SK-MH/A320-PCBs/README.md

# A320-PCBs

> [!IMPORTANT]
> This repository is still in progress.

Please wait for the documentation.
It could be found later on here.
