SK-MH/A320-PCBs/1 - OVERHEAD/readme.MD

## The overhead is separated into the following boards

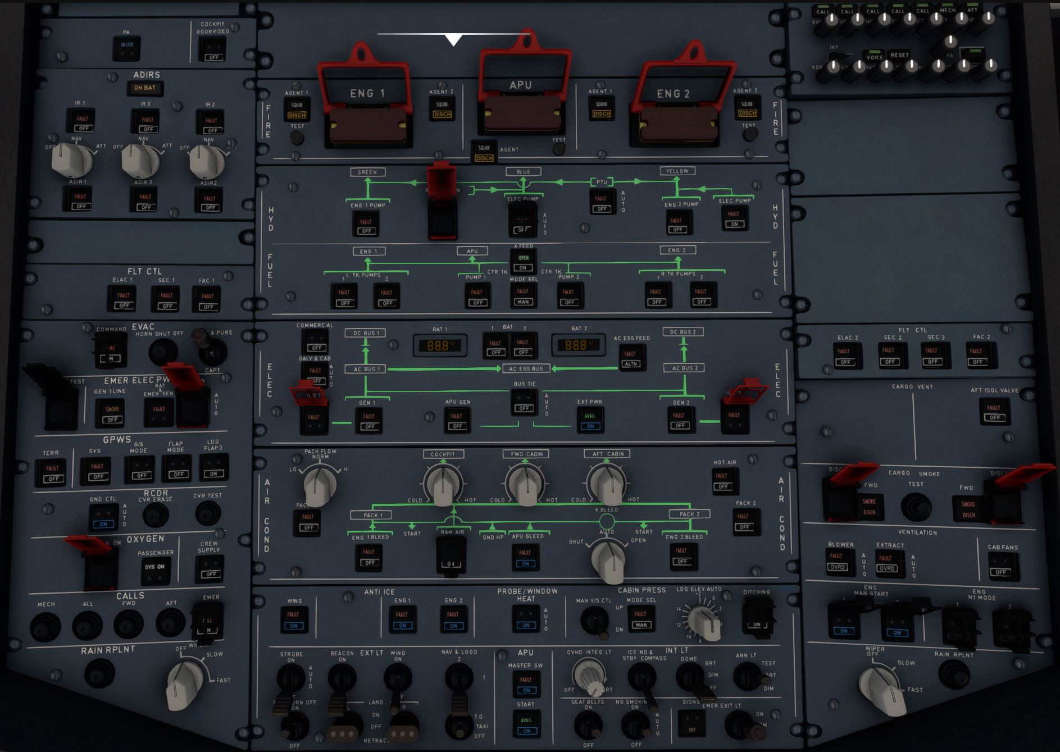
[picture p11: 1 - OVERHEAD/Lighting Overhead.JPG]
Overhead

- PA & COCKPIT DOOR VIDEO
- ADIRS
- FLTCTL Capt.
- EMER ELEC
    - EVAC
    - EMERGENCY ELECTRIC
    - VOICE RECORDER
    - CALLS
    - WIPER CAPT.
- FIRE
- HYD / FUEL
- ELEC
- AIR COND
- LIGHTS
    - ANTI ICE CNTRL
    - CABIN PRESSURE CTRL
    - EXTERNALL LIGHTS
    - APU
    - INTERNAL LIGHTING
    - SIGN
- (3rd AUDIO) optional
- FLTCTRL F.O.
- CARGO HEAT
    - CARGO VENTILATION
    - CARGO SMOKE
    - VENTILATION
    - ENGINE MANUAL START
    - WIPER F.O.
