SK-MH/A320-PCBs/9 - MISCELLANEOUS/Photos/readme.MD

> [!NOTE]
> The Overhead photo is not showing the actual boards.

On the upper left corner there will be the board for PA-CDV and not a TCAS.
On the right side, 3rd. from the top there will be a panel without holes.

On the Glareshield photo the FCU is missing
