SK-MH/A320-PCBs/1 - OVERHEAD/1.1 PACDV/MobiFlight/readme.MD

[!IMPORTANT]
This board is supported by the ADIRS board.
