SK-MH/A320-PCBs/1 - OVERHEAD/1.11 FLTCTL_FO/MobiFlight/readme.MD

[!NOTE]
This board is supported by the CARGO HEAT board.
