SK-MH/A320-PCBs/1 - OVERHEAD/1.3 FLTCTL/MobiFlight/readme.MD

[!NOTE]
This board is supported by the EMER ELEC board.
