SK-MH/A320-PCBs/0 - Prerequisites/Photos/Board and Panels.JPG

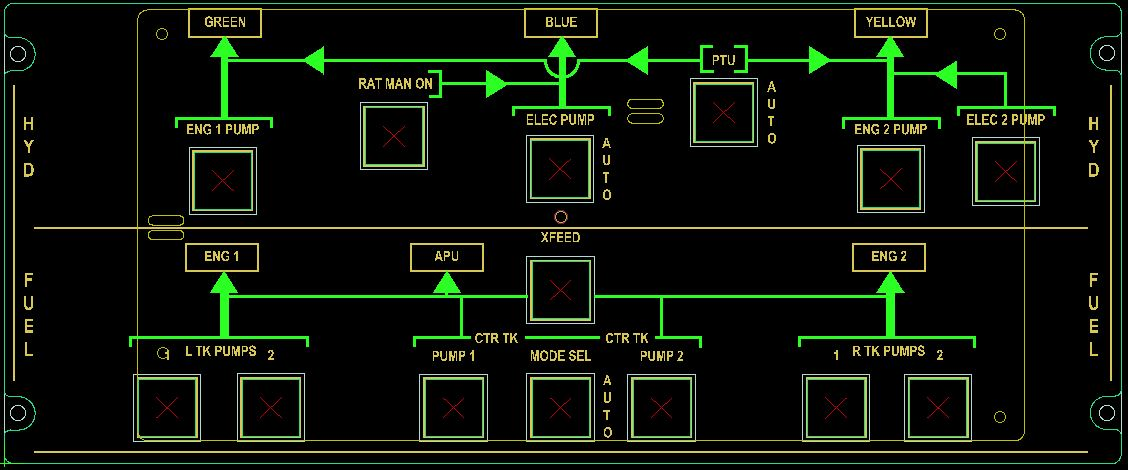
0 - Prerequisites/Photos/Board and Panels.JPG
