SK-MH/A320-PCBs/0 - Prerequisites/Photos/Engravement Green.JPG

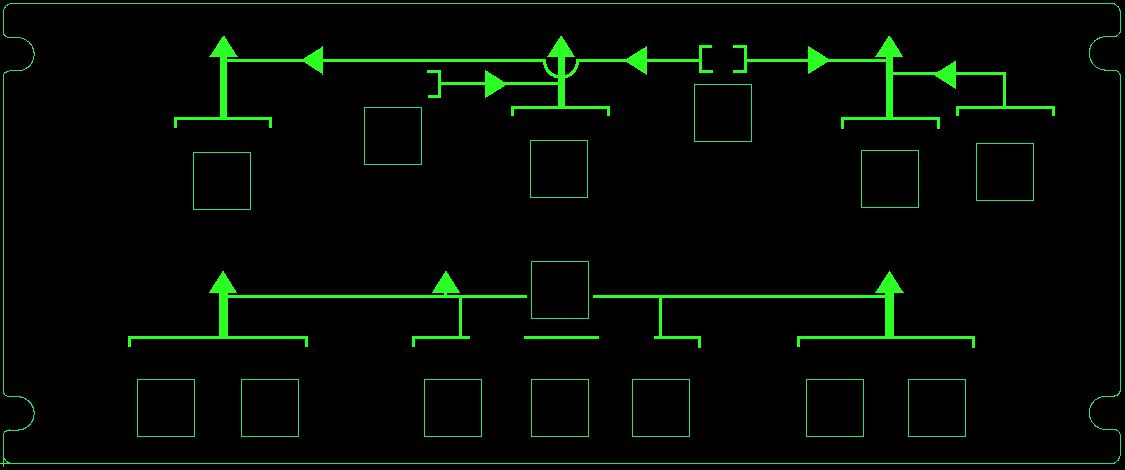
0 - Prerequisites/Photos/Engravement Green.JPG
