SK-MH/A320-PCBs/0 - Prerequisites/Photos/Engravement.JPG

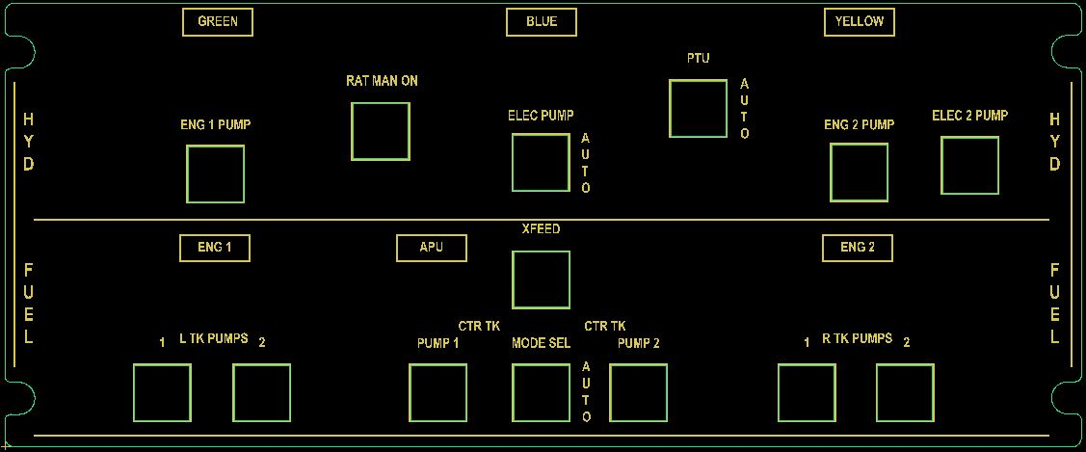
0 - Prerequisites/Photos/Engravement.JPG
