SK-MH/A320-PCBs/0 - Prerequisites/Photos/Front Marker.JPG

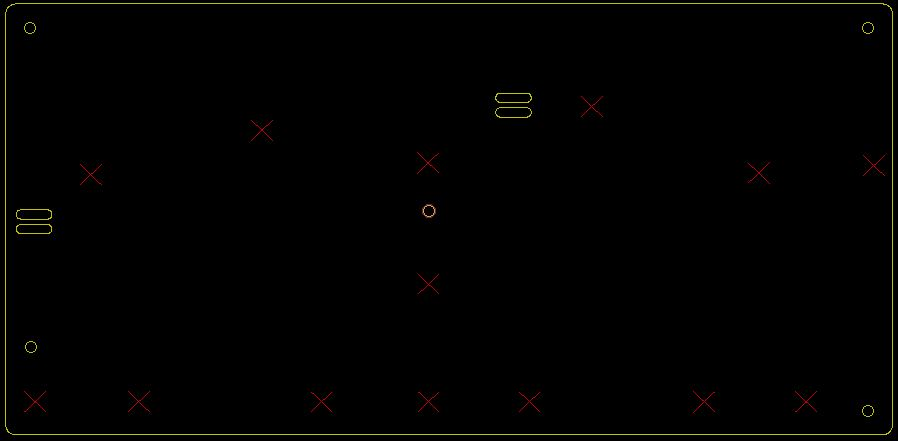
0 - Prerequisites/Photos/Front Marker.JPG
