SK-MH/A320-PCBs/0 - Prerequisites/Photos/Front Panel.JPG

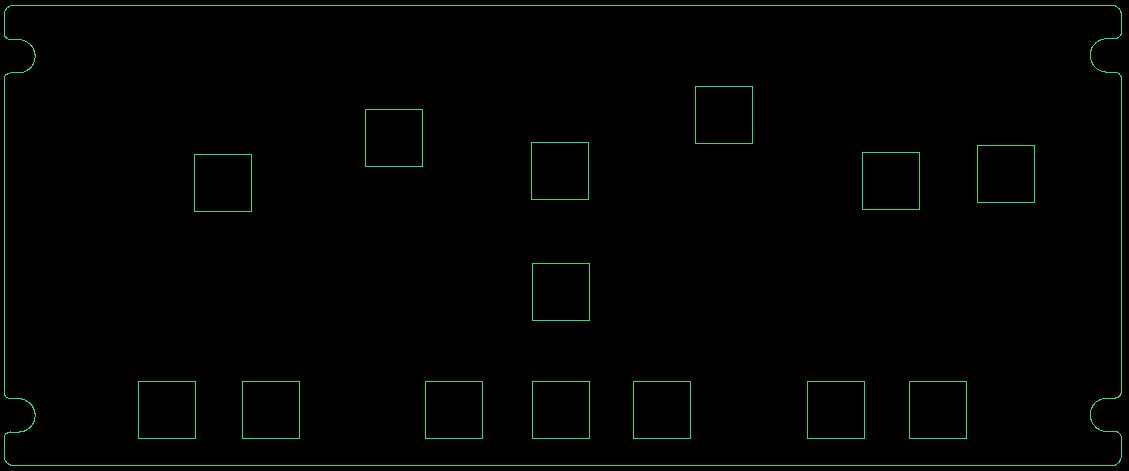
0 - Prerequisites/Photos/Front Panel.JPG
