SK-MH/A320-PCBs/0 - Prerequisites/Photos/Mid Panel.JPG

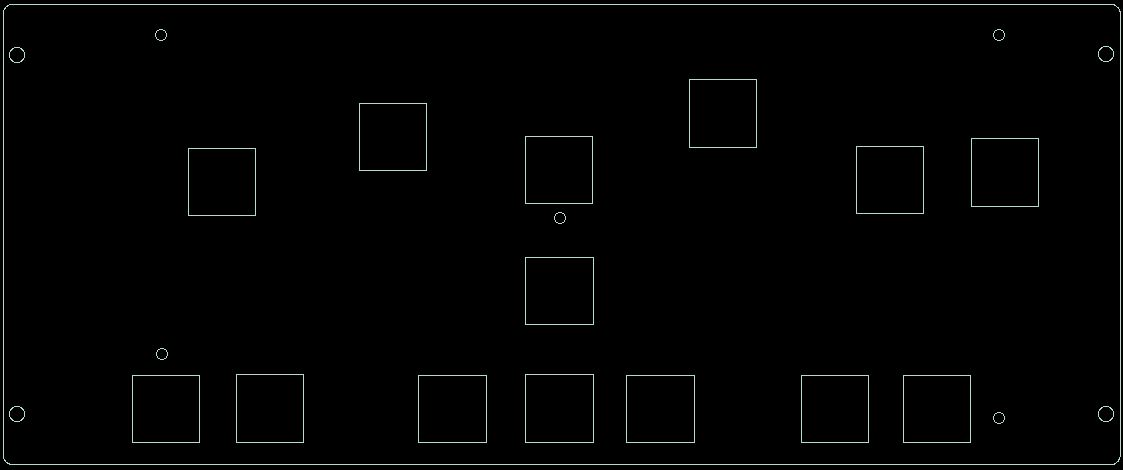
0 - Prerequisites/Photos/Mid Panel.JPG
