SK-MH/A320-PCBs/1 - OVERHEAD/1.2 ADIRS/Photos/Annunciator.JPG

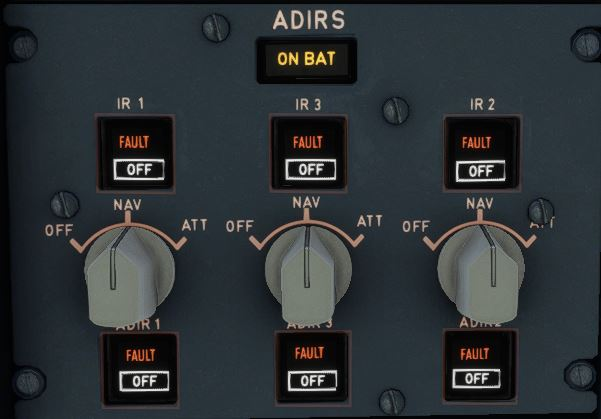
1 - OVERHEAD/1.2 ADIRS/Photos/Annunciator.JPG
