SK-MH/A320-PCBs/1 - OVERHEAD/1.3 FLTCTL/Photos/Annunciator.JPG

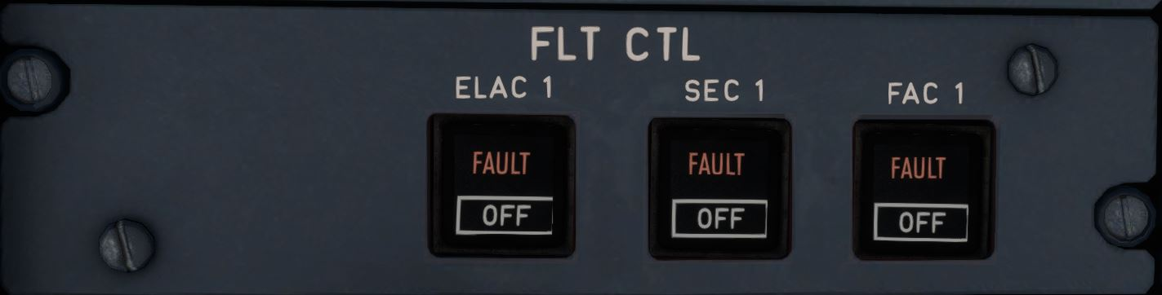
1 - OVERHEAD/1.3 FLTCTL/Photos/Annunciator.JPG
