SK-MH/A320-PCBs/1 - OVERHEAD/1.3 FLTCTL/Photos/Lighted Annunciator.jpg

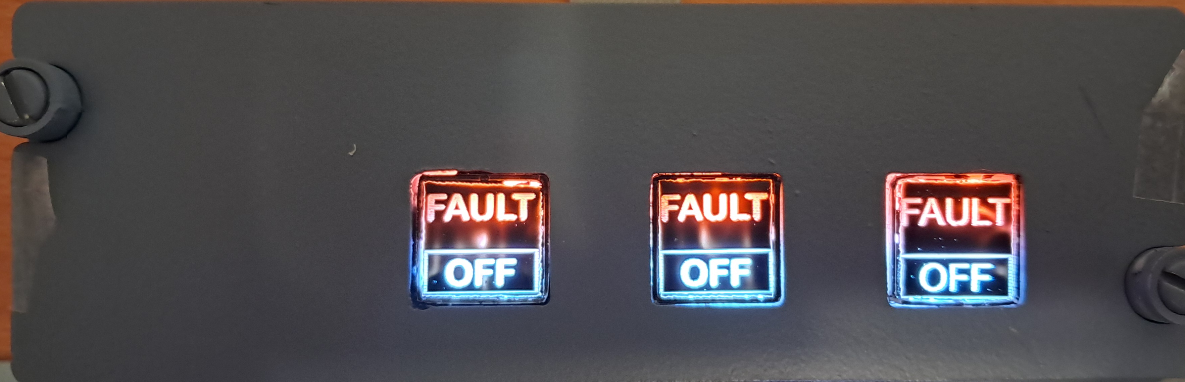
1 - OVERHEAD/1.3 FLTCTL/Photos/Lighted Annunciator.jpg
