SK-MH/A320-PCBs/1 - OVERHEAD/1.3 FLTCTL/Photos/Lights on.jpg

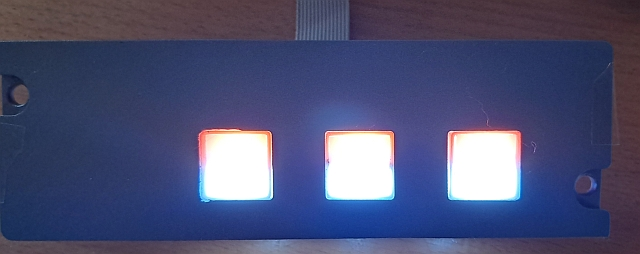
1 - OVERHEAD/1.3 FLTCTL/Photos/Lights on.jpg
