SK-MH/A320-PCBs/1 - OVERHEAD/1.4 EMER ELEC/Photos/Annunciator.JPG

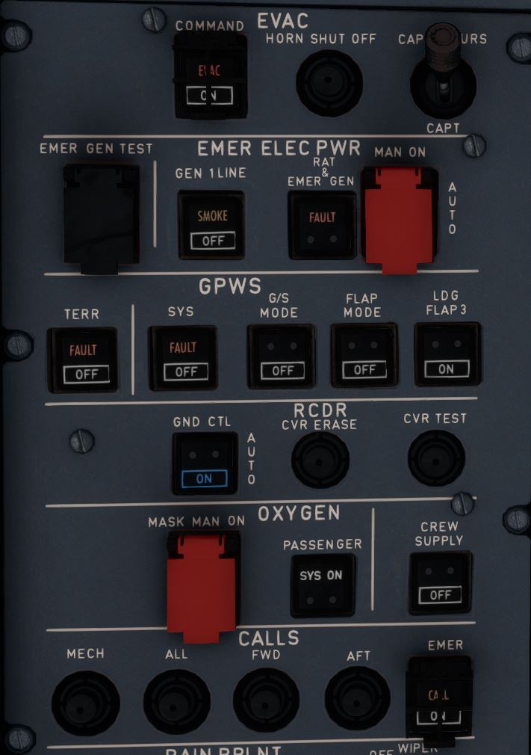
1 - OVERHEAD/1.4 EMER ELEC/Photos/Annunciator.JPG
