SK-MH/A320-PCBs/1 - OVERHEAD/1.5 FIRE/Photos/Annunciator.JPG

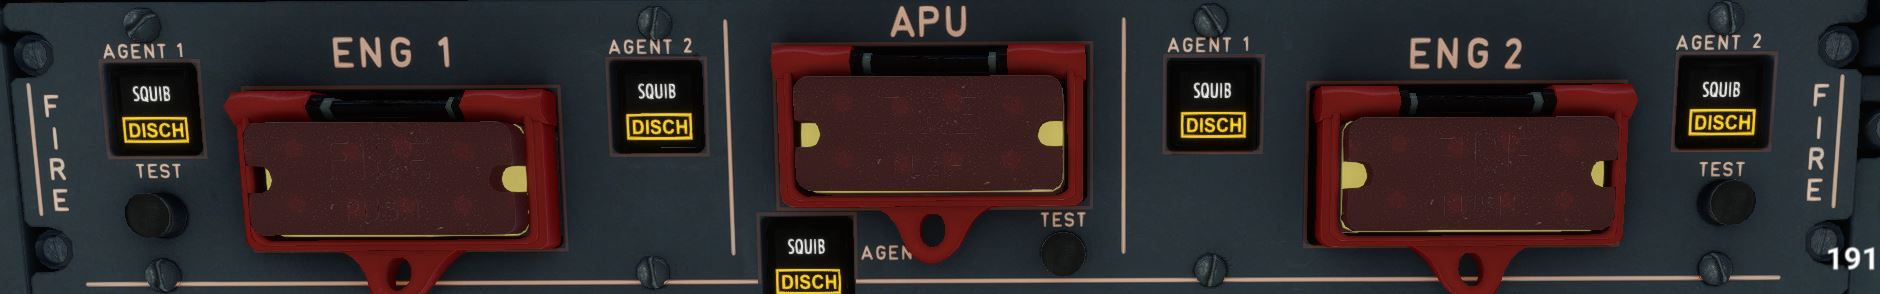
1 - OVERHEAD/1.5 FIRE/Photos/Annunciator.JPG
