SK-MH/A320-PCBs/1 - OVERHEAD/1.6 HYDFUEL/Photos/Annunciator.JPG

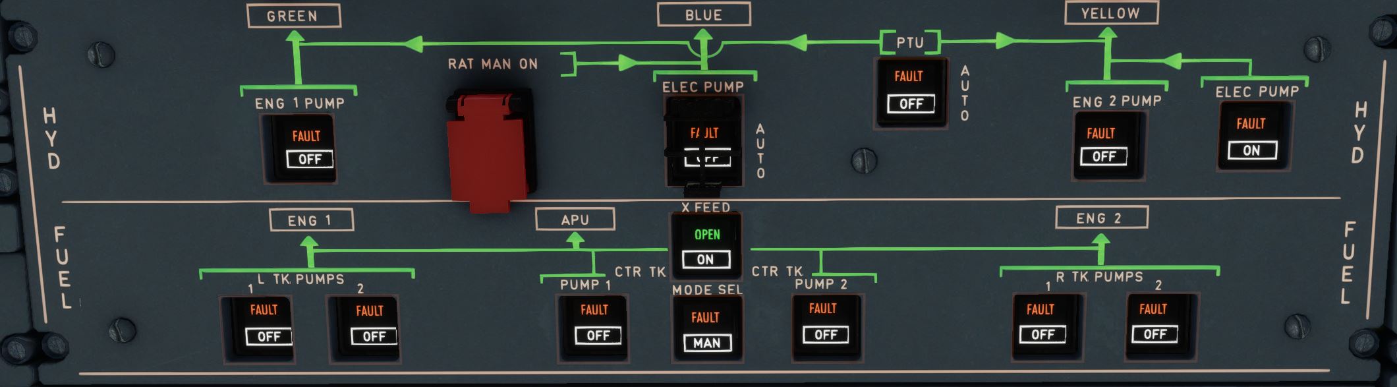
1 - OVERHEAD/1.6 HYDFUEL/Photos/Annunciator.JPG
