SK-MH/A320-PCBs/1 - OVERHEAD/1.7 ELEC/Photos/Annunciator.JPG

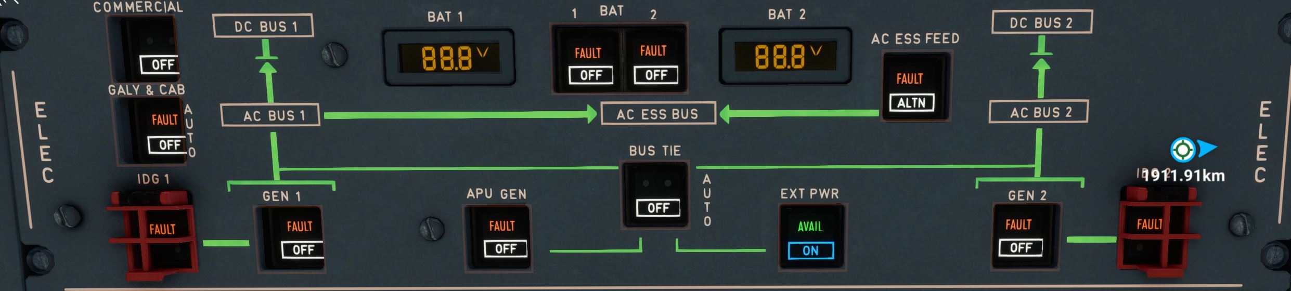
1 - OVERHEAD/1.7 ELEC/Photos/Annunciator.JPG
