SK-MH/A320-PCBs/1 - OVERHEAD/1.8 AIRCOND/Photos/Annunciator.JPG

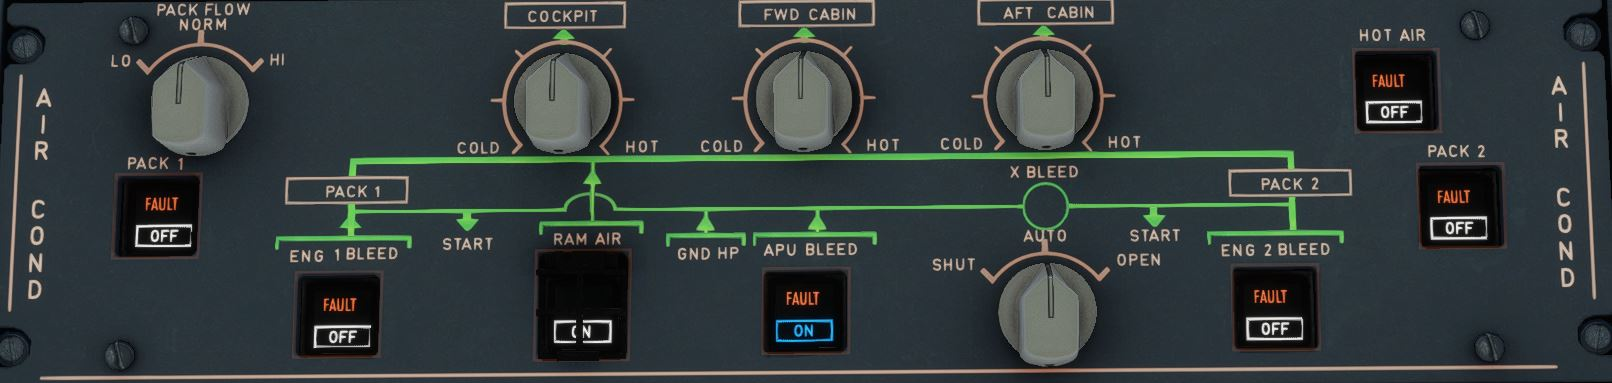
1 - OVERHEAD/1.8 AIRCOND/Photos/Annunciator.JPG
