SK-MH/A320-PCBs/1 - OVERHEAD/1.9 LIGHTS/Photos/Annunciator.JPG

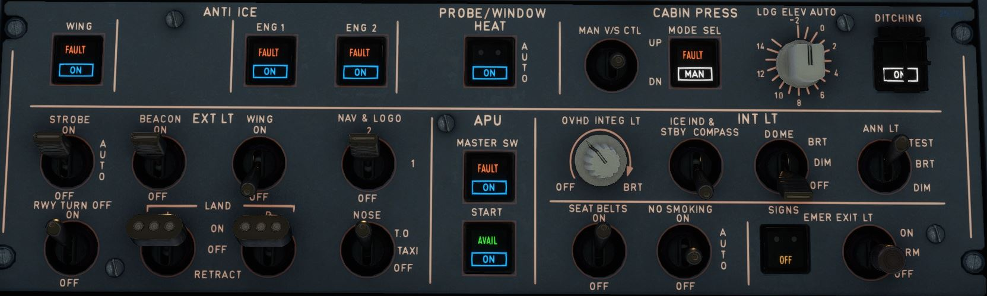
1 - OVERHEAD/1.9 LIGHTS/Photos/Annunciator.JPG
