SK-MH/A320-PCBs/1 - OVERHEAD/1.12 CARGO HEAT/Photos/Annunciator.JPG

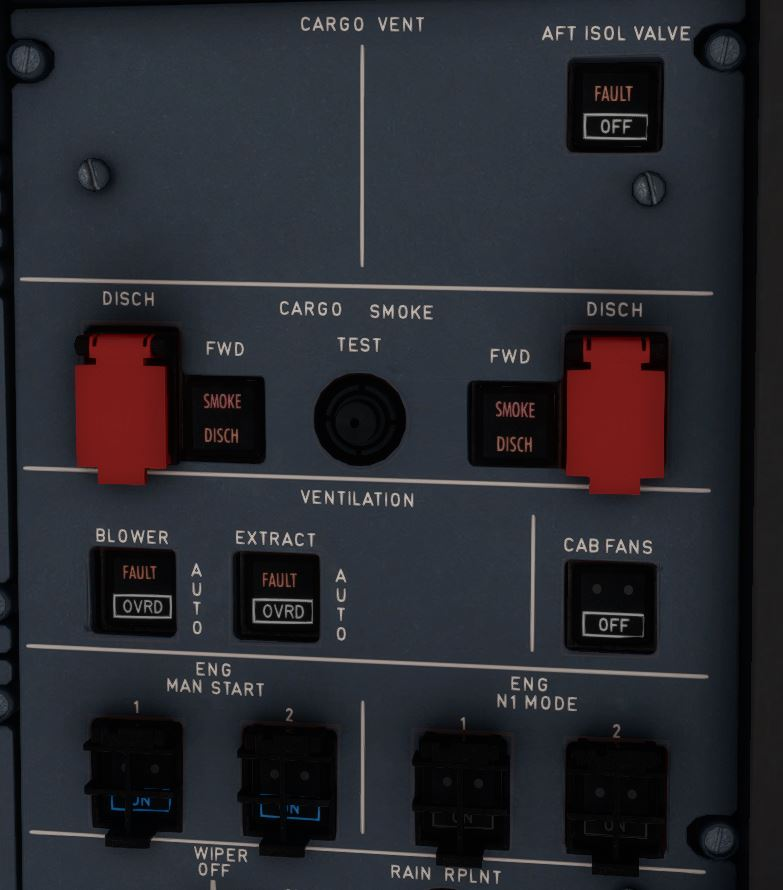
1 - OVERHEAD/1.12 CARGO HEAT/Photos/Annunciator.JPG
