SK-MH/A320-PCBs/2 - GLARE SHIELD/2.1 WARNING Left/Photos/Annunciator.JPG

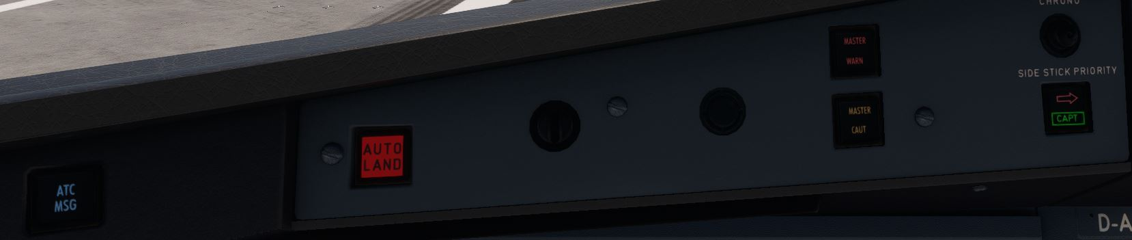
2 - GLARE SHIELD/2.1 WARNING Left/Photos/Annunciator.JPG
