SK-MH/A320-PCBs/3 - MAIN INSTRUMENTS/3.1 ILLU Left/Photos/Annunciators.JPG

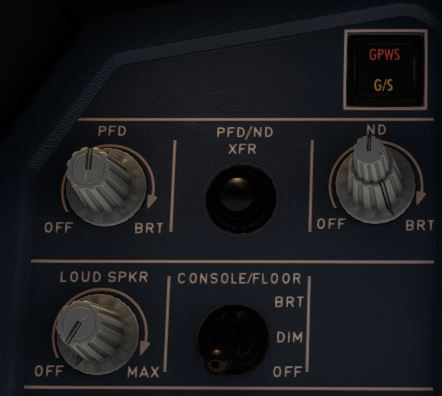
3 - MAIN INSTRUMENTS/3.1 ILLU Left/Photos/Annunciators.JPG
