SK-MH/A320-PCBs/3 - MAIN INSTRUMENTS/3.2 AUTOBRAKE & GEAR/Photos/Annunciators.JPG

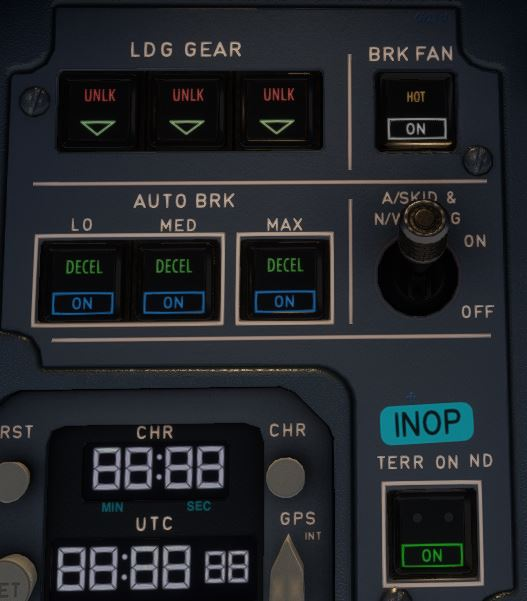
3 - MAIN INSTRUMENTS/3.2 AUTOBRAKE & GEAR/Photos/Annunciators.JPG
