SK-MH/A320-PCBs/3 - MAIN INSTRUMENTS/3.3 CHRONO/Photos/Chrono.jpg

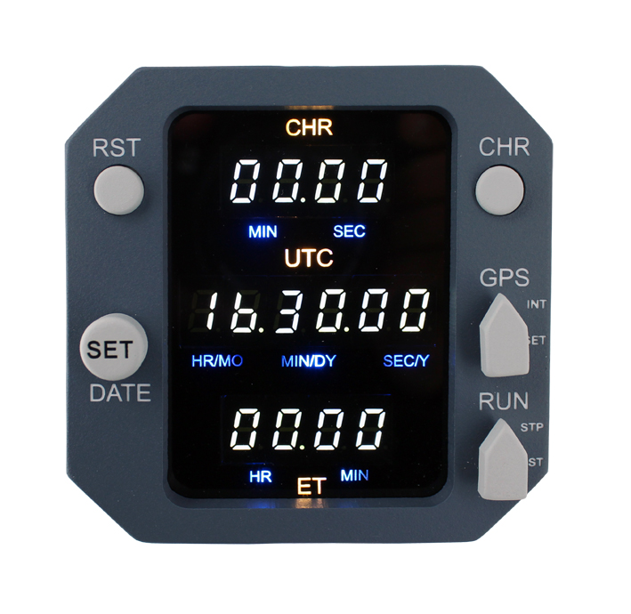
3 - MAIN INSTRUMENTS/3.3 CHRONO/Photos/Chrono.jpg
