SK-MH/A320-PCBs/4 - PEDESTAL/4.2 RMP Left (Capt.)/Photos/A320_radiopanel2.jpg

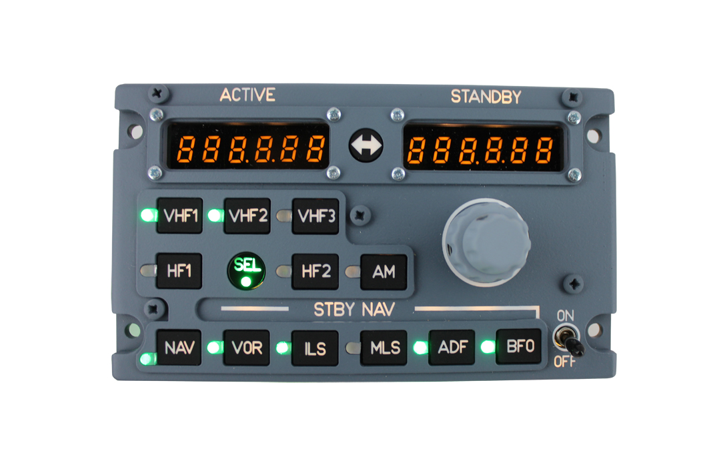
4 - PEDESTAL/4.2 RMP Left (Capt.)/Photos/A320_radiopanel2.jpg
