SK-MH/A320-PCBs/4 - PEDESTAL/4.2 RMP Left (Capt.)/Photos/Annunciator.JPG

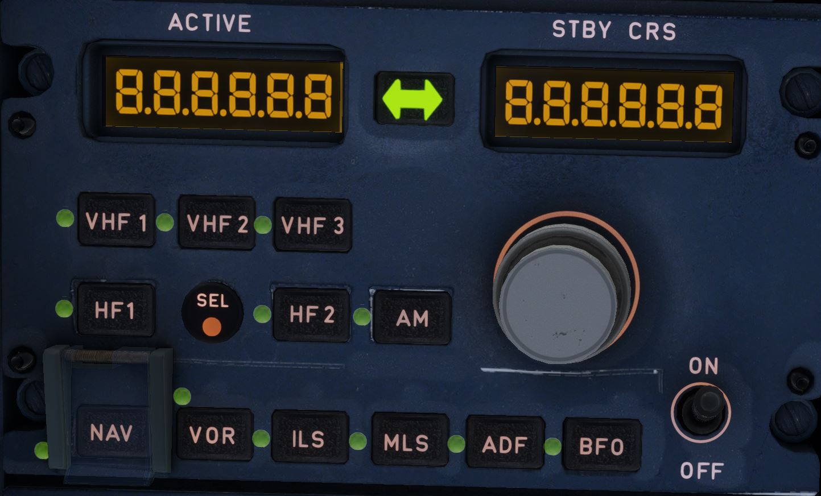
4 - PEDESTAL/4.2 RMP Left (Capt.)/Photos/Annunciator.JPG
