SK-MH/A320-PCBs/4 - PEDESTAL/4.2 RMP Left (Capt.)/Photos/FBW Radio Panel.JPG

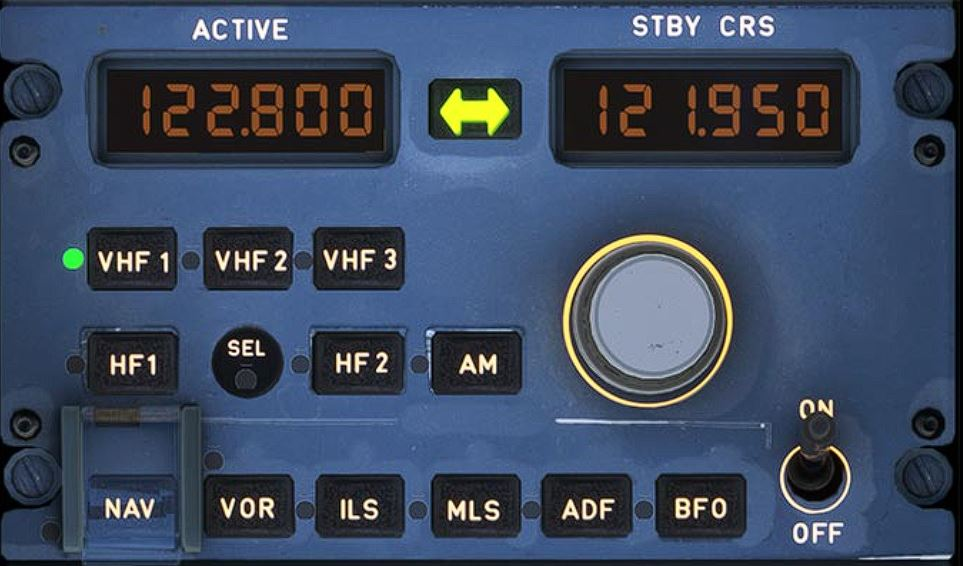
4 - PEDESTAL/4.2 RMP Left (Capt.)/Photos/FBW Radio Panel.JPG
