SK-MH/A320-PCBs/4 - PEDESTAL/4.5 RADAR/Photos/Radar.jpg

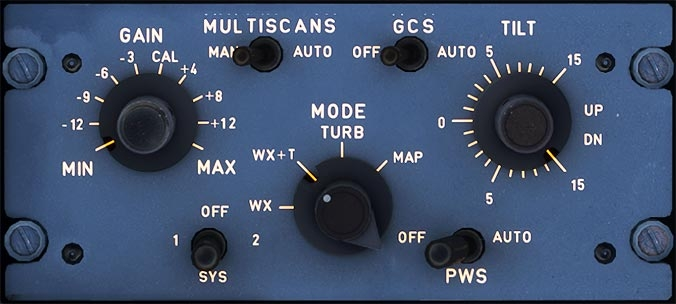
4 - PEDESTAL/4.5 RADAR/Photos/Radar.jpg
