SK-MH/A320-PCBs/9 - MISCELLANEOUS/Photos/Glare shield (without FCU).jpg

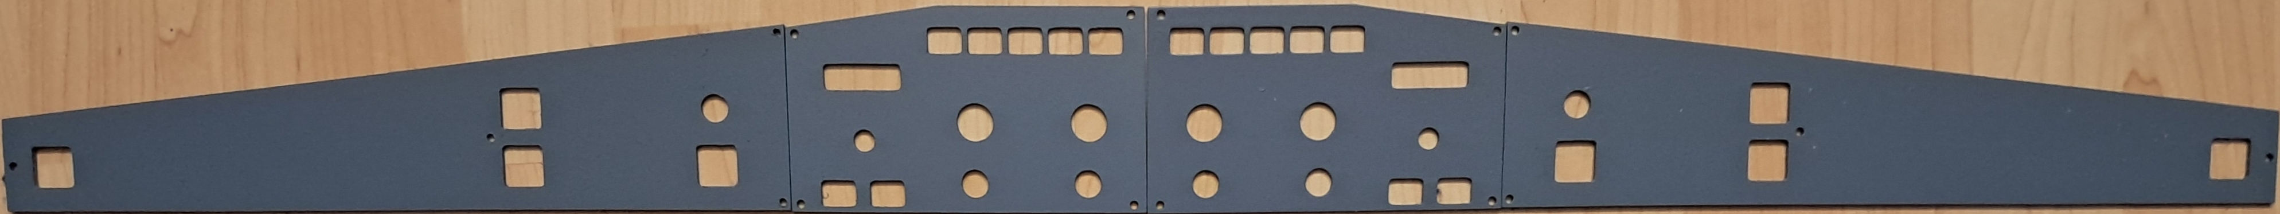
9 - MISCELLANEOUS/Photos/Glare shield (without FCU).jpg
