SK-MH/A320-PCBs/9 - MISCELLANEOUS/Photos/Overhead.jpg

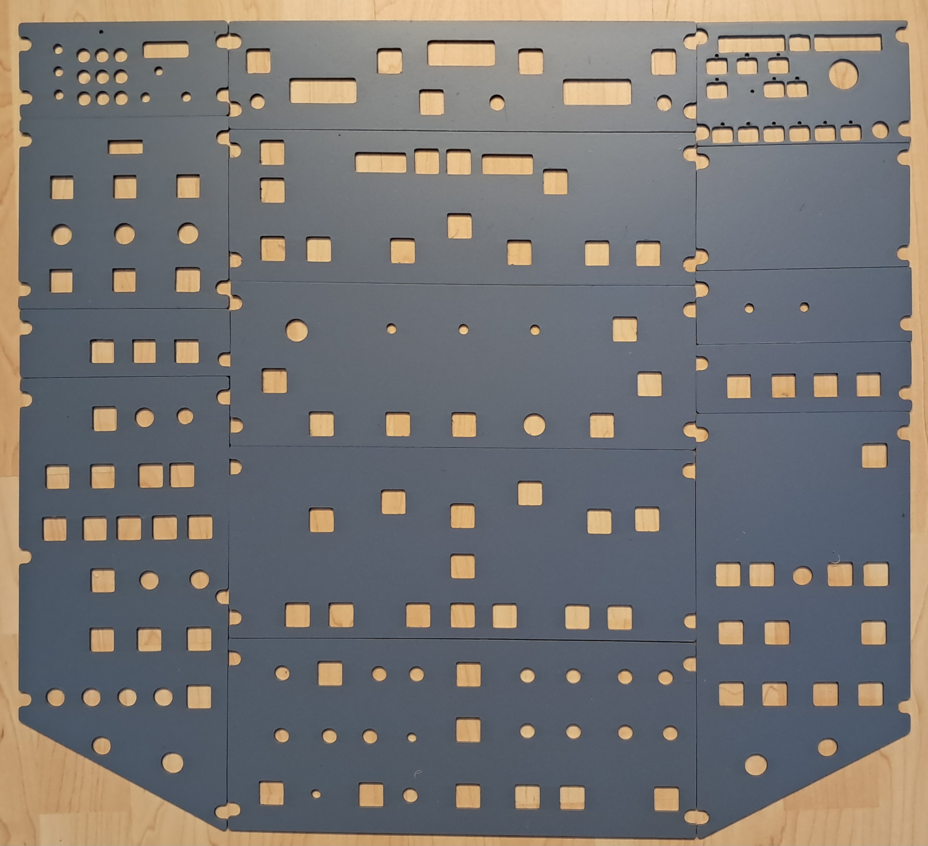
9 - MISCELLANEOUS/Photos/Overhead.jpg
