SK-MH/A320-PCBs/9 - MISCELLANEOUS/3D Print/TCAS Button Cap.stl

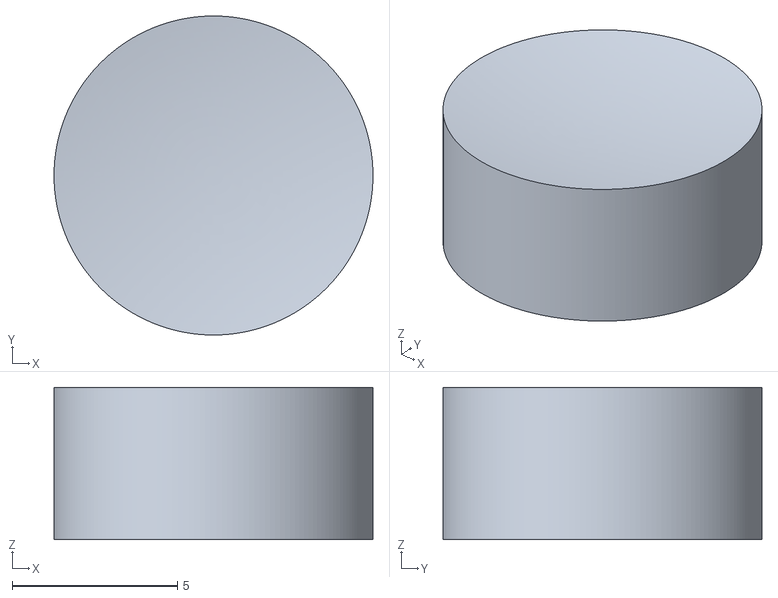
[picture p42: CAD file, 2025-01-06]
9 - MISCELLANEOUS/3D Print/TCAS Button Cap.stl
9.65 x 9.65 x 4.60
