SK-MH/A320-PCBs/9 - MISCELLANEOUS/3D Print/Korry groß.stl

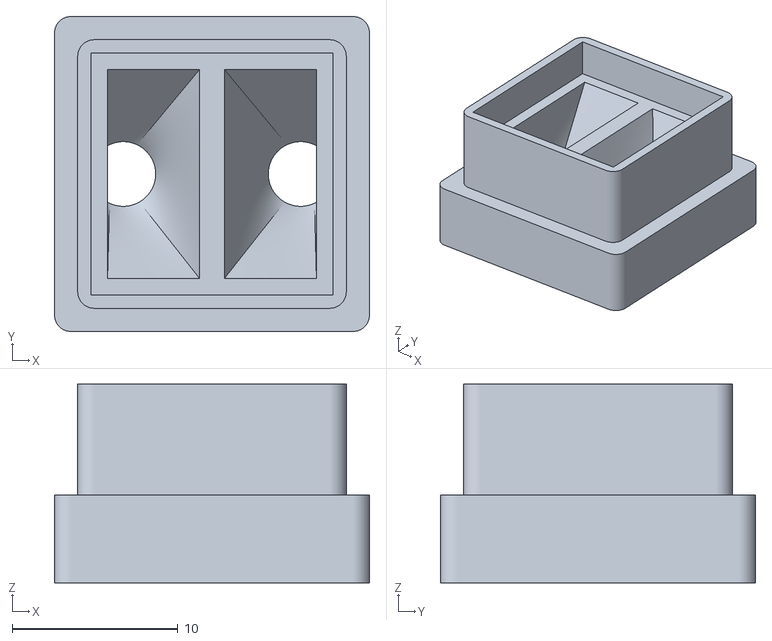
[picture p43: CAD file, 2025-01-06]
9 - MISCELLANEOUS/3D Print/Korry groß.stl
19.0 x 19.0 x 12.0
