SK-MH/A320-PCBs/3 - MAIN INSTRUMENTS/3.4 ILLU Right/KiCAD/ILLU FO.kicad_pcb

## KiCad design 3 - MAIN INSTRUMENTS/3.4 ILLU Right/KiCAD/ILLU FO.kicad_pcb (2025-01-06)

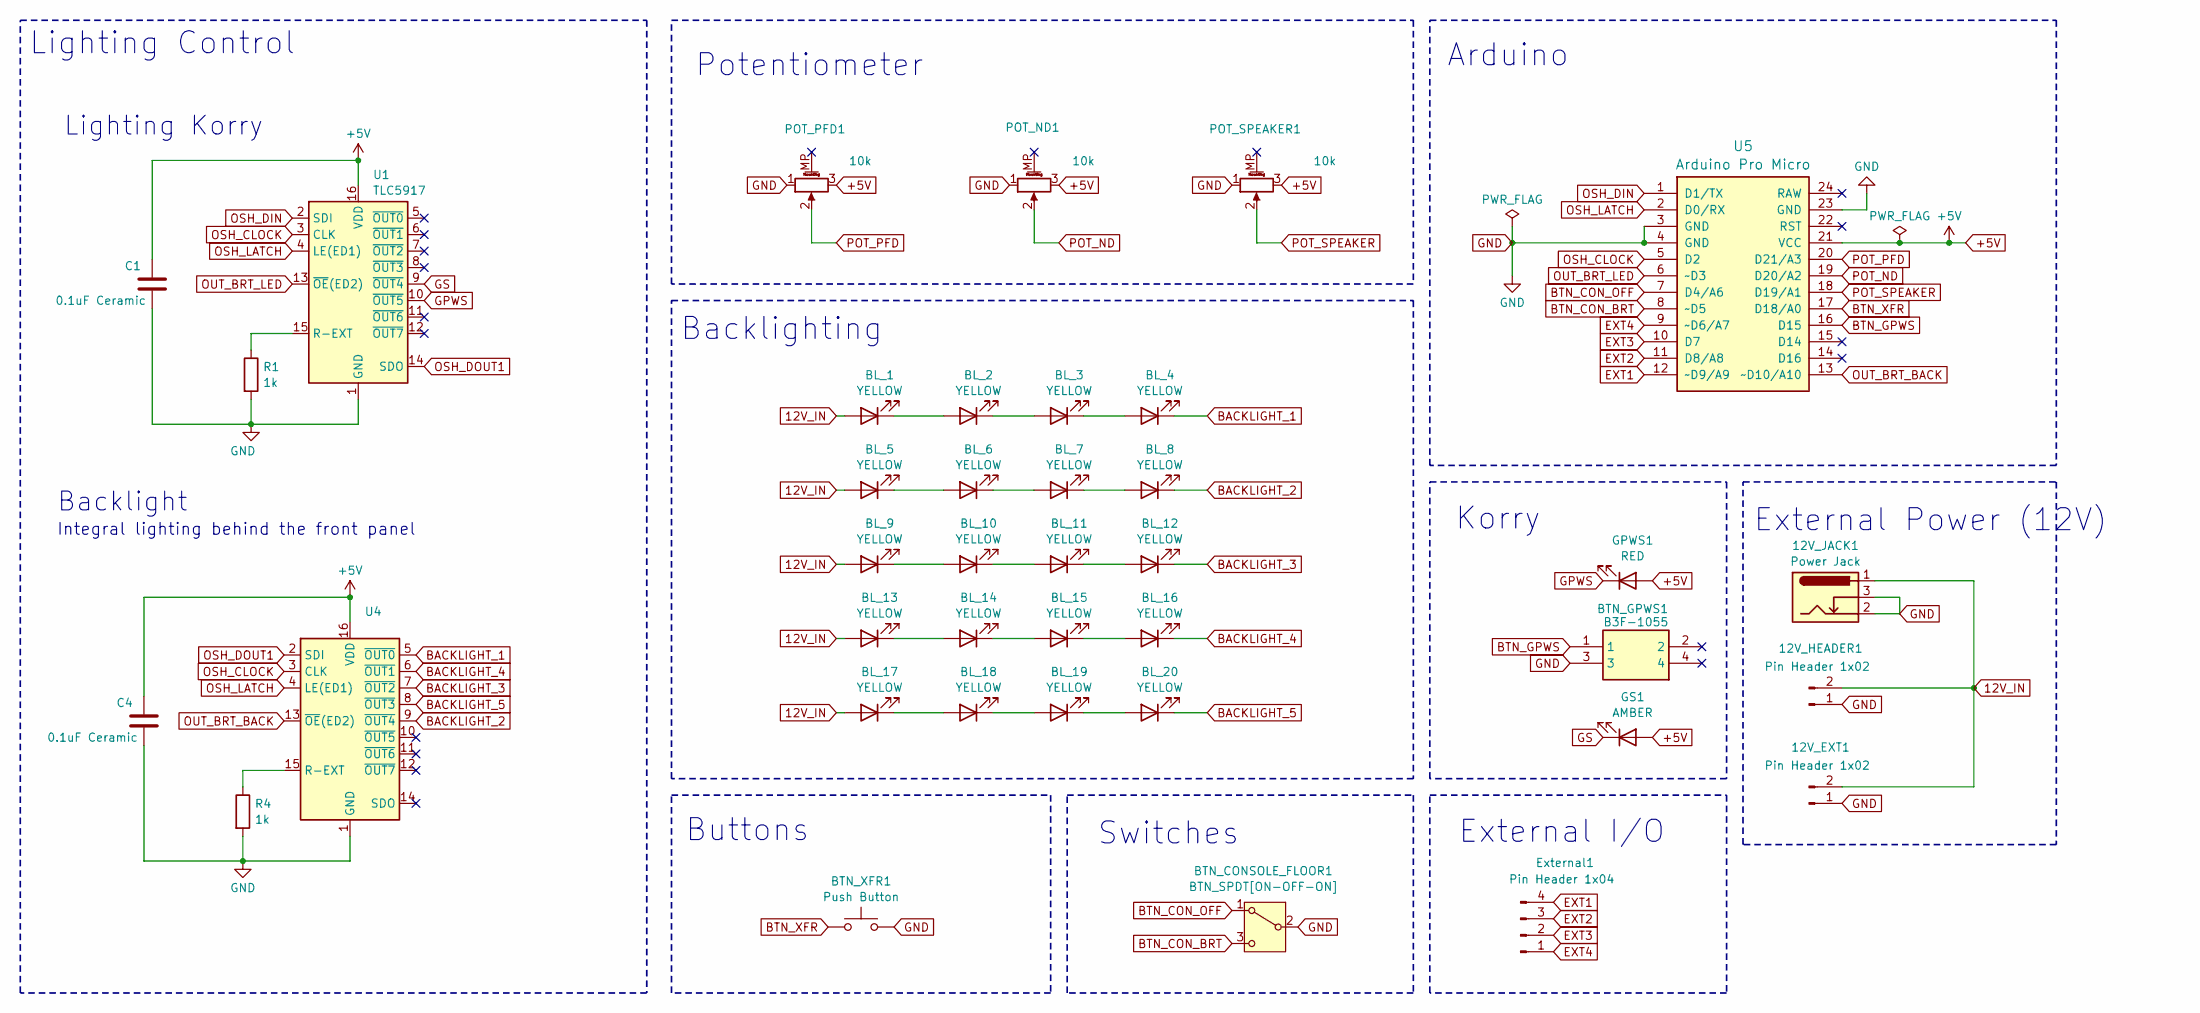
[picture p44: schematic ILLU FO.kicad_sch]

Parts:
12V_EXT1, 12V_HEADER1: Pin Header 1x02; JST_EH_B2B-EH-A_1x02_P2.50mm_Vertical
12V_JACK1: Power Jack; BarrelJack_Horizontal
BL_1, BL_2, BL_3, BL_4, BL_5, BL_6, BL_7, BL_8, BL_9, BL_10, BL_11, BL_12, BL_13, BL_14, BL_15, BL_16, BL_17, BL_18, BL_19, BL_20: YELLOW; LED_D3.0mm
BTN_CONSOLE_FLOOR1: BTN_SPDT[ON-OFF-ON]; T80-Z1
BTN_GPWS1: B3F-1055; B3F1000; Mouser Part Number 653-B3F-1055
BTN_XFR1: Push Button; SW-Push
C1, C4: 0.1uF Ceramic; C_Disc_D3.0mm_W1.6mm_P2.50mm
External1: Pin Header 1x04; JST_EH_B4B-EH-A_1x04_P2.50mm_Vertical
GPWS1: RED; LED_D3.0mm
GS1: AMBER; LED_D3.0mm
POT_ND1: 10k; Potentiometer_Alps_RK09K_Single_Vertical
POT_PFD1: 10k; Potentiometer_Alps_RK09K_Single_Vertical
POT_SPEAKER1: 10k; Potentiometer_Alps_RK09K_Single_Vertical
R1, R4: 1k; R_Axial_DIN0204_L3.6mm_D1.6mm_P7.62mm_Horizontal
U1, U4: TLC5917; DIP-16_W7.62mm
U5: Arduino Pro Micro; Sparkfun_Pro_Micro

Connections:
12V_IN: 12V_EXT1.2, 12V_HEADER1.2, 12V_JACK1.1, BL_1.2 (A), BL_5.2 (A), BL_9.2 (A), BL_13.2 (A), BL_17.2 (A)
+5V: C1.1, C4.1, GPWS1.2 (A), GS1.2 (A), POT_ND1.3, POT_PFD1.3, POT_SPEAKER1.3, U1.16 (VDD), U4.16 (VDD), U5.21 (VCC)
BACKLIGHT_1: BL_4.1 (K), U4.5 (~OUT0)
BACKLIGHT_2: BL_8.1 (K), U4.9 (~OUT4)
BACKLIGHT_3: BL_12.1 (K), U4.7 (~OUT2)
BACKLIGHT_4: BL_16.1 (K), U4.6 (~OUT1)
BACKLIGHT_5: BL_20.1 (K), U4.8 (~OUT3)
BTN_CON_BRT: BTN_CONSOLE_FLOOR1.3 (C), U5.8 (~D5)
BTN_CON_OFF: BTN_CONSOLE_FLOOR1.1 (A), U5.7 (D4/A6)
BTN_GPWS: BTN_GPWS1.1, U5.16 (D15)
BTN_XFR: BTN_XFR1.1, U5.17 (D18/A0)
EXT1: External1.4, U5.12 (~D9/A9)
EXT2: External1.3, U5.11 (D8/A8)
EXT3: External1.2, U5.10 (D7)
EXT4: External1.1, U5.9 (~D6/A7)
GND: 12V_EXT1.1, 12V_HEADER1.1, 12V_JACK1.2, 12V_JACK1.3, BTN_CONSOLE_FLOOR1.2 (B), BTN_GPWS1.3, BTN_XFR1.2, C1.2, C4.2, POT_ND1.1, POT_PFD1.1, POT_SPEAKER1.1, R1.2, R4.2, U1.1 (GND), U4.1 (GND), U5.3 (GND), U5.4 (GND), U5.23 (GND)
GPWS: GPWS1.1 (K), U1.10 (~OUT5)
GS: GS1.1 (K), U1.9 (~OUT4)
unnamed: BL_1.1 (K), BL_2.2 (A)
unnamed: BL_2.1 (K), BL_3.2 (A)
unnamed: BL_3.1 (K), BL_4.2 (A)
unnamed: BL_5.1 (K), BL_6.2 (A)
unnamed: BL_6.1 (K), BL_7.2 (A)
unnamed: BL_7.1 (K), BL_8.2 (A)
unnamed: BL_9.1 (K), BL_10.2 (A)
unnamed: BL_10.1 (K), BL_11.2 (A)
unnamed: BL_11.1 (K), BL_12.2 (A)
unnamed: BL_13.1 (K), BL_14.2 (A)
unnamed: BL_14.1 (K), BL_15.2 (A)
unnamed: BL_15.1 (K), BL_16.2 (A)
unnamed: BL_17.1 (K), BL_18.2 (A)
unnamed: BL_18.1 (K), BL_19.2 (A)
unnamed: BL_19.1 (K), BL_20.2 (A)
unnamed: R1.1, U1.15 (R-EXT)
unnamed: R4.1, U4.15 (R-EXT)
OSH_CLOCK: U1.3 (CLK), U4.3 (CLK), U5.5 (D2)
OSH_DIN: U1.2 (SDI), U5.1 (D1/TX)
OSH_DOUT1: U1.14 (SDO), U4.2 (SDI)
OSH_LATCH: U1.4 (LE(ED1)), U4.4 (LE(ED1)), U5.2 (D0/RX)
OUT_BRT_BACK: U4.13 (~OE(ED2)), U5.13 (~D10/A10)
OUT_BRT_LED: U1.13 (~OE(ED2)), U5.6 (~D3)
POT_ND: POT_ND1.2, U5.19 (D20/A2)
POT_PFD: POT_PFD1.2, U5.20 (D21/A3)
POT_SPEAKER: POT_SPEAKER1.2, U5.18 (D19/A1)

Notes on the sheet:
Backlighting
Arduino
Switches
External I/O
Korry
Buttons
External Power (12V)
Lighting Korry
Lighting Control
Integral lighting behind the front panel
Potentiometer
Backlight

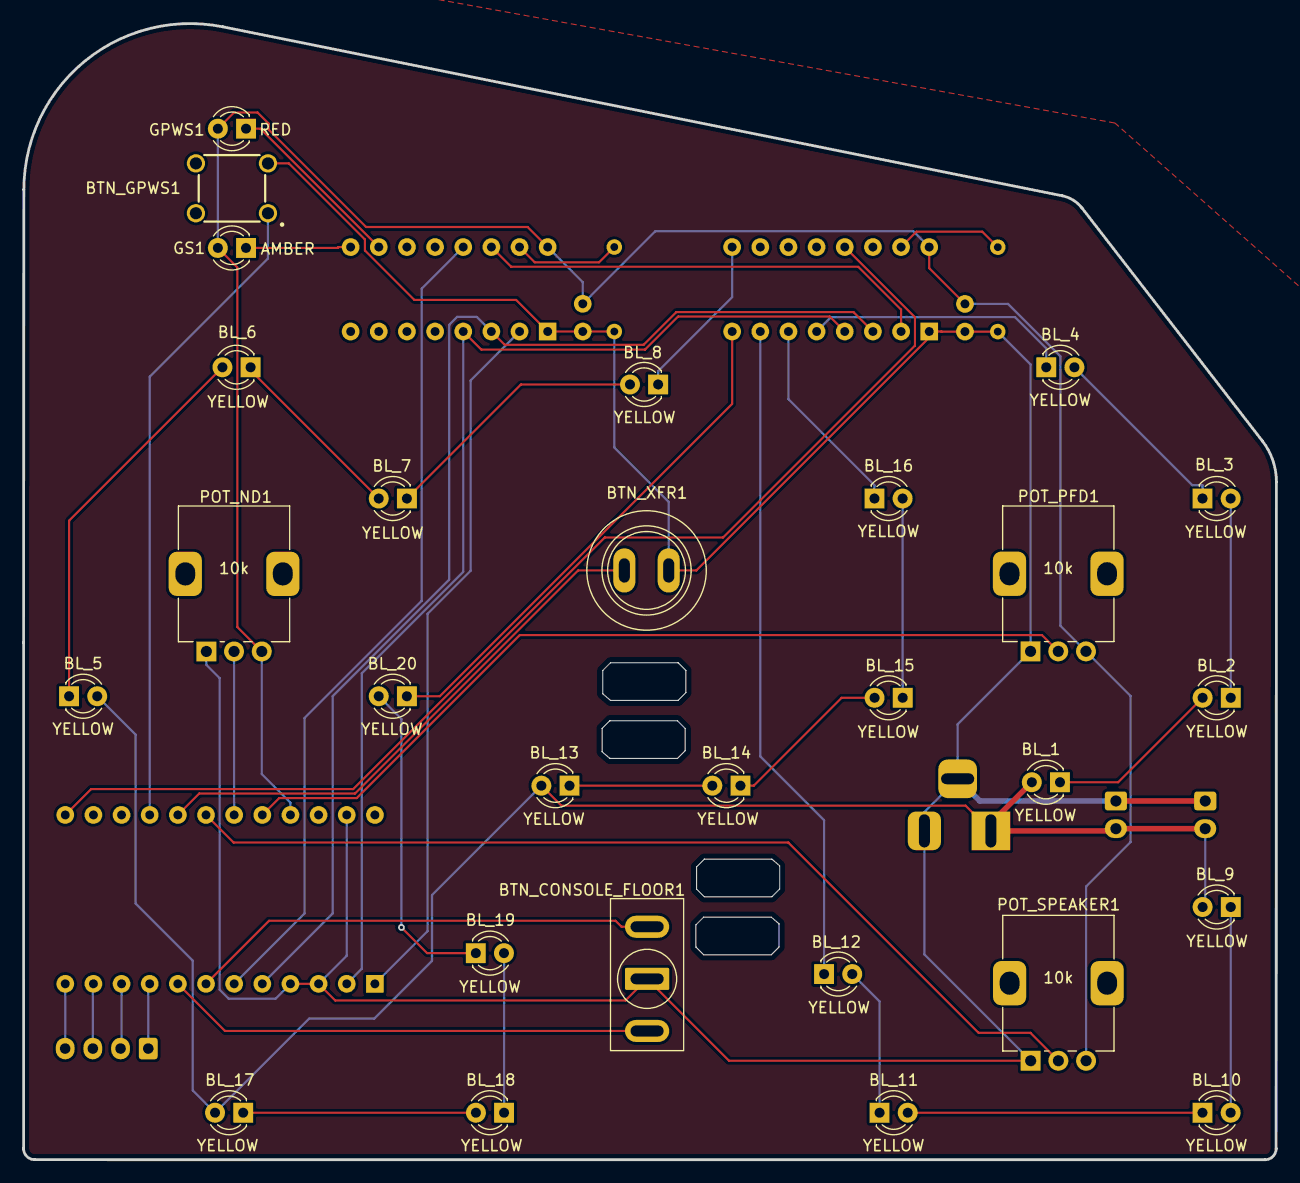
[picture p45: board ILLU FO.kicad_pcb from above]

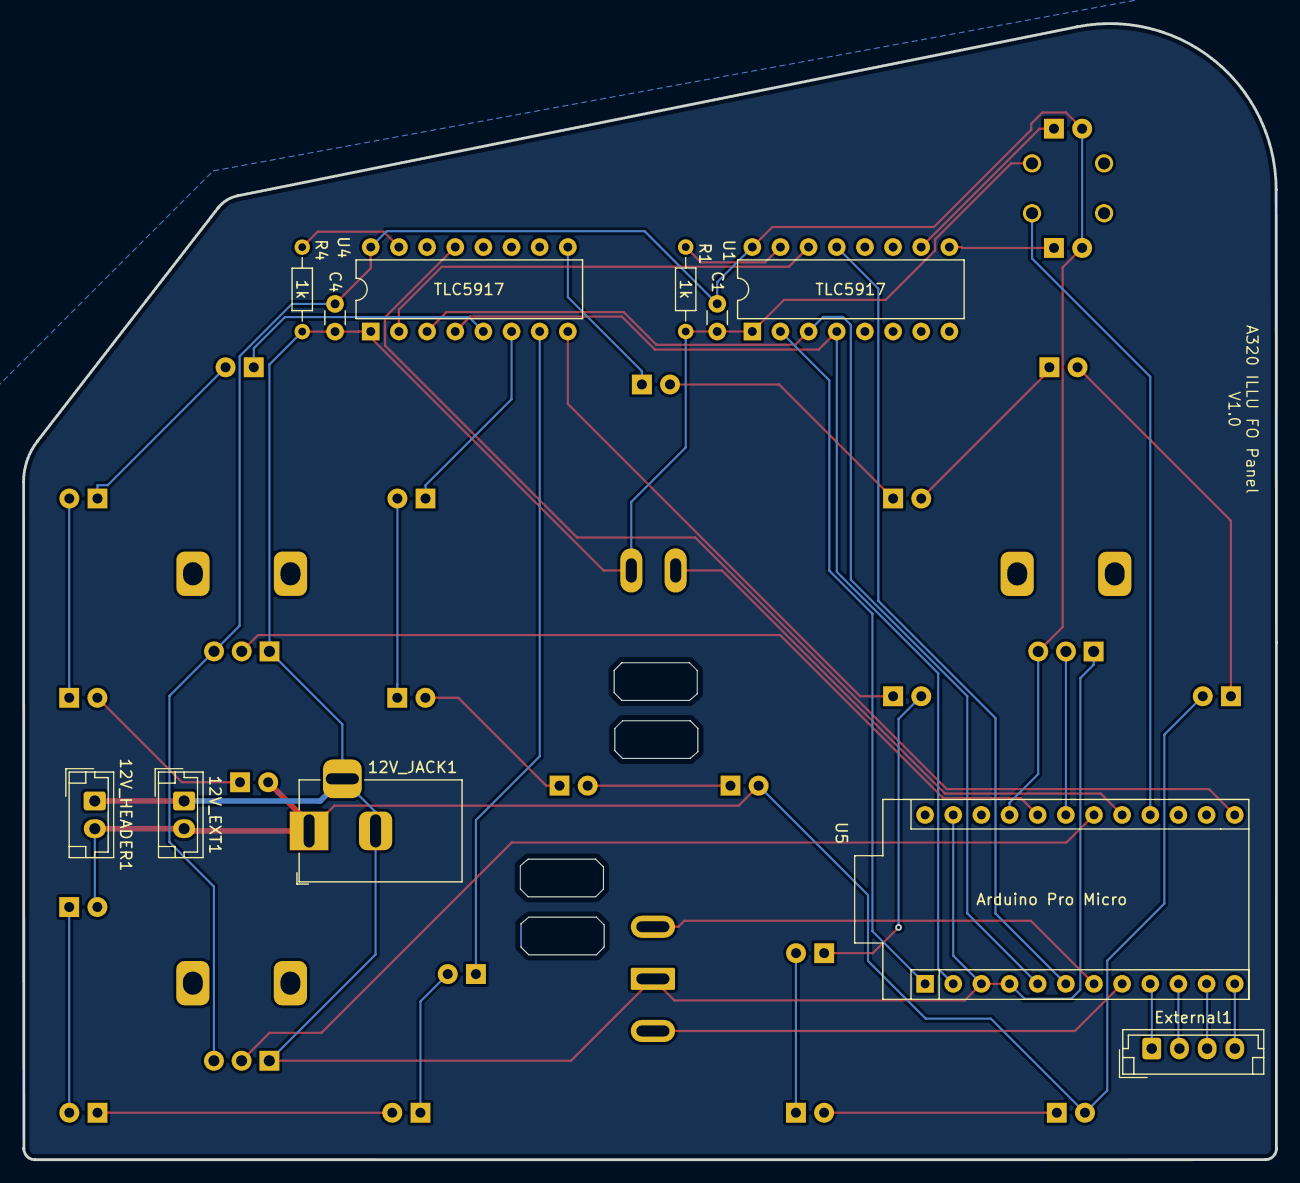
[picture p46: board ILLU FO.kicad_pcb from below]

Board: 2 copper layers, 113.0 x 102.5 mm, 39 parts (11 on the bottom side), 44 nets.
