SK-MH/A320-PCBs/3 - MAIN INSTRUMENTS/3.2 AUTOBRAKE & GEAR/KiCAD/AUTOBRAKE.kicad_pcb

## KiCad design 3 - MAIN INSTRUMENTS/3.2 AUTOBRAKE & GEAR/KiCAD/AUTOBRAKE.kicad_pcb (2025-01-06)

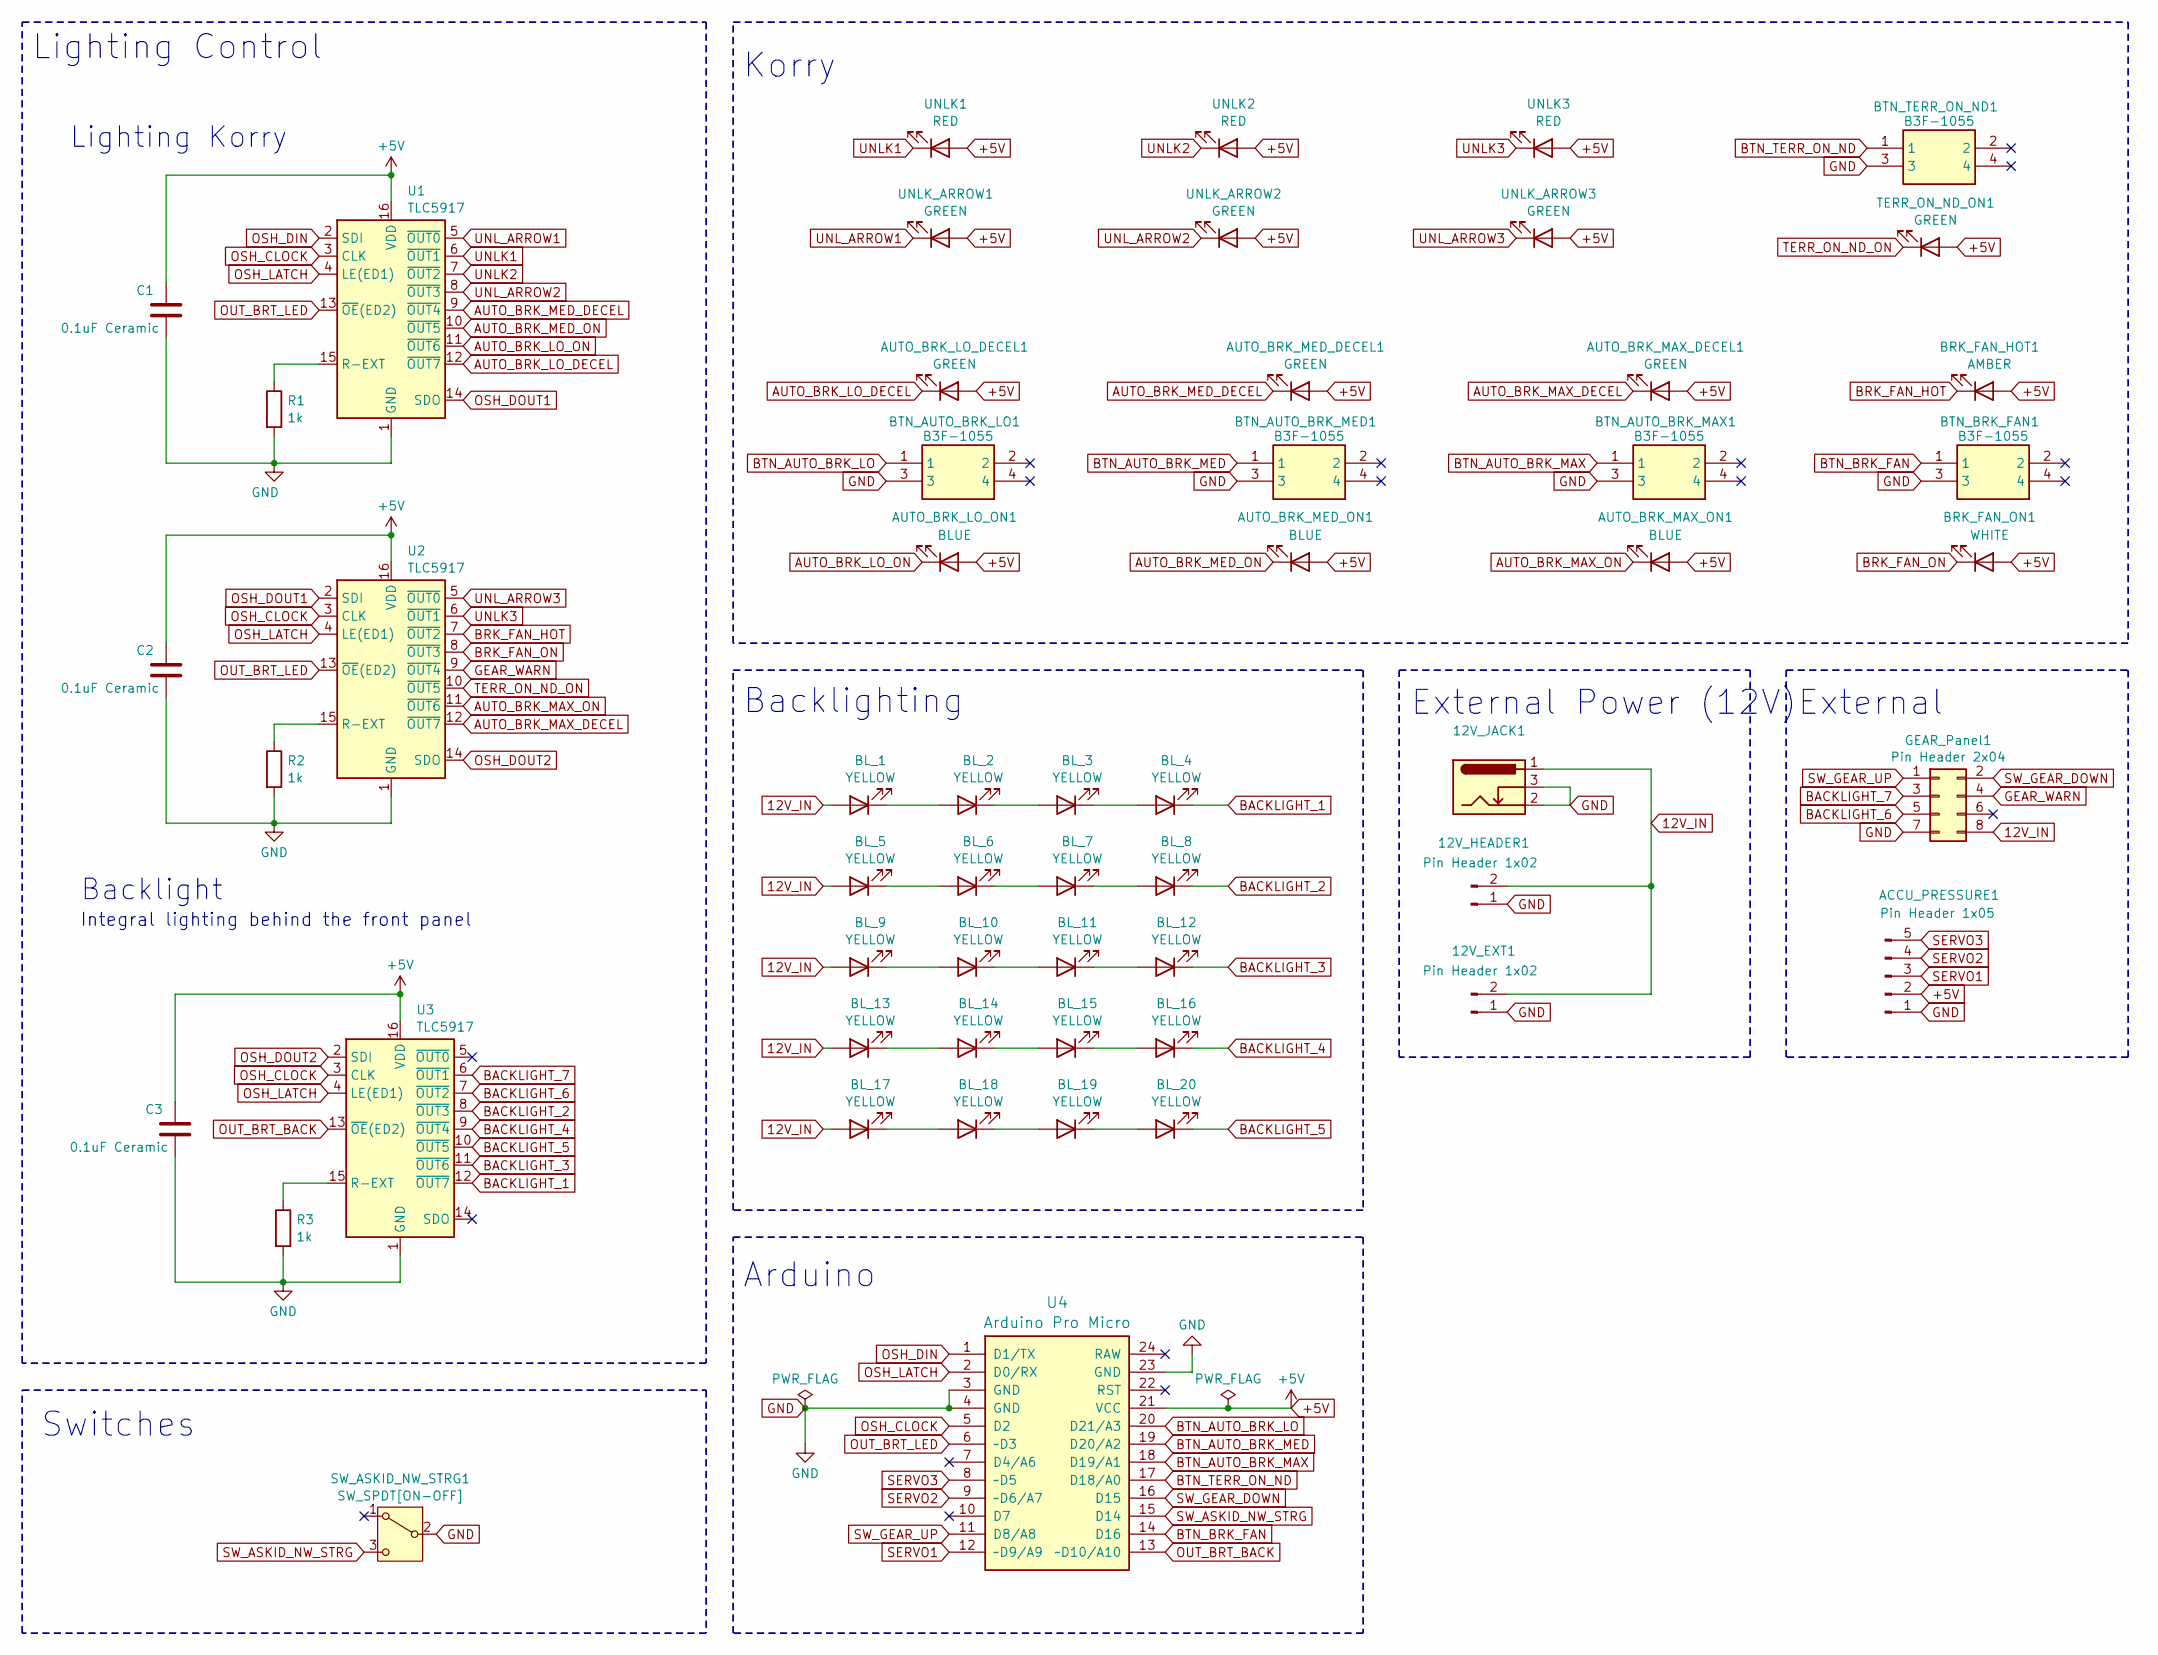
[picture p47: schematic AUTOBRAKE.kicad_sch, AUTOBRAKE Panel]

Parts:
12V_EXT1, 12V_HEADER1: Pin Header 1x02; JST_EH_B2B-EH-A_1x02_P2.50mm_Vertical
12V_JACK1: Power Jack; BarrelJack_Horizontal
ACCU_PRESSURE1: Pin Header 1x05; JST_EH_B5B-EH-A_1x05_P2.50mm_Vertical
AUTO_BRK_LO_DECEL1: GREEN; LED_D3.0mm
AUTO_BRK_LO_ON1: BLUE; LED_D3.0mm
AUTO_BRK_MAX_DECEL1: GREEN; LED_D3.0mm
AUTO_BRK_MAX_ON1: BLUE; LED_D3.0mm
AUTO_BRK_MED_DECEL1: GREEN; LED_D3.0mm
AUTO_BRK_MED_ON1: BLUE; LED_D3.0mm
BL_1, BL_2, BL_3, BL_4, BL_5, BL_6, BL_7, BL_8, BL_9, BL_10, BL_11, BL_12, BL_13, BL_14, BL_15, BL_16, BL_17, BL_18, BL_19, BL_20: YELLOW; LED_D3.0mm
BRK_FAN_HOT1: AMBER; LED_D3.0mm
BRK_FAN_ON1: WHITE; LED_D3.0mm
BTN_AUTO_BRK_LO1: B3F-1055; B3F1000; Mouser Part Number 653-B3F-1055
BTN_AUTO_BRK_MAX1: B3F-1055; B3F1000; Mouser Part Number 653-B3F-1055
BTN_AUTO_BRK_MED1: B3F-1055; B3F1000; Mouser Part Number 653-B3F-1055
BTN_BRK_FAN1: B3F-1055; B3F1000; Mouser Part Number 653-B3F-1055
BTN_TERR_ON_ND1: B3F-1055; B3F1000; Mouser Part Number 653-B3F-1055
C1, C2, C3: 0.1uF Ceramic; C_Disc_D3.0mm_W1.6mm_P2.50mm
GEAR_Panel1: Pin Header 2x04; IDC-Header_2x04_P2.54mm_Vertical
R1, R2, R3: 1k; R_Axial_DIN0204_L3.6mm_D1.6mm_P5.08mm_Horizontal
SW_ASKID_NW_STRG1: SW_SPDT[ON-OFF]; T80-Z1
TERR_ON_ND_ON1: GREEN; LED_D3.0mm
U1, U2, U3: TLC5917; DIP-16_W7.62mm
U4: Arduino Pro Micro; Sparkfun_Pro_Micro
UNLK1, UNLK2, UNLK3: RED; LED_D3.0mm
UNLK_ARROW1, UNLK_ARROW2, UNLK_ARROW3: GREEN; LED_D3.0mm

Connections:
12V_IN: 12V_EXT1.2, 12V_HEADER1.2, 12V_JACK1.1, BL_1.2 (A), BL_5.2 (A), BL_9.2 (A), BL_13.2 (A), BL_17.2 (A), GEAR_Panel1.8
+5V: ACCU_PRESSURE1.2, AUTO_BRK_LO_DECEL1.2 (A), AUTO_BRK_LO_ON1.2 (A), AUTO_BRK_MAX_DECEL1.2 (A), AUTO_BRK_MAX_ON1.2 (A), AUTO_BRK_MED_DECEL1.2 (A), AUTO_BRK_MED_ON1.2 (A), BRK_FAN_HOT1.2 (A), BRK_FAN_ON1.2 (A), C1.1, C2.1, C3.1, TERR_ON_ND_ON1.2 (A), U1.16 (VDD), U2.16 (VDD), U3.16 (VDD), U4.21 (VCC), UNLK1.2 (A), UNLK2.2 (A), UNLK3.2 (A), UNLK_ARROW1.2 (A), UNLK_ARROW2.2 (A), UNLK_ARROW3.2 (A)
AUTO_BRK_LO_DECEL: AUTO_BRK_LO_DECEL1.1 (K), U1.12 (~OUT7)
AUTO_BRK_LO_ON: AUTO_BRK_LO_ON1.1 (K), U1.11 (~OUT6)
AUTO_BRK_MAX_DECEL: AUTO_BRK_MAX_DECEL1.1 (K), U2.12 (~OUT7)
AUTO_BRK_MAX_ON: AUTO_BRK_MAX_ON1.1 (K), U2.11 (~OUT6)
AUTO_BRK_MED_DECEL: AUTO_BRK_MED_DECEL1.1 (K), U1.9 (~OUT4)
AUTO_BRK_MED_ON: AUTO_BRK_MED_ON1.1 (K), U1.10 (~OUT5)
BACKLIGHT_1: BL_4.1 (K), U3.12 (~OUT7)
BACKLIGHT_2: BL_8.1 (K), U3.8 (~OUT3)
BACKLIGHT_3: BL_12.1 (K), U3.11 (~OUT6)
BACKLIGHT_4: BL_16.1 (K), U3.9 (~OUT4)
BACKLIGHT_5: BL_20.1 (K), U3.10 (~OUT5)
BACKLIGHT_6: GEAR_Panel1.5, U3.7 (~OUT2)
BACKLIGHT_7: GEAR_Panel1.3, U3.6 (~OUT1)
BRK_FAN_HOT: BRK_FAN_HOT1.1 (K), U2.7 (~OUT2)
BRK_FAN_ON: BRK_FAN_ON1.1 (K), U2.8 (~OUT3)
BTN_AUTO_BRK_LO: BTN_AUTO_BRK_LO1.1, U4.20 (D21/A3)
BTN_AUTO_BRK_MAX: BTN_AUTO_BRK_MAX1.1, U4.18 (D19/A1)
BTN_AUTO_BRK_MED: BTN_AUTO_BRK_MED1.1, U4.19 (D20/A2)
BTN_BRK_FAN: BTN_BRK_FAN1.1, U4.14 (D16)
BTN_TERR_ON_ND: BTN_TERR_ON_ND1.1, U4.17 (D18/A0)
GEAR_WARN: GEAR_Panel1.4, U2.9 (~OUT4)
GND: 12V_EXT1.1, 12V_HEADER1.1, 12V_JACK1.2, 12V_JACK1.3, ACCU_PRESSURE1.1, BTN_AUTO_BRK_LO1.3, BTN_AUTO_BRK_MAX1.3, BTN_AUTO_BRK_MED1.3, BTN_BRK_FAN1.3, BTN_TERR_ON_ND1.3, C1.2, C2.2, C3.2, GEAR_Panel1.7, R1.2, R2.2, R3.2, SW_ASKID_NW_STRG1.2 (B), U1.1 (GND), U2.1 (GND), U3.1 (GND), U4.3 (GND), U4.4 (GND), U4.23 (GND)
unnamed: BL_1.1 (K), BL_2.2 (A)
unnamed: BL_2.1 (K), BL_3.2 (A)
unnamed: BL_3.1 (K), BL_4.2 (A)
unnamed: BL_5.1 (K), BL_6.2 (A)
unnamed: BL_6.1 (K), BL_7.2 (A)
unnamed: BL_7.1 (K), BL_8.2 (A)
unnamed: BL_9.1 (K), BL_10.2 (A)
unnamed: BL_10.1 (K), BL_11.2 (A)
unnamed: BL_11.1 (K), BL_12.2 (A)
unnamed: BL_13.1 (K), BL_14.2 (A)
unnamed: BL_14.1 (K), BL_15.2 (A)
unnamed: BL_15.1 (K), BL_16.2 (A)
unnamed: BL_17.1 (K), BL_18.2 (A)
unnamed: BL_18.1 (K), BL_19.2 (A)
unnamed: BL_19.1 (K), BL_20.2 (A)
unnamed: R1.1, U1.15 (R-EXT)
unnamed: R2.1, U2.15 (R-EXT)
unnamed: R3.1, U3.15 (R-EXT)
OSH_CLOCK: U1.3 (CLK), U2.3 (CLK), U3.3 (CLK), U4.5 (D2)
OSH_DIN: U1.2 (SDI), U4.1 (D1/TX)
OSH_DOUT1: U1.14 (SDO), U2.2 (SDI)
OSH_DOUT2: U2.14 (SDO), U3.2 (SDI)
OSH_LATCH: U1.4 (LE(ED1)), U2.4 (LE(ED1)), U3.4 (LE(ED1)), U4.2 (D0/RX)
OUT_BRT_BACK: U3.13 (~OE(ED2)), U4.13 (~D10/A10)
OUT_BRT_LED: U1.13 (~OE(ED2)), U2.13 (~OE(ED2)), U4.6 (~D3)
SERVO1: ACCU_PRESSURE1.3, U4.12 (~D9/A9)
SERVO2: ACCU_PRESSURE1.4, U4.9 (~D6/A7)
SERVO3: ACCU_PRESSURE1.5, U4.8 (~D5)
SW_ASKID_NW_STRG: SW_ASKID_NW_STRG1.3 (C), U4.15 (D14)
SW_GEAR_DOWN: GEAR_Panel1.2, U4.16 (D15)
SW_GEAR_UP: GEAR_Panel1.1, U4.11 (D8/A8)
TERR_ON_ND_ON: TERR_ON_ND_ON1.1 (K), U2.10 (~OUT5)
UNLK1: U1.6 (~OUT1), UNLK1.1 (K)
UNLK2: U1.7 (~OUT2), UNLK2.1 (K)
UNLK3: U2.6 (~OUT1), UNLK3.1 (K)
UNL_ARROW1: U1.5 (~OUT0), UNLK_ARROW1.1 (K)
UNL_ARROW2: U1.8 (~OUT3), UNLK_ARROW2.1 (K)
UNL_ARROW3: U2.5 (~OUT0), UNLK_ARROW3.1 (K)

Notes on the sheet:
Backlighting
Arduino
Switches
Korry
External Power (12V)
Lighting Korry
Lighting Control
Integral lighting behind the front panel
Backlight
External

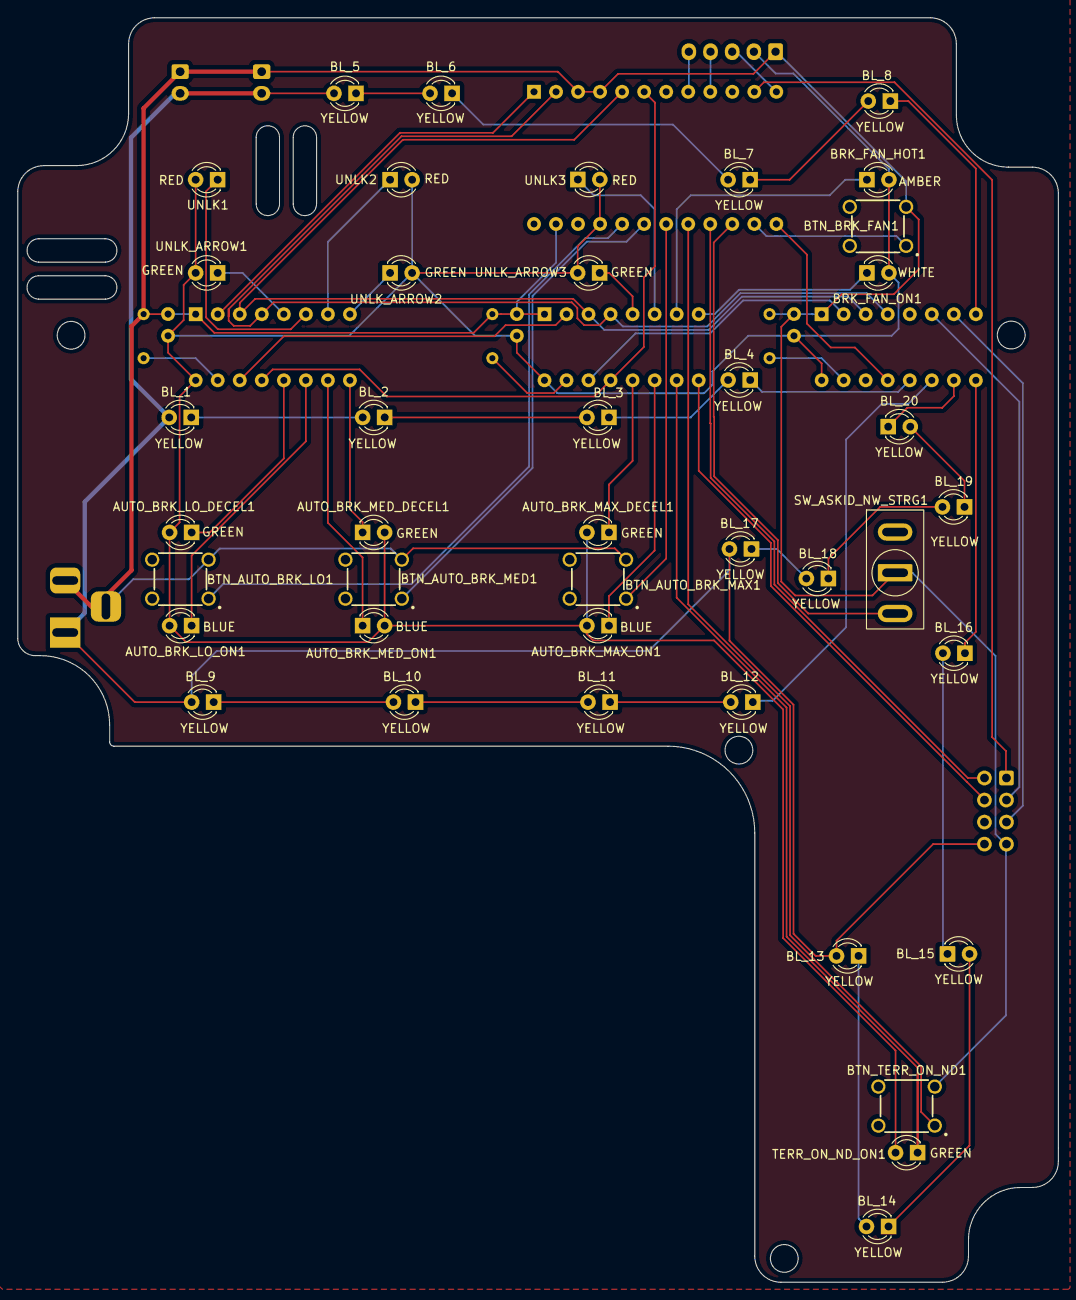
[picture p48: board AUTOBRAKE.kicad_pcb from above]

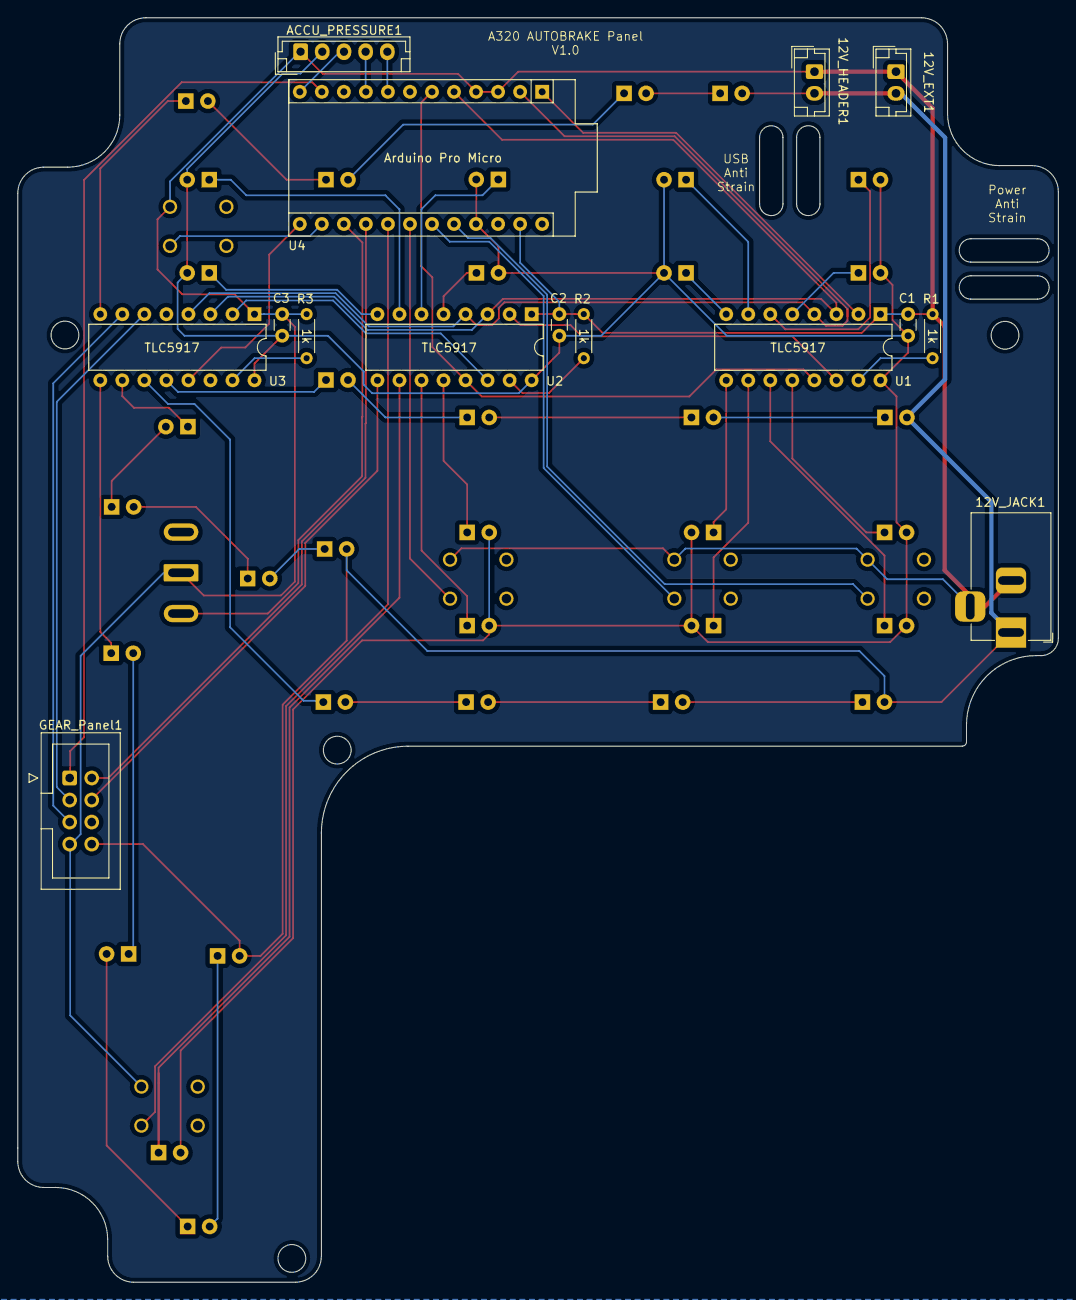
[picture p49: board AUTOBRAKE.kicad_pcb from below]

Board: 2 copper layers, 120.0 x 145.8 mm, 56 parts (15 on the bottom side), 62 nets.
