SK-MH/A320-PCBs/4 - PEDESTAL/4.2 RMP Left (Capt.)/KiCAD/A320 Radio Panel.kicad_pcb

## KiCad design 4 - PEDESTAL/4.2 RMP Left (Capt.)/KiCAD/A320 Radio Panel.kicad_pcb (2025-01-06)

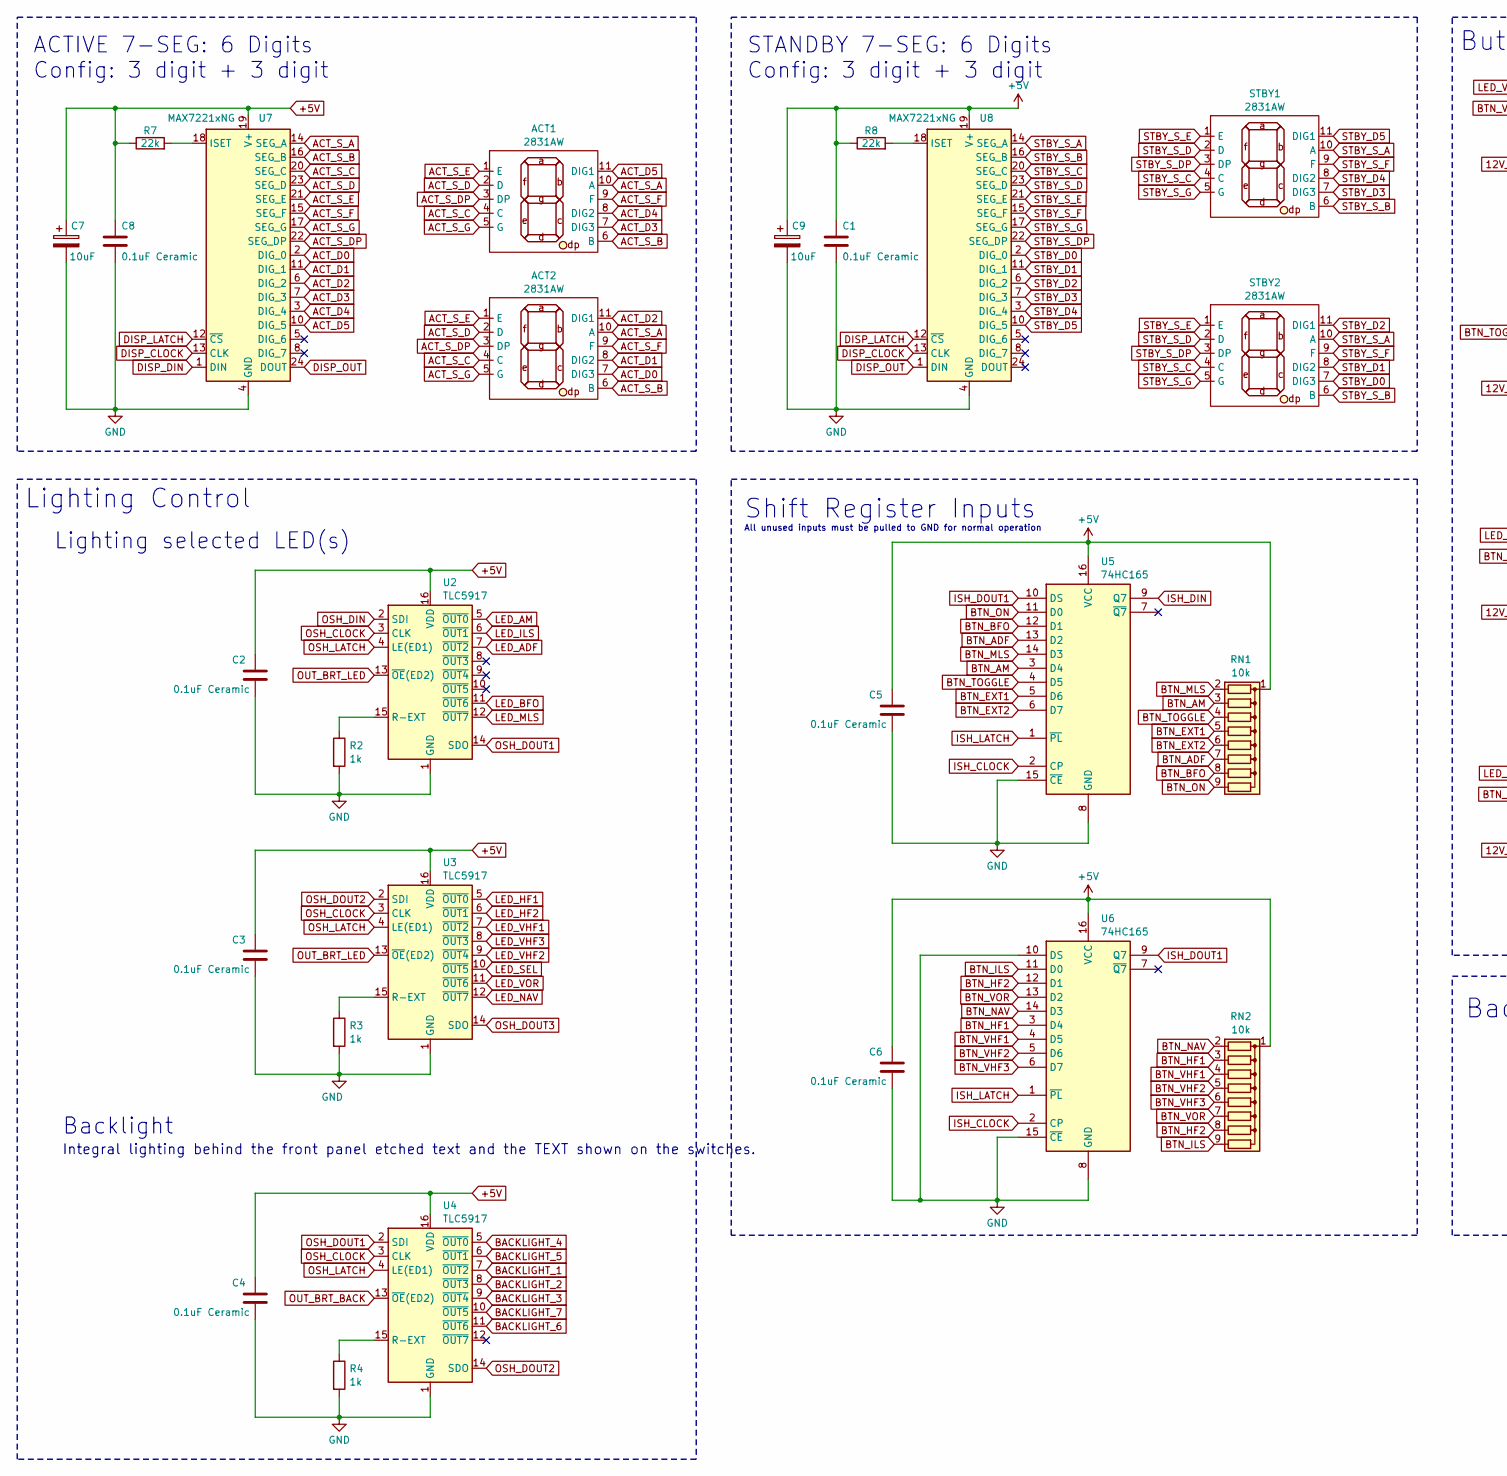
[picture p50: schematic A320 Radio Panel.kicad_sch, part in row 1, column 1]

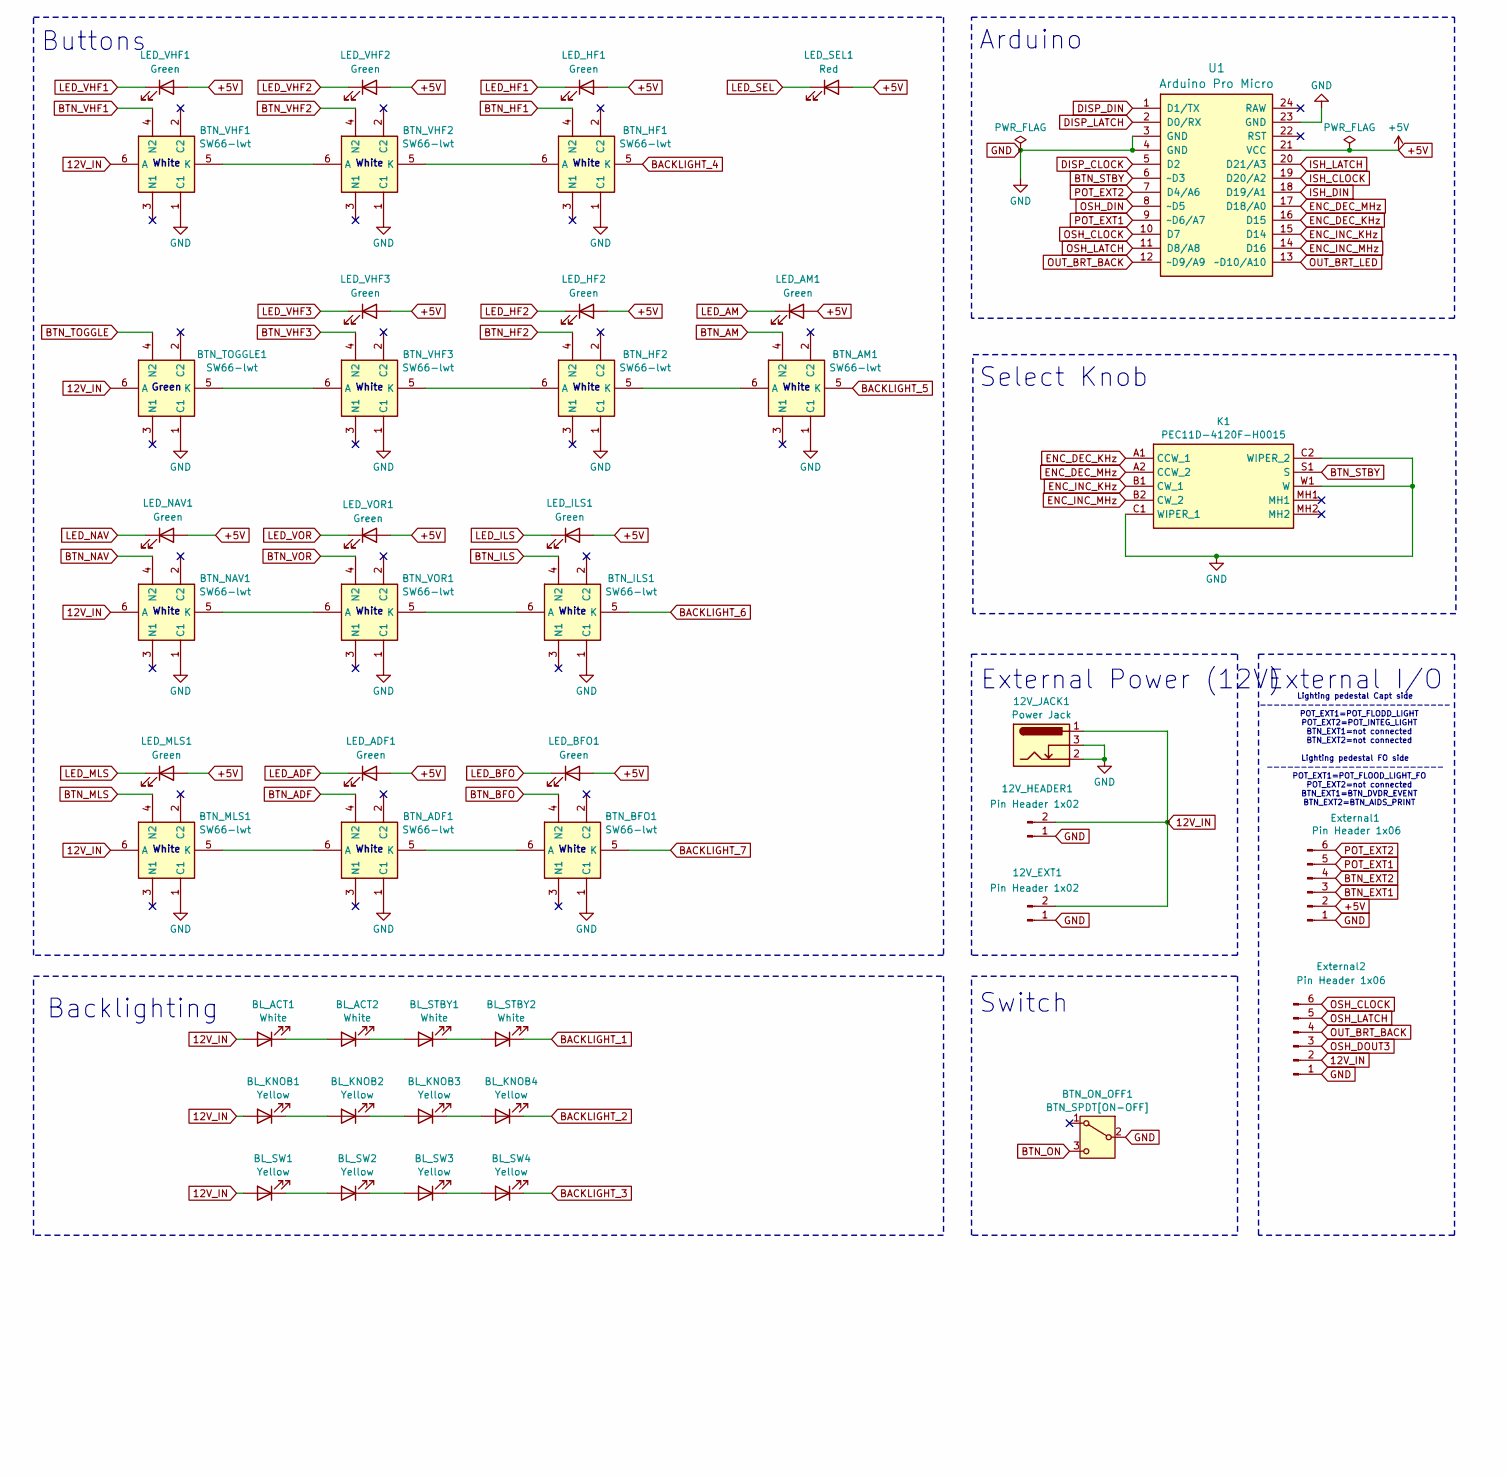
[picture p51: schematic A320 Radio Panel.kicad_sch, part in row 1, column 2]

Parts:
12V_EXT1, 12V_HEADER1: Pin Header 1x02; JST_EH_B2B-EH-A_1x02_P2.50mm_Vertical
12V_JACK1: Power Jack; BarrelJack_Horizontal
ACT1, ACT2: 2831AW
BL_ACT1, BL_ACT2: White; LED_D3.0mm
BL_KNOB1, BL_KNOB2, BL_KNOB3, BL_KNOB4: Yellow; LED_D3.0mm
BL_STBY1, BL_STBY2: White; LED_D3.0mm
BL_SW1, BL_SW2, BL_SW3, BL_SW4: Yellow; LED_D3.0mm
BTN_ADF1: SW66-lwt
BTN_AM1: SW66-lwt
BTN_BFO1: SW66-lwt
BTN_HF1, BTN_HF2: SW66-lwt
BTN_ILS1: SW66-lwt
BTN_MLS1: SW66-lwt
BTN_NAV1: SW66-lwt
BTN_ON_OFF1: BTN_SPDT[ON-OFF]; T80-Z1
BTN_TOGGLE1: SW66-lwt
BTN_VHF1, BTN_VHF2, BTN_VHF3: SW66-lwt
BTN_VOR1: SW66-lwt
C1, C2, C3, C4, C5, C6, C8: 0.1uF Ceramic; C_Disc_D3.0mm_W1.6mm_P2.50mm
C7, C9: 10uF; CP_Radial_D4.0mm_P1.50mm
External1, External2: Pin Header 1x06; JST_EH_B6B-EH-A_1x06_P2.50mm_Vertical
K1: PEC11D-4120F-H0015; PEC11D4120FH0015; Mouser Part Number 652-PEC11D4120FH0015
LED_ADF1: Green; LED_D3.0mm
LED_AM1: Green; LED_D3.0mm
LED_BFO1: Green; LED_D3.0mm
LED_HF1, LED_HF2: Green; LED_D3.0mm
LED_ILS1: Green; LED_D3.0mm
LED_MLS1: Green; LED_D3.0mm
LED_NAV1: Green; LED_D3.0mm
LED_SEL1: Red; LED_D3.0mm
LED_VHF1, LED_VHF2, LED_VHF3: Green; LED_D3.0mm
LED_VOR1: Green; LED_D3.0mm
R2, R3, R4: 1k; R_Axial_DIN0204_L3.6mm_D1.6mm_P7.62mm_Horizontal
R7, R8: 22k; R_Axial_DIN0204_L3.6mm_D1.6mm_P7.62mm_Horizontal
RN1, RN2: 10k; R_Array_SIP9
STBY1, STBY2: 2831AW
U1: Arduino Pro Micro; Sparkfun_Pro_Micro
U2, U3, U4: TLC5917; DIP-16_W7.62mm
U5, U6: 74HC165; DIP-16_W7.62mm
U7, U8: MAX7221xNG; DIP-24_W7.62mm

Connections:
12V_IN: 12V_EXT1.2, 12V_HEADER1.2, 12V_JACK1.1, BL_ACT1.2 (A), BL_KNOB1.2 (A), BL_SW1.2 (A), BTN_MLS1.6 (A), BTN_NAV1.6 (A), BTN_TOGGLE1.6 (A), BTN_VHF1.6 (A), External2.2
+5V: C1.1, C2.1, C3.1, C4.1, C5.1, C6.1, C7.1, C8.1, C9.1, External1.2, LED_ADF1.2 (A), LED_AM1.2 (A), LED_BFO1.2 (A), LED_HF1.2 (A), LED_HF2.2 (A), LED_ILS1.2 (A), LED_MLS1.2 (A), LED_NAV1.2 (A), LED_SEL1.2 (A), LED_VHF1.2 (A), LED_VHF2.2 (A), LED_VHF3.2 (A), LED_VOR1.2 (A), R7.1, R8.1, RN1.1 (common), RN2.1 (common), U1.21 (VCC), U2.16 (VDD), U3.16 (VDD), U4.16 (VDD), U5.16 (VCC), U6.16 (VCC), U7.19 (V+), U8.19 (V+)
ACT_D0: ACT2.7 (DIG3), U7.2 (DIG_0)
ACT_D1: ACT2.8 (DIG2), U7.11 (DIG_1)
ACT_D2: ACT2.11 (DIG1), U7.6 (DIG_2)
ACT_D3: ACT1.7 (DIG3), U7.7 (DIG_3)
ACT_D4: ACT1.8 (DIG2), U7.3 (DIG_4)
ACT_D5: ACT1.11 (DIG1), U7.10 (DIG_5)
ACT_S_A: ACT1.10 (A), ACT2.10 (A), U7.14 (SEG_A)
ACT_S_B: ACT1.6 (B), ACT2.6 (B), U7.16 (SEG_B)
ACT_S_C: ACT1.4 (C), ACT2.4 (C), U7.20 (SEG_C)
ACT_S_D: ACT1.2 (D), ACT2.2 (D), U7.23 (SEG_D)
ACT_S_DP: ACT1.3 (DP), ACT2.3 (DP), U7.22 (SEG_DP)
ACT_S_E: ACT1.1 (E), ACT2.1 (E), U7.21 (SEG_E)
ACT_S_F: ACT1.9 (F), ACT2.9 (F), U7.15 (SEG_F)
ACT_S_G: ACT1.5 (G), ACT2.5 (G), U7.17 (SEG_G)
BACKLIGHT_1: BL_STBY2.1 (K), U4.7 (~OUT2)
BACKLIGHT_2: BL_KNOB4.1 (K), U4.8 (~OUT3)
BACKLIGHT_3: BL_SW4.1 (K), U4.9 (~OUT4)
BACKLIGHT_4: BTN_HF1.5 (K), U4.5 (~OUT0)
BACKLIGHT_5: BTN_AM1.5 (K), U4.6 (~OUT1)
BACKLIGHT_6: BTN_ILS1.5 (K), U4.11 (~OUT6)
BACKLIGHT_7: BTN_BFO1.5 (K), U4.10 (~OUT5)
BTN_ADF: BTN_ADF1.4 (N2), RN1.7 (R6), U5.13 (D2)
BTN_AM: BTN_AM1.4 (N2), RN1.3 (R2), U5.3 (D4)
BTN_BFO: BTN_BFO1.4 (N2), RN1.8 (R7), U5.12 (D1)
BTN_EXT1: External1.3, RN1.5 (R4), U5.5 (D6)
BTN_EXT2: External1.4, RN1.6 (R5), U5.6 (D7)
BTN_HF1: BTN_HF1.4 (N2), RN2.3 (R2), U6.3 (D4)
BTN_HF2: BTN_HF2.4 (N2), RN2.8 (R7), U6.12 (D1)
BTN_ILS: BTN_ILS1.4 (N2), RN2.9 (R8), U6.11 (D0)
BTN_MLS: BTN_MLS1.4 (N2), RN1.2 (R1), U5.14 (D3)
BTN_NAV: BTN_NAV1.4 (N2), RN2.2 (R1), U6.14 (D3)
BTN_ON: BTN_ON_OFF1.3 (C), RN1.9 (R8), U5.11 (D0)
BTN_STBY: K1.S1 (S), U1.6 (~D3)
BTN_TOGGLE: BTN_TOGGLE1.4 (N2), RN1.4 (R3), U5.4 (D5)
BTN_VHF1: BTN_VHF1.4 (N2), RN2.4 (R3), U6.4 (D5)
BTN_VHF2: BTN_VHF2.4 (N2), RN2.5 (R4), U6.5 (D6)
BTN_VHF3: BTN_VHF3.4 (N2), RN2.6 (R5), U6.6 (D7)
BTN_VOR: BTN_VOR1.4 (N2), RN2.7 (R6), U6.13 (D2)
DISP_CLOCK: U1.5 (D2), U7.13 (CLK), U8.13 (CLK)
DISP_DIN: U1.1 (D1/TX), U7.1 (DIN)
DISP_LATCH: U1.2 (D0/RX), U7.12 (~CS), U8.12 (~CS)
DISP_OUT: U7.24 (DOUT), U8.1 (DIN)
ENC_DEC_KHz: K1.A1 (CCW_1), U1.16 (D15)
ENC_DEC_MHz: K1.A2 (CCW_2), U1.17 (D18/A0)
ENC_INC_KHz: K1.B1 (CW_1), U1.15 (D14)
ENC_INC_MHz: K1.B2 (CW_2), U1.14 (D16)
GND: 12V_EXT1.1, 12V_HEADER1.1, 12V_JACK1.2, 12V_JACK1.3, BTN_ADF1.1 (C1), BTN_AM1.1 (C1), BTN_BFO1.1 (C1), BTN_HF1.1 (C1), BTN_HF2.1 (C1), BTN_ILS1.1 (C1), BTN_MLS1.1 (C1), BTN_NAV1.1 (C1), BTN_ON_OFF1.2 (B), BTN_TOGGLE1.1 (C1), BTN_VHF1.1 (C1), BTN_VHF2.1 (C1), BTN_VHF3.1 (C1), BTN_VOR1.1 (C1), C1.2, C2.2, C3.2, C4.2, C5.2, C6.2, C7.2, C8.2, C9.2, External1.1, External2.1, K1.C1 (WIPER_1), K1.C2 (WIPER_2), K1.W1 (W), R2.2, R3.2, R4.2, U1.3 (GND), U1.4 (GND), U1.23 (GND), U2.1 (GND), U3.1 (GND), U4.1 (GND), U5.8 (GND), U5.15 (~CE), U6.8 (GND), U6.10 (DS), U6.15 (~CE), U7.4 (GND), U7.9 (GND), U8.4 (GND), U8.9 (GND)
ISH_CLOCK: U1.19 (D20/A2), U5.2 (CP), U6.2 (CP)
ISH_DIN: U1.18 (D19/A1), U5.9 (Q7)
ISH_DOUT1: U5.10 (DS), U6.9 (Q7)
ISH_LATCH: U1.20 (D21/A3), U5.1 (~PL), U6.1 (~PL)
LED_ADF: LED_ADF1.1 (K), U2.7 (~OUT2)
LED_AM: LED_AM1.1 (K), U2.5 (~OUT0)
LED_BFO: LED_BFO1.1 (K), U2.11 (~OUT6)
LED_HF1: LED_HF1.1 (K), U3.5 (~OUT0)
LED_HF2: LED_HF2.1 (K), U3.6 (~OUT1)
LED_ILS: LED_ILS1.1 (K), U2.6 (~OUT1)
LED_MLS: LED_MLS1.1 (K), U2.12 (~OUT7)
LED_NAV: LED_NAV1.1 (K), U3.12 (~OUT7)
LED_SEL: LED_SEL1.1 (K), U3.10 (~OUT5)
LED_VHF1: LED_VHF1.1 (K), U3.7 (~OUT2)
LED_VHF2: LED_VHF2.1 (K), U3.9 (~OUT4)
LED_VHF3: LED_VHF3.1 (K), U3.8 (~OUT3)
LED_VOR: LED_VOR1.1 (K), U3.11 (~OUT6)
unnamed: BL_ACT1.1 (K), BL_ACT2.2 (A)
unnamed: BL_ACT2.1 (K), BL_STBY1.2 (A)
unnamed: BL_KNOB1.1 (K), BL_KNOB2.2 (A)
unnamed: BL_KNOB2.1 (K), BL_KNOB3.2 (A)
unnamed: BL_KNOB3.1 (K), BL_KNOB4.2 (A)
unnamed: BL_STBY1.1 (K), BL_STBY2.2 (A)
unnamed: BL_SW1.1 (K), BL_SW2.2 (A)
unnamed: BL_SW2.1 (K), BL_SW3.2 (A)
unnamed: BL_SW3.1 (K), BL_SW4.2 (A)
unnamed: BTN_ADF1.6 (A), BTN_MLS1.5 (K)
unnamed: BTN_ADF1.5 (K), BTN_BFO1.6 (A)
unnamed: BTN_AM1.6 (A), BTN_HF2.5 (K)
unnamed: BTN_HF1.6 (A), BTN_VHF2.5 (K)
unnamed: BTN_HF2.6 (A), BTN_VHF3.5 (K)
unnamed: BTN_ILS1.6 (A), BTN_VOR1.5 (K)
unnamed: BTN_NAV1.5 (K), BTN_VOR1.6 (A)
unnamed: BTN_TOGGLE1.5 (K), BTN_VHF3.6 (A)
unnamed: BTN_VHF1.5 (K), BTN_VHF2.6 (A)
unnamed: R2.1, U2.15 (R-EXT)
unnamed: R3.1, U3.15 (R-EXT)
unnamed: R4.1, U4.15 (R-EXT)
unnamed: R7.2, U7.18 (ISET)
unnamed: R8.2, U8.18 (ISET)
OSH_CLOCK: External2.6, U1.10 (D7), U2.3 (CLK), U3.3 (CLK), U4.3 (CLK)
OSH_DIN: U1.8 (~D5), U2.2 (SDI)
OSH_DOUT1: U2.14 (SDO), U4.2 (SDI)
OSH_DOUT2: U3.2 (SDI), U4.14 (SDO)
OSH_DOUT3: External2.3, U3.14 (SDO)
OSH_LATCH: External2.5, U1.11 (D8/A8), U2.4 (LE(ED1)), U3.4 (LE(ED1)), U4.4 (LE(ED1))
OUT_BRT_BACK: External2.4, U1.12 (~D9/A9), U4.13 (~OE(ED2))
OUT_BRT_LED: U1.13 (~D10/A10), U2.13 (~OE(ED2)), U3.13 (~OE(ED2))
POT_EXT1: External1.5, U1.9 (~D6/A7)
POT_EXT2: External1.6, U1.7 (D4/A6)
STBY_D0: STBY2.7 (DIG3), U8.2 (DIG_0)
STBY_D1: STBY2.8 (DIG2), U8.11 (DIG_1)
STBY_D2: STBY2.11 (DIG1), U8.6 (DIG_2)
STBY_D3: STBY1.7 (DIG3), U8.7 (DIG_3)
STBY_D4: STBY1.8 (DIG2), U8.3 (DIG_4)
STBY_D5: STBY1.11 (DIG1), U8.10 (DIG_5)
STBY_S_A: STBY1.10 (A), STBY2.10 (A), U8.14 (SEG_A)
STBY_S_B: STBY1.6 (B), STBY2.6 (B), U8.16 (SEG_B)
STBY_S_C: STBY1.4 (C), STBY2.4 (C), U8.20 (SEG_C)
STBY_S_D: STBY1.2 (D), STBY2.2 (D), U8.23 (SEG_D)
STBY_S_DP: STBY1.3 (DP), STBY2.3 (DP), U8.22 (SEG_DP)
STBY_S_E: STBY1.1 (E), STBY2.1 (E), U8.21 (SEG_E)
STBY_S_F: STBY1.9 (F), STBY2.9 (F), U8.15 (SEG_F)
STBY_S_G: STBY1.5 (G), STBY2.5 (G), U8.17 (SEG_G)

Notes on the sheet:
White
STANDBY 7-SEG: 6 Digits Config: 3 digit + 3 digit
Lighting selected LED(s)
Backlight
Buttons
Shift Register Inputs
Lighting Control
External I/O
Green
Integral lighting behind the front panel etched text and the TEXT shown on the switches.
Lighting pedestal Capt side ---------------------------- POT_EXT1=POT_FLODD_LIGHT POT_EXT2=POT_INTEG_LIGHT BTN_EXT1=not connected BTN_EXT2=not connected Lighting pedestal FO side -------------------------- POT_EXT1=POT_FLOOD_LIGHT_FO POT_EXT2=not connected BTN_EXT1=BTN_DVDR_EVENT BTN_EXT2=BTN_AIDS_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
Arduino
All unused inputs must be pulled to GND for normal operation
Switch
Select Knob
ACTIVE 7-SEG: 6 Digits Config: 3 digit + 3 digit
External Power (12V)
Backlighting

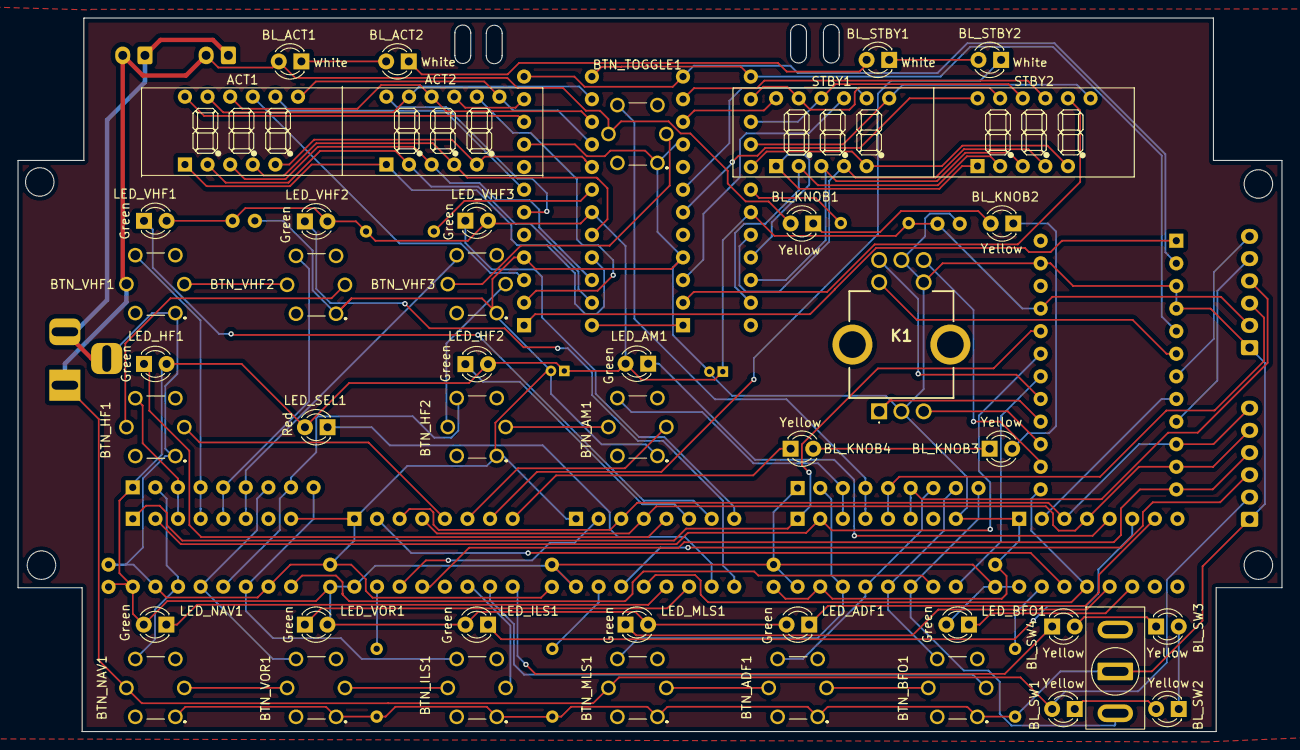
[picture p52: board A320 Radio Panel.kicad_pcb from above]

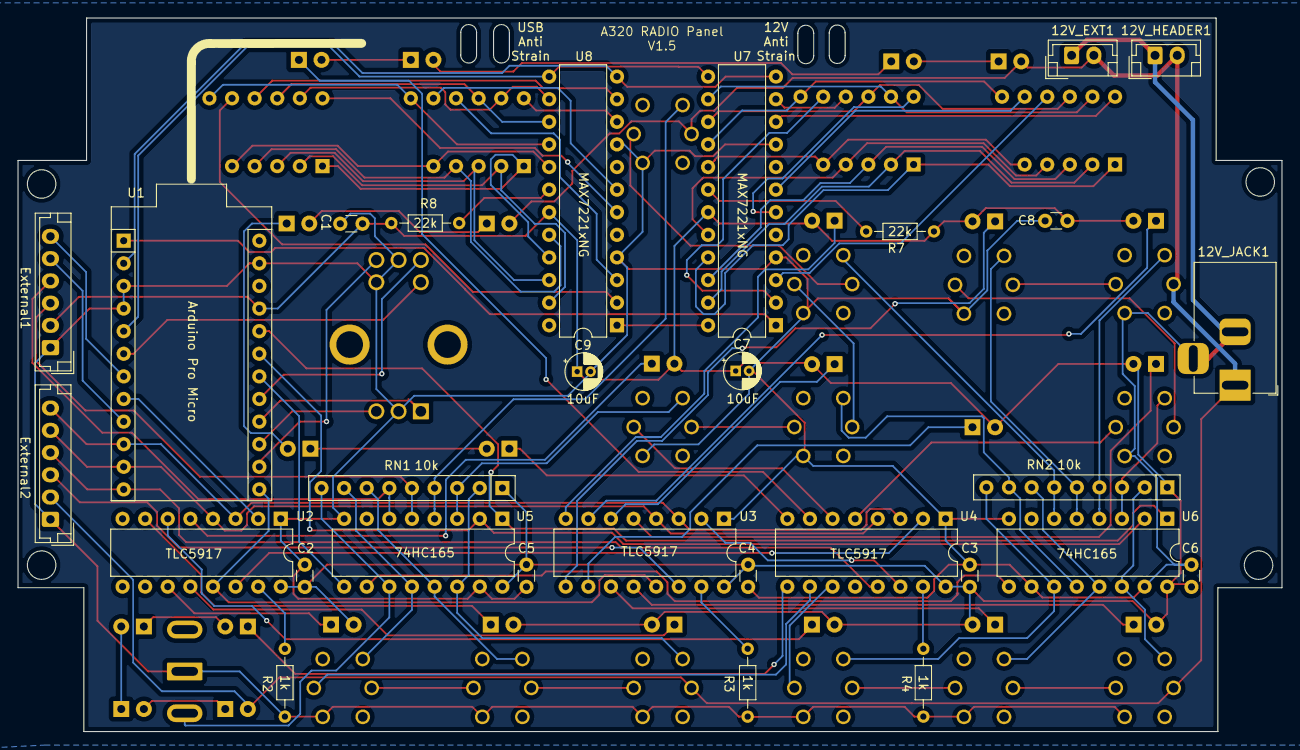
[picture p53: board A320 Radio Panel.kicad_pcb from below]

Board: 2 copper layers, 142.0 x 80.2 mm, 73 parts (29 on the bottom side), 113 nets.
