SK-MH/A320-PCBs/4 - PEDESTAL/4.5 RADAR/KiCAD/RADAR.kicad_pcb

## KiCad design 4 - PEDESTAL/4.5 RADAR/KiCAD/RADAR.kicad_pcb (2025-01-06)

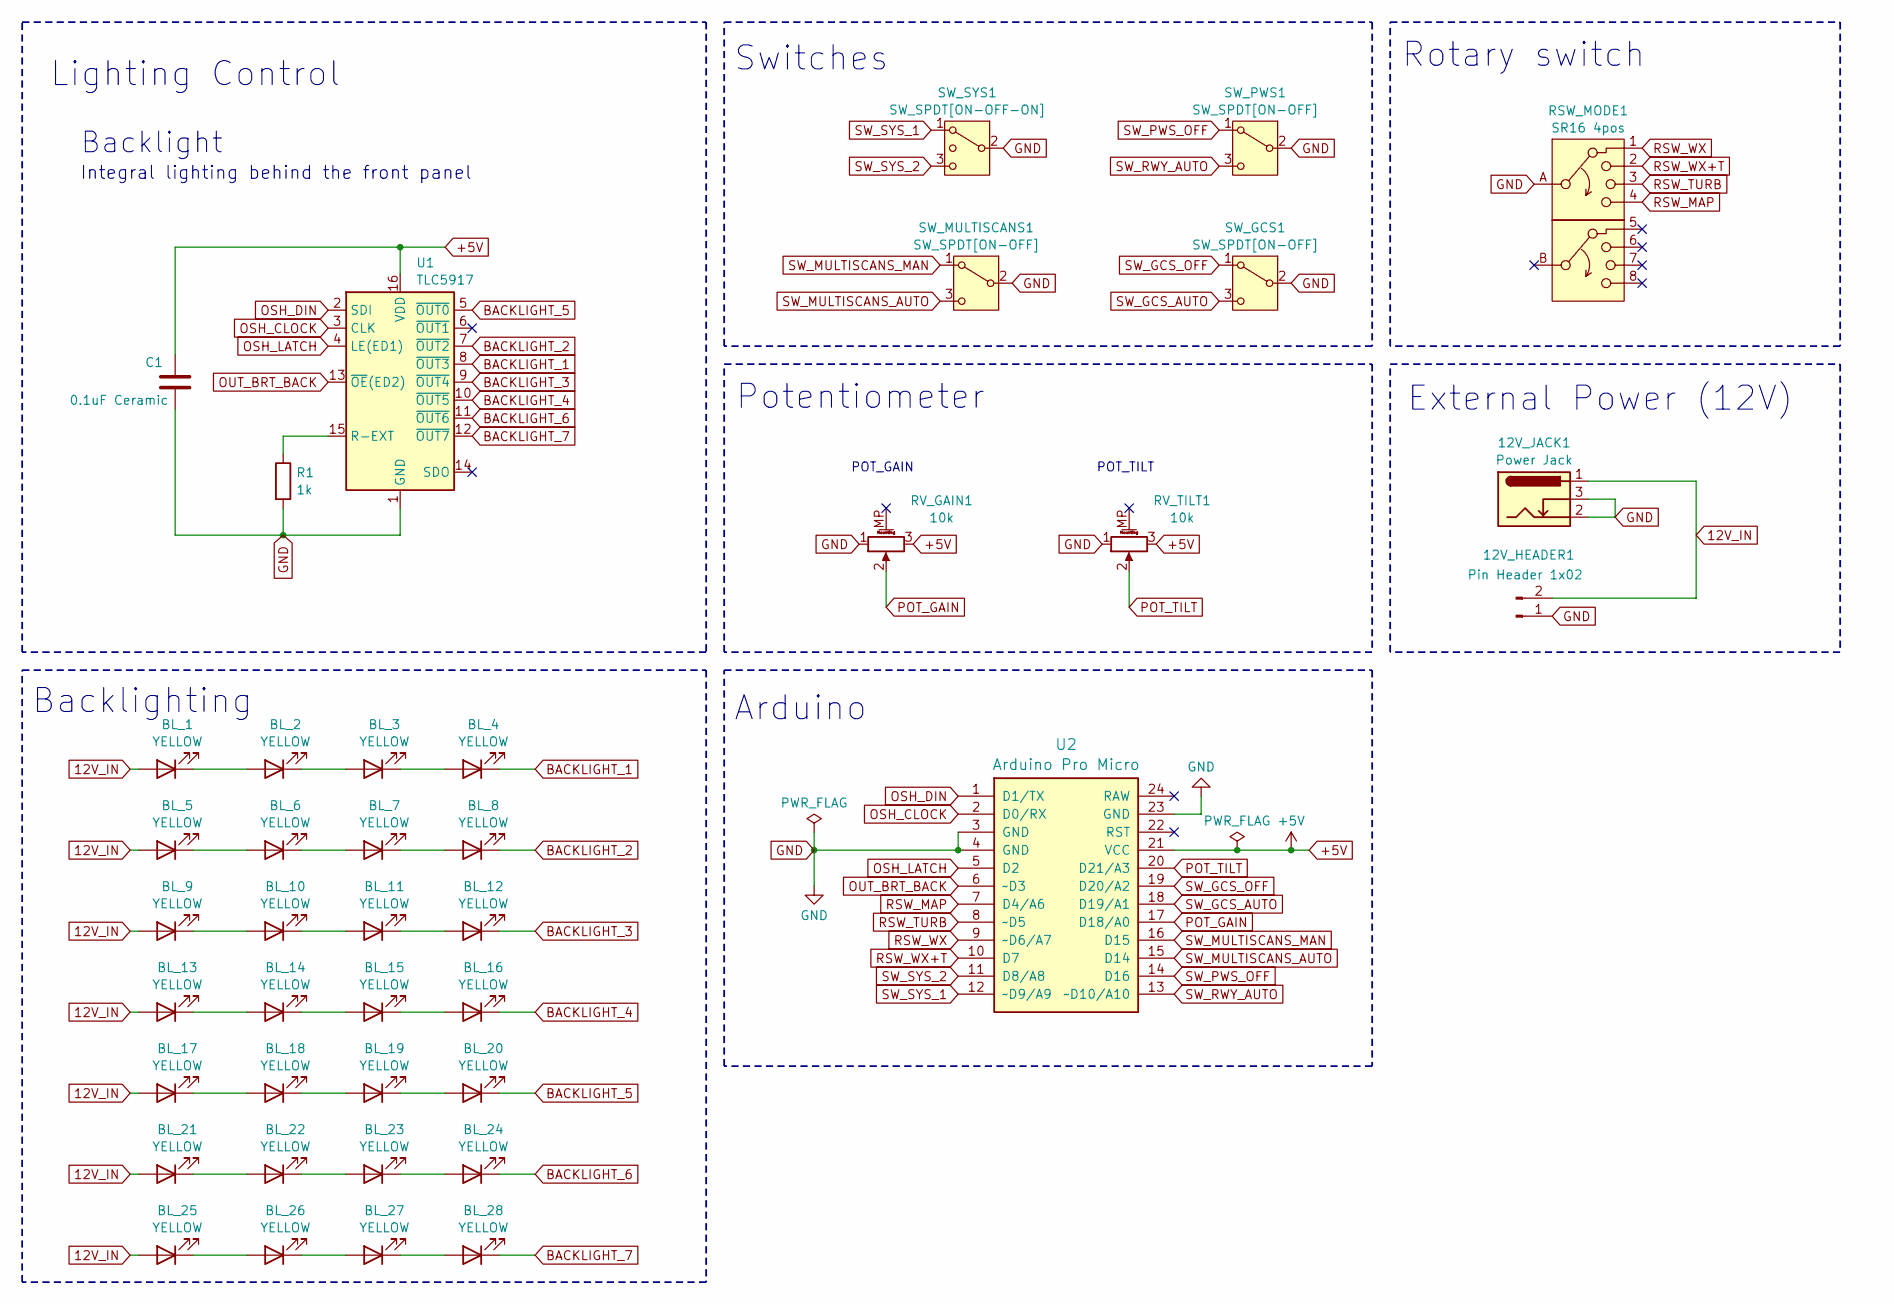
[picture p54: schematic RADAR.kicad_sch, RADAR Panel]

Parts:
12V_HEADER1: Pin Header 1x02; JST_EH_B2B-EH-A_1x02_P2.50mm_Vertical
12V_JACK1: Power Jack; BarrelJack_Horizontal
BL_1, BL_2, BL_3, BL_4, BL_5, BL_6, BL_7, BL_8, BL_9, BL_10, BL_11, BL_12, BL_13, BL_14, BL_15, BL_16, BL_17, BL_18, BL_19, BL_20, BL_21, BL_22, BL_23, BL_24, BL_25, BL_26, BL_27, BL_28: YELLOW; LED_D3.0mm
C1: 0.1uF Ceramic; C_Disc_D3.0mm_W1.6mm_P2.50mm
R1: 1k; R_Axial_DIN0204_L3.6mm_D1.6mm_P5.08mm_Horizontal
RSW_MODE1: SR16 4pos; SR16-AB
RV_GAIN1: 10k; Potentiometer_Alps_RK09K_Single_Vertical
RV_TILT1: 10k; Potentiometer_Alps_RK09K_Single_Vertical
SW_GCS1: SW_SPDT[ON-OFF]; T80-Z1
SW_MULTISCANS1: SW_SPDT[ON-OFF]; T80-Z1
SW_PWS1: SW_SPDT[ON-OFF]; T80-Z1
SW_SYS1: SW_SPDT[ON-OFF-ON]; T80-Z1
U1: TLC5917; DIP-16_W7.62mm
U2: Arduino Pro Micro; Sparkfun_Pro_Micro

Connections:
12V_IN: 12V_HEADER1.2, 12V_JACK1.1, BL_1.2 (A), BL_5.2 (A), BL_9.2 (A), BL_13.2 (A), BL_17.2 (A), BL_21.2 (A), BL_25.2 (A)
+5V: C1.1, RV_GAIN1.3, RV_TILT1.3, U1.16 (VDD), U2.21 (VCC)
BACKLIGHT_1: BL_4.1 (K), U1.8 (~OUT3)
BACKLIGHT_2: BL_8.1 (K), U1.7 (~OUT2)
BACKLIGHT_3: BL_12.1 (K), U1.9 (~OUT4)
BACKLIGHT_4: BL_16.1 (K), U1.10 (~OUT5)
BACKLIGHT_5: BL_20.1 (K), U1.5 (~OUT0)
BACKLIGHT_6: BL_24.1 (K), U1.11 (~OUT6)
BACKLIGHT_7: BL_28.1 (K), U1.12 (~OUT7)
GND: 12V_HEADER1.1, 12V_JACK1.2, 12V_JACK1.3, C1.2, R1.2, RSW_MODE1.A, RV_GAIN1.1, RV_TILT1.1, SW_GCS1.2 (B), SW_MULTISCANS1.2 (B), SW_PWS1.2 (B), SW_SYS1.2 (3), U1.1 (GND), U2.3 (GND), U2.4 (GND), U2.23 (GND)
unnamed: BL_1.1 (K), BL_2.2 (A)
unnamed: BL_2.1 (K), BL_3.2 (A)
unnamed: BL_3.1 (K), BL_4.2 (A)
unnamed: BL_5.1 (K), BL_6.2 (A)
unnamed: BL_6.1 (K), BL_7.2 (A)
unnamed: BL_7.1 (K), BL_8.2 (A)
unnamed: BL_9.1 (K), BL_10.2 (A)
unnamed: BL_10.1 (K), BL_11.2 (A)
unnamed: BL_11.1 (K), BL_12.2 (A)
unnamed: BL_13.1 (K), BL_14.2 (A)
unnamed: BL_14.1 (K), BL_15.2 (A)
unnamed: BL_15.1 (K), BL_16.2 (A)
unnamed: BL_17.1 (K), BL_18.2 (A)
unnamed: BL_18.1 (K), BL_19.2 (A)
unnamed: BL_19.1 (K), BL_20.2 (A)
unnamed: BL_21.1 (K), BL_22.2 (A)
unnamed: BL_22.1 (K), BL_23.2 (A)
unnamed: BL_23.1 (K), BL_24.2 (A)
unnamed: BL_25.1 (K), BL_26.2 (A)
unnamed: BL_26.1 (K), BL_27.2 (A)
unnamed: BL_27.1 (K), BL_28.2 (A)
unnamed: R1.1, U1.15 (R-EXT)
OSH_CLOCK: U1.3 (CLK), U2.2 (D0/RX)
OSH_DIN: U1.2 (SDI), U2.1 (D1/TX)
OSH_LATCH: U1.4 (LE(ED1)), U2.5 (D2)
OUT_BRT_BACK: U1.13 (~OE(ED2)), U2.6 (~D3)
POT_GAIN: RV_GAIN1.2, U2.17 (D18/A0)
POT_TILT: RV_TILT1.2, U2.20 (D21/A3)
RSW_MAP: RSW_MODE1.4, U2.7 (D4/A6)
RSW_TURB: RSW_MODE1.3, U2.8 (~D5)
RSW_WX: RSW_MODE1.1, U2.9 (~D6/A7)
RSW_WX+T: RSW_MODE1.2, U2.10 (D7)
SW_GCS_AUTO: SW_GCS1.3 (C), U2.18 (D19/A1)
SW_GCS_OFF: SW_GCS1.1 (A), U2.19 (D20/A2)
SW_MULTISCANS_AUTO: SW_MULTISCANS1.3 (C), U2.15 (D14)
SW_MULTISCANS_MAN: SW_MULTISCANS1.1 (A), U2.16 (D15)
SW_PWS_OFF: SW_PWS1.1 (A), U2.14 (D16)
SW_RWY_AUTO: SW_PWS1.3 (C), U2.13 (~D10/A10)
SW_SYS_1: SW_SYS1.1, U2.12 (~D9/A9)
SW_SYS_2: SW_SYS1.3 (4), U2.11 (D8/A8)

Notes on the sheet:
POT_TILT
Integral lighting behind the front panel
Potentiometer
Switches
Arduino
Rotary switch
Backlighting
POT_GAIN
Backlight
Lighting Control
External Power (12V)

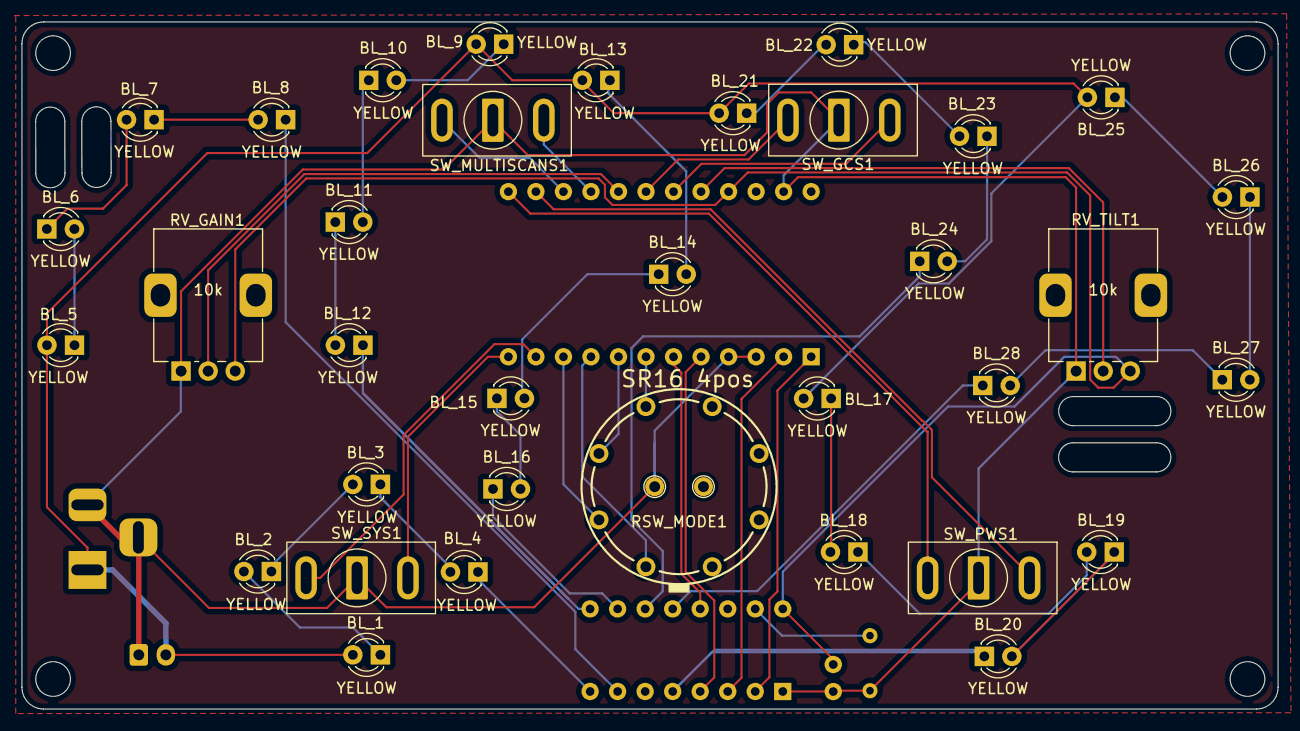
[picture p55: board RADAR.kicad_pcb from above]

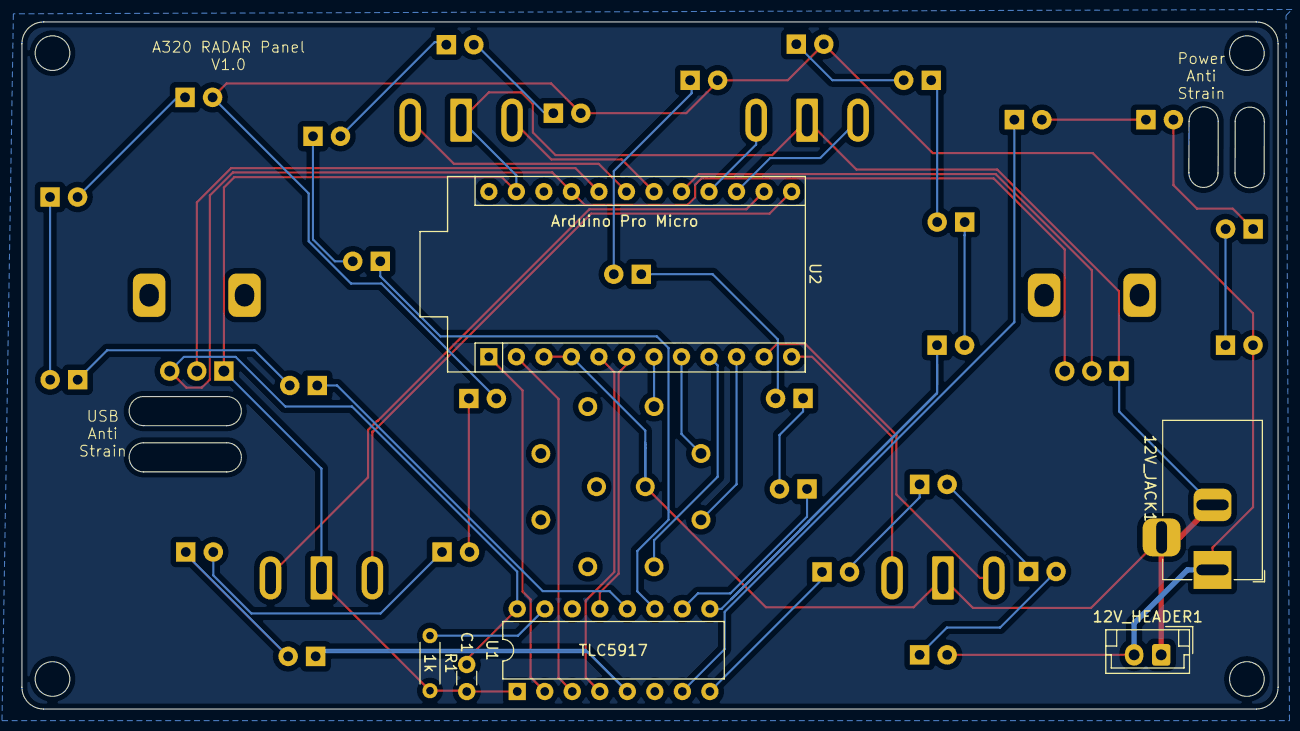
[picture p56: board RADAR.kicad_pcb from below]

Board: 2 copper layers, 115.9 x 63.4 mm, 41 parts (6 on the bottom side), 50 nets.
