SK-MH/A320-PCBs/2 - GLARE SHIELD/2.7 WARNING Right/KiCAD/WARNING_RIGHT.kicad_pcb

## KiCad design 2 - GLARE SHIELD/2.7 WARNING Right/KiCAD/WARNING_RIGHT.kicad_pcb (2025-01-06)

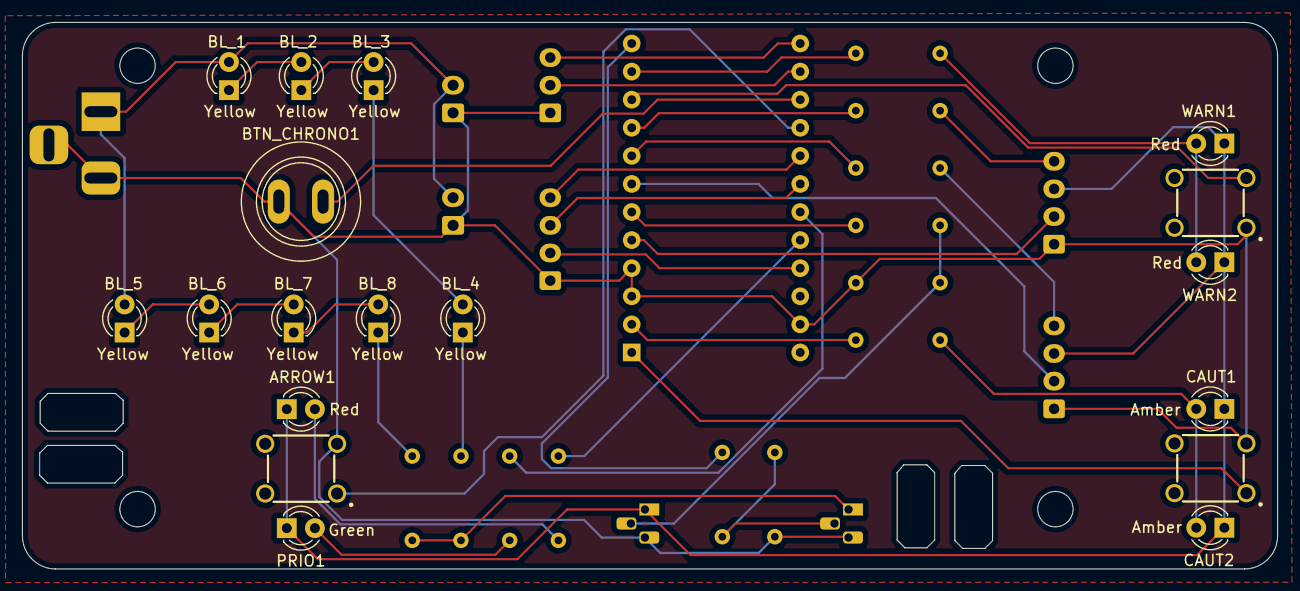
[picture p57: board WARNING_RIGHT.kicad_pcb from above]

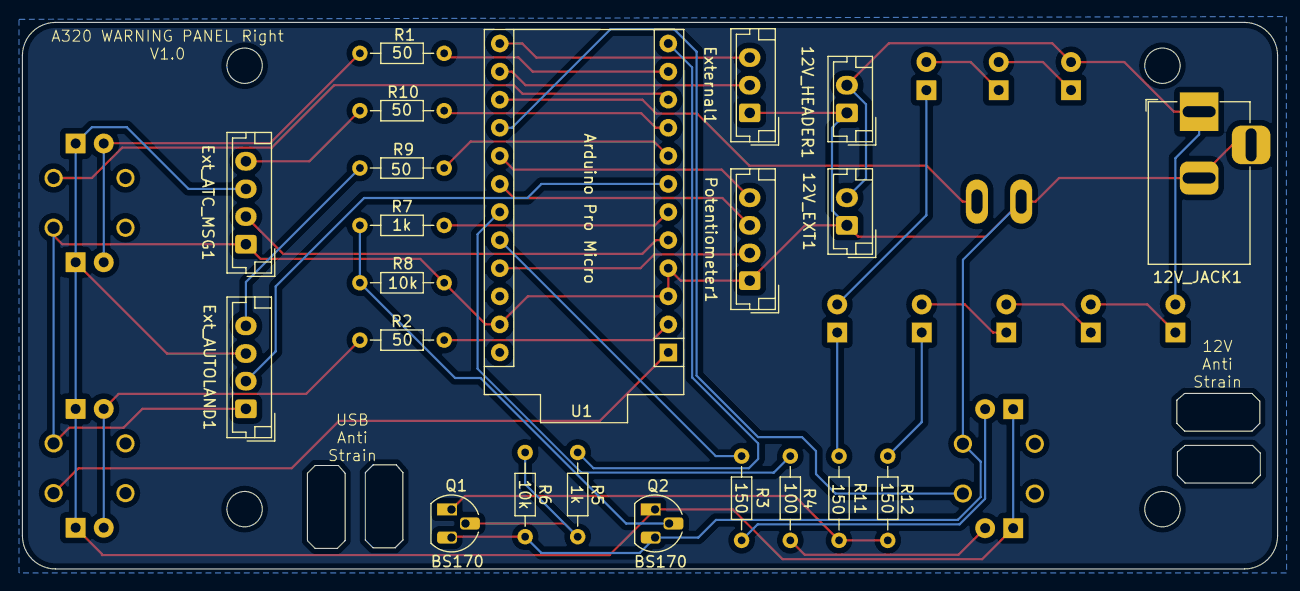
[picture p58: board WARNING_RIGHT.kicad_pcb from below]

Board: 2 copper layers, 113.5 x 49.4 mm, 40 parts (22 on the bottom side), 39 nets.

Parts:
12V_EXT1, 12V_HEADER1: Pin Header 1x02; JST_EH_B2B-EH-A_1x02_P2.50mm_Vertical
12V_JACK1: Power Jack; BarrelJack_Horizontal
ARROW1: Red; LED_D3.0mm
BL_1, BL_2, BL_3, BL_4, BL_5, BL_6, BL_7, BL_8: Yellow; LED_D3.0mm
BTN_CAUT1: B3F-1055; B3F1000
BTN_CHRONO1: Push Button; SW-Push
BTN_SIDESTICK1: B3F-1055; B3F1000
BTN_WARN1: B3F-1055; B3F1000
CAUT1, CAUT2: Amber; LED_D3.0mm
Ext_ATC_MSG1: Pin Header 1x04; JST_EH_B4B-EH-A_1x04_P2.50mm_Vertical
Ext_AUTOLAND1: Pin Header 1x04; JST_EH_B4B-EH-A_1x04_P2.50mm_Vertical
External1: Pin Header 1x03; JST_EH_B3B-EH-A_1x03_P2.50mm_Vertical
PRIO1: Green; LED_D3.0mm
Potentiometer1: Pin Header 1x04; JST_EH_B4B-EH-A_1x04_P2.50mm_Vertical
Q1, Q2: BS170; TO-92_HandSolder
R1, R2, R9, R10: 50; R_Axial_DIN0204_L3.6mm_D1.6mm_P7.62mm_Horizontal
R3, R11, R12: 150; R_Axial_DIN0204_L3.6mm_D1.6mm_P7.62mm_Horizontal
R4: 100; R_Axial_DIN0204_L3.6mm_D1.6mm_P7.62mm_Horizontal
R5, R7: 1k; R_Axial_DIN0204_L3.6mm_D1.6mm_P7.62mm_Horizontal
R6, R8: 10k; R_Axial_DIN0204_L3.6mm_D1.6mm_P7.62mm_Horizontal
U1: Arduino Pro Micro; Sparkfun_Pro_Micro
WARN1, WARN2: Red; LED_D3.0mm

Connections:
12V_IN: 12V_EXT1.2, 12V_HEADER1.2, 12V_JACK1.1, BL_1.2 (A), BL_5.2 (A)
+5V: Potentiometer1.2, U1.21 (VCC)
ARROW: R3.1, U1.20 (D21/A3)
ATC_MSG: R10.2, U1.9 (~D6/A7)
AUTOLAND: R9.2, U1.8 (~D5)
BACKLIGHT_GND: Q1.1 (D), R11.2, R12.2
BTN_ATC_MSG: Ext_ATC_MSG1.2, U1.5 (D2)
BTN_AUTOLAND: Ext_AUTOLAND1.2, U1.7 (D4/A6)
BTN_CAUT: BTN_CAUT1.1, U1.1 (D1/TX)
BTN_CHRONO: BTN_CHRONO1.1, U1.15 (D14)
BTN_SIDESTICK: BTN_SIDESTICK1.1, U1.16 (D15)
BTN_WARN: BTN_WARN1.3, U1.10 (D7)
CAUT: R2.1, U1.2 (D0/RX)
EXT1: External1.2, U1.14 (D16)
EXT2: External1.3, U1.13 (~D10/A10)
GND: 12V_EXT1.1, 12V_HEADER1.1, 12V_JACK1.2, 12V_JACK1.3, BTN_CAUT1.3, BTN_CHRONO1.2, BTN_SIDESTICK1.3, BTN_WARN1.1, Ext_ATC_MSG1.1, Ext_AUTOLAND1.1, External1.1, Potentiometer1.1, Q1.3 (S), Q2.3 (S), R6.1, R8.1, U1.3 (GND), U1.4 (GND), U1.23 (GND)
LED_GND: ARROW1.1 (K), CAUT1.1 (K), CAUT2.1 (K), Ext_ATC_MSG1.3, Ext_AUTOLAND1.3, PRIO1.1 (K), Q2.1 (D), WARN1.1 (K), WARN2.1 (K)
unnamed: ARROW1.2 (A), R3.2
unnamed: BL_1.1 (K), BL_2.2 (A)
unnamed: BL_2.1 (K), BL_3.2 (A)
unnamed: BL_3.1 (K), BL_4.2 (A)
unnamed: BL_4.1 (K), R11.1
unnamed: BL_5.1 (K), BL_6.2 (A)
unnamed: BL_6.1 (K), BL_7.2 (A)
unnamed: BL_7.1 (K), BL_8.2 (A)
unnamed: BL_8.1 (K), R12.1
unnamed: CAUT1.2 (A), CAUT2.2 (A), R2.2
unnamed: Ext_ATC_MSG1.4, R10.1
unnamed: Ext_AUTOLAND1.4, R9.1
unnamed: PRIO1.2 (A), R4.2
unnamed: Q1.2 (G), R5.2, R6.2
unnamed: Q2.2 (G), R7.2, R8.2
unnamed: R1.2, WARN1.2 (A), WARN2.2 (A)
OUT_BRT_BACK: R5.1, U1.12 (~D9/A9)
OUT_BRT_LED: R7.1, U1.6 (~D3)
POT1: Potentiometer1.3, U1.18 (D19/A1)
POT2: Potentiometer1.4, U1.17 (D18/A0)
PRIO: R4.1, U1.19 (D20/A2)
WARN: R1.1, U1.11 (D8/A8)
