SK-MH/A320-PCBs/4 - PEDESTAL/4.13 ATC & TCAS/KiCAD/TCAS neu.kicad_pcb

## KiCad design 4 - PEDESTAL/4.13 ATC & TCAS/KiCAD/TCAS neu.kicad_pcb (2025-01-06)

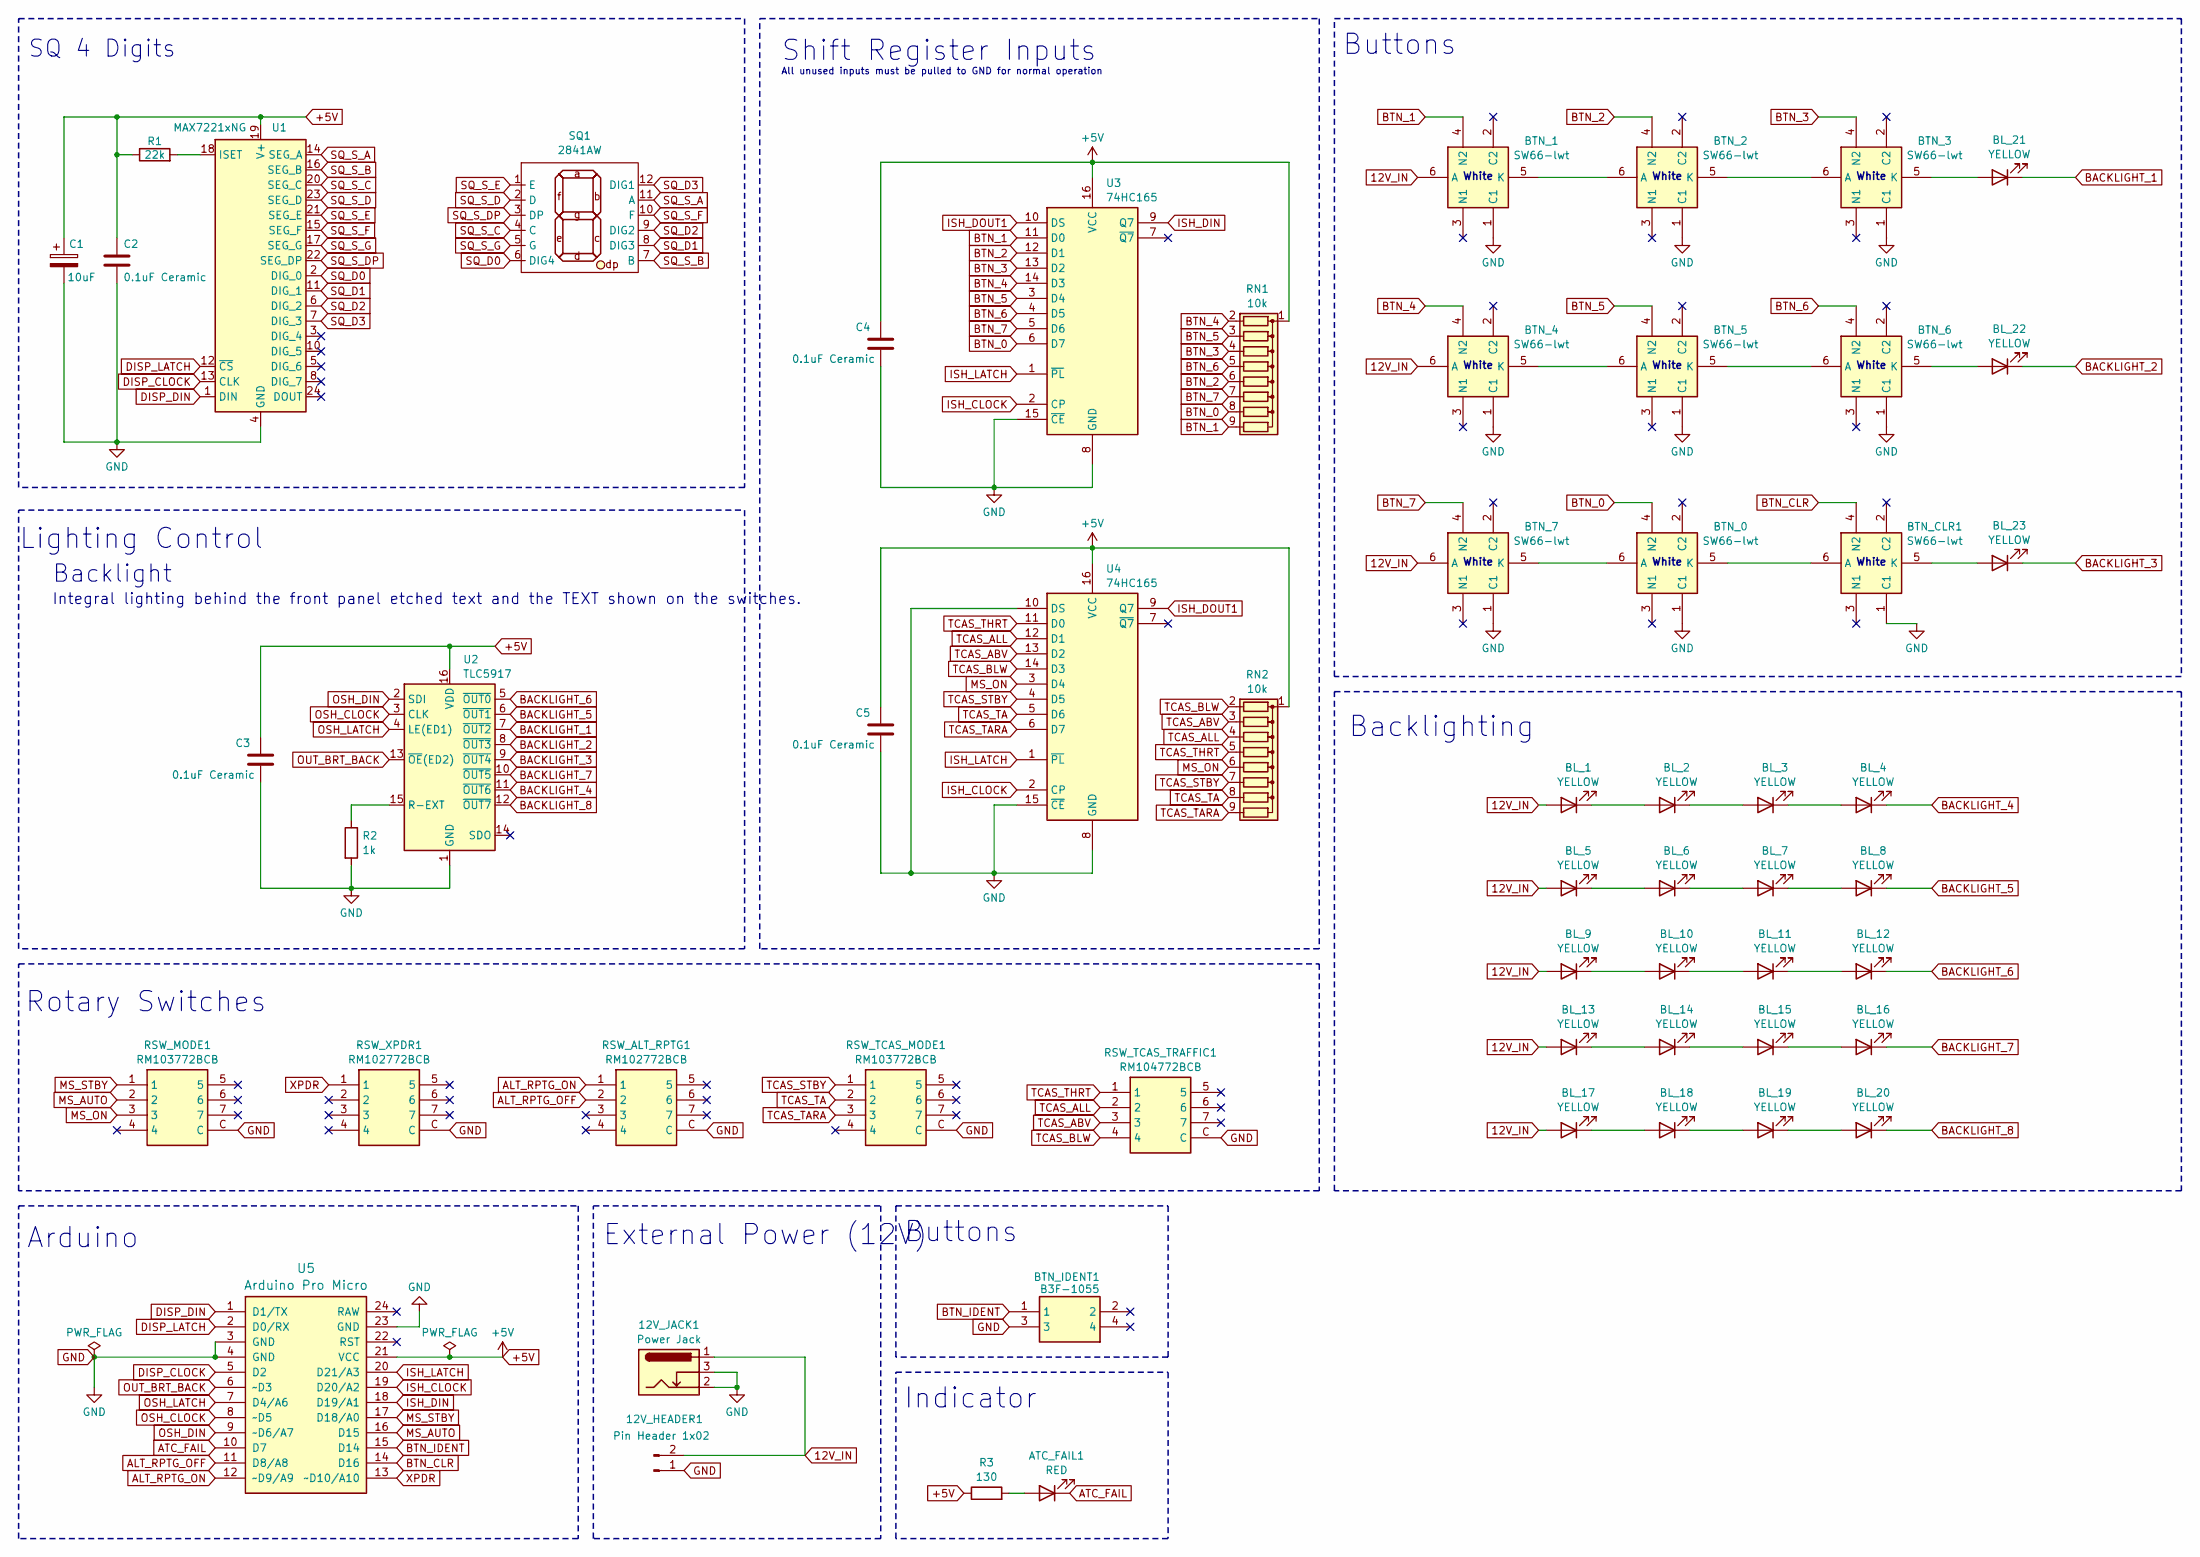
[picture p59: schematic TCAS neu.kicad_sch, A320 ATC-TCAS]

Parts:
12V_HEADER1: Pin Header 1x02; JST_EH_B2B-EH-A_1x02_P2.50mm_Vertical
12V_JACK1: Power Jack; BarrelJack_Horizontal
ATC_FAIL1: RED; LED_D3.0mm
BL_1, BL_2, BL_3, BL_4, BL_5, BL_6, BL_7, BL_8, BL_9, BL_10, BL_11, BL_12, BL_13, BL_14, BL_15, BL_16, BL_17, BL_18, BL_19, BL_20, BL_21, BL_22, BL_23: YELLOW; LED_D3.0mm
BTN_0, BTN_1, BTN_2, BTN_3, BTN_4, BTN_5, BTN_6, BTN_7: SW66-lwt
BTN_CLR1: SW66-lwt
BTN_IDENT1: B3F-1055; B3F1000; Mouser Part Number 653-B3F-1055
C1: 10uF; CP_Radial_D4.0mm_P1.50mm
C2, C3, C4, C5: 0.1uF Ceramic; C_Disc_D3.0mm_W1.6mm_P2.50mm
R1: 22k; R_Axial_DIN0204_L3.6mm_D1.6mm_P7.62mm_Horizontal
R2: 1k; R_Axial_DIN0204_L3.6mm_D1.6mm_P7.62mm_Horizontal
R3: 130; R_Axial_DIN0204_L3.6mm_D1.6mm_P7.62mm_Horizontal
RN1, RN2: 10k; R_Array_SIP9
RSW_ALT_RPTG1: RM102772BCB; myRM103772BCB; Mouser Part Number 611-RM103772BCB
RSW_MODE1: RM103772BCB; myRM103772BCB; Mouser Part Number 611-RM103772BCB
RSW_TCAS_MODE1: RM103772BCB; myRM103772BCB; Mouser Part Number 611-RM103772BCB
RSW_TCAS_TRAFFIC1: RM104772BCB; myRM103772BCB; Mouser Part Number 611-RM103772BCB
RSW_XPDR1: RM102772BCB; myRM103772BCB; Mouser Part Number 611-RM103772BCB
SQ1: 2841AW
U1: MAX7221xNG; DIP-24_W7.62mm
U2: TLC5917; DIP-16_W7.62mm
U3, U4: 74HC165; DIP-16_W7.62mm
U5: Arduino Pro Micro; Sparkfun_Pro_Micro

Connections:
12V_IN: 12V_HEADER1.2, 12V_JACK1.1, BL_1.2 (A), BL_5.2 (A), BL_9.2 (A), BL_13.2 (A), BL_17.2 (A), BTN_1.6 (A), BTN_4.6 (A), BTN_7.6 (A)
+5V: C1.1, C2.1, C3.1, C4.1, C5.1, R1.1, R3.1, RN1.1 (common), RN2.1 (common), U1.19 (V+), U2.16 (VDD), U3.16 (VCC), U4.16 (VCC), U5.21 (VCC)
ALT_RPTG_OFF: RSW_ALT_RPTG1.2, U5.11 (D8/A8)
ALT_RPTG_ON: RSW_ALT_RPTG1.1, U5.12 (~D9/A9)
ATC_FAIL: ATC_FAIL1.1 (K), U5.10 (D7)
BACKLIGHT_1: BL_21.1 (K), U2.7 (~OUT2)
BACKLIGHT_2: BL_22.1 (K), U2.8 (~OUT3)
BACKLIGHT_3: BL_23.1 (K), U2.9 (~OUT4)
BACKLIGHT_4: BL_4.1 (K), U2.11 (~OUT6)
BACKLIGHT_5: BL_8.1 (K), U2.6 (~OUT1)
BACKLIGHT_6: BL_12.1 (K), U2.5 (~OUT0)
BACKLIGHT_7: BL_16.1 (K), U2.10 (~OUT5)
BACKLIGHT_8: BL_20.1 (K), U2.12 (~OUT7)
BTN_0: BTN_0.4 (N2), RN1.8 (R7), U3.6 (D7)
BTN_1: BTN_1.4 (N2), RN1.9 (R8), U3.11 (D0)
BTN_2: BTN_2.4 (N2), RN1.6 (R5), U3.12 (D1)
BTN_3: BTN_3.4 (N2), RN1.4 (R3), U3.13 (D2)
BTN_4: BTN_4.4 (N2), RN1.2 (R1), U3.14 (D3)
BTN_5: BTN_5.4 (N2), RN1.3 (R2), U3.3 (D4)
BTN_6: BTN_6.4 (N2), RN1.5 (R4), U3.4 (D5)
BTN_7: BTN_7.4 (N2), RN1.7 (R6), U3.5 (D6)
BTN_CLR: BTN_CLR1.4 (N2), U5.14 (D16)
BTN_IDENT: BTN_IDENT1.1, U5.15 (D14)
DISP_CLOCK: U1.13 (CLK), U5.5 (D2)
DISP_DIN: U1.1 (DIN), U5.1 (D1/TX)
DISP_LATCH: U1.12 (~CS), U5.2 (D0/RX)
GND: 12V_HEADER1.1, 12V_JACK1.2, 12V_JACK1.3, BTN_0.1 (C1), BTN_1.1 (C1), BTN_2.1 (C1), BTN_3.1 (C1), BTN_4.1 (C1), BTN_5.1 (C1), BTN_6.1 (C1), BTN_7.1 (C1), BTN_CLR1.1 (C1), BTN_IDENT1.3, C1.2, C2.2, C3.2, C4.2, C5.2, R2.2, RSW_ALT_RPTG1.C, RSW_MODE1.C, RSW_TCAS_MODE1.C, RSW_TCAS_TRAFFIC1.C, RSW_XPDR1.C, U1.4 (GND), U1.9 (GND), U2.1 (GND), U3.8 (GND), U3.15 (~CE), U4.8 (GND), U4.10 (DS), U4.15 (~CE), U5.3 (GND), U5.4 (GND), U5.23 (GND)
ISH_CLOCK: U3.2 (CP), U4.2 (CP), U5.19 (D20/A2)
ISH_DIN: U3.9 (Q7), U5.18 (D19/A1)
ISH_DOUT1: U3.10 (DS), U4.9 (Q7)
ISH_LATCH: U3.1 (~PL), U4.1 (~PL), U5.20 (D21/A3)
MS_AUTO: RSW_MODE1.2, U5.16 (D15)
MS_ON: RN2.6 (R5), RSW_MODE1.3, U4.3 (D4)
MS_STBY: RSW_MODE1.1, U5.17 (D18/A0)
unnamed: ATC_FAIL1.2 (A), R3.2
unnamed: BL_1.1 (K), BL_2.2 (A)
unnamed: BL_2.1 (K), BL_3.2 (A)
unnamed: BL_3.1 (K), BL_4.2 (A)
unnamed: BL_5.1 (K), BL_6.2 (A)
unnamed: BL_6.1 (K), BL_7.2 (A)
unnamed: BL_7.1 (K), BL_8.2 (A)
unnamed: BL_9.1 (K), BL_10.2 (A)
unnamed: BL_10.1 (K), BL_11.2 (A)
unnamed: BL_11.1 (K), BL_12.2 (A)
unnamed: BL_13.1 (K), BL_14.2 (A)
unnamed: BL_14.1 (K), BL_15.2 (A)
unnamed: BL_15.1 (K), BL_16.2 (A)
unnamed: BL_17.1 (K), BL_18.2 (A)
unnamed: BL_18.1 (K), BL_19.2 (A)
unnamed: BL_19.1 (K), BL_20.2 (A)
unnamed: BL_21.2 (A), BTN_3.5 (K)
unnamed: BL_22.2 (A), BTN_6.5 (K)
unnamed: BL_23.2 (A), BTN_CLR1.5 (K)
unnamed: BTN_0.6 (A), BTN_7.5 (K)
unnamed: BTN_0.5 (K), BTN_CLR1.6 (A)
unnamed: BTN_1.5 (K), BTN_2.6 (A)
unnamed: BTN_2.5 (K), BTN_3.6 (A)
unnamed: BTN_4.5 (K), BTN_5.6 (A)
unnamed: BTN_5.5 (K), BTN_6.6 (A)
unnamed: R1.2, U1.18 (ISET)
unnamed: R2.1, U2.15 (R-EXT)
OSH_CLOCK: U2.3 (CLK), U5.8 (~D5)
OSH_DIN: U2.2 (SDI), U5.9 (~D6/A7)
OSH_LATCH: U2.4 (LE(ED1)), U5.7 (D4/A6)
OUT_BRT_BACK: U2.13 (~OE(ED2)), U5.6 (~D3)
SQ_D0: SQ1.6 (DIG4), U1.2 (DIG_0)
SQ_D1: SQ1.8 (DIG3), U1.11 (DIG_1)
SQ_D2: SQ1.9 (DIG2), U1.6 (DIG_2)
SQ_D3: SQ1.12 (DIG1), U1.7 (DIG_3)
SQ_S_A: SQ1.11 (A), U1.14 (SEG_A)
SQ_S_B: SQ1.7 (B), U1.16 (SEG_B)
SQ_S_C: SQ1.4 (C), U1.20 (SEG_C)
SQ_S_D: SQ1.2 (D), U1.23 (SEG_D)
SQ_S_DP: SQ1.3 (DP), U1.22 (SEG_DP)
SQ_S_E: SQ1.1 (E), U1.21 (SEG_E)
SQ_S_F: SQ1.10 (F), U1.15 (SEG_F)
SQ_S_G: SQ1.5 (G), U1.17 (SEG_G)
TCAS_ABV: RN2.3 (R2), RSW_TCAS_TRAFFIC1.3, U4.13 (D2)
TCAS_ALL: RN2.4 (R3), RSW_TCAS_TRAFFIC1.2, U4.12 (D1)
TCAS_BLW: RN2.2 (R1), RSW_TCAS_TRAFFIC1.4, U4.14 (D3)
TCAS_STBY: RN2.7 (R6), RSW_TCAS_MODE1.1, U4.4 (D5)
TCAS_TA: RN2.8 (R7), RSW_TCAS_MODE1.2, U4.5 (D6)
TCAS_TARA: RN2.9 (R8), RSW_TCAS_MODE1.3, U4.6 (D7)
TCAS_THRT: RN2.5 (R4), RSW_TCAS_TRAFFIC1.1, U4.11 (D0)
XPDR: RSW_XPDR1.1, U5.13 (~D10/A10)

Notes on the sheet:
White
Shift Register Inputs
Indicator
External Power (12V)
Integral lighting behind the front panel etched text and the TEXT shown on the switches.
Rotary Switches
SQ 4 Digits
All unused inputs must be pulled to GND for normal operation
Backlight
Buttons
Backlighting
Lighting Control
Arduino

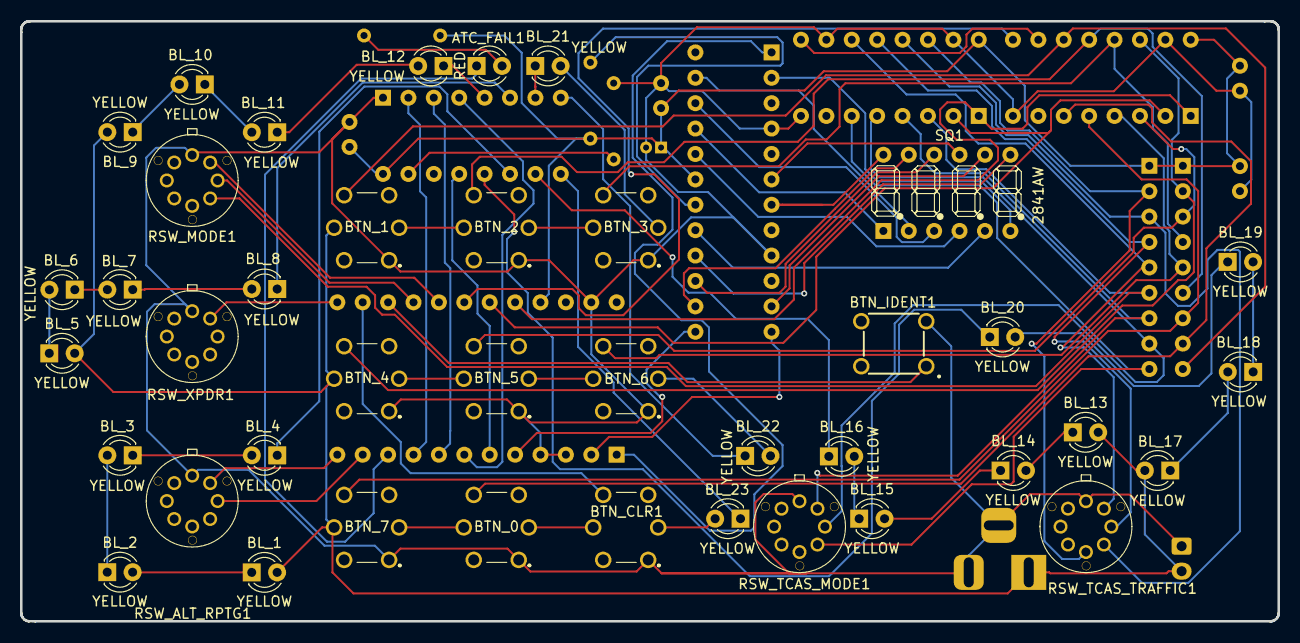
[picture p60: board TCAS neu.kicad_pcb from above]

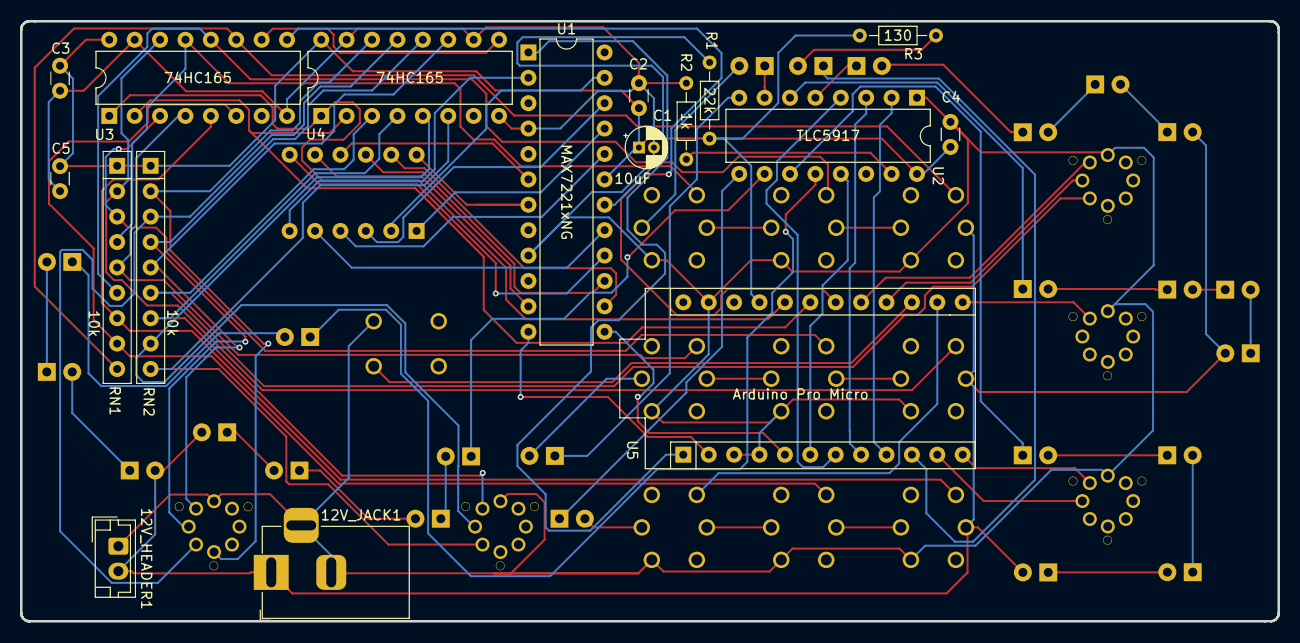
[picture p61: board TCAS neu.kicad_pcb from below]

Board: 2 copper layers, 125.8 x 60.0 mm, 57 parts (17 on the bottom side), 85 nets.
