SK-MH/A320-PCBs/2 - GLARE SHIELD/2.3 EFIS Left/KiCAD/EFIS_Left.kicad_pcb

## KiCad design 2 - GLARE SHIELD/2.3 EFIS Left/KiCAD/EFIS_Left.kicad_pcb (2025-01-06)

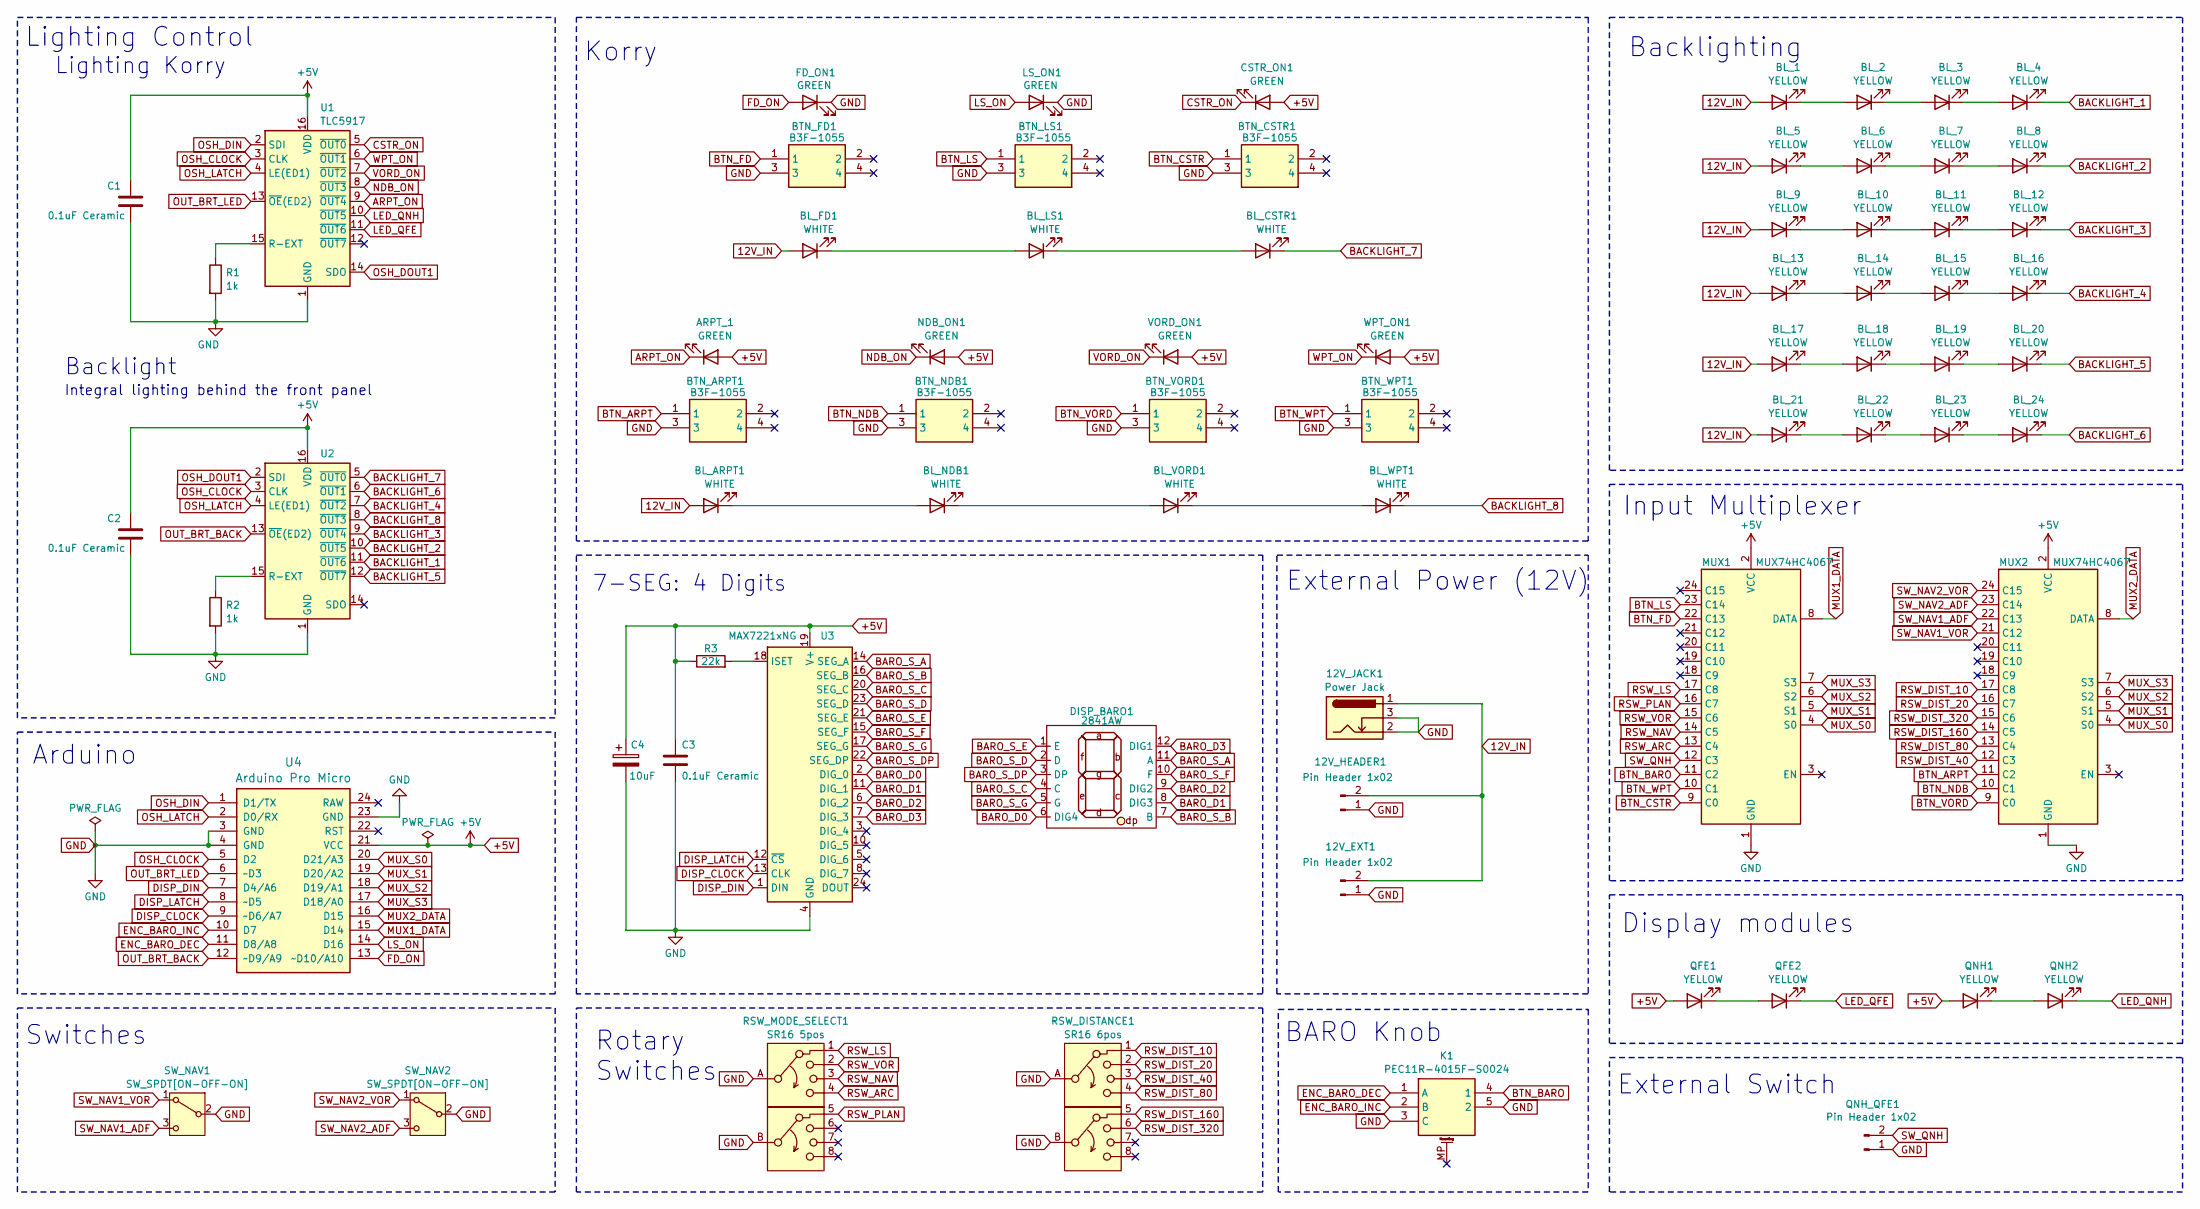
[picture p62: schematic EFIS_Left.kicad_sch, EFIS Panel Left]

Parts:
12V_EXT1, 12V_HEADER1: Pin Header 1x02; JST_EH_B2B-EH-A_1x02_P2.50mm_Vertical
12V_JACK1: Power Jack; BarrelJack_Horizontal
ARPT_1: GREEN; LED_D3.0mm
BL_1, BL_2, BL_3, BL_4, BL_5, BL_6, BL_7, BL_8, BL_9, BL_10, BL_11, BL_12, BL_13, BL_14, BL_15, BL_16, BL_17, BL_18, BL_19, BL_20, BL_21, BL_22, BL_23, BL_24: YELLOW; LED_D3.0mm
BL_ARPT1: WHITE; LED_D3.0mm
BL_CSTR1: WHITE; LED_D3.0mm
BL_FD1: WHITE; LED_D3.0mm
BL_LS1: WHITE; LED_D3.0mm
BL_NDB1: WHITE; LED_D3.0mm
BL_VORD1: WHITE; LED_D3.0mm
BL_WPT1: WHITE; LED_D3.0mm
BTN_ARPT1: B3F-1055; B3F1000; Mouser Part Number 653-B3F-1055
BTN_CSTR1: B3F-1055; B3F1000; Mouser Part Number 653-B3F-1055
BTN_FD1: B3F-1055; B3F1000; Mouser Part Number 653-B3F-1055
BTN_LS1: B3F-1055; B3F1000; Mouser Part Number 653-B3F-1055
BTN_NDB1: B3F-1055; B3F1000; Mouser Part Number 653-B3F-1055
BTN_VORD1: B3F-1055; B3F1000; Mouser Part Number 653-B3F-1055
BTN_WPT1: B3F-1055; B3F1000; Mouser Part Number 653-B3F-1055
C1, C2, C3: 0.1uF Ceramic; C_Disc_D3.0mm_W1.6mm_P2.50mm
C4: 10uF; CP_Radial_D4.0mm_P1.50mm
CSTR_ON1: GREEN; LED_D3.0mm
DISP_BARO1: 2841AW
FD_ON1: GREEN; LED_D3.0mm
K1: PEC11R-4015F-S0024; PEC12R-4XXXF-SXXXX_1; Mouser Part Number 652-PEC11R-4015F-S24
LS_ON1: GREEN; LED_D3.0mm
MUX1, MUX2: MUX74HC4067
NDB_ON1: GREEN; LED_D3.0mm
QFE1, QFE2: YELLOW; LED_D3.0mm
QNH1, QNH2: YELLOW; LED_D3.0mm
QNH_QFE1: Pin Header 1x02; JST_EH_B2B-EH-A_1x02_P2.50mm_Vertical
R1, R2: 1k; R_Axial_DIN0204_L3.6mm_D1.6mm_P7.62mm_Horizontal
R3: 22k; R_Axial_DIN0204_L3.6mm_D1.6mm_P7.62mm_Horizontal
RSW_DISTANCE1: SR16 6pos; SR16-AB
RSW_MODE_SELECT1: SR16 5pos; SR16-AB
SW_NAV1, SW_NAV2: SW_SPDT[ON-OFF-ON]; T80-Z1
U1, U2: TLC5917; DIP-16_W7.62mm
U3: MAX7221xNG; DIP-24_W7.62mm
U4: Arduino Pro Micro; Sparkfun_Pro_Micro
VORD_ON1: GREEN; LED_D3.0mm
WPT_ON1: GREEN; LED_D3.0mm

Connections:
12V_IN: 12V_EXT1.2, 12V_HEADER1.2, 12V_JACK1.1, BL_1.2 (A), BL_5.2 (A), BL_9.2 (A), BL_13.2 (A), BL_17.2 (A), BL_21.2 (A), BL_ARPT1.2 (A), BL_FD1.2 (A)
+5V: ARPT_1.2 (A), C1.1, C2.1, C3.1, C4.1, CSTR_ON1.2 (A), MUX1.2 (VCC), MUX2.2 (VCC), NDB_ON1.2 (A), QFE1.2 (A), QNH1.2 (A), R3.1, U1.16 (VDD), U2.16 (VDD), U3.19 (V+), U4.21 (VCC), VORD_ON1.2 (A), WPT_ON1.2 (A)
ARPT_ON: ARPT_1.1 (K), U1.9 (~OUT4)
BACKLIGHT_1: BL_4.1 (K), U2.11 (~OUT6)
BACKLIGHT_2: BL_8.1 (K), U2.10 (~OUT5)
BACKLIGHT_3: BL_12.1 (K), U2.9 (~OUT4)
BACKLIGHT_4: BL_16.1 (K), U2.7 (~OUT2)
BACKLIGHT_5: BL_20.1 (K), U2.12 (~OUT7)
BACKLIGHT_6: BL_24.1 (K), U2.6 (~OUT1)
BACKLIGHT_7: BL_CSTR1.1 (K), U2.5 (~OUT0)
BACKLIGHT_8: BL_WPT1.1 (K), U2.8 (~OUT3)
BARO_D0: DISP_BARO1.6 (DIG4), U3.2 (DIG_0)
BARO_D1: DISP_BARO1.8 (DIG3), U3.11 (DIG_1)
BARO_D2: DISP_BARO1.9 (DIG2), U3.6 (DIG_2)
BARO_D3: DISP_BARO1.12 (DIG1), U3.7 (DIG_3)
BARO_S_A: DISP_BARO1.11 (A), U3.14 (SEG_A)
BARO_S_B: DISP_BARO1.7 (B), U3.16 (SEG_B)
BARO_S_C: DISP_BARO1.4 (C), U3.20 (SEG_C)
BARO_S_D: DISP_BARO1.2 (D), U3.23 (SEG_D)
BARO_S_DP: DISP_BARO1.3 (DP), U3.22 (SEG_DP)
BARO_S_E: DISP_BARO1.1 (E), U3.21 (SEG_E)
BARO_S_F: DISP_BARO1.10 (F), U3.15 (SEG_F)
BARO_S_G: DISP_BARO1.5 (G), U3.17 (SEG_G)
BTN_ARPT: BTN_ARPT1.1, MUX2.11 (C2)
BTN_BARO: K1.4 (1), MUX1.11 (C2)
BTN_CSTR: BTN_CSTR1.1, MUX1.9 (C0)
BTN_FD: BTN_FD1.1, MUX1.22 (C13)
BTN_LS: BTN_LS1.1, MUX1.23 (C14)
BTN_NDB: BTN_NDB1.1, MUX2.10 (C1)
BTN_VORD: BTN_VORD1.1, MUX2.9 (C0)
BTN_WPT: BTN_WPT1.1, MUX1.10 (C1)
CSTR_ON: CSTR_ON1.1 (K), U1.5 (~OUT0)
DISP_CLOCK: U3.13 (CLK), U4.9 (~D6/A7)
DISP_DIN: U3.1 (DIN), U4.7 (D4/A6)
DISP_LATCH: U3.12 (~CS), U4.8 (~D5)
ENC_BARO_DEC: K1.1 (A), U4.11 (D8/A8)
ENC_BARO_INC: K1.2 (B), U4.10 (D7)
FD_ON: FD_ON1.2 (A), U4.13 (~D10/A10)
GND: 12V_EXT1.1, 12V_HEADER1.1, 12V_JACK1.2, 12V_JACK1.3, BTN_ARPT1.3, BTN_CSTR1.3, BTN_FD1.3, BTN_LS1.3, BTN_NDB1.3, BTN_VORD1.3, BTN_WPT1.3, C1.2, C2.2, C3.2, C4.2, FD_ON1.1 (K), K1.3 (C), K1.5 (2), LS_ON1.1 (K), MUX1.1 (GND), MUX2.1 (GND), QNH_QFE1.1, R1.2, R2.2, RSW_DISTANCE1.A, RSW_DISTANCE1.B, RSW_MODE_SELECT1.A, RSW_MODE_SELECT1.B, SW_NAV1.2 (B), SW_NAV2.2 (B), U1.1 (GND), U2.1 (GND), U3.4 (GND), U3.9 (GND), U4.3 (GND), U4.4 (GND), U4.23 (GND)
LED_QFE: QFE2.1 (K), U1.11 (~OUT6)
LED_QNH: QNH2.1 (K), U1.10 (~OUT5)
LS_ON: LS_ON1.2 (A), U4.14 (D16)
MUX1_DATA: MUX1.8 (DATA), U4.15 (D14)
MUX2_DATA: MUX2.8 (DATA), U4.16 (D15)
MUX_S0: MUX1.4 (S0), MUX2.4 (S0), U4.20 (D21/A3)
MUX_S1: MUX1.5 (S1), MUX2.5 (S1), U4.19 (D20/A2)
MUX_S2: MUX1.6 (S2), MUX2.6 (S2), U4.18 (D19/A1)
MUX_S3: MUX1.7 (S3), MUX2.7 (S3), U4.17 (D18/A0)
NDB_ON: NDB_ON1.1 (K), U1.8 (~OUT3)
unnamed: BL_1.1 (K), BL_2.2 (A)
unnamed: BL_2.1 (K), BL_3.2 (A)
unnamed: BL_3.1 (K), BL_4.2 (A)
unnamed: BL_5.1 (K), BL_6.2 (A)
unnamed: BL_6.1 (K), BL_7.2 (A)
unnamed: BL_7.1 (K), BL_8.2 (A)
unnamed: BL_9.1 (K), BL_10.2 (A)
unnamed: BL_10.1 (K), BL_11.2 (A)
unnamed: BL_11.1 (K), BL_12.2 (A)
unnamed: BL_13.1 (K), BL_14.2 (A)
unnamed: BL_14.1 (K), BL_15.2 (A)
unnamed: BL_15.1 (K), BL_16.2 (A)
unnamed: BL_17.1 (K), BL_18.2 (A)
unnamed: BL_18.1 (K), BL_19.2 (A)
unnamed: BL_19.1 (K), BL_20.2 (A)
unnamed: BL_21.1 (K), BL_22.2 (A)
unnamed: BL_22.1 (K), BL_23.2 (A)
unnamed: BL_23.1 (K), BL_24.2 (A)
unnamed: BL_ARPT1.1 (K), BL_NDB1.2 (A)
unnamed: BL_CSTR1.2 (A), BL_LS1.1 (K)
unnamed: BL_FD1.1 (K), BL_LS1.2 (A)
unnamed: BL_NDB1.1 (K), BL_VORD1.2 (A)
unnamed: BL_VORD1.1 (K), BL_WPT1.2 (A)
unnamed: QFE1.1 (K), QFE2.2 (A)
unnamed: QNH1.1 (K), QNH2.2 (A)
unnamed: R1.1, U1.15 (R-EXT)
unnamed: R2.1, U2.15 (R-EXT)
unnamed: R3.2, U3.18 (ISET)
OSH_CLOCK: U1.3 (CLK), U2.3 (CLK), U4.5 (D2)
OSH_DIN: U1.2 (SDI), U4.1 (D1/TX)
OSH_DOUT1: U1.14 (SDO), U2.2 (SDI)
OSH_LATCH: U1.4 (LE(ED1)), U2.4 (LE(ED1)), U4.2 (D0/RX)
OUT_BRT_BACK: U2.13 (~OE(ED2)), U4.12 (~D9/A9)
OUT_BRT_LED: U1.13 (~OE(ED2)), U4.6 (~D3)
RSW_ARC: MUX1.13 (C4), RSW_MODE_SELECT1.4
RSW_DIST_10: MUX2.17 (C8), RSW_DISTANCE1.1
RSW_DIST_20: MUX2.16 (C7), RSW_DISTANCE1.2
RSW_DIST_40: MUX2.12 (C3), RSW_DISTANCE1.3
RSW_DIST_80: MUX2.13 (C4), RSW_DISTANCE1.4
RSW_DIST_160: MUX2.14 (C5), RSW_DISTANCE1.5
RSW_DIST_320: MUX2.15 (C6), RSW_DISTANCE1.6
RSW_LS: MUX1.17 (C8), RSW_MODE_SELECT1.1
RSW_NAV: MUX1.14 (C5), RSW_MODE_SELECT1.3
RSW_PLAN: MUX1.16 (C7), RSW_MODE_SELECT1.5
RSW_VOR: MUX1.15 (C6), RSW_MODE_SELECT1.2
SW_NAV1_ADF: MUX2.22 (C13), SW_NAV1.3 (C)
SW_NAV1_VOR: MUX2.21 (C12), SW_NAV1.1 (A)
SW_NAV2_ADF: MUX2.23 (C14), SW_NAV2.3 (C)
SW_NAV2_VOR: MUX2.24 (C15), SW_NAV2.1 (A)
SW_QNH: MUX1.12 (C3), QNH_QFE1.2
VORD_ON: U1.7 (~OUT2), VORD_ON1.1 (K)
WPT_ON: U1.6 (~OUT1), WPT_ON1.1 (K)

Notes on the sheet:
Switches
Backlighting
7-SEG: 4 Digits
Arduino
BARO Knob
Display modules
Rotary Switches
Korry
External Switch
Input Multiplexer
External Power (12V)
Lighting Korry
Lighting Control
Integral lighting behind the front panel
Backlight

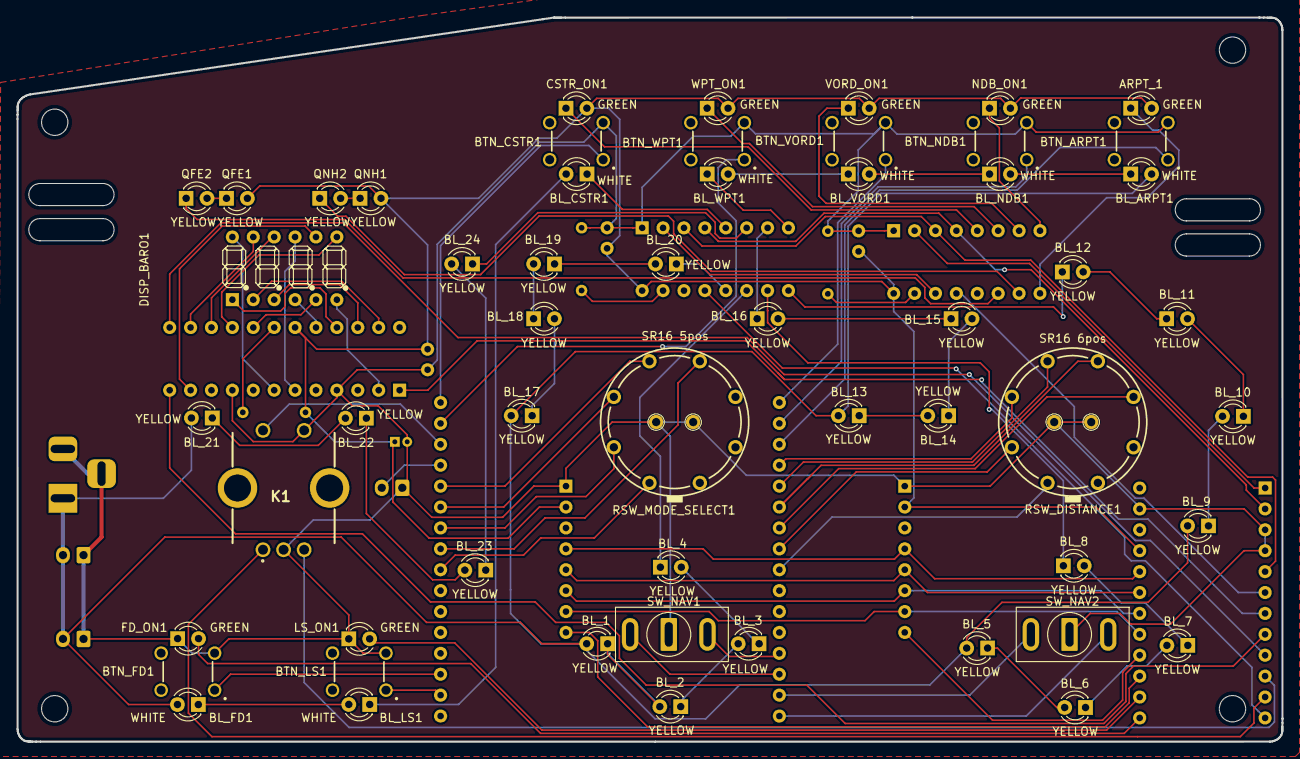
[picture p63: board EFIS_Left.kicad_pcb from above]

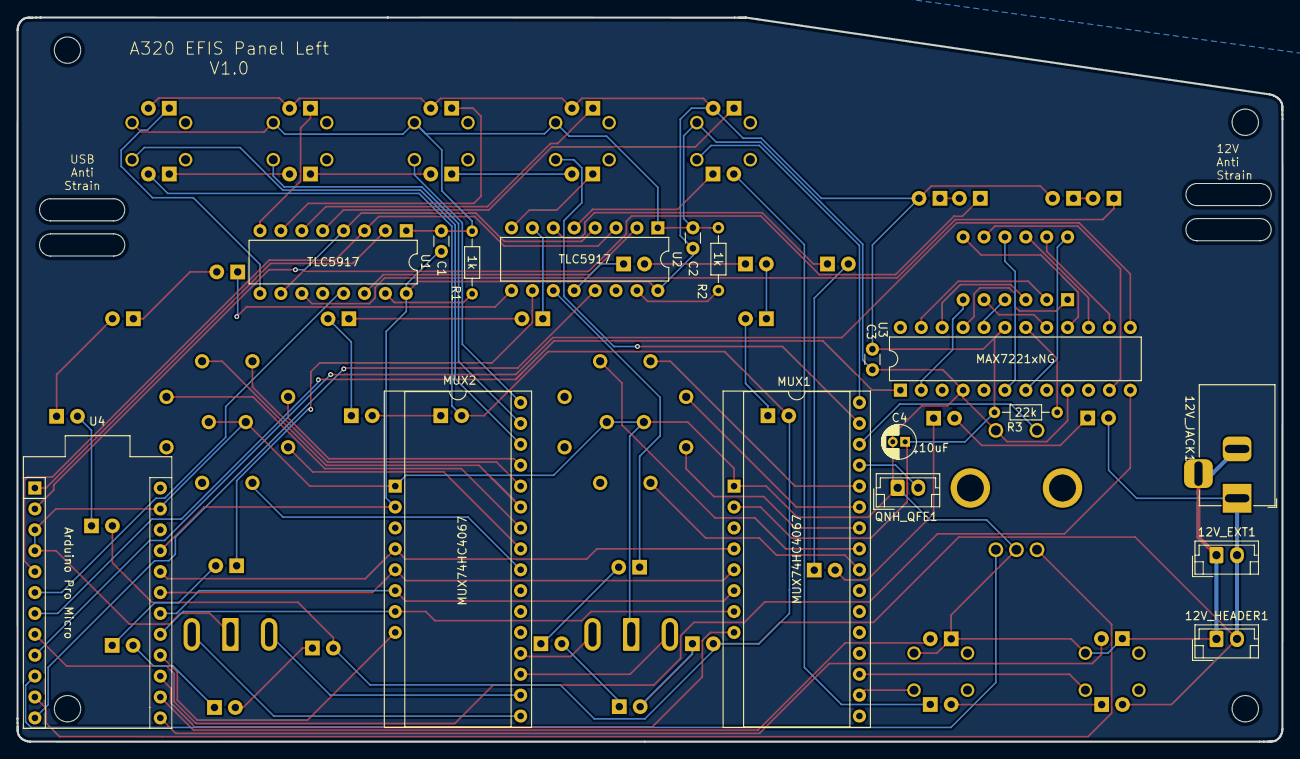
[picture p64: board EFIS_Left.kicad_pcb from below]

Board: 2 copper layers, 153.7 x 88.0 mm, 72 parts (17 on the bottom side), 101 nets.
