SK-MH/A320-PCBs/4 - PEDESTAL/4.7 ECAM/KiCAD/ECAM.kicad_pcb

## KiCad design 4 - PEDESTAL/4.7 ECAM/KiCAD/ECAM.kicad_pcb (2025-01-06)

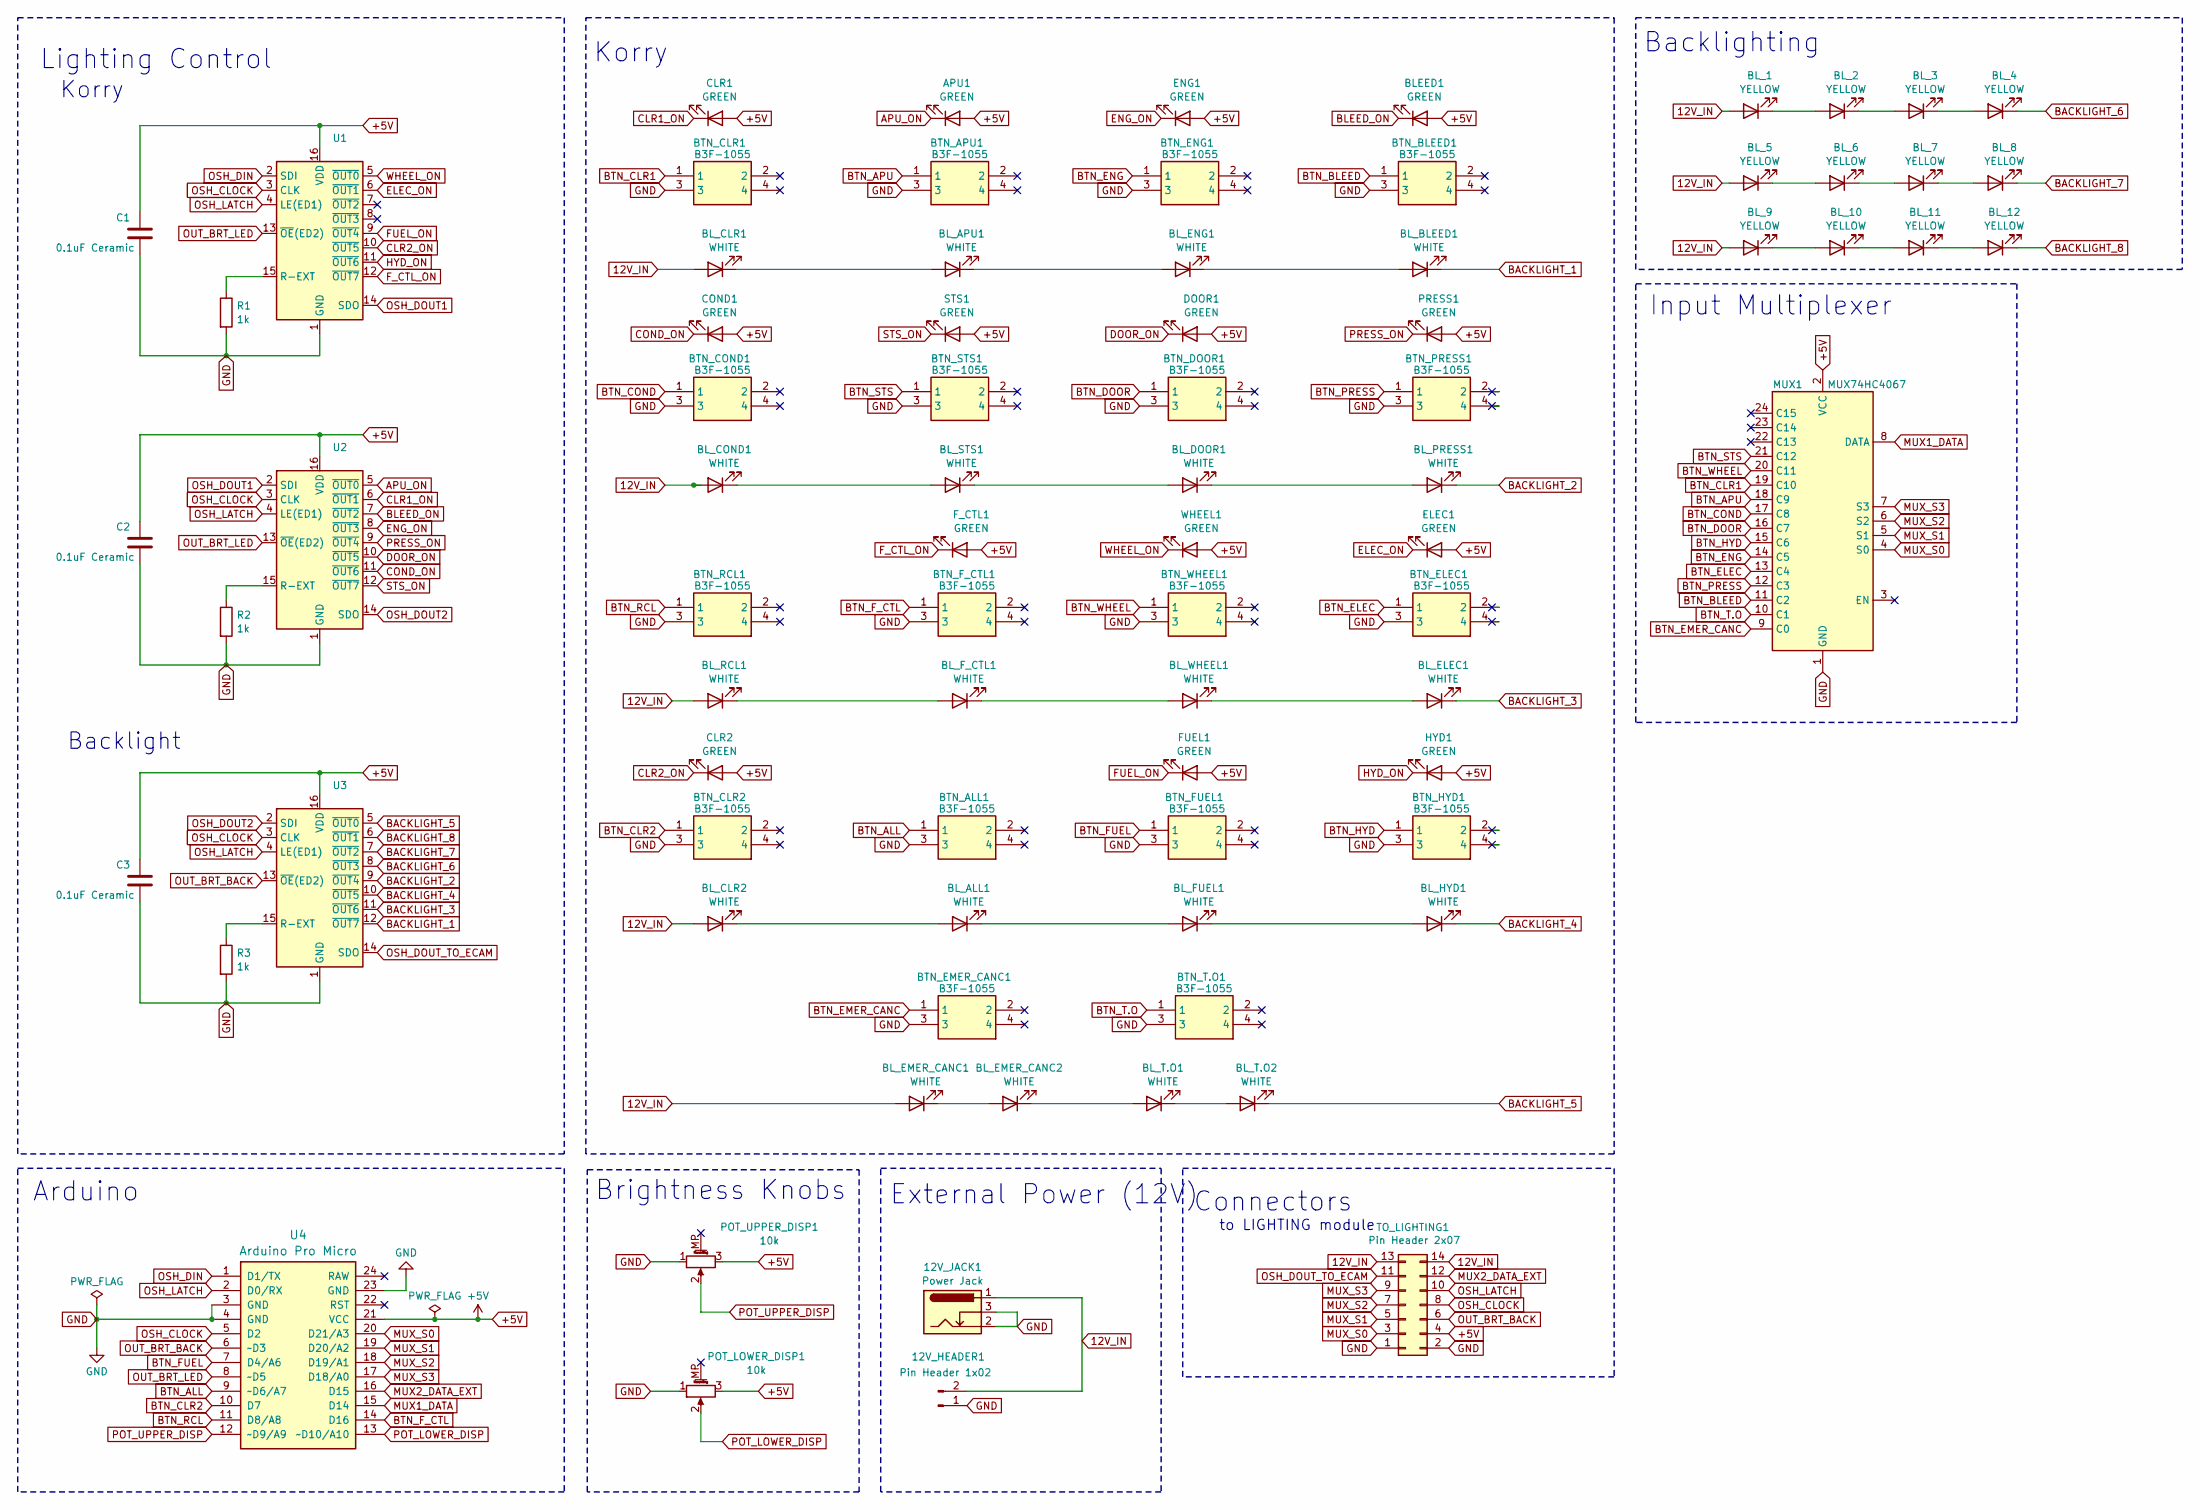
[picture p65: schematic ECAM.kicad_sch, ECAM Panel]

Parts:
12V_HEADER1: Pin Header 1x02; JST_EH_B2B-EH-A_1x02_P2.50mm_Vertical
12V_JACK1: Power Jack; BarrelJack_Horizontal
APU1: GREEN; LED_D3.0mm
BLEED1: GREEN; LED_D3.0mm
BL_1, BL_2, BL_3, BL_4, BL_5, BL_6, BL_7, BL_8, BL_9, BL_10, BL_11, BL_12: YELLOW; LED_D3.0mm
BL_ALL1: WHITE; LED_D3.0mm
BL_APU1: WHITE; LED_D3.0mm
BL_BLEED1: WHITE; LED_D3.0mm
BL_CLR1, BL_CLR2: WHITE; LED_D3.0mm
BL_COND1: WHITE; LED_D3.0mm
BL_DOOR1: WHITE; LED_D3.0mm
BL_ELEC1: WHITE; LED_D3.0mm
BL_EMER_CANC1, BL_EMER_CANC2: WHITE; LED_D3.0mm
BL_ENG1: WHITE; LED_D3.0mm
BL_FUEL1: WHITE; LED_D3.0mm
BL_F_CTL1: WHITE; LED_D3.0mm
BL_HYD1: WHITE; LED_D3.0mm
BL_PRESS1: WHITE; LED_D3.0mm
BL_RCL1: WHITE; LED_D3.0mm
BL_STS1: WHITE; LED_D3.0mm
BL_T.O1, BL_T.O2: WHITE; LED_D3.0mm
BL_WHEEL1: WHITE; LED_D3.0mm
BTN_ALL1: B3F-1055; B3F1000; Mouser Part Number 653-B3F-1055
BTN_APU1: B3F-1055; B3F1000; Mouser Part Number 653-B3F-1055
BTN_BLEED1: B3F-1055; B3F1000; Mouser Part Number 653-B3F-1055
BTN_CLR1, BTN_CLR2: B3F-1055; B3F1000; Mouser Part Number 653-B3F-1055
BTN_COND1: B3F-1055; B3F1000; Mouser Part Number 653-B3F-1055
BTN_DOOR1: B3F-1055; B3F1000; Mouser Part Number 653-B3F-1055
BTN_ELEC1: B3F-1055; B3F1000; Mouser Part Number 653-B3F-1055
BTN_EMER_CANC1: B3F-1055; B3F1000; Mouser Part Number 653-B3F-1055
BTN_ENG1: B3F-1055; B3F1000; Mouser Part Number 653-B3F-1055
BTN_FUEL1: B3F-1055; B3F1000; Mouser Part Number 653-B3F-1055
BTN_F_CTL1: B3F-1055; B3F1000; Mouser Part Number 653-B3F-1055
BTN_HYD1: B3F-1055; B3F1000; Mouser Part Number 653-B3F-1055
BTN_PRESS1: B3F-1055; B3F1000; Mouser Part Number 653-B3F-1055
BTN_RCL1: B3F-1055; B3F1000; Mouser Part Number 653-B3F-1055
BTN_STS1: B3F-1055; B3F1000; Mouser Part Number 653-B3F-1055
BTN_T.O1: B3F-1055; B3F1000; Mouser Part Number 653-B3F-1055
BTN_WHEEL1: B3F-1055; B3F1000; Mouser Part Number 653-B3F-1055
C1, C2, C3: 0.1uF Ceramic; C_Disc_D3.0mm_W1.6mm_P2.50mm
CLR1, CLR2: GREEN; LED_D3.0mm
COND1: GREEN; LED_D3.0mm
DOOR1: GREEN; LED_D3.0mm
ELEC1: GREEN; LED_D3.0mm
ENG1: GREEN; LED_D3.0mm
FUEL1: GREEN; LED_D3.0mm
F_CTL1: GREEN; LED_D3.0mm
HYD1: GREEN; LED_D3.0mm
MUX1: MUX74HC4067
POT_LOWER_DISP1: 10k; Potentiometer_Alps_RK09K_Single_Vertical
POT_UPPER_DISP1: 10k; Potentiometer_Alps_RK09K_Single_Vertical
PRESS1: GREEN; LED_D3.0mm
R1, R2, R3: 1k; R_Axial_DIN0204_L3.6mm_D1.6mm_P5.08mm_Horizontal
STS1: GREEN; LED_D3.0mm
TO_LIGHTING1: Pin Header 2x07; IDC-Header_2x07_P2.54mm_Vertical
U1, U2, U3: TLC5917; DIP-16_W7.62mm
U4: Arduino Pro Micro; Sparkfun_Pro_Micro
WHEEL1: GREEN; LED_D3.0mm

Connections:
12V_IN: 12V_HEADER1.2, 12V_JACK1.1, BL_1.2 (A), BL_5.2 (A), BL_9.2 (A), BL_CLR1.2 (A), BL_CLR2.2 (A), BL_COND1.2 (A), BL_EMER_CANC1.2 (A), BL_RCL1.2 (A), TO_LIGHTING1.13, TO_LIGHTING1.14
+5V: APU1.2 (A), BLEED1.2 (A), C1.1, C2.1, C3.1, CLR1.2 (A), CLR2.2 (A), COND1.2 (A), DOOR1.2 (A), ELEC1.2 (A), ENG1.2 (A), FUEL1.2 (A), F_CTL1.2 (A), HYD1.2 (A), MUX1.2 (VCC), POT_LOWER_DISP1.3, POT_UPPER_DISP1.3, PRESS1.2 (A), STS1.2 (A), TO_LIGHTING1.4, U1.16 (VDD), U2.16 (VDD), U3.16 (VDD), U4.21 (VCC), WHEEL1.2 (A)
APU_ON: APU1.1 (K), U2.5 (~OUT0)
BACKLIGHT_1: BL_BLEED1.1 (K), U3.12 (~OUT7)
BACKLIGHT_2: BL_PRESS1.1 (K), U3.9 (~OUT4)
BACKLIGHT_3: BL_ELEC1.1 (K), U3.11 (~OUT6)
BACKLIGHT_4: BL_HYD1.1 (K), U3.10 (~OUT5)
BACKLIGHT_5: BL_T.O2.1 (K), U3.5 (~OUT0)
BACKLIGHT_6: BL_4.1 (K), U3.8 (~OUT3)
BACKLIGHT_7: BL_8.1 (K), U3.7 (~OUT2)
BACKLIGHT_8: BL_12.1 (K), U3.6 (~OUT1)
BLEED_ON: BLEED1.1 (K), U2.7 (~OUT2)
BTN_ALL: BTN_ALL1.1, U4.9 (~D6/A7)
BTN_APU: BTN_APU1.1, MUX1.18 (C9)
BTN_BLEED: BTN_BLEED1.1, MUX1.11 (C2)
BTN_CLR1: BTN_CLR1.1, MUX1.19 (C10)
BTN_CLR2: BTN_CLR2.1, U4.10 (D7)
BTN_COND: BTN_COND1.1, MUX1.17 (C8)
BTN_DOOR: BTN_DOOR1.1, MUX1.16 (C7)
BTN_ELEC: BTN_ELEC1.1, MUX1.13 (C4)
BTN_EMER_CANC: BTN_EMER_CANC1.1, MUX1.9 (C0)
BTN_ENG: BTN_ENG1.1, MUX1.14 (C5)
BTN_FUEL: BTN_FUEL1.1, U4.7 (D4/A6)
BTN_F_CTL: BTN_F_CTL1.1, U4.14 (D16)
BTN_HYD: BTN_HYD1.1, MUX1.15 (C6)
BTN_PRESS: BTN_PRESS1.1, MUX1.12 (C3)
BTN_RCL: BTN_RCL1.1, U4.11 (D8/A8)
BTN_STS: BTN_STS1.1, MUX1.21 (C12)
BTN_T.O: BTN_T.O1.1, MUX1.10 (C1)
BTN_WHEEL: BTN_WHEEL1.1, MUX1.20 (C11)
CLR1_ON: CLR1.1 (K), U2.6 (~OUT1)
CLR2_ON: CLR2.1 (K), U1.10 (~OUT5)
COND_ON: COND1.1 (K), U2.11 (~OUT6)
DOOR_ON: DOOR1.1 (K), U2.10 (~OUT5)
ELEC_ON: ELEC1.1 (K), U1.6 (~OUT1)
ENG_ON: ENG1.1 (K), U2.8 (~OUT3)
FUEL_ON: FUEL1.1 (K), U1.9 (~OUT4)
F_CTL_ON: F_CTL1.1 (K), U1.12 (~OUT7)
GND: 12V_HEADER1.1, 12V_JACK1.2, 12V_JACK1.3, BTN_ALL1.3, BTN_APU1.3, BTN_BLEED1.3, BTN_CLR1.3, BTN_CLR2.3, BTN_COND1.3, BTN_DOOR1.3, BTN_ELEC1.3, BTN_EMER_CANC1.3, BTN_ENG1.3, BTN_FUEL1.3, BTN_F_CTL1.3, BTN_HYD1.3, BTN_PRESS1.3, BTN_RCL1.3, BTN_STS1.3, BTN_T.O1.3, BTN_WHEEL1.3, C1.2, C2.2, C3.2, MUX1.1 (GND), POT_LOWER_DISP1.1, POT_UPPER_DISP1.1, R1.2, R2.2, R3.2, TO_LIGHTING1.1, TO_LIGHTING1.2, U1.1 (GND), U2.1 (GND), U3.1 (GND), U4.3 (GND), U4.4 (GND), U4.23 (GND)
HYD_ON: HYD1.1 (K), U1.11 (~OUT6)
MUX1_DATA: MUX1.8 (DATA), U4.15 (D14)
MUX2_DATA_EXT: TO_LIGHTING1.12, U4.16 (D15)
MUX_S0: MUX1.4 (S0), TO_LIGHTING1.3, U4.20 (D21/A3)
MUX_S1: MUX1.5 (S1), TO_LIGHTING1.5, U4.19 (D20/A2)
MUX_S2: MUX1.6 (S2), TO_LIGHTING1.7, U4.18 (D19/A1)
MUX_S3: MUX1.7 (S3), TO_LIGHTING1.9, U4.17 (D18/A0)
unnamed: BL_1.1 (K), BL_2.2 (A)
unnamed: BL_2.1 (K), BL_3.2 (A)
unnamed: BL_3.1 (K), BL_4.2 (A)
unnamed: BL_5.1 (K), BL_6.2 (A)
unnamed: BL_6.1 (K), BL_7.2 (A)
unnamed: BL_7.1 (K), BL_8.2 (A)
unnamed: BL_9.1 (K), BL_10.2 (A)
unnamed: BL_10.1 (K), BL_11.2 (A)
unnamed: BL_11.1 (K), BL_12.2 (A)
unnamed: BL_ALL1.2 (A), BL_CLR2.1 (K)
unnamed: BL_ALL1.1 (K), BL_FUEL1.2 (A)
unnamed: BL_APU1.2 (A), BL_CLR1.1 (K)
unnamed: BL_APU1.1 (K), BL_ENG1.2 (A)
unnamed: BL_BLEED1.2 (A), BL_ENG1.1 (K)
unnamed: BL_COND1.1 (K), BL_STS1.2 (A)
unnamed: BL_DOOR1.2 (A), BL_STS1.1 (K)
unnamed: BL_DOOR1.1 (K), BL_PRESS1.2 (A)
unnamed: BL_ELEC1.2 (A), BL_WHEEL1.1 (K)
unnamed: BL_EMER_CANC1.1 (K), BL_EMER_CANC2.2 (A)
unnamed: BL_EMER_CANC2.1 (K), BL_T.O1.2 (A)
unnamed: BL_FUEL1.1 (K), BL_HYD1.2 (A)
unnamed: BL_F_CTL1.2 (A), BL_RCL1.1 (K)
unnamed: BL_F_CTL1.1 (K), BL_WHEEL1.2 (A)
unnamed: BL_T.O1.1 (K), BL_T.O2.2 (A)
unnamed: R1.1, U1.15 (R-EXT)
unnamed: R2.1, U2.15 (R-EXT)
unnamed: R3.1, U3.15 (R-EXT)
OSH_CLOCK: TO_LIGHTING1.8, U1.3 (CLK), U2.3 (CLK), U3.3 (CLK), U4.5 (D2)
OSH_DIN: U1.2 (SDI), U4.1 (D1/TX)
OSH_DOUT1: U1.14 (SDO), U2.2 (SDI)
OSH_DOUT2: U2.14 (SDO), U3.2 (SDI)
OSH_DOUT_TO_ECAM: TO_LIGHTING1.11, U3.14 (SDO)
OSH_LATCH: TO_LIGHTING1.10, U1.4 (LE(ED1)), U2.4 (LE(ED1)), U3.4 (LE(ED1)), U4.2 (D0/RX)
OUT_BRT_BACK: TO_LIGHTING1.6, U3.13 (~OE(ED2)), U4.6 (~D3)
OUT_BRT_LED: U1.13 (~OE(ED2)), U2.13 (~OE(ED2)), U4.8 (~D5)
POT_LOWER_DISP: POT_LOWER_DISP1.2, U4.13 (~D10/A10)
POT_UPPER_DISP: POT_UPPER_DISP1.2, U4.12 (~D9/A9)
PRESS_ON: PRESS1.1 (K), U2.9 (~OUT4)
STS_ON: STS1.1 (K), U2.12 (~OUT7)
WHEEL_ON: U1.5 (~OUT0), WHEEL1.1 (K)

Notes on the sheet:
Connectors
Korry
Arduino
Backlight
Backlighting
Brightness Knobs
External Power (12V)
Lighting Control
Input Multiplexer
to LIGHTING module

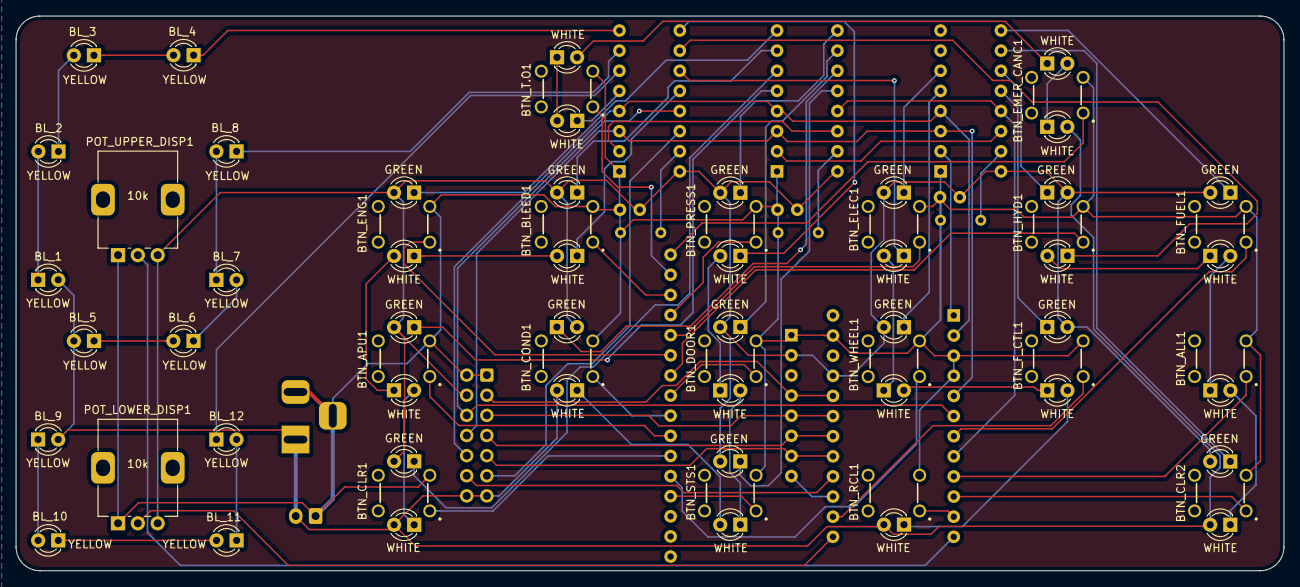
[picture p66: board ECAM.kicad_pcb from above]

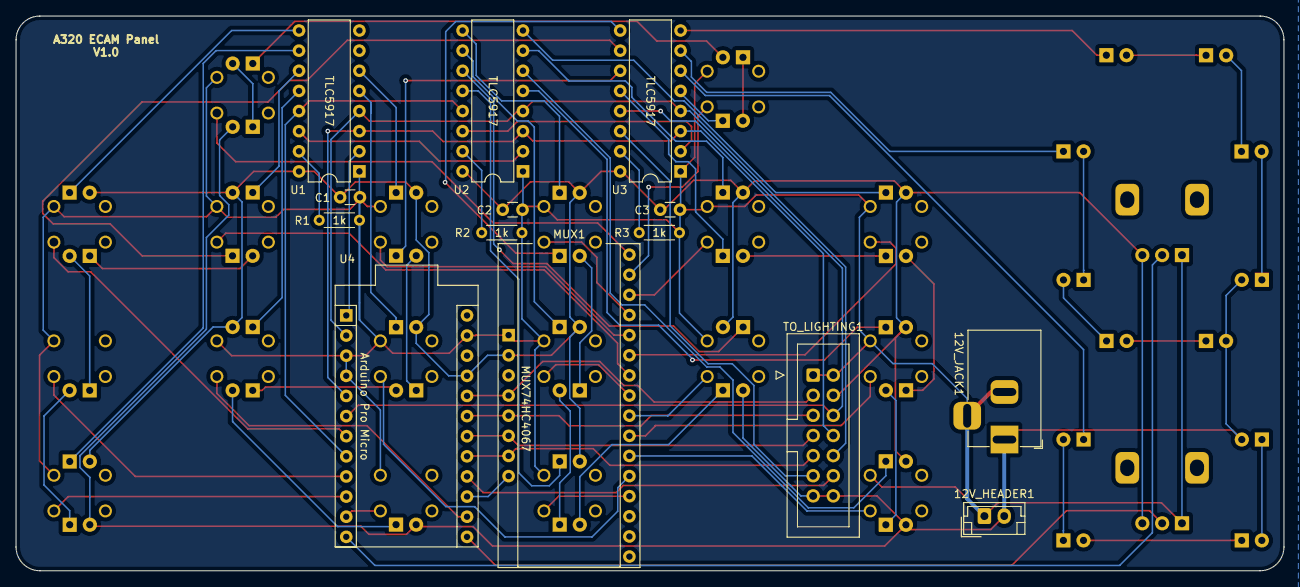
[picture p67: board ECAM.kicad_pcb from below]

Board: 2 copper layers, 160.0 x 70.0 mm, 80 parts (14 on the bottom side), 86 nets.
