SK-MH/A320-PCBs/2 - GLARE SHIELD/2.2 AUTOLAND Left/KiCAD/Autoland.kicad_pcb

## KiCad design 2 - GLARE SHIELD/2.2 AUTOLAND Left/KiCAD/Autoland.kicad_pcb (2025-01-06)

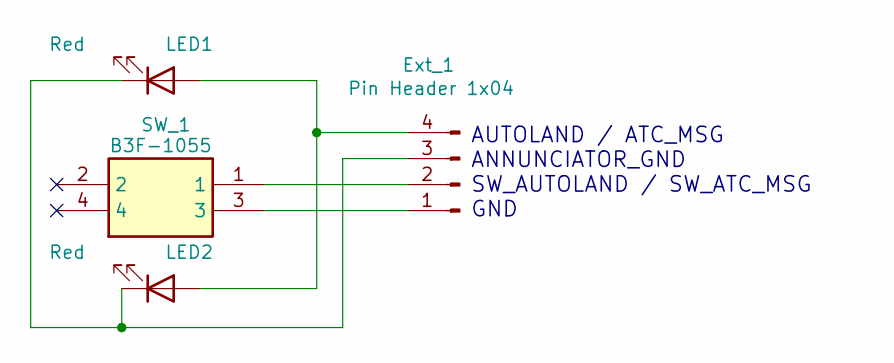
[picture p68: schematic Autoland.kicad_sch]

Parts:
Ext_1: Pin Header 1x04; JST_EH_B4B-EH-A_1x04_P2.50mm_Vertical
LED1, LED2: Red; LED_D3.0mm
SW_1: B3F-1055; B3F1000; Mouser Part Number 653-B3F-1055

Connections:
unnamed: Ext_1.1, SW_1.3
unnamed: Ext_1.2, SW_1.1
unnamed: Ext_1.3, LED1.1 (K), LED2.1 (K)
unnamed: Ext_1.4, LED1.2 (A), LED2.2 (A)

Notes on the sheet:
AUTOLAND / ATC_MSG ANNUNCIATOR_GND SW_AUTOLAND / SW_ATC_MSG GND

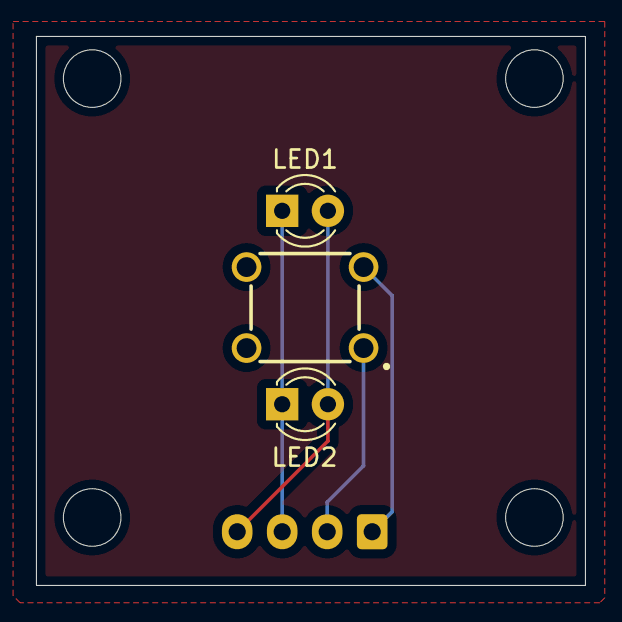
[picture p69: board Autoland.kicad_pcb from above]

Board: 2 copper layers, 30.5 x 30.5 mm, 4 parts (1 on the bottom side), 4 nets.
