SK-MH/A320-PCBs/3 - MAIN INSTRUMENTS/3.3 CHRONO/KiCAD/CHRONO neu.kicad_pcb

## KiCad design 3 - MAIN INSTRUMENTS/3.3 CHRONO/KiCAD/CHRONO neu.kicad_pcb (2025-01-06)

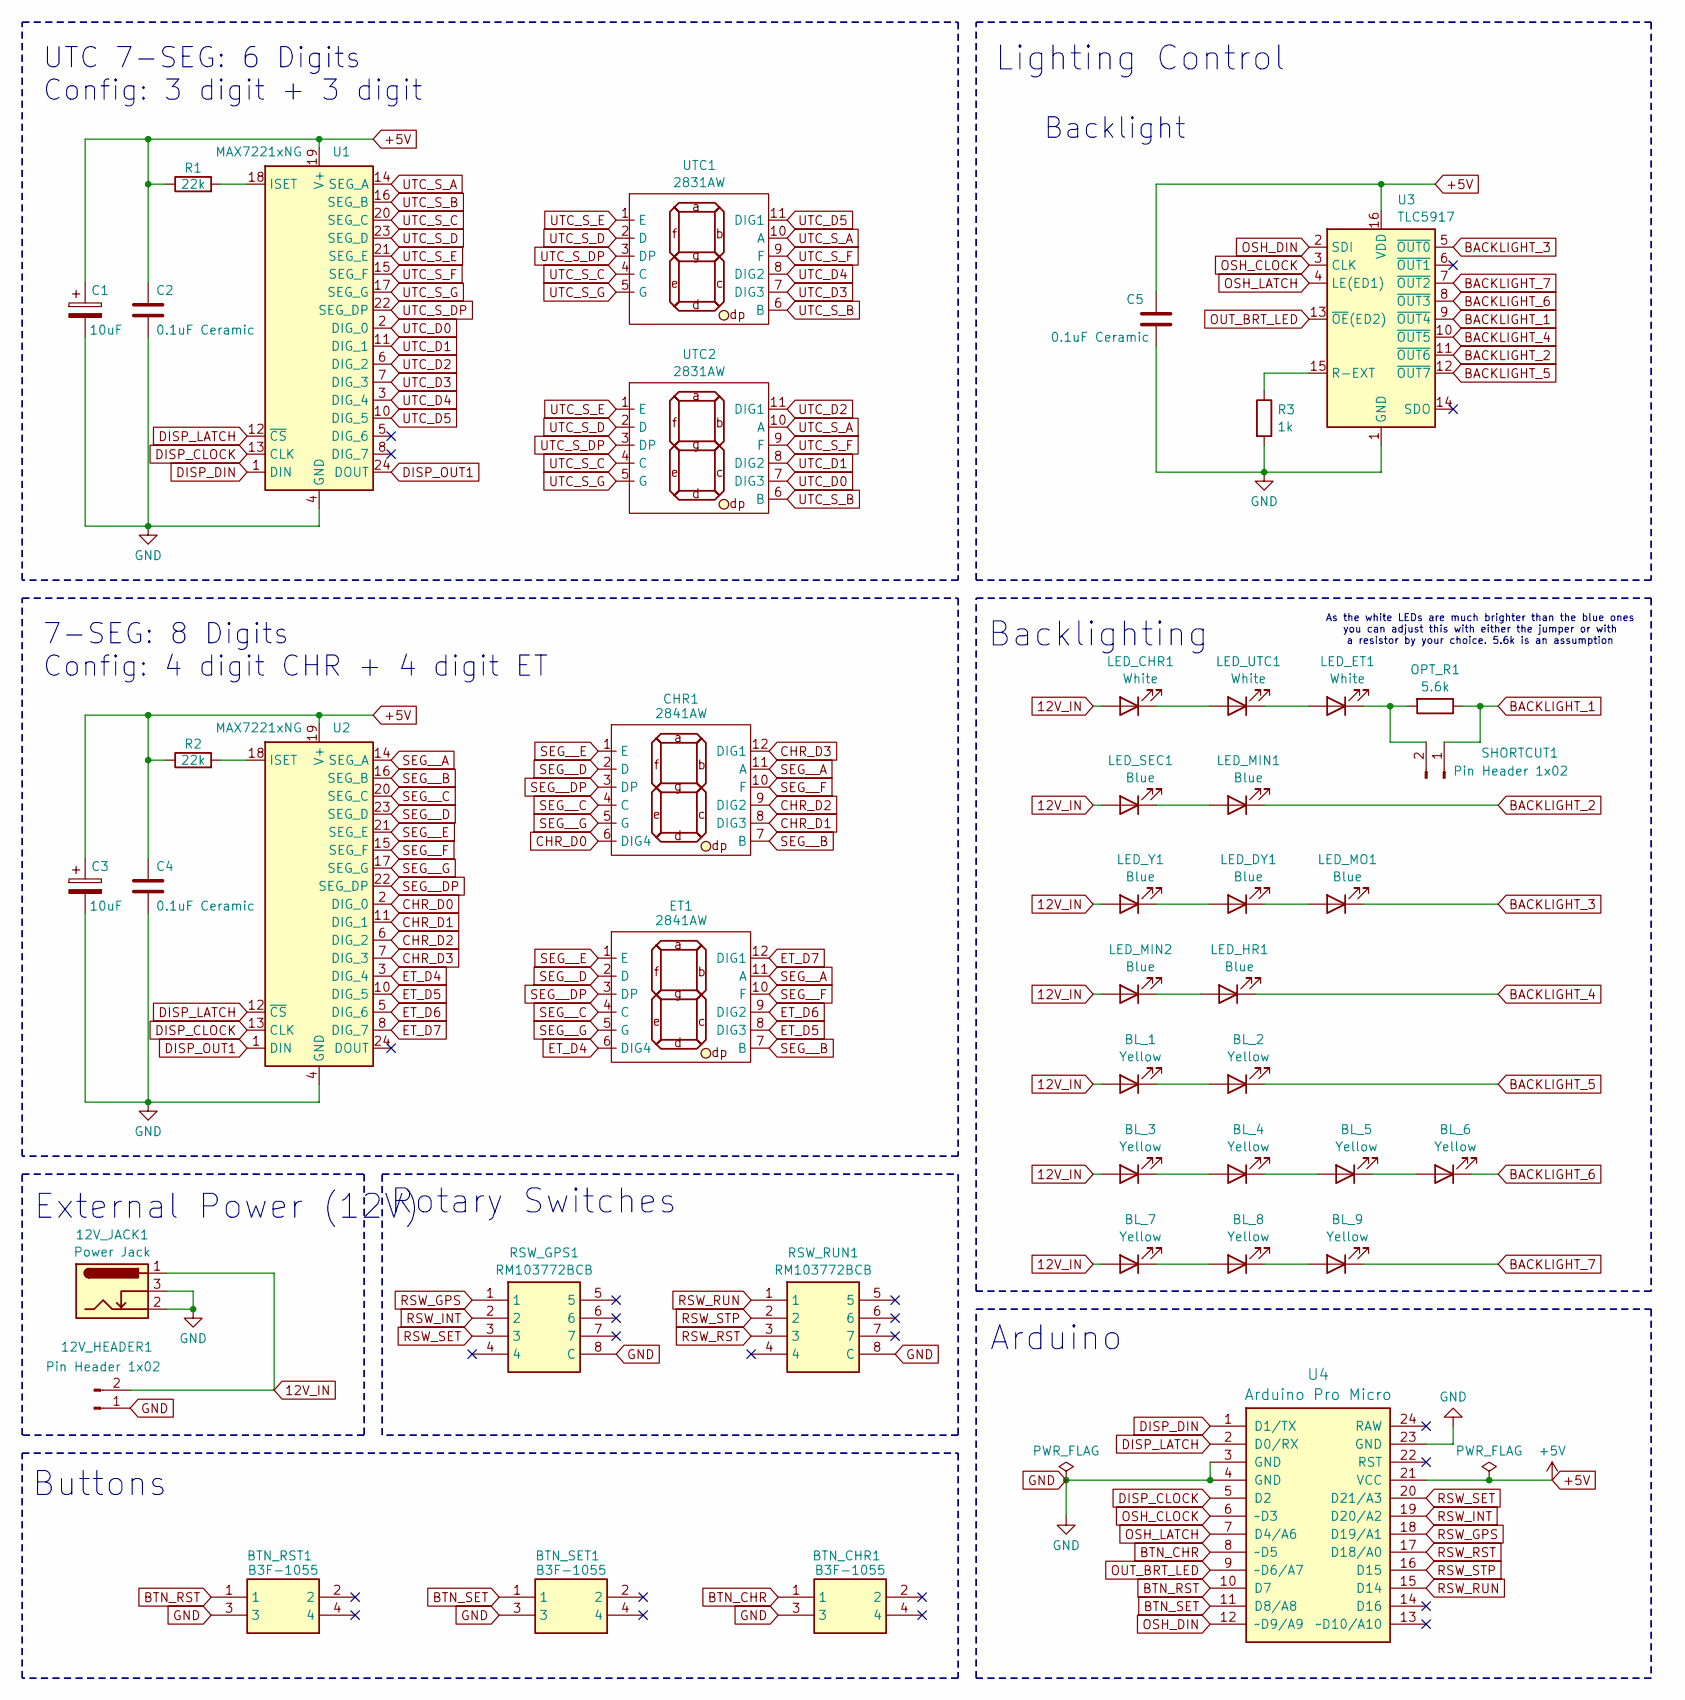
[picture p70: schematic CHRONO neu.kicad_sch, CHRONO Panel]

Parts:
12V_HEADER1: Pin Header 1x02; JST_EH_B2B-EH-A_1x02_P2.50mm_Vertical
12V_JACK1: Power Jack; BarrelJack_Horizontal
BL_1, BL_2, BL_3, BL_4, BL_5, BL_6, BL_7, BL_8, BL_9: Yellow; LED_D3.0mm
BTN_CHR1: B3F-1055; B3F1000; Mouser Part Number 653-B3F-1055
BTN_RST1: B3F-1055; B3F1000; Mouser Part Number 653-B3F-1055
BTN_SET1: B3F-1055; B3F1000; Mouser Part Number 653-B3F-1055
C1, C3: 10uF; CP_Radial_D4.0mm_P1.50mm
C2, C4, C5: 0.1uF Ceramic; C_Disc_D3.0mm_W1.6mm_P2.50mm
CHR1: 2841AW
ET1: 2841AW
LED_CHR1: White; LED_D3.0mm
LED_DY1: Blue; LED_D3.0mm
LED_ET1: White; LED_D3.0mm
LED_HR1: Blue; LED_D3.0mm
LED_MIN1, LED_MIN2: Blue; LED_D3.0mm
LED_MO1: Blue; LED_D3.0mm
LED_SEC1: Blue; LED_D3.0mm
LED_UTC1: White; LED_D3.0mm
LED_Y1: Blue; LED_D3.0mm
OPT_R1: 5.6k; R_Axial_DIN0204_L3.6mm_D1.6mm_P7.62mm_Horizontal
R1, R2: 22k; R_Axial_DIN0204_L3.6mm_D1.6mm_P7.62mm_Horizontal
R3: 1k; R_Axial_DIN0204_L3.6mm_D1.6mm_P7.62mm_Horizontal
RSW_GPS1: RM103772BCB; myRM103772BCB; Mouser Part Number 611-RM103772BCB
RSW_RUN1: RM103772BCB; myRM103772BCB; Mouser Part Number 611-RM103772BCB
SHORTCUT1: Pin Header 1x02; PinHeader_1x02_P2.54mm_Vertical
U1, U2: MAX7221xNG; DIP-24_W7.62mm
U3: TLC5917; DIP-16_W7.62mm
U4: Arduino Pro Micro; Sparkfun_Pro_Micro
UTC1, UTC2: 2831AW

Connections:
12V_IN: 12V_HEADER1.2, 12V_JACK1.1, BL_1.2 (A), BL_3.2 (A), BL_7.2 (A), LED_CHR1.2 (A), LED_MIN2.2 (A), LED_SEC1.2 (A), LED_Y1.2 (A)
+5V: C1.1, C2.1, C3.1, C4.1, C5.1, R1.1, R2.1, U1.19 (V+), U2.19 (V+), U3.16 (VDD), U4.21 (VCC)
BACKLIGHT_1: OPT_R1.1, SHORTCUT1.1, U3.9 (~OUT4)
BACKLIGHT_2: LED_MIN1.1 (K), U3.11 (~OUT6)
BACKLIGHT_3: LED_MO1.1 (K), U3.5 (~OUT0)
BACKLIGHT_4: LED_HR1.1 (K), U3.10 (~OUT5)
BACKLIGHT_5: BL_2.1 (K), U3.12 (~OUT7)
BACKLIGHT_6: BL_6.1 (K), U3.8 (~OUT3)
BACKLIGHT_7: BL_9.1 (K), U3.7 (~OUT2)
BTN_CHR: BTN_CHR1.1, U4.8 (~D5)
BTN_RST: BTN_RST1.1, U4.10 (D7)
BTN_SET: BTN_SET1.1, U4.11 (D8/A8)
CHR_D0: CHR1.6 (DIG4), U2.2 (DIG_0)
CHR_D1: CHR1.8 (DIG3), U2.11 (DIG_1)
CHR_D2: CHR1.9 (DIG2), U2.6 (DIG_2)
CHR_D3: CHR1.12 (DIG1), U2.7 (DIG_3)
DISP_CLOCK: U1.13 (CLK), U2.13 (CLK), U4.5 (D2)
DISP_DIN: U1.1 (DIN), U4.1 (D1/TX)
DISP_LATCH: U1.12 (~CS), U2.12 (~CS), U4.2 (D0/RX)
DISP_OUT1: U1.24 (DOUT), U2.1 (DIN)
ET_D4: ET1.6 (DIG4), U2.3 (DIG_4)
ET_D5: ET1.8 (DIG3), U2.10 (DIG_5)
ET_D6: ET1.9 (DIG2), U2.5 (DIG_6)
ET_D7: ET1.12 (DIG1), U2.8 (DIG_7)
GND: 12V_HEADER1.1, 12V_JACK1.2, 12V_JACK1.3, BTN_CHR1.3, BTN_RST1.3, BTN_SET1.3, C1.2, C2.2, C3.2, C4.2, C5.2, R3.2, RSW_GPS1.8 (C), RSW_RUN1.8 (C), U1.4 (GND), U1.9 (GND), U2.4 (GND), U2.9 (GND), U3.1 (GND), U4.3 (GND), U4.4 (GND), U4.23 (GND)
unnamed: BL_1.1 (K), BL_2.2 (A)
unnamed: BL_3.1 (K), BL_4.2 (A)
unnamed: BL_4.1 (K), BL_5.2 (A)
unnamed: BL_5.1 (K), BL_6.2 (A)
unnamed: BL_7.1 (K), BL_8.2 (A)
unnamed: BL_8.1 (K), BL_9.2 (A)
unnamed: LED_CHR1.1 (K), LED_UTC1.2 (A)
unnamed: LED_DY1.2 (A), LED_Y1.1 (K)
unnamed: LED_DY1.1 (K), LED_MO1.2 (A)
unnamed: LED_ET1.2 (A), LED_UTC1.1 (K)
unnamed: LED_ET1.1 (K), OPT_R1.2, SHORTCUT1.2
unnamed: LED_HR1.2 (A), LED_MIN2.1 (K)
unnamed: LED_MIN1.2 (A), LED_SEC1.1 (K)
unnamed: R1.2, U1.18 (ISET)
unnamed: R2.2, U2.18 (ISET)
unnamed: R3.1, U3.15 (R-EXT)
OSH_CLOCK: U3.3 (CLK), U4.6 (~D3)
OSH_DIN: U3.2 (SDI), U4.12 (~D9/A9)
OSH_LATCH: U3.4 (LE(ED1)), U4.7 (D4/A6)
OUT_BRT_LED: U3.13 (~OE(ED2)), U4.9 (~D6/A7)
RSW_GPS: RSW_GPS1.1, U4.18 (D19/A1)
RSW_INT: RSW_GPS1.2, U4.19 (D20/A2)
RSW_RST: RSW_RUN1.3, U4.17 (D18/A0)
RSW_RUN: RSW_RUN1.1, U4.15 (D14)
RSW_SET: RSW_GPS1.3, U4.20 (D21/A3)
RSW_STP: RSW_RUN1.2, U4.16 (D15)
SEG__A: CHR1.11 (A), ET1.11 (A), U2.14 (SEG_A)
SEG__B: CHR1.7 (B), ET1.7 (B), U2.16 (SEG_B)
SEG__C: CHR1.4 (C), ET1.4 (C), U2.20 (SEG_C)
SEG__D: CHR1.2 (D), ET1.2 (D), U2.23 (SEG_D)
SEG__DP: CHR1.3 (DP), ET1.3 (DP), U2.22 (SEG_DP)
SEG__E: CHR1.1 (E), ET1.1 (E), U2.21 (SEG_E)
SEG__F: CHR1.10 (F), ET1.10 (F), U2.15 (SEG_F)
SEG__G: CHR1.5 (G), ET1.5 (G), U2.17 (SEG_G)
UTC_D0: U1.2 (DIG_0), UTC2.7 (DIG3)
UTC_D1: U1.11 (DIG_1), UTC2.8 (DIG2)
UTC_D2: U1.6 (DIG_2), UTC2.11 (DIG1)
UTC_D3: U1.7 (DIG_3), UTC1.7 (DIG3)
UTC_D4: U1.3 (DIG_4), UTC1.8 (DIG2)
UTC_D5: U1.10 (DIG_5), UTC1.11 (DIG1)
UTC_S_A: U1.14 (SEG_A), UTC1.10 (A), UTC2.10 (A)
UTC_S_B: U1.16 (SEG_B), UTC1.6 (B), UTC2.6 (B)
UTC_S_C: U1.20 (SEG_C), UTC1.4 (C), UTC2.4 (C)
UTC_S_D: U1.23 (SEG_D), UTC1.2 (D), UTC2.2 (D)
UTC_S_DP: U1.22 (SEG_DP), UTC1.3 (DP), UTC2.3 (DP)
UTC_S_E: U1.21 (SEG_E), UTC1.1 (E), UTC2.1 (E)
UTC_S_F: U1.15 (SEG_F), UTC1.9 (F), UTC2.9 (F)
UTC_S_G: U1.17 (SEG_G), UTC1.5 (G), UTC2.5 (G)

Notes on the sheet:
Arduino
External Power (12V)
Backlighting
Backlight
Rotary Switches
Lighting Control
UTC 7-SEG: 6 Digits Config: 3 digit + 3 digit
As the white LEDs are much brighter than the blue ones you can adjust this with either the jumper or with a resistor by your choice. 5.6k is an assumption
Buttons
7-SEG: 8 Digits Config: 4 digit CHR + 4 digit ET

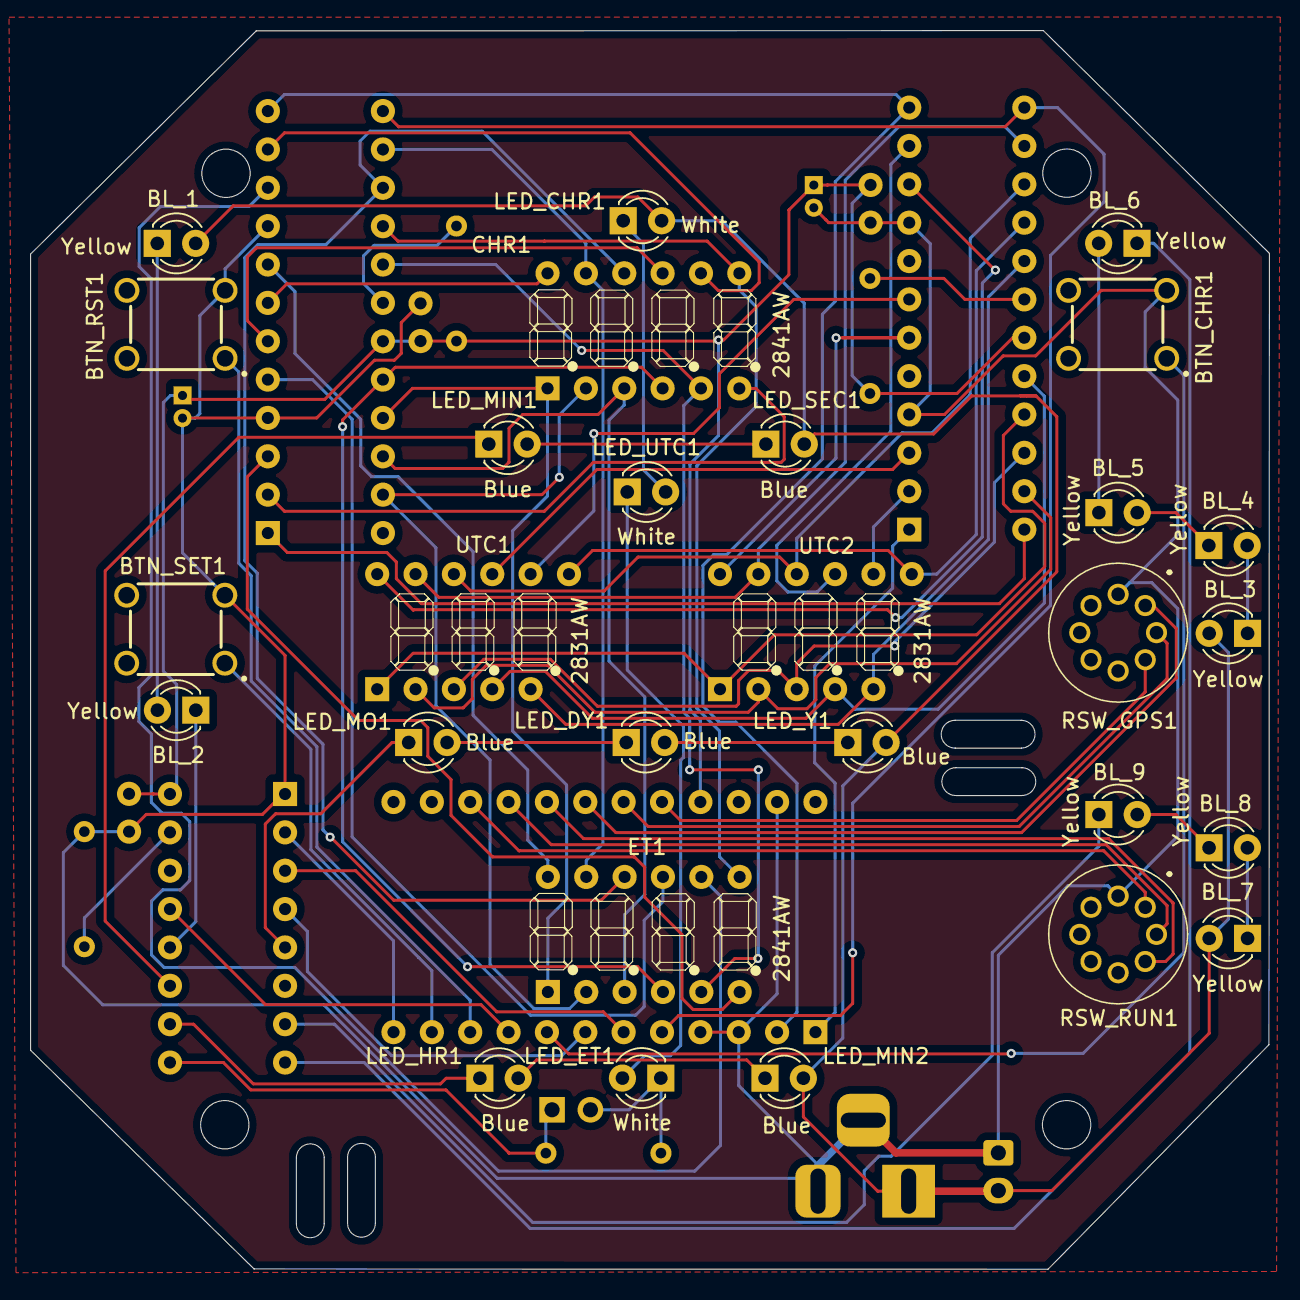
[picture p71: board CHRONO neu.kicad_pcb from above]

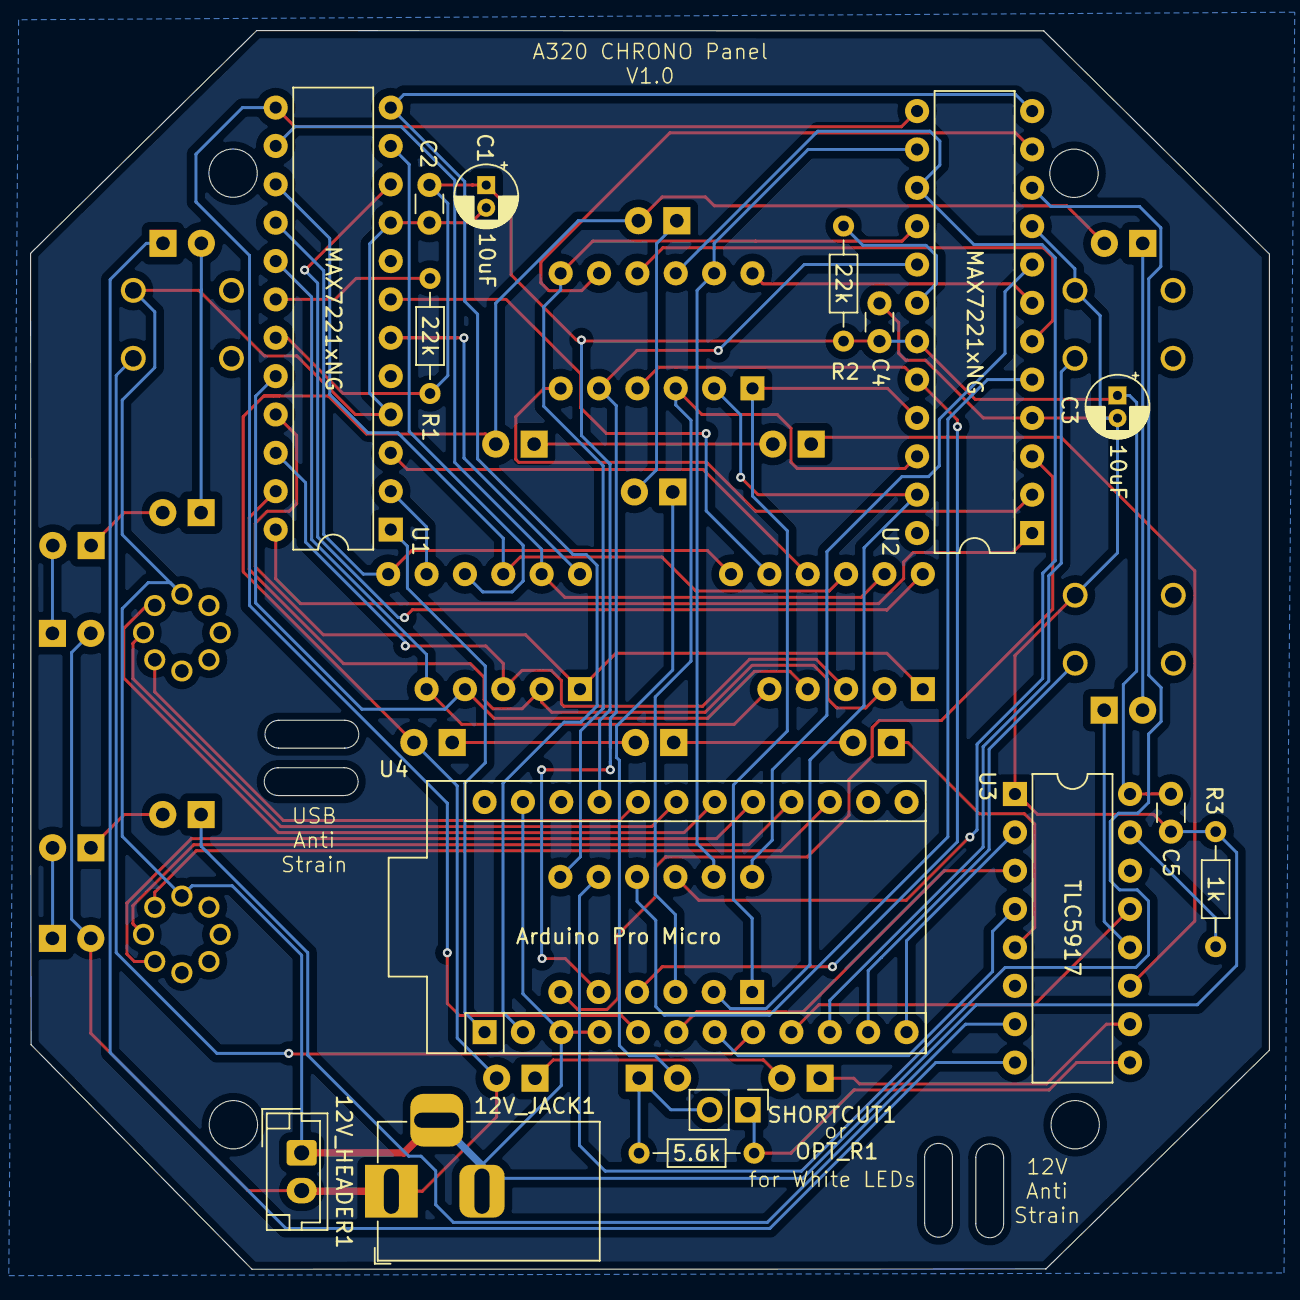
[picture p72: board CHRONO neu.kicad_pcb from below]

Board: 2 copper layers, 82.0 x 82.0 mm, 44 parts (16 on the bottom side), 73 nets.
