SK-MH/A320-PCBs/1 - OVERHEAD/1.11 FLTCTL_FO/KiCAD/FLT_CTL_FO.kicad_pcb

## KiCad design 1 - OVERHEAD/1.11 FLTCTL_FO/KiCAD/FLT_CTL_FO.kicad_pcb (2025-01-06)

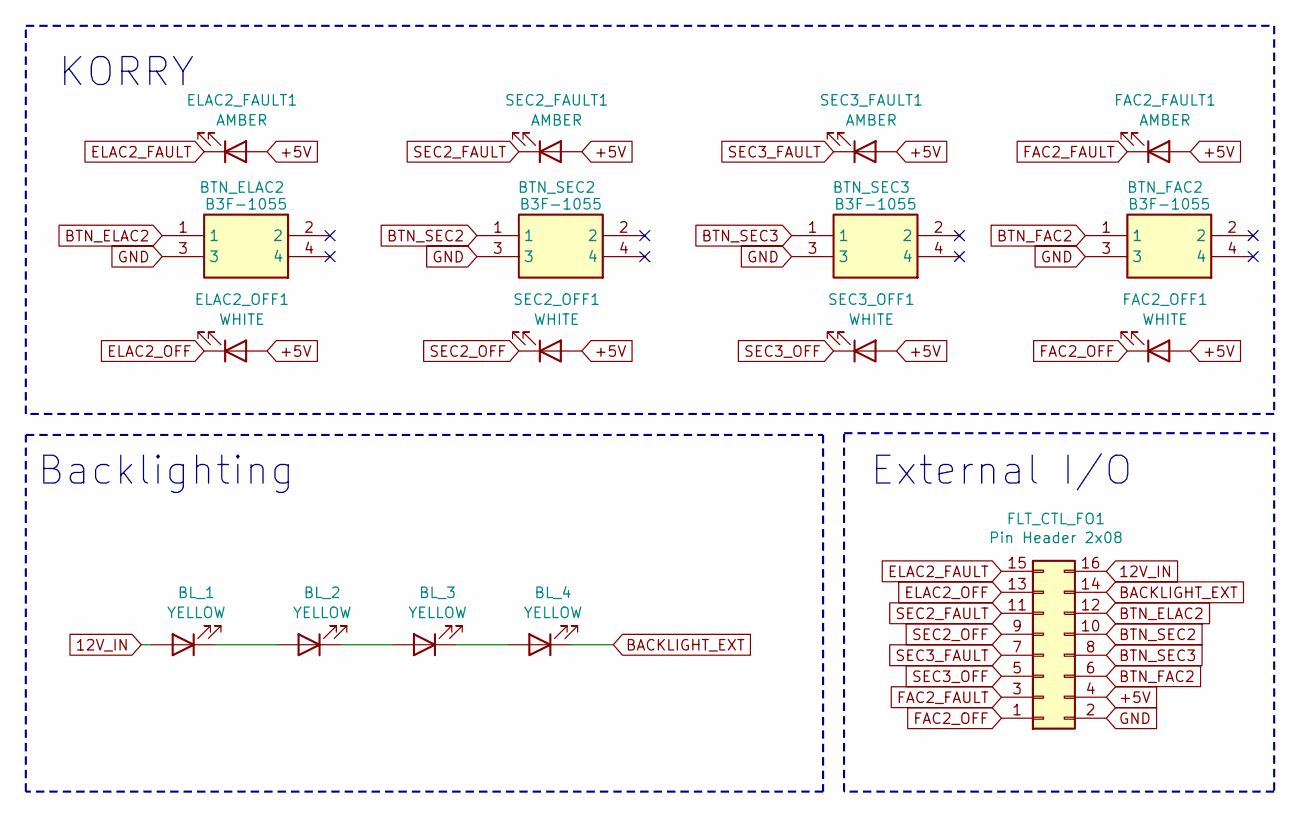
[picture p73: schematic FLT_CTL_FO.kicad_sch, FLT CTL FO Panel]

Parts:
BL_1, BL_2, BL_3, BL_4: YELLOW; LED_D3.0mm
BTN_ELAC2: B3F-1055; B3F1000; Mouser Part Number 653-B3F-1055
BTN_FAC2: B3F-1055; B3F1000; Mouser Part Number 653-B3F-1055
BTN_SEC2, BTN_SEC3: B3F-1055; B3F1000; Mouser Part Number 653-B3F-1055
ELAC2_FAULT1: AMBER; LED_D3.0mm
ELAC2_OFF1: WHITE; LED_D3.0mm
FAC2_FAULT1: AMBER; LED_D3.0mm
FAC2_OFF1: WHITE; LED_D3.0mm
FLT_CTL_FO1: Pin Header 2x08; IDC-Header_2x08_P2.54mm_Vertical
SEC2_FAULT1, SEC3_FAULT1: AMBER; LED_D3.0mm
SEC2_OFF1, SEC3_OFF1: WHITE; LED_D3.0mm

Connections:
12V_IN: BL_1.2 (A), FLT_CTL_FO1.16
+5V: ELAC2_FAULT1.2 (A), ELAC2_OFF1.2 (A), FAC2_FAULT1.2 (A), FAC2_OFF1.2 (A), FLT_CTL_FO1.4, SEC2_FAULT1.2 (A), SEC2_OFF1.2 (A), SEC3_FAULT1.2 (A), SEC3_OFF1.2 (A)
BACKLIGHT_EXT: BL_4.1 (K), FLT_CTL_FO1.14
BTN_ELAC2: BTN_ELAC2.1, FLT_CTL_FO1.12
BTN_FAC2: BTN_FAC2.1, FLT_CTL_FO1.6
BTN_SEC2: BTN_SEC2.1, FLT_CTL_FO1.10
BTN_SEC3: BTN_SEC3.1, FLT_CTL_FO1.8
ELAC2_FAULT: ELAC2_FAULT1.1 (K), FLT_CTL_FO1.15
ELAC2_OFF: ELAC2_OFF1.1 (K), FLT_CTL_FO1.13
FAC2_FAULT: FAC2_FAULT1.1 (K), FLT_CTL_FO1.3
FAC2_OFF: FAC2_OFF1.1 (K), FLT_CTL_FO1.1
GND: BTN_ELAC2.3, BTN_FAC2.3, BTN_SEC2.3, BTN_SEC3.3, FLT_CTL_FO1.2
unnamed: BL_1.1 (K), BL_2.2 (A)
unnamed: BL_2.1 (K), BL_3.2 (A)
unnamed: BL_3.1 (K), BL_4.2 (A)
SEC2_FAULT: FLT_CTL_FO1.11, SEC2_FAULT1.1 (K)
SEC2_OFF: FLT_CTL_FO1.9, SEC2_OFF1.1 (K)
SEC3_FAULT: FLT_CTL_FO1.7, SEC3_FAULT1.1 (K)
SEC3_OFF: FLT_CTL_FO1.5, SEC3_OFF1.1 (K)

Notes on the sheet:
Backlighting
External I/O
KORRY

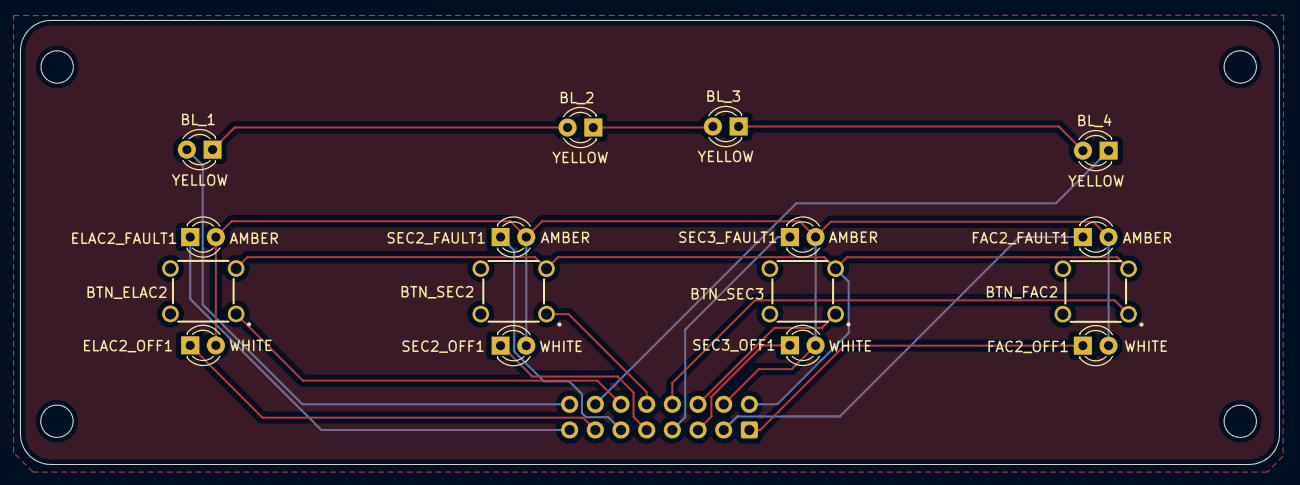
[picture p74: board FLT_CTL_FO.kicad_pcb from above]

Board: 2 copper layers, 124.6 x 43.9 mm, 17 parts (1 on the bottom side), 19 nets.
