SK-MH/A320-PCBs/1 - OVERHEAD/1.8 AIRCOND/KiCAD/AirCond.kicad_pcb

## KiCad design 1 - OVERHEAD/1.8 AIRCOND/KiCAD/AirCond.kicad_pcb (2025-01-06)

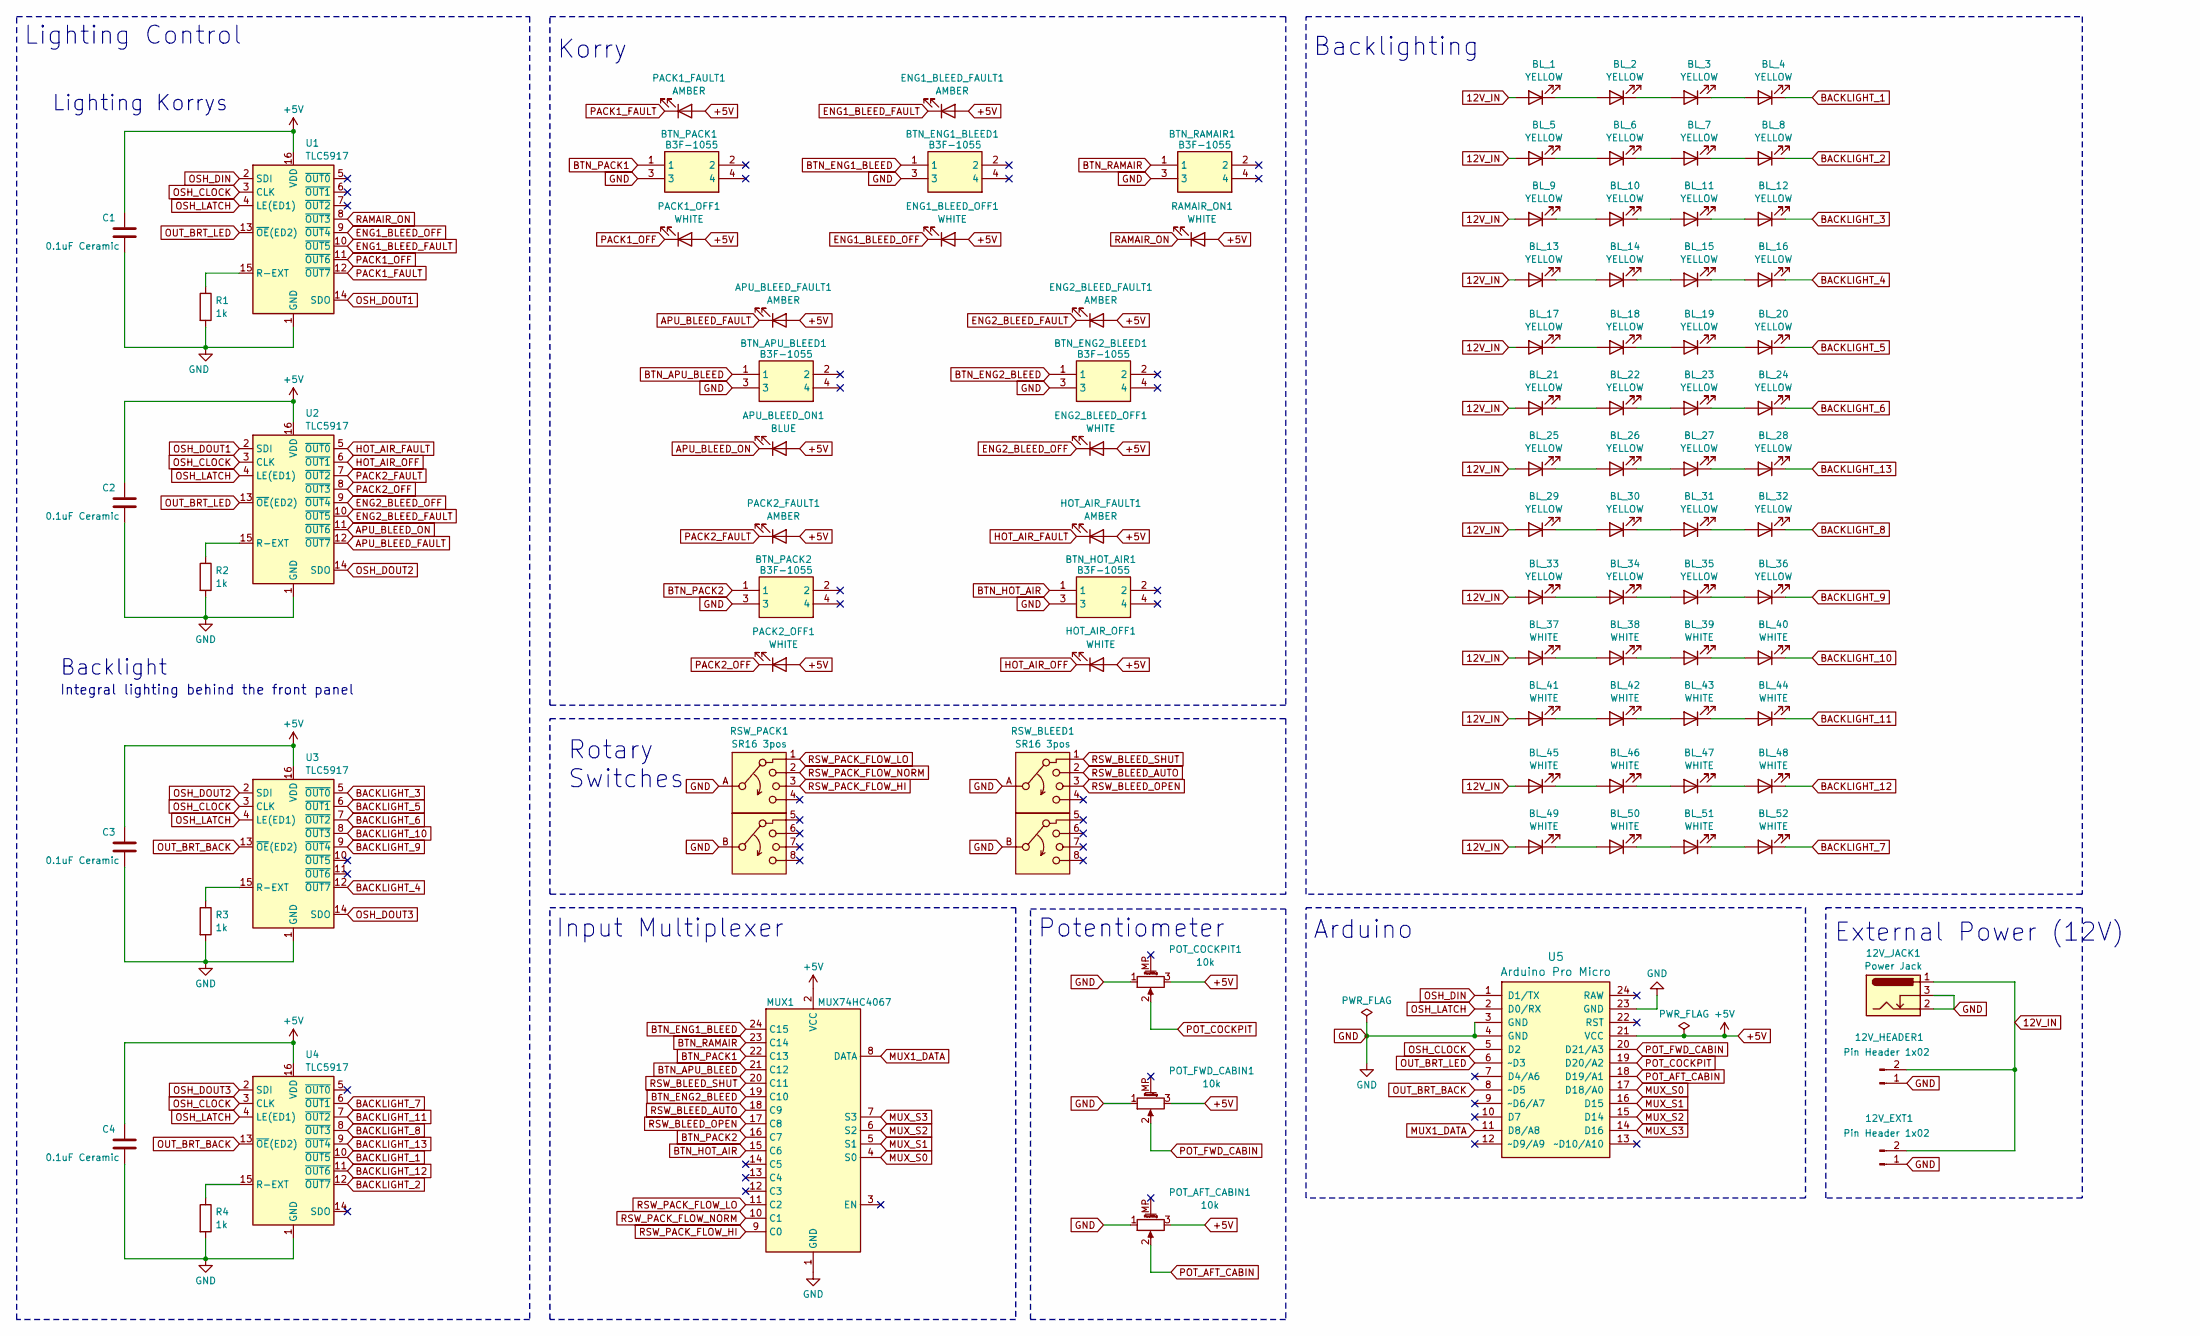
[picture p75: schematic AirCond.kicad_sch, AIR CONDitionPanel]

Parts:
12V_EXT1, 12V_HEADER1: Pin Header 1x02; JST_EH_B2B-EH-A_1x02_P2.50mm_Vertical
12V_JACK1: Power Jack; BarrelJack_Horizontal
APU_BLEED_FAULT1: AMBER; LED_D3.0mm
APU_BLEED_ON1: BLUE; LED_D3.0mm
BL_1, BL_2, BL_3, BL_4, BL_5, BL_6, BL_7, BL_8, BL_9, BL_10, BL_11, BL_12, BL_13, BL_14, BL_15, BL_16, BL_17, BL_18, BL_19, BL_20, BL_21, BL_22, BL_23, BL_24, BL_25, BL_26, BL_27, BL_28, BL_29, BL_30, BL_31, BL_32, BL_33, BL_34, BL_35, BL_36: YELLOW; LED_D3.0mm
BL_37, BL_38, BL_39, BL_40, BL_41, BL_42, BL_43, BL_44, BL_45, BL_46, BL_47, BL_48, BL_49, BL_50, BL_51, BL_52: WHITE; LED_D3.0mm
BTN_APU_BLEED1: B3F-1055; B3F1000; Mouser Part Number 653-B3F-1055
BTN_ENG1_BLEED1, BTN_ENG2_BLEED1: B3F-1055; B3F1000; Mouser Part Number 653-B3F-1055
BTN_HOT_AIR1: B3F-1055; B3F1000; Mouser Part Number 653-B3F-1055
BTN_PACK1, BTN_PACK2: B3F-1055; B3F1000; Mouser Part Number 653-B3F-1055
BTN_RAMAIR1: B3F-1055; B3F1000; Mouser Part Number 653-B3F-1055
C1, C2, C3, C4: 0.1uF Ceramic; C_Disc_D3.0mm_W1.6mm_P2.50mm
ENG1_BLEED_FAULT1, ENG2_BLEED_FAULT1: AMBER; LED_D3.0mm
ENG1_BLEED_OFF1, ENG2_BLEED_OFF1: WHITE; LED_D3.0mm
HOT_AIR_FAULT1: AMBER; LED_D3.0mm
HOT_AIR_OFF1: WHITE; LED_D3.0mm
MUX1: MUX74HC4067
PACK1_FAULT1, PACK2_FAULT1: AMBER; LED_D3.0mm
PACK1_OFF1, PACK2_OFF1: WHITE; LED_D3.0mm
POT_AFT_CABIN1: 10k; Potentiometer_Alps_RK09K_Single_Vertical
POT_COCKPIT1: 10k; Potentiometer_Alps_RK09K_Single_Vertical
POT_FWD_CABIN1: 10k; Potentiometer_Alps_RK09K_Single_Vertical
R1, R2, R3, R4: 1k; R_Axial_DIN0204_L3.6mm_D1.6mm_P7.62mm_Horizontal
RAMAIR_ON1: WHITE; LED_D3.0mm
RSW_BLEED1: SR16 3pos; SR16-AB
RSW_PACK1: SR16 3pos; SR16-AB
U1, U2, U3, U4: TLC5917; DIP-16_W7.62mm
U5: Arduino Pro Micro; Sparkfun_Pro_Micro

Connections:
12V_IN: 12V_EXT1.2, 12V_HEADER1.2, 12V_JACK1.1, BL_1.2 (A), BL_5.2 (A), BL_9.2 (A), BL_13.2 (A), BL_17.2 (A), BL_21.2 (A), BL_25.2 (A), BL_29.2 (A), BL_33.2 (A), BL_37.2 (A), BL_41.2 (A), BL_45.2 (A), BL_49.2 (A)
+5V: APU_BLEED_FAULT1.2 (A), APU_BLEED_ON1.2 (A), C1.1, C2.1, C3.1, C4.1, ENG1_BLEED_FAULT1.2 (A), ENG1_BLEED_OFF1.2 (A), ENG2_BLEED_FAULT1.2 (A), ENG2_BLEED_OFF1.2 (A), HOT_AIR_FAULT1.2 (A), HOT_AIR_OFF1.2 (A), MUX1.2 (VCC), PACK1_FAULT1.2 (A), PACK1_OFF1.2 (A), PACK2_FAULT1.2 (A), PACK2_OFF1.2 (A), POT_AFT_CABIN1.3, POT_COCKPIT1.3, POT_FWD_CABIN1.3, RAMAIR_ON1.2 (A), U1.16 (VDD), U2.16 (VDD), U3.16 (VDD), U4.16 (VDD), U5.21 (VCC)
APU_BLEED_FAULT: APU_BLEED_FAULT1.1 (K), U2.12 (~OUT7)
APU_BLEED_ON: APU_BLEED_ON1.1 (K), U2.11 (~OUT6)
BACKLIGHT_1: BL_4.1 (K), U4.10 (~OUT5)
BACKLIGHT_2: BL_8.1 (K), U4.12 (~OUT7)
BACKLIGHT_3: BL_12.1 (K), U3.5 (~OUT0)
BACKLIGHT_4: BL_16.1 (K), U3.12 (~OUT7)
BACKLIGHT_5: BL_20.1 (K), U3.6 (~OUT1)
BACKLIGHT_6: BL_24.1 (K), U3.7 (~OUT2)
BACKLIGHT_7: BL_52.1 (K), U4.6 (~OUT1)
BACKLIGHT_8: BL_32.1 (K), U4.8 (~OUT3)
BACKLIGHT_9: BL_36.1 (K), U3.9 (~OUT4)
BACKLIGHT_10: BL_40.1 (K), U3.8 (~OUT3)
BACKLIGHT_11: BL_44.1 (K), U4.7 (~OUT2)
BACKLIGHT_12: BL_48.1 (K), U4.11 (~OUT6)
BACKLIGHT_13: BL_28.1 (K), U4.9 (~OUT4)
BTN_APU_BLEED: BTN_APU_BLEED1.1, MUX1.21 (C12)
BTN_ENG1_BLEED: BTN_ENG1_BLEED1.1, MUX1.24 (C15)
BTN_ENG2_BLEED: BTN_ENG2_BLEED1.1, MUX1.19 (C10)
BTN_HOT_AIR: BTN_HOT_AIR1.1, MUX1.15 (C6)
BTN_PACK1: BTN_PACK1.1, MUX1.22 (C13)
BTN_PACK2: BTN_PACK2.1, MUX1.16 (C7)
BTN_RAMAIR: BTN_RAMAIR1.1, MUX1.23 (C14)
ENG1_BLEED_FAULT: ENG1_BLEED_FAULT1.1 (K), U1.10 (~OUT5)
ENG1_BLEED_OFF: ENG1_BLEED_OFF1.1 (K), U1.9 (~OUT4)
ENG2_BLEED_FAULT: ENG2_BLEED_FAULT1.1 (K), U2.10 (~OUT5)
ENG2_BLEED_OFF: ENG2_BLEED_OFF1.1 (K), U2.9 (~OUT4)
GND: 12V_EXT1.1, 12V_HEADER1.1, 12V_JACK1.2, 12V_JACK1.3, BTN_APU_BLEED1.3, BTN_ENG1_BLEED1.3, BTN_ENG2_BLEED1.3, BTN_HOT_AIR1.3, BTN_PACK1.3, BTN_PACK2.3, BTN_RAMAIR1.3, C1.2, C2.2, C3.2, C4.2, MUX1.1 (GND), POT_AFT_CABIN1.1, POT_COCKPIT1.1, POT_FWD_CABIN1.1, R1.2, R2.2, R3.2, R4.2, RSW_BLEED1.A, RSW_BLEED1.B, RSW_PACK1.A, RSW_PACK1.B, U1.1 (GND), U2.1 (GND), U3.1 (GND), U4.1 (GND), U5.3 (GND), U5.4 (GND), U5.23 (GND)
HOT_AIR_FAULT: HOT_AIR_FAULT1.1 (K), U2.5 (~OUT0)
HOT_AIR_OFF: HOT_AIR_OFF1.1 (K), U2.6 (~OUT1)
MUX1_DATA: MUX1.8 (DATA), U5.11 (D8/A8)
MUX_S0: MUX1.4 (S0), U5.17 (D18/A0)
MUX_S1: MUX1.5 (S1), U5.16 (D15)
MUX_S2: MUX1.6 (S2), U5.15 (D14)
MUX_S3: MUX1.7 (S3), U5.14 (D16)
unnamed: BL_1.1 (K), BL_2.2 (A)
unnamed: BL_2.1 (K), BL_3.2 (A)
unnamed: BL_3.1 (K), BL_4.2 (A)
unnamed: BL_5.1 (K), BL_6.2 (A)
unnamed: BL_6.1 (K), BL_7.2 (A)
unnamed: BL_7.1 (K), BL_8.2 (A)
unnamed: BL_9.1 (K), BL_10.2 (A)
unnamed: BL_10.1 (K), BL_11.2 (A)
unnamed: BL_11.1 (K), BL_12.2 (A)
unnamed: BL_13.1 (K), BL_14.2 (A)
unnamed: BL_14.1 (K), BL_15.2 (A)
unnamed: BL_15.1 (K), BL_16.2 (A)
unnamed: BL_17.1 (K), BL_18.2 (A)
unnamed: BL_18.1 (K), BL_19.2 (A)
unnamed: BL_19.1 (K), BL_20.2 (A)
unnamed: BL_21.1 (K), BL_22.2 (A)
unnamed: BL_22.1 (K), BL_23.2 (A)
unnamed: BL_23.1 (K), BL_24.2 (A)
unnamed: BL_25.1 (K), BL_26.2 (A)
unnamed: BL_26.1 (K), BL_27.2 (A)
unnamed: BL_27.1 (K), BL_28.2 (A)
unnamed: BL_29.1 (K), BL_30.2 (A)
unnamed: BL_30.1 (K), BL_31.2 (A)
unnamed: BL_31.1 (K), BL_32.2 (A)
unnamed: BL_33.1 (K), BL_34.2 (A)
unnamed: BL_34.1 (K), BL_35.2 (A)
unnamed: BL_35.1 (K), BL_36.2 (A)
unnamed: BL_37.1 (K), BL_38.2 (A)
unnamed: BL_38.1 (K), BL_39.2 (A)
unnamed: BL_39.1 (K), BL_40.2 (A)
unnamed: BL_41.1 (K), BL_42.2 (A)
unnamed: BL_42.1 (K), BL_43.2 (A)
unnamed: BL_43.1 (K), BL_44.2 (A)
unnamed: BL_45.1 (K), BL_46.2 (A)
unnamed: BL_46.1 (K), BL_47.2 (A)
unnamed: BL_47.1 (K), BL_48.2 (A)
unnamed: BL_49.1 (K), BL_50.2 (A)
unnamed: BL_50.1 (K), BL_51.2 (A)
unnamed: BL_51.1 (K), BL_52.2 (A)
unnamed: R1.1, U1.15 (R-EXT)
unnamed: R2.1, U2.15 (R-EXT)
unnamed: R3.1, U3.15 (R-EXT)
unnamed: R4.1, U4.15 (R-EXT)
OSH_CLOCK: U1.3 (CLK), U2.3 (CLK), U3.3 (CLK), U4.3 (CLK), U5.5 (D2)
OSH_DIN: U1.2 (SDI), U5.1 (D1/TX)
OSH_DOUT1: U1.14 (SDO), U2.2 (SDI)
OSH_DOUT2: U2.14 (SDO), U3.2 (SDI)
OSH_DOUT3: U3.14 (SDO), U4.2 (SDI)
OSH_LATCH: U1.4 (LE(ED1)), U2.4 (LE(ED1)), U3.4 (LE(ED1)), U4.4 (LE(ED1)), U5.2 (D0/RX)
OUT_BRT_BACK: U3.13 (~OE(ED2)), U4.13 (~OE(ED2)), U5.8 (~D5)
OUT_BRT_LED: U1.13 (~OE(ED2)), U2.13 (~OE(ED2)), U5.6 (~D3)
PACK1_FAULT: PACK1_FAULT1.1 (K), U1.12 (~OUT7)
PACK1_OFF: PACK1_OFF1.1 (K), U1.11 (~OUT6)
PACK2_FAULT: PACK2_FAULT1.1 (K), U2.7 (~OUT2)
PACK2_OFF: PACK2_OFF1.1 (K), U2.8 (~OUT3)
POT_AFT_CABIN: POT_AFT_CABIN1.2, U5.18 (D19/A1)
POT_COCKPIT: POT_COCKPIT1.2, U5.19 (D20/A2)
POT_FWD_CABIN: POT_FWD_CABIN1.2, U5.20 (D21/A3)
RAMAIR_ON: RAMAIR_ON1.1 (K), U1.8 (~OUT3)
RSW_BLEED_AUTO: MUX1.18 (C9), RSW_BLEED1.2
RSW_BLEED_OPEN: MUX1.17 (C8), RSW_BLEED1.3
RSW_BLEED_SHUT: MUX1.20 (C11), RSW_BLEED1.1
RSW_PACK_FLOW_HI: MUX1.9 (C0), RSW_PACK1.3
RSW_PACK_FLOW_LO: MUX1.11 (C2), RSW_PACK1.1
RSW_PACK_FLOW_NORM: MUX1.10 (C1), RSW_PACK1.2

Notes on the sheet:
Backlighting
Arduino
Rotary Switches
Korry
Potentiometer
Input Multiplexer
External Power (12V)
Lighting Korrys
Lighting Control
Integral lighting behind the front panel
Backlight

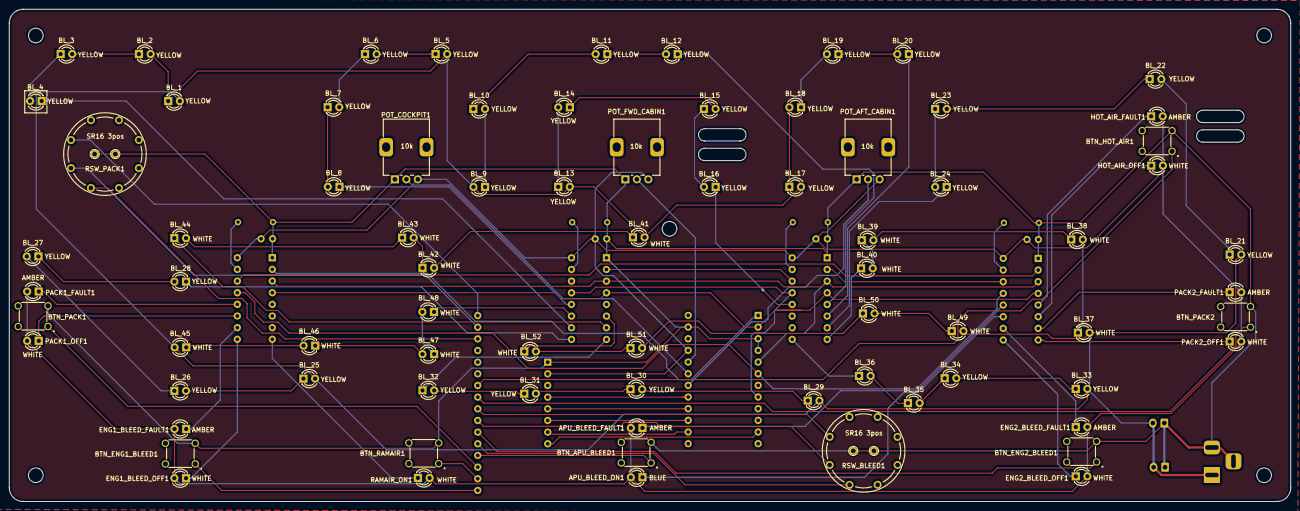
[picture p76: board AirCond.kicad_pcb from above]

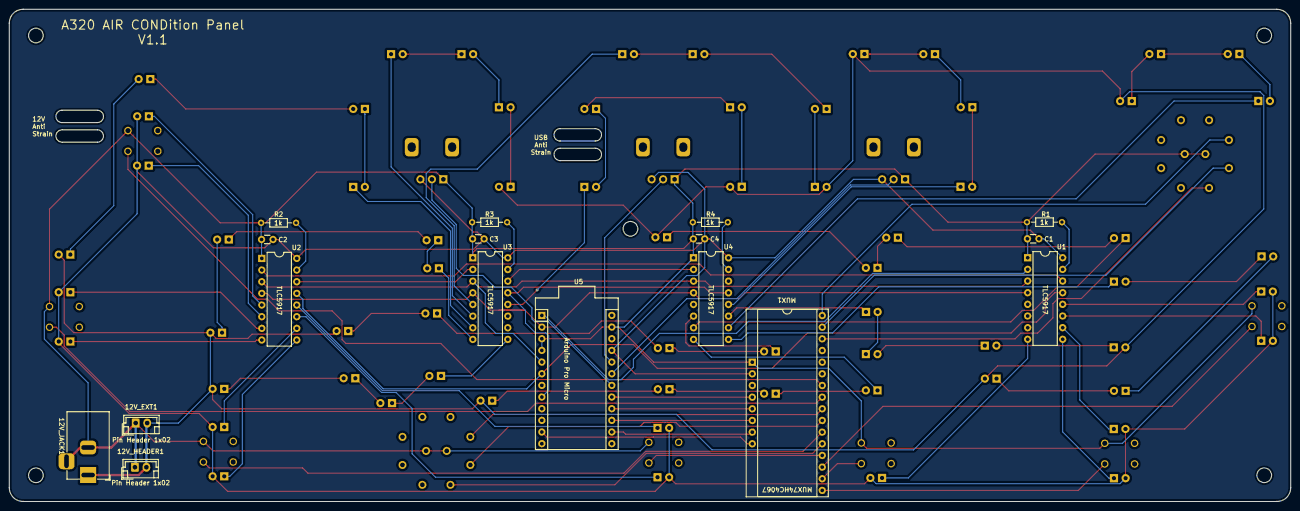
[picture p77: board AirCond.kicad_pcb from below]

Board: 2 copper layers, 279.2 x 107.2 mm, 94 parts (17 on the bottom side), 101 nets.
