SK-MH/A320-PCBs/1 - OVERHEAD/1.3 FLTCTL/KiCAD/FLT_CTL.kicad_pcb

## KiCad design 1 - OVERHEAD/1.3 FLTCTL/KiCAD/FLT_CTL.kicad_pcb (2025-01-06)

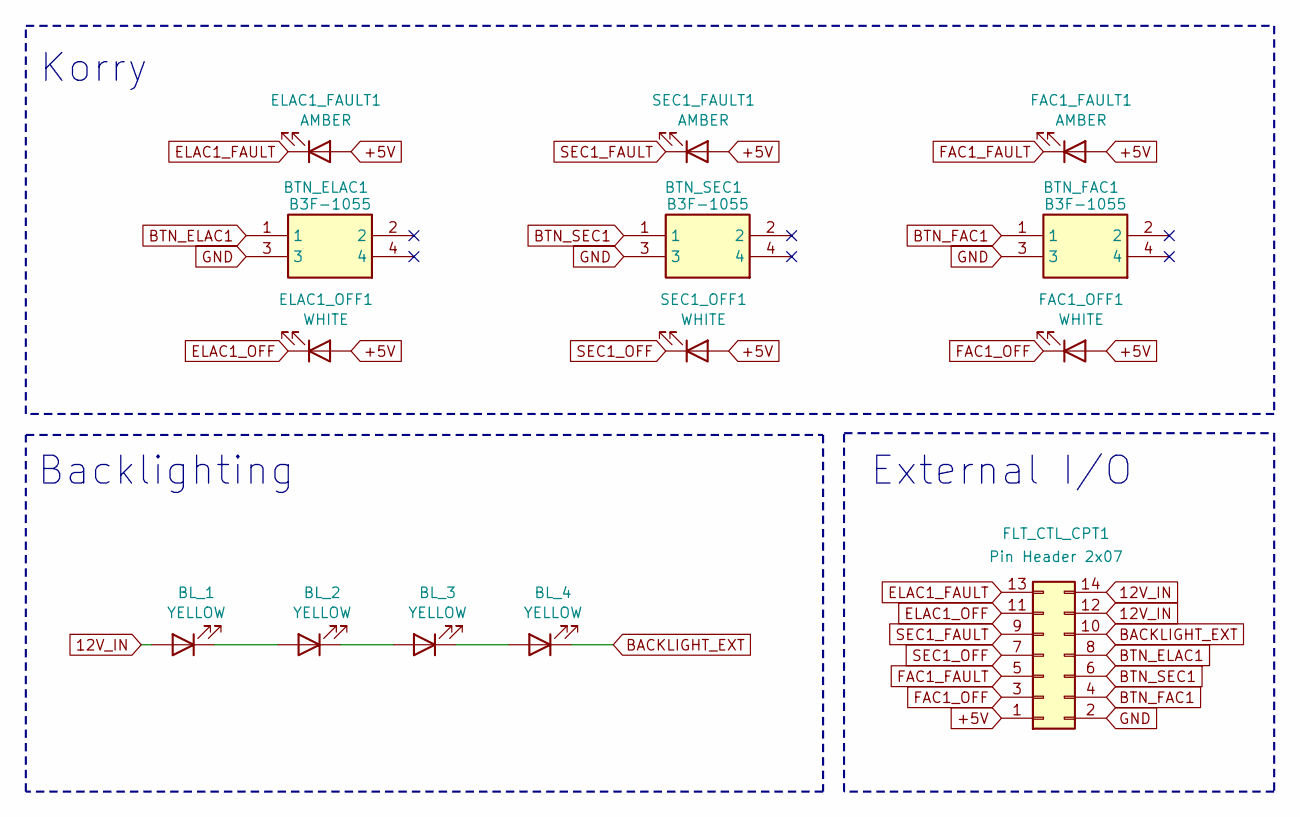
[picture p78: schematic FLT_CTL.kicad_sch, FLT CTL Panel]

Parts:
BL_1, BL_2, BL_3, BL_4: YELLOW; LED_D3.0mm
BTN_ELAC1: B3F-1055; B3F1000; Mouser Part Number 653-B3F-1055
BTN_FAC1: B3F-1055; B3F1000; Mouser Part Number 653-B3F-1055
BTN_SEC1: B3F-1055; B3F1000; Mouser Part Number 653-B3F-1055
ELAC1_FAULT1: AMBER; LED_D3.0mm
ELAC1_OFF1: WHITE; LED_D3.0mm
FAC1_FAULT1: AMBER; LED_D3.0mm
FAC1_OFF1: WHITE; LED_D3.0mm
FLT_CTL_CPT1: Pin Header 2x07; IDC-Header_2x07_P2.54mm_Vertical
SEC1_FAULT1: AMBER; LED_D3.0mm
SEC1_OFF1: WHITE; LED_D3.0mm

Connections:
12V_IN: BL_1.2 (A), FLT_CTL_CPT1.12, FLT_CTL_CPT1.14
+5V: ELAC1_FAULT1.2 (A), ELAC1_OFF1.2 (A), FAC1_FAULT1.2 (A), FAC1_OFF1.2 (A), FLT_CTL_CPT1.1, SEC1_FAULT1.2 (A), SEC1_OFF1.2 (A)
BACKLIGHT_EXT: BL_4.1 (K), FLT_CTL_CPT1.10
BTN_ELAC1: BTN_ELAC1.1, FLT_CTL_CPT1.8
BTN_FAC1: BTN_FAC1.1, FLT_CTL_CPT1.4
BTN_SEC1: BTN_SEC1.1, FLT_CTL_CPT1.6
ELAC1_FAULT: ELAC1_FAULT1.1 (K), FLT_CTL_CPT1.13
ELAC1_OFF: ELAC1_OFF1.1 (K), FLT_CTL_CPT1.11
FAC1_FAULT: FAC1_FAULT1.1 (K), FLT_CTL_CPT1.5
FAC1_OFF: FAC1_OFF1.1 (K), FLT_CTL_CPT1.3
GND: BTN_ELAC1.3, BTN_FAC1.3, BTN_SEC1.3, FLT_CTL_CPT1.2
unnamed: BL_1.1 (K), BL_2.2 (A)
unnamed: BL_2.1 (K), BL_3.2 (A)
unnamed: BL_3.1 (K), BL_4.2 (A)
SEC1_FAULT: FLT_CTL_CPT1.9, SEC1_FAULT1.1 (K)
SEC1_OFF: FLT_CTL_CPT1.7, SEC1_OFF1.1 (K)

Notes on the sheet:
Backlighting
External I/O
Korry

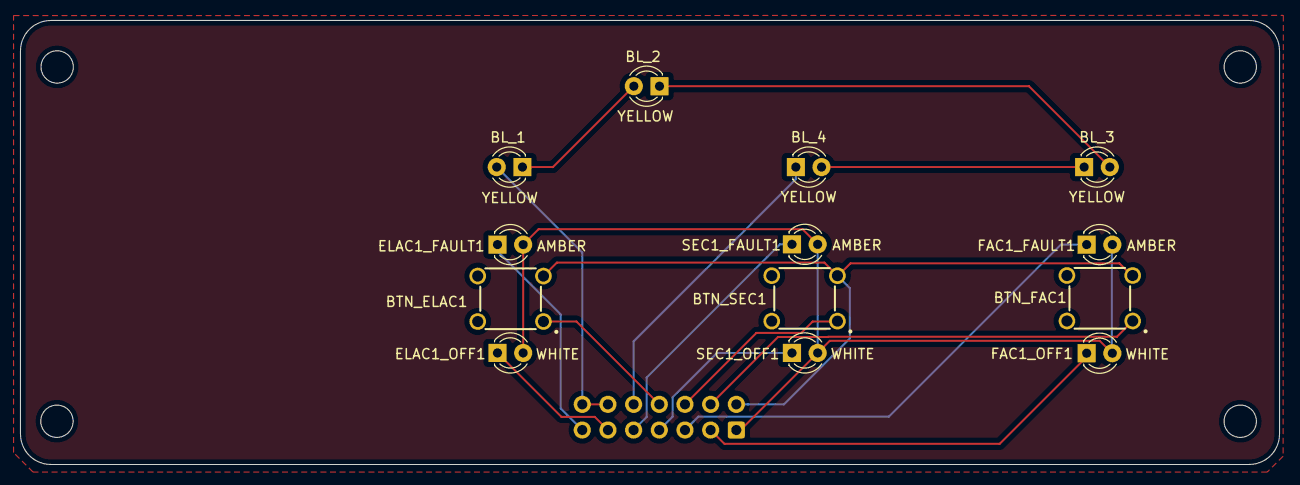
[picture p79: board FLT_CTL.kicad_pcb from above]

Board: 2 copper layers, 124.6 x 43.9 mm, 14 parts (1 on the bottom side), 16 nets.
