SK-MH/A320-PCBs/1 - OVERHEAD/1.5 FIRE/KiCAD/FIRE Neu.kicad_pcb

## KiCad design 1 - OVERHEAD/1.5 FIRE/KiCAD/FIRE Neu.kicad_pcb (2025-01-06)

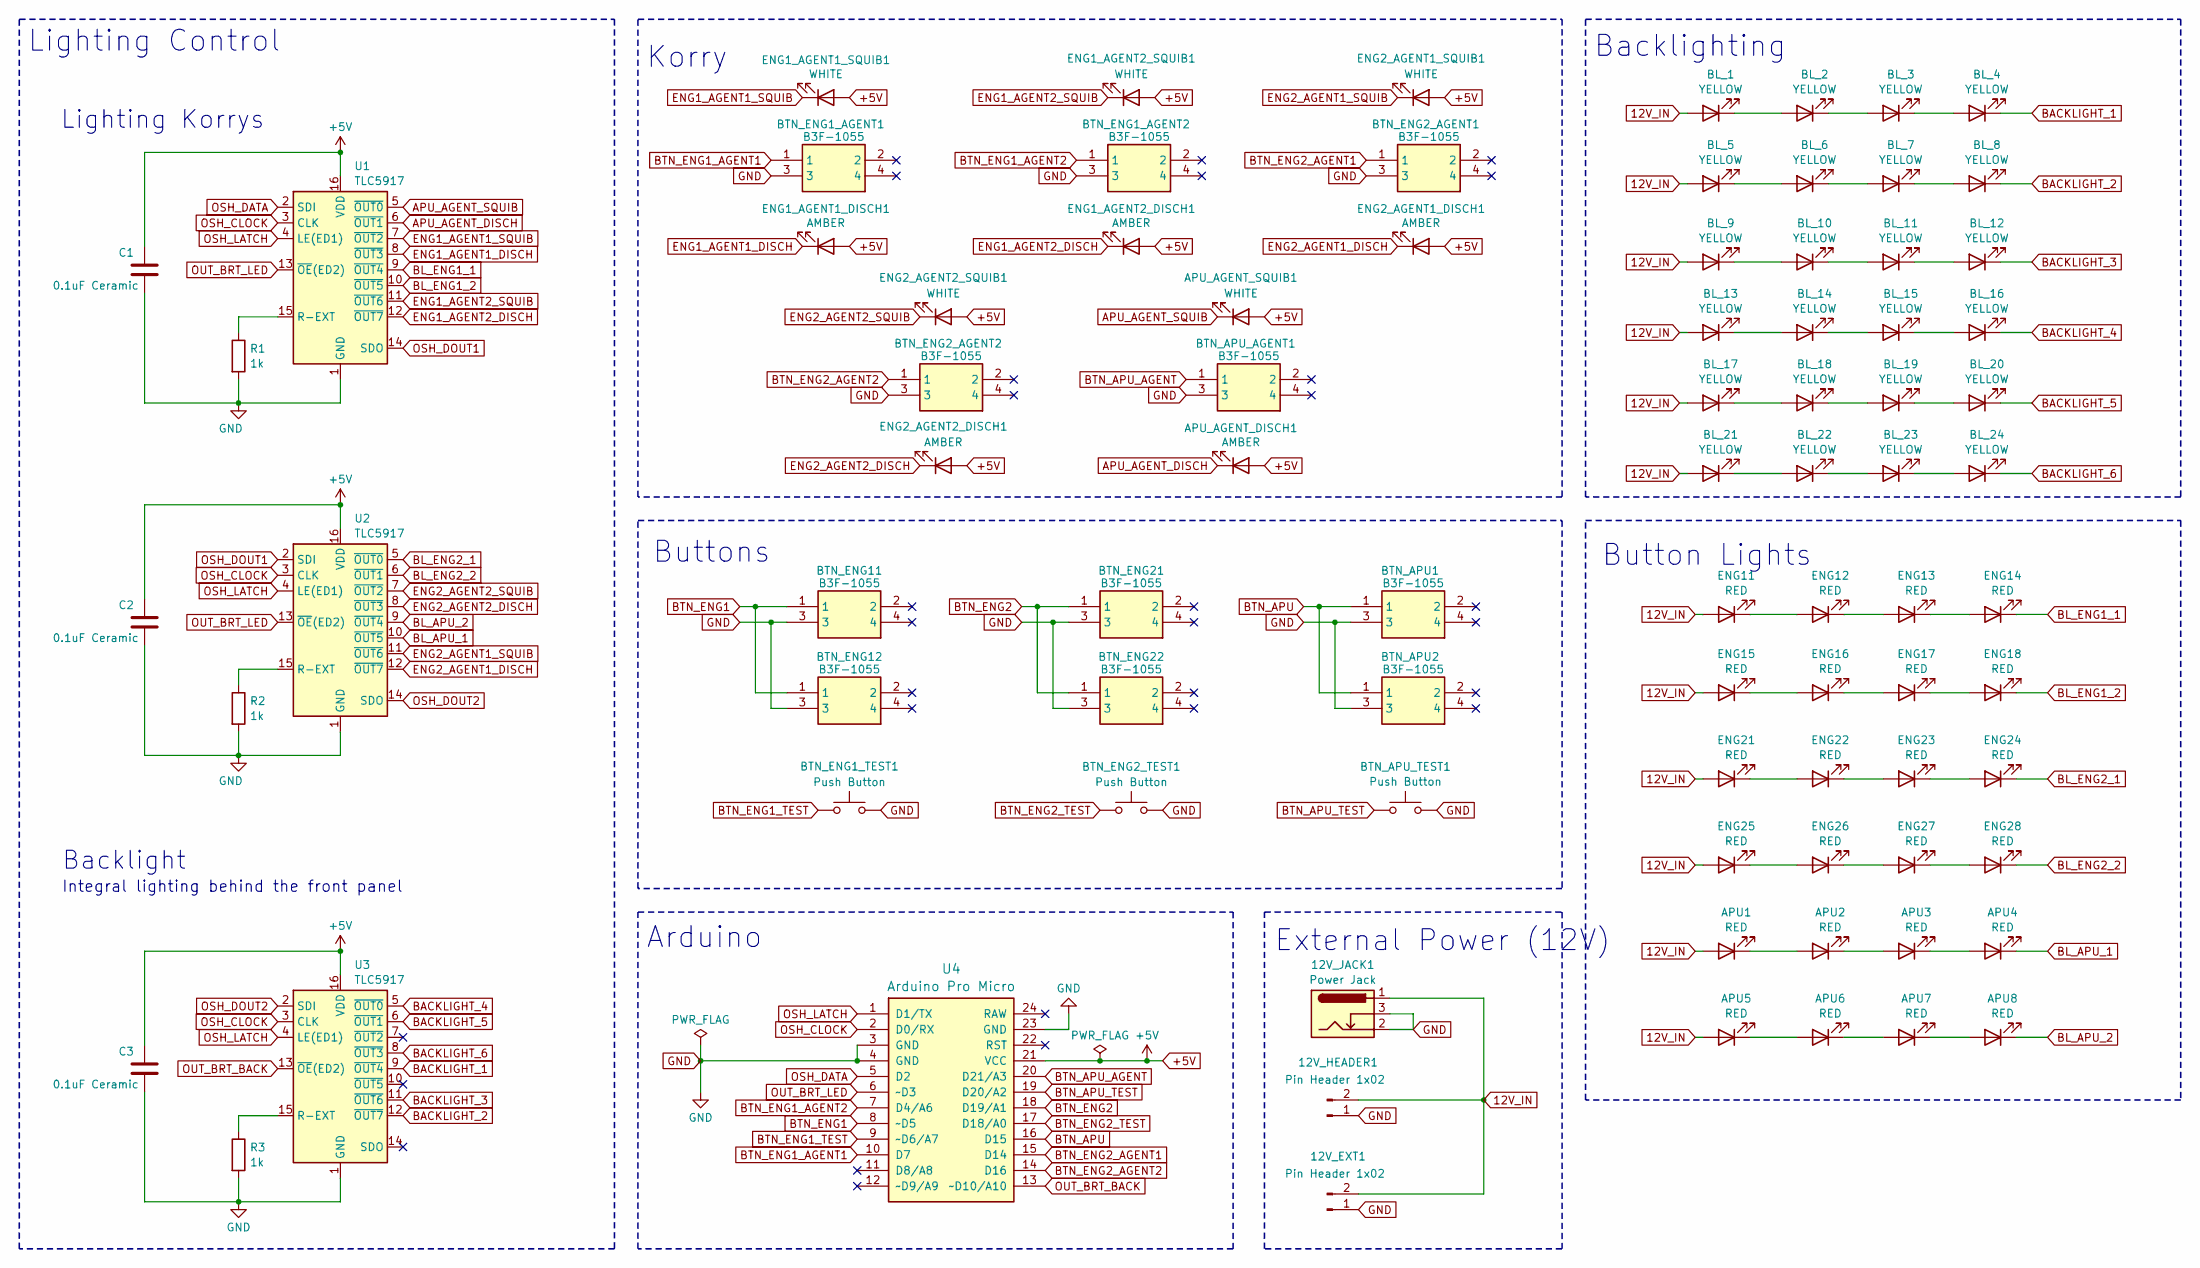
[picture p80: schematic FIRE Neu.kicad_sch, FIRE Panel]

Parts:
12V_EXT1, 12V_HEADER1: Pin Header 1x02; JST_EH_B2B-EH-A_1x02_P2.50mm_Vertical
12V_JACK1: Power Jack; BarrelJack_Horizontal
APU1, APU2, APU3, APU4, APU5, APU6, APU7, APU8: RED; LED_D3.0mm
APU_AGENT_DISCH1: AMBER; LED_D3.0mm
APU_AGENT_SQUIB1: WHITE; LED_D3.0mm
BL_1, BL_2, BL_3, BL_4, BL_5, BL_6, BL_7, BL_8, BL_9, BL_10, BL_11, BL_12, BL_13, BL_14, BL_15, BL_16, BL_17, BL_18, BL_19, BL_20, BL_21, BL_22, BL_23, BL_24: YELLOW; LED_D3.0mm
BTN_APU1, BTN_APU2: B3F-1055; B3F1000; Mouser Part Number 653-B3F-1055
BTN_APU_AGENT1: B3F-1055; B3F1000; Mouser Part Number 653-B3F-1055
BTN_APU_TEST1: Push Button; SW-Push
BTN_ENG1_AGENT1, BTN_ENG1_AGENT2, BTN_ENG2_AGENT1, BTN_ENG2_AGENT2, BTN_ENG11, BTN_ENG12, BTN_ENG21, BTN_ENG22: B3F-1055; B3F1000; Mouser Part Number 653-B3F-1055
BTN_ENG1_TEST1, BTN_ENG2_TEST1: Push Button; SW-Push
C1, C2, C3: 0.1uF Ceramic; C_Disc_D3.0mm_W1.6mm_P2.50mm
ENG1_AGENT1_DISCH1, ENG1_AGENT2_DISCH1, ENG2_AGENT1_DISCH1, ENG2_AGENT2_DISCH1: AMBER; LED_D3.0mm
ENG1_AGENT1_SQUIB1, ENG1_AGENT2_SQUIB1, ENG2_AGENT1_SQUIB1, ENG2_AGENT2_SQUIB1: WHITE; LED_D3.0mm
ENG11, ENG12, ENG13, ENG14, ENG15, ENG16, ENG17, ENG18, ENG21, ENG22, ENG23, ENG24, ENG25, ENG26, ENG27, ENG28: RED; LED_D3.0mm
R1, R2, R3: 1k; R_Axial_DIN0204_L3.6mm_D1.6mm_P5.08mm_Horizontal
U1, U2, U3: TLC5917; DIP-16_W7.62mm
U4: Arduino Pro Micro; Sparkfun_Pro_Micro

Connections:
12V_IN: 12V_EXT1.2, 12V_HEADER1.2, 12V_JACK1.1, APU1.2 (A), APU5.2 (A), BL_1.2 (A), BL_5.2 (A), BL_9.2 (A), BL_13.2 (A), BL_17.2 (A), BL_21.2 (A), ENG11.2 (A), ENG15.2 (A), ENG21.2 (A), ENG25.2 (A)
+5V: APU_AGENT_DISCH1.2 (A), APU_AGENT_SQUIB1.2 (A), C1.1, C2.1, C3.1, ENG1_AGENT1_DISCH1.2 (A), ENG1_AGENT1_SQUIB1.2 (A), ENG1_AGENT2_DISCH1.2 (A), ENG1_AGENT2_SQUIB1.2 (A), ENG2_AGENT1_DISCH1.2 (A), ENG2_AGENT1_SQUIB1.2 (A), ENG2_AGENT2_DISCH1.2 (A), ENG2_AGENT2_SQUIB1.2 (A), U1.16 (VDD), U2.16 (VDD), U3.16 (VDD), U4.21 (VCC)
APU_AGENT_DISCH: APU_AGENT_DISCH1.1 (K), U1.6 (~OUT1)
APU_AGENT_SQUIB: APU_AGENT_SQUIB1.1 (K), U1.5 (~OUT0)
BACKLIGHT_1: BL_4.1 (K), U3.9 (~OUT4)
BACKLIGHT_2: BL_8.1 (K), U3.12 (~OUT7)
BACKLIGHT_3: BL_12.1 (K), U3.11 (~OUT6)
BACKLIGHT_4: BL_16.1 (K), U3.5 (~OUT0)
BACKLIGHT_5: BL_20.1 (K), U3.6 (~OUT1)
BACKLIGHT_6: BL_24.1 (K), U3.8 (~OUT3)
BL_APU_1: APU4.1 (K), U2.10 (~OUT5)
BL_APU_2: APU8.1 (K), U2.9 (~OUT4)
BL_ENG1_1: ENG14.1 (K), U1.9 (~OUT4)
BL_ENG1_2: ENG18.1 (K), U1.10 (~OUT5)
BL_ENG2_1: ENG24.1 (K), U2.5 (~OUT0)
BL_ENG2_2: ENG28.1 (K), U2.6 (~OUT1)
BTN_APU: BTN_APU1.1, BTN_APU2.1, U4.16 (D15)
BTN_APU_AGENT: BTN_APU_AGENT1.1, U4.20 (D21/A3)
BTN_APU_TEST: BTN_APU_TEST1.1, U4.19 (D20/A2)
BTN_ENG1: BTN_ENG11.1, BTN_ENG12.1, U4.8 (~D5)
BTN_ENG1_AGENT1: BTN_ENG1_AGENT1.1, U4.10 (D7)
BTN_ENG1_AGENT2: BTN_ENG1_AGENT2.1, U4.7 (D4/A6)
BTN_ENG1_TEST: BTN_ENG1_TEST1.1, U4.9 (~D6/A7)
BTN_ENG2: BTN_ENG21.1, BTN_ENG22.1, U4.18 (D19/A1)
BTN_ENG2_AGENT1: BTN_ENG2_AGENT1.1, U4.15 (D14)
BTN_ENG2_AGENT2: BTN_ENG2_AGENT2.1, U4.14 (D16)
BTN_ENG2_TEST: BTN_ENG2_TEST1.1, U4.17 (D18/A0)
ENG1_AGENT1_DISCH: ENG1_AGENT1_DISCH1.1 (K), U1.8 (~OUT3)
ENG1_AGENT1_SQUIB: ENG1_AGENT1_SQUIB1.1 (K), U1.7 (~OUT2)
ENG1_AGENT2_DISCH: ENG1_AGENT2_DISCH1.1 (K), U1.12 (~OUT7)
ENG1_AGENT2_SQUIB: ENG1_AGENT2_SQUIB1.1 (K), U1.11 (~OUT6)
ENG2_AGENT1_DISCH: ENG2_AGENT1_DISCH1.1 (K), U2.12 (~OUT7)
ENG2_AGENT1_SQUIB: ENG2_AGENT1_SQUIB1.1 (K), U2.11 (~OUT6)
ENG2_AGENT2_DISCH: ENG2_AGENT2_DISCH1.1 (K), U2.8 (~OUT3)
ENG2_AGENT2_SQUIB: ENG2_AGENT2_SQUIB1.1 (K), U2.7 (~OUT2)
GND: 12V_EXT1.1, 12V_HEADER1.1, 12V_JACK1.2, 12V_JACK1.3, BTN_APU1.3, BTN_APU2.3, BTN_APU_AGENT1.3, BTN_APU_TEST1.2, BTN_ENG1_AGENT1.3, BTN_ENG1_AGENT2.3, BTN_ENG1_TEST1.2, BTN_ENG2_AGENT1.3, BTN_ENG2_AGENT2.3, BTN_ENG2_TEST1.2, BTN_ENG11.3, BTN_ENG12.3, BTN_ENG21.3, BTN_ENG22.3, C1.2, C2.2, C3.2, R1.2, R2.2, R3.2, U1.1 (GND), U2.1 (GND), U3.1 (GND), U4.3 (GND), U4.4 (GND), U4.23 (GND)
unnamed: APU1.1 (K), APU2.2 (A)
unnamed: APU2.1 (K), APU3.2 (A)
unnamed: APU3.1 (K), APU4.2 (A)
unnamed: APU5.1 (K), APU6.2 (A)
unnamed: APU6.1 (K), APU7.2 (A)
unnamed: APU7.1 (K), APU8.2 (A)
unnamed: BL_1.1 (K), BL_2.2 (A)
unnamed: BL_2.1 (K), BL_3.2 (A)
unnamed: BL_3.1 (K), BL_4.2 (A)
unnamed: BL_5.1 (K), BL_6.2 (A)
unnamed: BL_6.1 (K), BL_7.2 (A)
unnamed: BL_7.1 (K), BL_8.2 (A)
unnamed: BL_9.1 (K), BL_10.2 (A)
unnamed: BL_10.1 (K), BL_11.2 (A)
unnamed: BL_11.1 (K), BL_12.2 (A)
unnamed: BL_13.1 (K), BL_14.2 (A)
unnamed: BL_14.1 (K), BL_15.2 (A)
unnamed: BL_15.1 (K), BL_16.2 (A)
unnamed: BL_17.1 (K), BL_18.2 (A)
unnamed: BL_18.1 (K), BL_19.2 (A)
unnamed: BL_19.1 (K), BL_20.2 (A)
unnamed: BL_21.1 (K), BL_22.2 (A)
unnamed: BL_22.1 (K), BL_23.2 (A)
unnamed: BL_23.1 (K), BL_24.2 (A)
unnamed: ENG11.1 (K), ENG12.2 (A)
unnamed: ENG12.1 (K), ENG13.2 (A)
unnamed: ENG13.1 (K), ENG14.2 (A)
unnamed: ENG15.1 (K), ENG16.2 (A)
unnamed: ENG16.1 (K), ENG17.2 (A)
unnamed: ENG17.1 (K), ENG18.2 (A)
unnamed: ENG21.1 (K), ENG22.2 (A)
unnamed: ENG22.1 (K), ENG23.2 (A)
unnamed: ENG23.1 (K), ENG24.2 (A)
unnamed: ENG25.1 (K), ENG26.2 (A)
unnamed: ENG26.1 (K), ENG27.2 (A)
unnamed: ENG27.1 (K), ENG28.2 (A)
unnamed: R1.1, U1.15 (R-EXT)
unnamed: R2.1, U2.15 (R-EXT)
unnamed: R3.1, U3.15 (R-EXT)
OSH_CLOCK: U1.3 (CLK), U2.3 (CLK), U3.3 (CLK), U4.2 (D0/RX)
OSH_DATA: U1.2 (SDI), U4.5 (D2)
OSH_DOUT1: U1.14 (SDO), U2.2 (SDI)
OSH_DOUT2: U2.14 (SDO), U3.2 (SDI)
OSH_LATCH: U1.4 (LE(ED1)), U2.4 (LE(ED1)), U3.4 (LE(ED1)), U4.1 (D1/TX)
OUT_BRT_BACK: U3.13 (~OE(ED2)), U4.13 (~D10/A10)
OUT_BRT_LED: U1.13 (~OE(ED2)), U2.13 (~OE(ED2)), U4.6 (~D3)

Notes on the sheet:
Arduino
Button Lights
Buttons
Korry
Backlighting
External Power (12V)
Lighting Korrys
Lighting Control
Integral lighting behind the front panel
Backlight

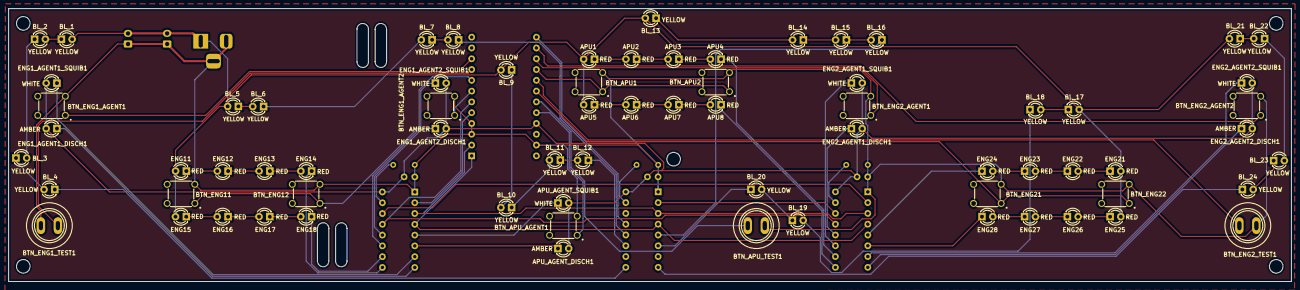
[picture p81: board FIRE Neu.kicad_pcb from above]

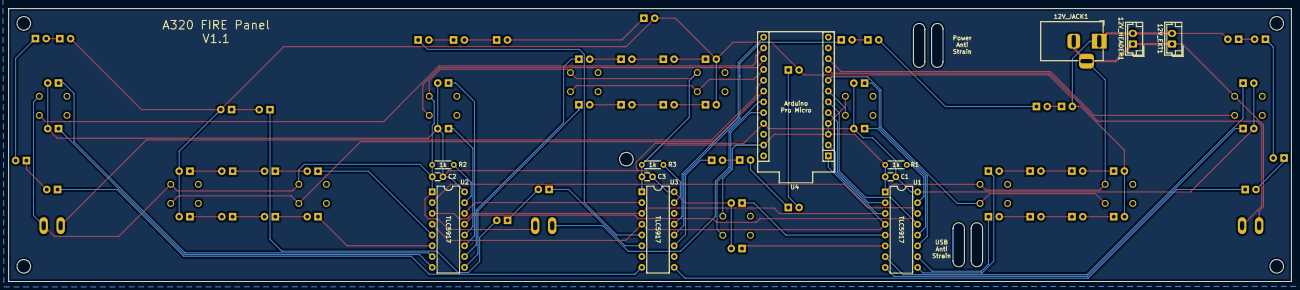
[picture p82: board FIRE Neu.kicad_pcb from below]

Board: 2 copper layers, 302.0 x 64.2 mm, 85 parts (13 on the bottom side), 82 nets.
