SK-MH/A320-PCBs/1 - OVERHEAD/1.9 LIGHTS/KiCAD/Lights.kicad_pcb

## KiCad design 1 - OVERHEAD/1.9 LIGHTS/KiCAD/Lights.kicad_pcb (2025-01-06)

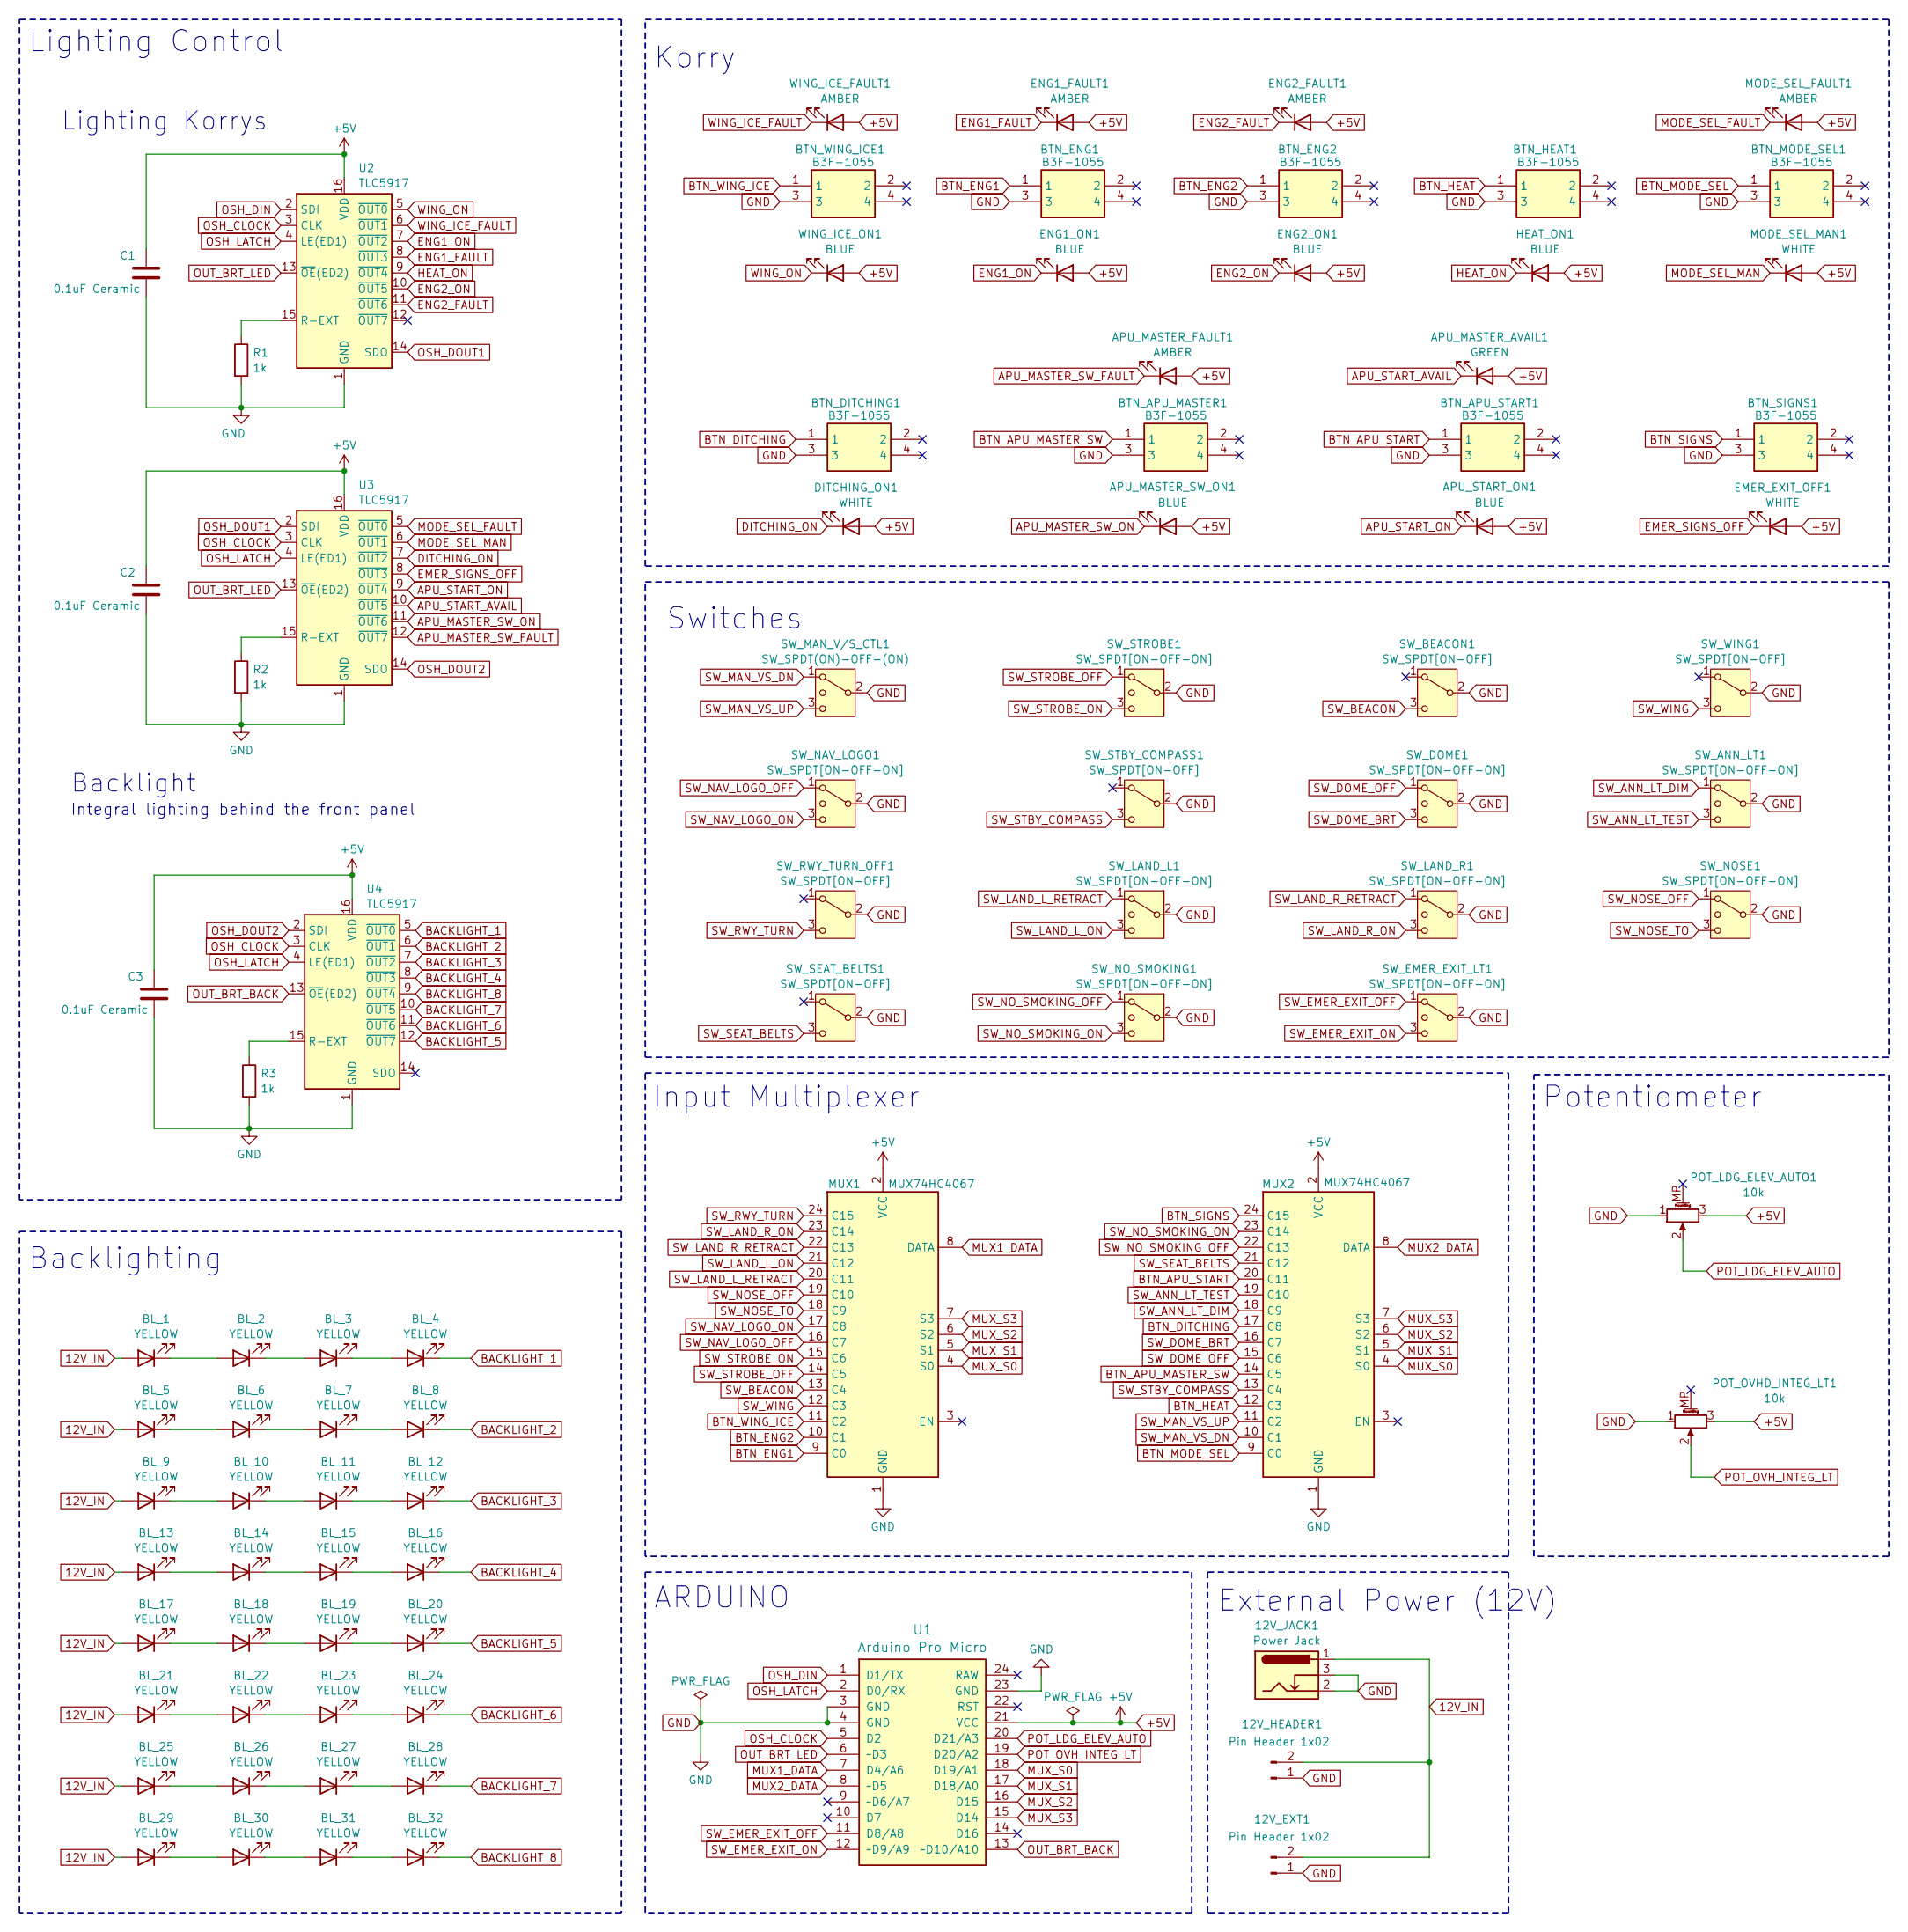
[picture p83: schematic Lights.kicad_sch, Light Panel]

Parts:
12V_EXT1, 12V_HEADER1: Pin Header 1x02; JST_EH_B2B-EH-A_1x02_P2.50mm_Vertical
12V_JACK1: Power Jack; BarrelJack_Horizontal
APU_MASTER_AVAIL1: GREEN; LED_D3.0mm
APU_MASTER_FAULT1: AMBER; LED_D3.0mm
APU_MASTER_SW_ON1: BLUE; LED_D3.0mm
APU_START_ON1: BLUE; LED_D3.0mm
BL_1, BL_2, BL_3, BL_4, BL_5, BL_6, BL_7, BL_8, BL_9, BL_10, BL_11, BL_12, BL_13, BL_14, BL_15, BL_16, BL_17, BL_18, BL_19, BL_20, BL_21, BL_22, BL_23, BL_24, BL_25, BL_26, BL_27, BL_28, BL_29, BL_30, BL_31, BL_32: YELLOW; LED_D3.0mm
BTN_APU_MASTER1: B3F-1055; B3F1000; Mouser Part Number 653-B3F-1055
BTN_APU_START1: B3F-1055; B3F1000; Mouser Part Number 653-B3F-1055
BTN_DITCHING1: B3F-1055; B3F1000; Mouser Part Number 653-B3F-1055
BTN_ENG1, BTN_ENG2: B3F-1055; B3F1000; Mouser Part Number 653-B3F-1055
BTN_HEAT1: B3F-1055; B3F1000; Mouser Part Number 653-B3F-1055
BTN_MODE_SEL1: B3F-1055; B3F1000; Mouser Part Number 653-B3F-1055
BTN_SIGNS1: B3F-1055; B3F1000; Mouser Part Number 653-B3F-1055
BTN_WING_ICE1: B3F-1055; B3F1000; Mouser Part Number 653-B3F-1055
C1, C2, C3: 0.1uF Ceramic; C_Disc_D3.0mm_W1.6mm_P2.50mm
DITCHING_ON1: WHITE; LED_D3.0mm
EMER_EXIT_OFF1: WHITE; LED_D3.0mm
ENG1_FAULT1, ENG2_FAULT1: AMBER; LED_D3.0mm
ENG1_ON1, ENG2_ON1: BLUE; LED_D3.0mm
HEAT_ON1: BLUE; LED_D3.0mm
MODE_SEL_FAULT1: AMBER; LED_D3.0mm
MODE_SEL_MAN1: WHITE; LED_D3.0mm
MUX1, MUX2: MUX74HC4067
POT_LDG_ELEV_AUTO1: 10k; Potentiometer_Alps_RK09K_Single_Vertical
POT_OVHD_INTEG_LT1: 10k; Potentiometer_Alps_RK09K_Single_Vertical
R1, R2, R3: 1k; R_Axial_DIN0204_L3.6mm_D1.6mm_P5.08mm_Horizontal
SW_ANN_LT1: SW_SPDT[ON-OFF-ON]; T80-Z1
SW_BEACON1: SW_SPDT[ON-OFF]; T80-Z1
SW_DOME1: SW_SPDT[ON-OFF-ON]; T80-Z1
SW_EMER_EXIT_LT1: SW_SPDT[ON-OFF-ON]; T80-Z1
SW_LAND_L1: SW_SPDT[ON-OFF-ON]; T80-Z1
SW_LAND_R1: SW_SPDT[ON-OFF-ON]; T80-Z1
SW_MAN_V/S_CTL1: SW_SPDT(ON)-OFF-(ON); T80-Z1
SW_NAV_LOGO1: SW_SPDT[ON-OFF-ON]; T80-Z1
SW_NOSE1: SW_SPDT[ON-OFF-ON]; T80-Z1
SW_NO_SMOKING1: SW_SPDT[ON-OFF-ON]; T80-Z1
SW_RWY_TURN_OFF1: SW_SPDT[ON-OFF]; T80-Z1
SW_SEAT_BELTS1: SW_SPDT[ON-OFF]; T80-Z1
SW_STBY_COMPASS1: SW_SPDT[ON-OFF]; T80-Z1
SW_STROBE1: SW_SPDT[ON-OFF-ON]; T80-Z1
SW_WING1: SW_SPDT[ON-OFF]; T80-Z1
U1: Arduino Pro Micro; Sparkfun_Pro_Micro
U2, U3, U4: TLC5917; DIP-16_W7.62mm
WING_ICE_FAULT1: AMBER; LED_D3.0mm
WING_ICE_ON1: BLUE; LED_D3.0mm

Connections:
12V_IN: 12V_EXT1.2, 12V_HEADER1.2, 12V_JACK1.1, BL_1.2 (A), BL_5.2 (A), BL_9.2 (A), BL_13.2 (A), BL_17.2 (A), BL_21.2 (A), BL_25.2 (A), BL_29.2 (A)
+5V: APU_MASTER_AVAIL1.2 (A), APU_MASTER_FAULT1.2 (A), APU_MASTER_SW_ON1.2 (A), APU_START_ON1.2 (A), C1.1, C2.1, C3.1, DITCHING_ON1.2 (A), EMER_EXIT_OFF1.2 (A), ENG1_FAULT1.2 (A), ENG1_ON1.2 (A), ENG2_FAULT1.2 (A), ENG2_ON1.2 (A), HEAT_ON1.2 (A), MODE_SEL_FAULT1.2 (A), MODE_SEL_MAN1.2 (A), MUX1.2 (VCC), MUX2.2 (VCC), POT_LDG_ELEV_AUTO1.3, POT_OVHD_INTEG_LT1.3, U1.21 (VCC), U2.16 (VDD), U3.16 (VDD), U4.16 (VDD), WING_ICE_FAULT1.2 (A), WING_ICE_ON1.2 (A)
APU_MASTER_SW_FAULT: APU_MASTER_FAULT1.1 (K), U3.12 (~OUT7)
APU_MASTER_SW_ON: APU_MASTER_SW_ON1.1 (K), U3.11 (~OUT6)
APU_START_AVAIL: APU_MASTER_AVAIL1.1 (K), U3.10 (~OUT5)
APU_START_ON: APU_START_ON1.1 (K), U3.9 (~OUT4)
BACKLIGHT_1: BL_4.1 (K), U4.5 (~OUT0)
BACKLIGHT_2: BL_8.1 (K), U4.6 (~OUT1)
BACKLIGHT_3: BL_12.1 (K), U4.7 (~OUT2)
BACKLIGHT_4: BL_16.1 (K), U4.8 (~OUT3)
BACKLIGHT_5: BL_20.1 (K), U4.12 (~OUT7)
BACKLIGHT_6: BL_24.1 (K), U4.11 (~OUT6)
BACKLIGHT_7: BL_28.1 (K), U4.10 (~OUT5)
BACKLIGHT_8: BL_32.1 (K), U4.9 (~OUT4)
BTN_APU_MASTER_SW: BTN_APU_MASTER1.1, MUX2.14 (C5)
BTN_APU_START: BTN_APU_START1.1, MUX2.20 (C11)
BTN_DITCHING: BTN_DITCHING1.1, MUX2.17 (C8)
BTN_ENG1: BTN_ENG1.1, MUX1.9 (C0)
BTN_ENG2: BTN_ENG2.1, MUX1.10 (C1)
BTN_HEAT: BTN_HEAT1.1, MUX2.12 (C3)
BTN_MODE_SEL: BTN_MODE_SEL1.1, MUX2.9 (C0)
BTN_SIGNS: BTN_SIGNS1.1, MUX2.24 (C15)
BTN_WING_ICE: BTN_WING_ICE1.1, MUX1.11 (C2)
DITCHING_ON: DITCHING_ON1.1 (K), U3.7 (~OUT2)
EMER_SIGNS_OFF: EMER_EXIT_OFF1.1 (K), U3.8 (~OUT3)
ENG1_FAULT: ENG1_FAULT1.1 (K), U2.8 (~OUT3)
ENG1_ON: ENG1_ON1.1 (K), U2.7 (~OUT2)
ENG2_FAULT: ENG2_FAULT1.1 (K), U2.11 (~OUT6)
ENG2_ON: ENG2_ON1.1 (K), U2.10 (~OUT5)
GND: 12V_EXT1.1, 12V_HEADER1.1, 12V_JACK1.2, 12V_JACK1.3, BTN_APU_MASTER1.3, BTN_APU_START1.3, BTN_DITCHING1.3, BTN_ENG1.3, BTN_ENG2.3, BTN_HEAT1.3, BTN_MODE_SEL1.3, BTN_SIGNS1.3, BTN_WING_ICE1.3, C1.2, C2.2, C3.2, MUX1.1 (GND), MUX2.1 (GND), POT_LDG_ELEV_AUTO1.1, POT_OVHD_INTEG_LT1.1, R1.2, R2.2, R3.2, SW_ANN_LT1.2 (3), SW_BEACON1.2 (B), SW_DOME1.2 (3), SW_EMER_EXIT_LT1.2 (3), SW_LAND_L1.2 (3), SW_LAND_R1.2 (3), SW_MAN_V/S_CTL1.2 (3), SW_NAV_LOGO1.2 (3), SW_NOSE1.2 (3), SW_NO_SMOKING1.2 (3), SW_RWY_TURN_OFF1.2 (B), SW_SEAT_BELTS1.2 (B), SW_STBY_COMPASS1.2 (B), SW_STROBE1.2 (3), SW_WING1.2 (B), U1.3 (GND), U1.4 (GND), U1.23 (GND), U2.1 (GND), U3.1 (GND), U4.1 (GND)
HEAT_ON: HEAT_ON1.1 (K), U2.9 (~OUT4)
MODE_SEL_FAULT: MODE_SEL_FAULT1.1 (K), U3.5 (~OUT0)
MODE_SEL_MAN: MODE_SEL_MAN1.1 (K), U3.6 (~OUT1)
MUX1_DATA: MUX1.8 (DATA), U1.7 (D4/A6)
MUX2_DATA: MUX2.8 (DATA), U1.8 (~D5)
MUX_S0: MUX1.4 (S0), MUX2.4 (S0), U1.18 (D19/A1)
MUX_S1: MUX1.5 (S1), MUX2.5 (S1), U1.17 (D18/A0)
MUX_S2: MUX1.6 (S2), MUX2.6 (S2), U1.16 (D15)
MUX_S3: MUX1.7 (S3), MUX2.7 (S3), U1.15 (D14)
unnamed: BL_1.1 (K), BL_2.2 (A)
unnamed: BL_2.1 (K), BL_3.2 (A)
unnamed: BL_3.1 (K), BL_4.2 (A)
unnamed: BL_5.1 (K), BL_6.2 (A)
unnamed: BL_6.1 (K), BL_7.2 (A)
unnamed: BL_7.1 (K), BL_8.2 (A)
unnamed: BL_9.1 (K), BL_10.2 (A)
unnamed: BL_10.1 (K), BL_11.2 (A)
unnamed: BL_11.1 (K), BL_12.2 (A)
unnamed: BL_13.1 (K), BL_14.2 (A)
unnamed: BL_14.1 (K), BL_15.2 (A)
unnamed: BL_15.1 (K), BL_16.2 (A)
unnamed: BL_17.1 (K), BL_18.2 (A)
unnamed: BL_18.1 (K), BL_19.2 (A)
unnamed: BL_19.1 (K), BL_20.2 (A)
unnamed: BL_21.1 (K), BL_22.2 (A)
unnamed: BL_22.1 (K), BL_23.2 (A)
unnamed: BL_23.1 (K), BL_24.2 (A)
unnamed: BL_25.1 (K), BL_26.2 (A)
unnamed: BL_26.1 (K), BL_27.2 (A)
unnamed: BL_27.1 (K), BL_28.2 (A)
unnamed: BL_29.1 (K), BL_30.2 (A)
unnamed: BL_30.1 (K), BL_31.2 (A)
unnamed: BL_31.1 (K), BL_32.2 (A)
unnamed: R1.1, U2.15 (R-EXT)
unnamed: R2.1, U3.15 (R-EXT)
unnamed: R3.1, U4.15 (R-EXT)
OSH_CLOCK: U1.5 (D2), U2.3 (CLK), U3.3 (CLK), U4.3 (CLK)
OSH_DIN: U1.1 (D1/TX), U2.2 (SDI)
OSH_DOUT1: U2.14 (SDO), U3.2 (SDI)
OSH_DOUT2: U3.14 (SDO), U4.2 (SDI)
OSH_LATCH: U1.2 (D0/RX), U2.4 (LE(ED1)), U3.4 (LE(ED1)), U4.4 (LE(ED1))
OUT_BRT_BACK: U1.13 (~D10/A10), U4.13 (~OE(ED2))
OUT_BRT_LED: U1.6 (~D3), U2.13 (~OE(ED2)), U3.13 (~OE(ED2))
POT_LDG_ELEV_AUTO: POT_LDG_ELEV_AUTO1.2, U1.20 (D21/A3)
POT_OVH_INTEG_LT: POT_OVHD_INTEG_LT1.2, U1.19 (D20/A2)
SW_ANN_LT_DIM: MUX2.18 (C9), SW_ANN_LT1.1
SW_ANN_LT_TEST: MUX2.19 (C10), SW_ANN_LT1.3 (4)
SW_BEACON: MUX1.13 (C4), SW_BEACON1.3 (C)
SW_DOME_BRT: MUX2.16 (C7), SW_DOME1.3 (4)
SW_DOME_OFF: MUX2.15 (C6), SW_DOME1.1
SW_EMER_EXIT_OFF: SW_EMER_EXIT_LT1.1, U1.11 (D8/A8)
SW_EMER_EXIT_ON: SW_EMER_EXIT_LT1.3 (4), U1.12 (~D9/A9)
SW_LAND_L_ON: MUX1.21 (C12), SW_LAND_L1.3 (4)
SW_LAND_L_RETRACT: MUX1.20 (C11), SW_LAND_L1.1
SW_LAND_R_ON: MUX1.23 (C14), SW_LAND_R1.3 (4)
SW_LAND_R_RETRACT: MUX1.22 (C13), SW_LAND_R1.1
SW_MAN_VS_DN: MUX2.10 (C1), SW_MAN_V/S_CTL1.1
SW_MAN_VS_UP: MUX2.11 (C2), SW_MAN_V/S_CTL1.3 (4)
SW_NAV_LOGO_OFF: MUX1.16 (C7), SW_NAV_LOGO1.1
SW_NAV_LOGO_ON: MUX1.17 (C8), SW_NAV_LOGO1.3 (4)
SW_NOSE_OFF: MUX1.19 (C10), SW_NOSE1.1
SW_NOSE_TO: MUX1.18 (C9), SW_NOSE1.3 (4)
SW_NO_SMOKING_OFF: MUX2.22 (C13), SW_NO_SMOKING1.1
SW_NO_SMOKING_ON: MUX2.23 (C14), SW_NO_SMOKING1.3 (4)
SW_RWY_TURN: MUX1.24 (C15), SW_RWY_TURN_OFF1.3 (C)
SW_SEAT_BELTS: MUX2.21 (C12), SW_SEAT_BELTS1.3 (C)
SW_STBY_COMPASS: MUX2.13 (C4), SW_STBY_COMPASS1.3 (C)
SW_STROBE_OFF: MUX1.14 (C5), SW_STROBE1.1
SW_STROBE_ON: MUX1.15 (C6), SW_STROBE1.3 (4)
SW_WING: MUX1.12 (C3), SW_WING1.3 (C)
WING_ICE_FAULT: U2.6 (~OUT1), WING_ICE_FAULT1.1 (K)
WING_ON: U2.5 (~OUT0), WING_ICE_ON1.1 (K)

Notes on the sheet:
Backlighting
ARDUINO
Switches
Korry
Potentiometer
Input Multiplexer
External Power (12V)
Lighting Korrys
Lighting Control
Integral lighting behind the front panel
Backlight

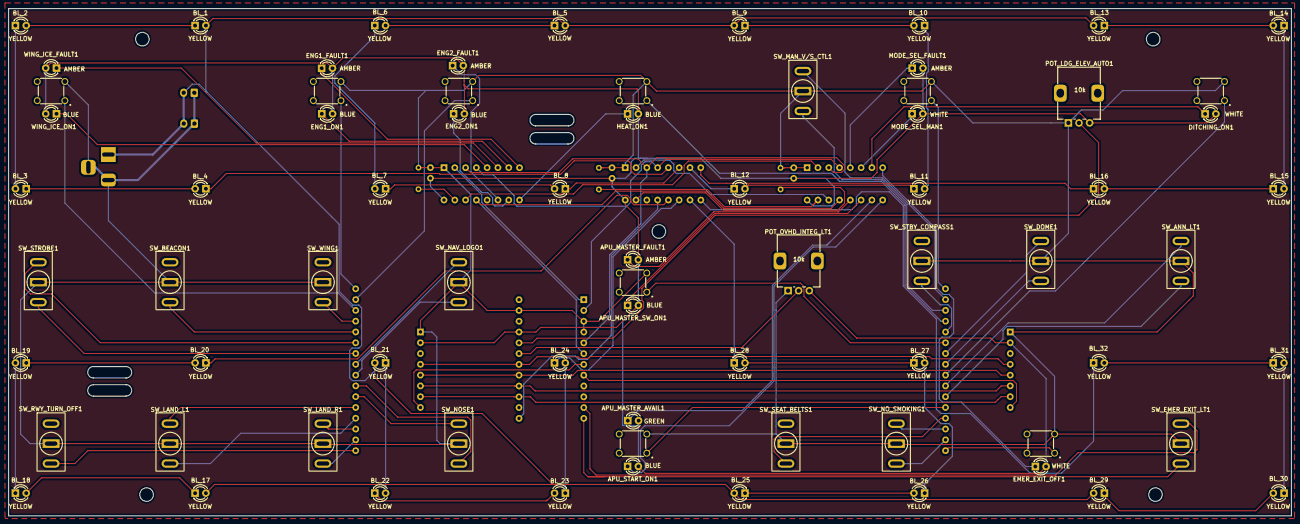
[picture p84: board Lights.kicad_pcb from above]

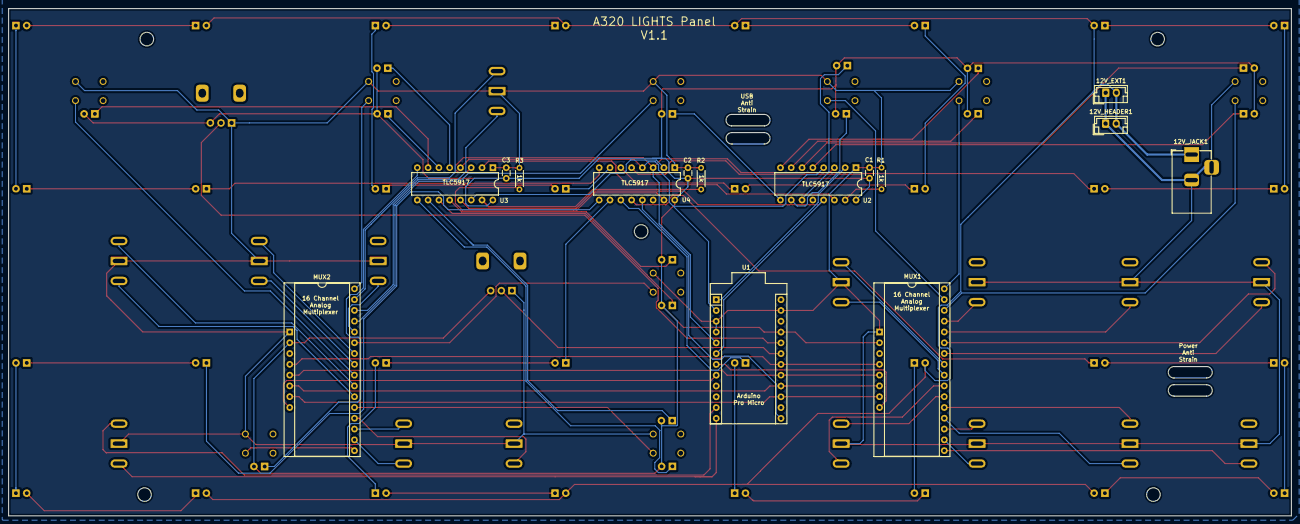
[picture p85: board Lights.kicad_pcb from below]

Board: 2 copper layers, 302.0 x 119.4 mm, 88 parts (15 on the bottom side), 102 nets.
