SK-MH/A320-PCBs/1 - OVERHEAD/1.1 PACDV/KiCAD/PA_CDV.kicad_pcb

## KiCad design 1 - OVERHEAD/1.1 PACDV/KiCAD/PA_CDV.kicad_pcb (2025-01-06)

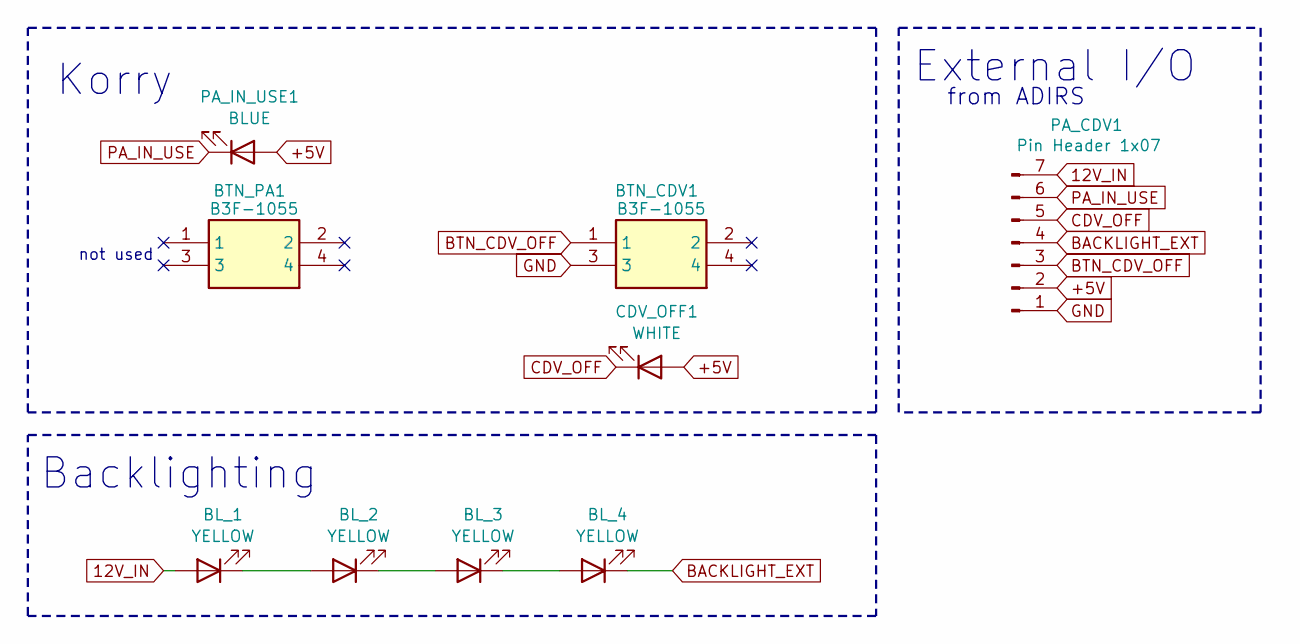
[picture p86: schematic PA_CDV.kicad_sch, PA_CDV Panel]

Parts:
BL_1, BL_2, BL_3, BL_4: YELLOW; LED_D3.0mm
BTN_CDV1: B3F-1055; B3F1000; Mouser Part Number 653-B3F-1055
BTN_PA1: B3F-1055; B3F1000; Mouser Part Number 653-B3F-1055
CDV_OFF1: WHITE; LED_D3.0mm
PA_CDV1: Pin Header 1x07; JST_EH_B7B-EH-A_1x07_P2.50mm_Vertical
PA_IN_USE1: BLUE; LED_D3.0mm

Connections:
12V_IN: BL_1.2 (A), PA_CDV1.7
+5V: CDV_OFF1.2 (A), PA_CDV1.2, PA_IN_USE1.2 (A)
BACKLIGHT_EXT: BL_4.1 (K), PA_CDV1.4
BTN_CDV_OFF: BTN_CDV1.1, PA_CDV1.3
CDV_OFF: CDV_OFF1.1 (K), PA_CDV1.5
GND: BTN_CDV1.3, PA_CDV1.1
unnamed: BL_1.1 (K), BL_2.2 (A)
unnamed: BL_2.1 (K), BL_3.2 (A)
unnamed: BL_3.1 (K), BL_4.2 (A)
PA_IN_USE: PA_CDV1.6, PA_IN_USE1.1 (K)

Notes on the sheet:
External I/O
from ADIRS
Backlighting
Korry
not used

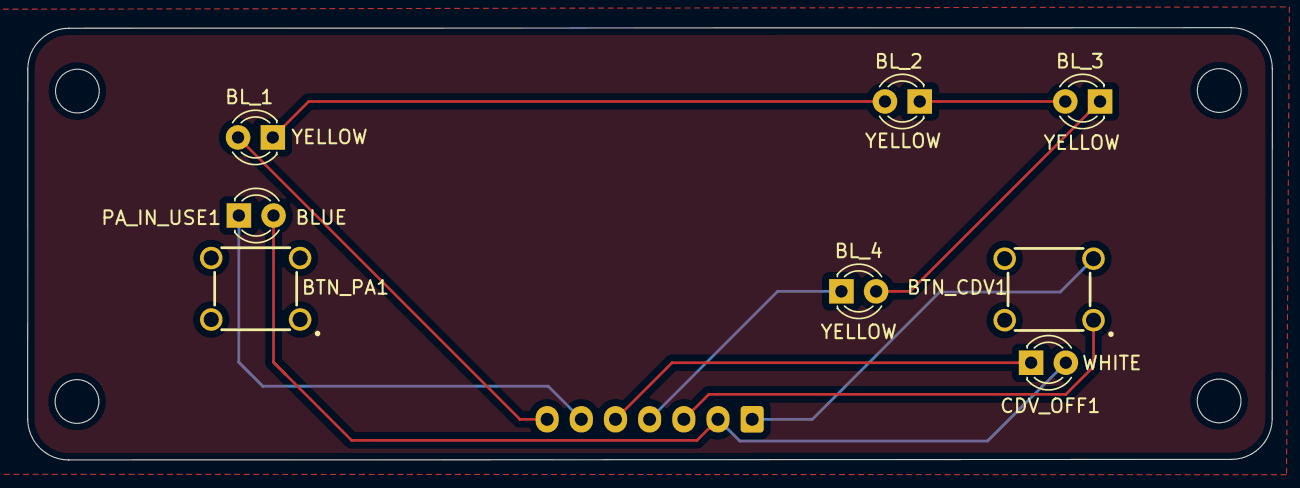
[picture p87: board PA_CDV.kicad_pcb from above]

Board: 2 copper layers, 91.0 x 31.6 mm, 9 parts (1 on the bottom side), 10 nets.
