SK-MH/A320-PCBs/1 - OVERHEAD/1.4 EMER ELEC/KiCAD/EMER_ELEC.kicad_pcb

## KiCad design 1 - OVERHEAD/1.4 EMER ELEC/KiCAD/EMER_ELEC.kicad_pcb (2025-01-06)

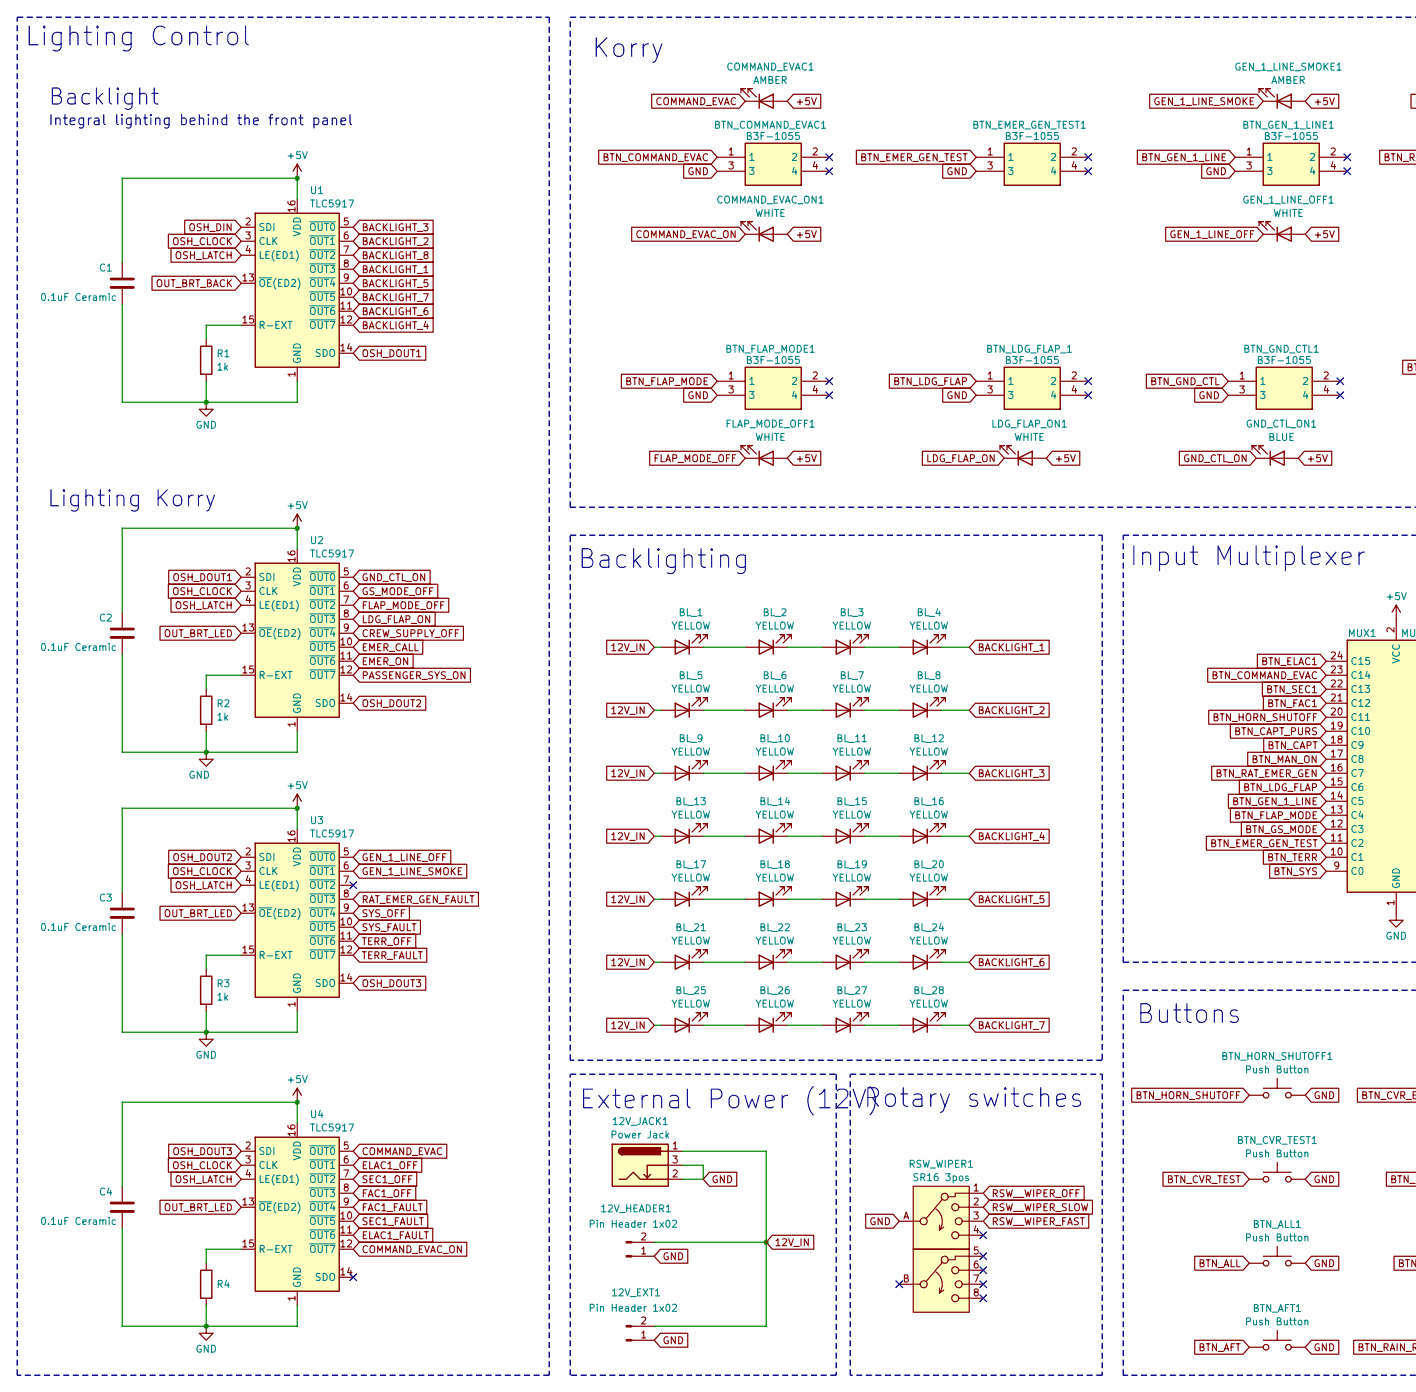
[picture p88: schematic EMER_ELEC.kicad_sch, EMER ELEC / EVAC Panel, part in row 1, column 1]

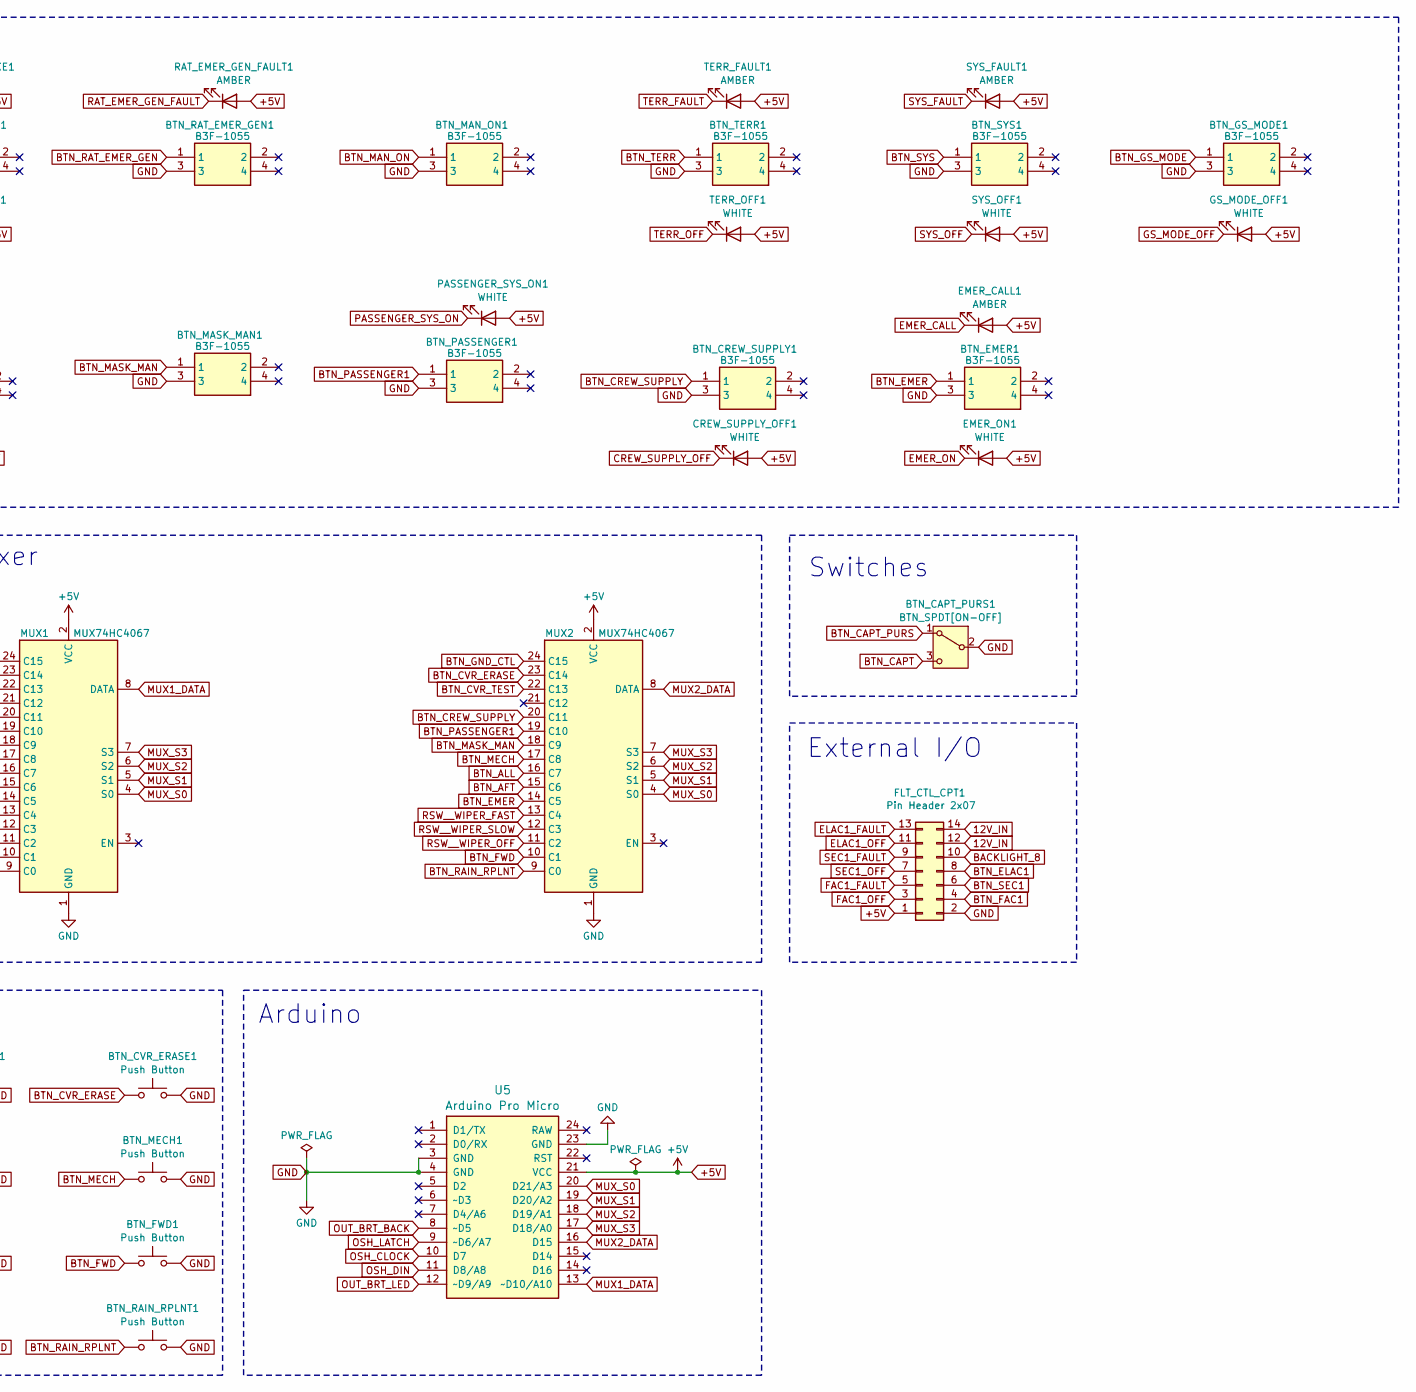
[picture p89: schematic EMER_ELEC.kicad_sch, EMER ELEC / EVAC Panel, part in row 1, column 2]

Parts:
12V_EXT1, 12V_HEADER1: Pin Header 1x02; JST_EH_B2B-EH-A_1x02_P2.50mm_Vertical
12V_JACK1: Power Jack; BarrelJack_Horizontal
BL_1, BL_2, BL_3, BL_4, BL_5, BL_6, BL_7, BL_8, BL_9, BL_10, BL_11, BL_12, BL_13, BL_14, BL_15, BL_16, BL_17, BL_18, BL_19, BL_20, BL_21, BL_22, BL_23, BL_24, BL_25, BL_26, BL_27, BL_28: YELLOW; LED_D3.0mm
BTN_AFT1: Push Button; SW-Push
BTN_ALL1: Push Button; SW-Push
BTN_CAPT_PURS1: BTN_SPDT[ON-OFF]; T80-Z1
BTN_COMMAND_EVAC1: B3F-1055; B3F1000; Mouser Part Number 653-B3F-1055
BTN_CREW_SUPPLY1: B3F-1055; B3F1000; Mouser Part Number 653-B3F-1055
BTN_CVR_ERASE1: Push Button; SW-Push
BTN_CVR_TEST1: Push Button; SW-Push
BTN_EMER1: B3F-1055; B3F1000; Mouser Part Number 653-B3F-1055
BTN_EMER_GEN_TEST1: B3F-1055; B3F1000; Mouser Part Number 653-B3F-1055
BTN_FLAP_MODE1: B3F-1055; B3F1000; Mouser Part Number 653-B3F-1055
BTN_FWD1: Push Button; SW-Push
BTN_GEN_1_LINE1: B3F-1055; B3F1000; Mouser Part Number 653-B3F-1055
BTN_GND_CTL1: B3F-1055; B3F1000; Mouser Part Number 653-B3F-1055
BTN_GS_MODE1: B3F-1055; B3F1000; Mouser Part Number 653-B3F-1055
BTN_HORN_SHUTOFF1: Push Button; SW-Push
BTN_LDG_FLAP_1: B3F-1055; B3F1000; Mouser Part Number 653-B3F-1055
BTN_MAN_ON1: B3F-1055; B3F1000; Mouser Part Number 653-B3F-1055
BTN_MASK_MAN1: B3F-1055; B3F1000; Mouser Part Number 653-B3F-1055
BTN_MECH1: Push Button; SW-Push
BTN_PASSENGER1: B3F-1055; B3F1000; Mouser Part Number 653-B3F-1055
BTN_RAIN_RPLNT1: Push Button; SW-Push
BTN_RAT_EMER_GEN1: B3F-1055; B3F1000; Mouser Part Number 653-B3F-1055
BTN_SYS1: B3F-1055; B3F1000; Mouser Part Number 653-B3F-1055
BTN_TERR1: B3F-1055; B3F1000; Mouser Part Number 653-B3F-1055
C1, C2, C3, C4: 0.1uF Ceramic; C_Disc_D3.0mm_W1.6mm_P2.50mm
COMMAND_EVAC1: AMBER; LED_D3.0mm
COMMAND_EVAC_ON1: WHITE; LED_D3.0mm
CREW_SUPPLY_OFF1: WHITE; LED_D3.0mm
EMER_CALL1: AMBER; LED_D3.0mm
EMER_ON1: WHITE; LED_D3.0mm
FLAP_MODE_OFF1: WHITE; LED_D3.0mm
FLT_CTL_CPT1: Pin Header 2x07; IDC-Header_2x07_P2.54mm_Vertical
GEN_1_LINE_OFF1: WHITE; LED_D3.0mm
GEN_1_LINE_SMOKE1: AMBER; LED_D3.0mm
GND_CTL_ON1: BLUE; LED_D3.0mm
GS_MODE_OFF1: WHITE; LED_D3.0mm
LDG_FLAP_ON1: WHITE; LED_D3.0mm
MUX1, MUX2: MUX74HC4067
PASSENGER_SYS_ON1: WHITE; LED_D3.0mm
R1, R2, R3, R4: 1k; R_Axial_DIN0204_L3.6mm_D1.6mm_P7.62mm_Horizontal
RAT_EMER_GEN_FAULT1: AMBER; LED_D3.0mm
RSW_WIPER1: SR16 3pos; SR16-AB
SYS_FAULT1: AMBER; LED_D3.0mm
SYS_OFF1: WHITE; LED_D3.0mm
TERR_FAULT1: AMBER; LED_D3.0mm
TERR_OFF1: WHITE; LED_D3.0mm
U1, U2, U3, U4: TLC5917; DIP-16_W7.62mm
U5: Arduino Pro Micro; Sparkfun_Pro_Micro

Connections:
12V_IN: 12V_EXT1.2, 12V_HEADER1.2, 12V_JACK1.1, BL_1.2 (A), BL_5.2 (A), BL_9.2 (A), BL_13.2 (A), BL_17.2 (A), BL_21.2 (A), BL_25.2 (A), FLT_CTL_CPT1.12, FLT_CTL_CPT1.14
+5V: C1.1, C2.1, C3.1, C4.1, COMMAND_EVAC1.2 (A), COMMAND_EVAC_ON1.2 (A), CREW_SUPPLY_OFF1.2 (A), EMER_CALL1.2 (A), EMER_ON1.2 (A), FLAP_MODE_OFF1.2 (A), FLT_CTL_CPT1.1, GEN_1_LINE_OFF1.2 (A), GEN_1_LINE_SMOKE1.2 (A), GND_CTL_ON1.2 (A), GS_MODE_OFF1.2 (A), LDG_FLAP_ON1.2 (A), MUX1.2 (VCC), MUX2.2 (VCC), PASSENGER_SYS_ON1.2 (A), RAT_EMER_GEN_FAULT1.2 (A), SYS_FAULT1.2 (A), SYS_OFF1.2 (A), TERR_FAULT1.2 (A), TERR_OFF1.2 (A), U1.16 (VDD), U2.16 (VDD), U3.16 (VDD), U4.16 (VDD), U5.21 (VCC)
BACKLIGHT_1: BL_4.1 (K), U1.8 (~OUT3)
BACKLIGHT_2: BL_8.1 (K), U1.6 (~OUT1)
BACKLIGHT_3: BL_12.1 (K), U1.5 (~OUT0)
BACKLIGHT_4: BL_16.1 (K), U1.12 (~OUT7)
BACKLIGHT_5: BL_20.1 (K), U1.9 (~OUT4)
BACKLIGHT_6: BL_24.1 (K), U1.11 (~OUT6)
BACKLIGHT_7: BL_28.1 (K), U1.10 (~OUT5)
BACKLIGHT_8: FLT_CTL_CPT1.10, U1.7 (~OUT2)
BTN_AFT: BTN_AFT1.1, MUX2.15 (C6)
BTN_ALL: BTN_ALL1.1, MUX2.16 (C7)
BTN_CAPT: BTN_CAPT_PURS1.3 (C), MUX1.18 (C9)
BTN_CAPT_PURS: BTN_CAPT_PURS1.1 (A), MUX1.19 (C10)
BTN_COMMAND_EVAC: BTN_COMMAND_EVAC1.1, MUX1.23 (C14)
BTN_CREW_SUPPLY: BTN_CREW_SUPPLY1.1, MUX2.20 (C11)
BTN_CVR_ERASE: BTN_CVR_ERASE1.1, MUX2.23 (C14)
BTN_CVR_TEST: BTN_CVR_TEST1.1, MUX2.22 (C13)
BTN_ELAC1: FLT_CTL_CPT1.8, MUX1.24 (C15)
BTN_EMER: BTN_EMER1.1, MUX2.14 (C5)
BTN_EMER_GEN_TEST: BTN_EMER_GEN_TEST1.1, MUX1.11 (C2)
BTN_FAC1: FLT_CTL_CPT1.4, MUX1.21 (C12)
BTN_FLAP_MODE: BTN_FLAP_MODE1.1, MUX1.13 (C4)
BTN_FWD: BTN_FWD1.1, MUX2.10 (C1)
BTN_GEN_1_LINE: BTN_GEN_1_LINE1.1, MUX1.14 (C5)
BTN_GND_CTL: BTN_GND_CTL1.1, MUX2.24 (C15)
BTN_GS_MODE: BTN_GS_MODE1.1, MUX1.12 (C3)
BTN_HORN_SHUTOFF: BTN_HORN_SHUTOFF1.1, MUX1.20 (C11)
BTN_LDG_FLAP: BTN_LDG_FLAP_1.1, MUX1.15 (C6)
BTN_MAN_ON: BTN_MAN_ON1.1, MUX1.17 (C8)
BTN_MASK_MAN: BTN_MASK_MAN1.1, MUX2.18 (C9)
BTN_MECH: BTN_MECH1.1, MUX2.17 (C8)
BTN_PASSENGER1: BTN_PASSENGER1.1, MUX2.19 (C10)
BTN_RAIN_RPLNT: BTN_RAIN_RPLNT1.1, MUX2.9 (C0)
BTN_RAT_EMER_GEN: BTN_RAT_EMER_GEN1.1, MUX1.16 (C7)
BTN_SEC1: FLT_CTL_CPT1.6, MUX1.22 (C13)
BTN_SYS: BTN_SYS1.1, MUX1.9 (C0)
BTN_TERR: BTN_TERR1.1, MUX1.10 (C1)
COMMAND_EVAC: COMMAND_EVAC1.1 (K), U4.5 (~OUT0)
COMMAND_EVAC_ON: COMMAND_EVAC_ON1.1 (K), U4.12 (~OUT7)
CREW_SUPPLY_OFF: CREW_SUPPLY_OFF1.1 (K), U2.9 (~OUT4)
ELAC1_FAULT: FLT_CTL_CPT1.13, U4.11 (~OUT6)
ELAC1_OFF: FLT_CTL_CPT1.11, U4.6 (~OUT1)
EMER_CALL: EMER_CALL1.1 (K), U2.10 (~OUT5)
EMER_ON: EMER_ON1.1 (K), U2.11 (~OUT6)
FAC1_FAULT: FLT_CTL_CPT1.5, U4.9 (~OUT4)
FAC1_OFF: FLT_CTL_CPT1.3, U4.8 (~OUT3)
FLAP_MODE_OFF: FLAP_MODE_OFF1.1 (K), U2.7 (~OUT2)
GEN_1_LINE_OFF: GEN_1_LINE_OFF1.1 (K), U3.5 (~OUT0)
GEN_1_LINE_SMOKE: GEN_1_LINE_SMOKE1.1 (K), U3.6 (~OUT1)
GND: 12V_EXT1.1, 12V_HEADER1.1, 12V_JACK1.2, 12V_JACK1.3, BTN_AFT1.2, BTN_ALL1.2, BTN_CAPT_PURS1.2 (B), BTN_COMMAND_EVAC1.3, BTN_CREW_SUPPLY1.3, BTN_CVR_ERASE1.2, BTN_CVR_TEST1.2, BTN_EMER1.3, BTN_EMER_GEN_TEST1.3, BTN_FLAP_MODE1.3, BTN_FWD1.2, BTN_GEN_1_LINE1.3, BTN_GND_CTL1.3, BTN_GS_MODE1.3, BTN_HORN_SHUTOFF1.2, BTN_LDG_FLAP_1.3, BTN_MAN_ON1.3, BTN_MASK_MAN1.3, BTN_MECH1.2, BTN_PASSENGER1.3, BTN_RAIN_RPLNT1.2, BTN_RAT_EMER_GEN1.3, BTN_SYS1.3, BTN_TERR1.3, C1.2, C2.2, C3.2, C4.2, FLT_CTL_CPT1.2, MUX1.1 (GND), MUX2.1 (GND), R1.2, R2.2, R3.2, R4.2, RSW_WIPER1.A, U1.1 (GND), U2.1 (GND), U3.1 (GND), U4.1 (GND), U5.3 (GND), U5.4 (GND), U5.23 (GND)
GND_CTL_ON: GND_CTL_ON1.1 (K), U2.5 (~OUT0)
GS_MODE_OFF: GS_MODE_OFF1.1 (K), U2.6 (~OUT1)
LDG_FLAP_ON: LDG_FLAP_ON1.1 (K), U2.8 (~OUT3)
MUX1_DATA: MUX1.8 (DATA), U5.13 (~D10/A10)
MUX2_DATA: MUX2.8 (DATA), U5.16 (D15)
MUX_S0: MUX1.4 (S0), MUX2.4 (S0), U5.20 (D21/A3)
MUX_S1: MUX1.5 (S1), MUX2.5 (S1), U5.19 (D20/A2)
MUX_S2: MUX1.6 (S2), MUX2.6 (S2), U5.18 (D19/A1)
MUX_S3: MUX1.7 (S3), MUX2.7 (S3), U5.17 (D18/A0)
unnamed: BL_1.1 (K), BL_2.2 (A)
unnamed: BL_2.1 (K), BL_3.2 (A)
unnamed: BL_3.1 (K), BL_4.2 (A)
unnamed: BL_5.1 (K), BL_6.2 (A)
unnamed: BL_6.1 (K), BL_7.2 (A)
unnamed: BL_7.1 (K), BL_8.2 (A)
unnamed: BL_9.1 (K), BL_10.2 (A)
unnamed: BL_10.1 (K), BL_11.2 (A)
unnamed: BL_11.1 (K), BL_12.2 (A)
unnamed: BL_13.1 (K), BL_14.2 (A)
unnamed: BL_14.1 (K), BL_15.2 (A)
unnamed: BL_15.1 (K), BL_16.2 (A)
unnamed: BL_17.1 (K), BL_18.2 (A)
unnamed: BL_18.1 (K), BL_19.2 (A)
unnamed: BL_19.1 (K), BL_20.2 (A)
unnamed: BL_21.1 (K), BL_22.2 (A)
unnamed: BL_22.1 (K), BL_23.2 (A)
unnamed: BL_23.1 (K), BL_24.2 (A)
unnamed: BL_25.1 (K), BL_26.2 (A)
unnamed: BL_26.1 (K), BL_27.2 (A)
unnamed: BL_27.1 (K), BL_28.2 (A)
unnamed: R1.1, U1.15 (R-EXT)
unnamed: R2.1, U2.15 (R-EXT)
unnamed: R3.1, U3.15 (R-EXT)
unnamed: R4.1, U4.15 (R-EXT)
OSH_CLOCK: U1.3 (CLK), U2.3 (CLK), U3.3 (CLK), U4.3 (CLK), U5.10 (D7)
OSH_DIN: U1.2 (SDI), U5.11 (D8/A8)
OSH_DOUT1: U1.14 (SDO), U2.2 (SDI)
OSH_DOUT2: U2.14 (SDO), U3.2 (SDI)
OSH_DOUT3: U3.14 (SDO), U4.2 (SDI)
OSH_LATCH: U1.4 (LE(ED1)), U2.4 (LE(ED1)), U3.4 (LE(ED1)), U4.4 (LE(ED1)), U5.9 (~D6/A7)
OUT_BRT_BACK: U1.13 (~OE(ED2)), U5.8 (~D5)
OUT_BRT_LED: U2.13 (~OE(ED2)), U3.13 (~OE(ED2)), U4.13 (~OE(ED2)), U5.12 (~D9/A9)
PASSENGER_SYS_ON: PASSENGER_SYS_ON1.1 (K), U2.12 (~OUT7)
RAT_EMER_GEN_FAULT: RAT_EMER_GEN_FAULT1.1 (K), U3.8 (~OUT3)
RSW__WIPER_FAST: MUX2.13 (C4), RSW_WIPER1.3
RSW__WIPER_OFF: MUX2.11 (C2), RSW_WIPER1.1
RSW__WIPER_SLOW: MUX2.12 (C3), RSW_WIPER1.2
SEC1_FAULT: FLT_CTL_CPT1.9, U4.10 (~OUT5)
SEC1_OFF: FLT_CTL_CPT1.7, U4.7 (~OUT2)
SYS_FAULT: SYS_FAULT1.1 (K), U3.10 (~OUT5)
SYS_OFF: SYS_OFF1.1 (K), U3.9 (~OUT4)
TERR_FAULT: TERR_FAULT1.1 (K), U3.12 (~OUT7)
TERR_OFF: TERR_OFF1.1 (K), U3.11 (~OUT6)

Notes on the sheet:
Backlighting
Arduino
Rotary switches
Switches
External I/O
Korry
Input Multiplexer
Buttons
External Power (12V)
Lighting Korry
Lighting Control
Integral lighting behind the front panel
Backlight
