SK-MH/A320-PCBs/1 - OVERHEAD/1.4 EMER ELEC/KiCAD/EMER_ELEC.kicad_pcb

## KiCad design 1 - OVERHEAD/1.4 EMER ELEC/KiCAD/EMER_ELEC.kicad_pcb (continued)

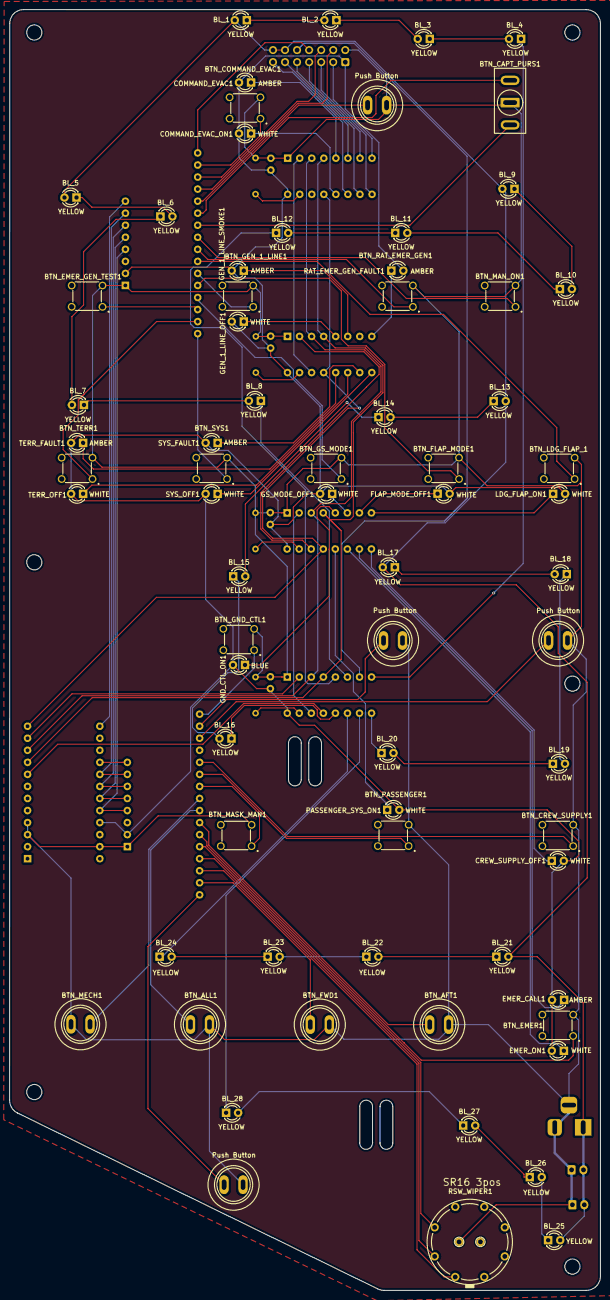
[picture p90: board EMER_ELEC.kicad_pcb from above]

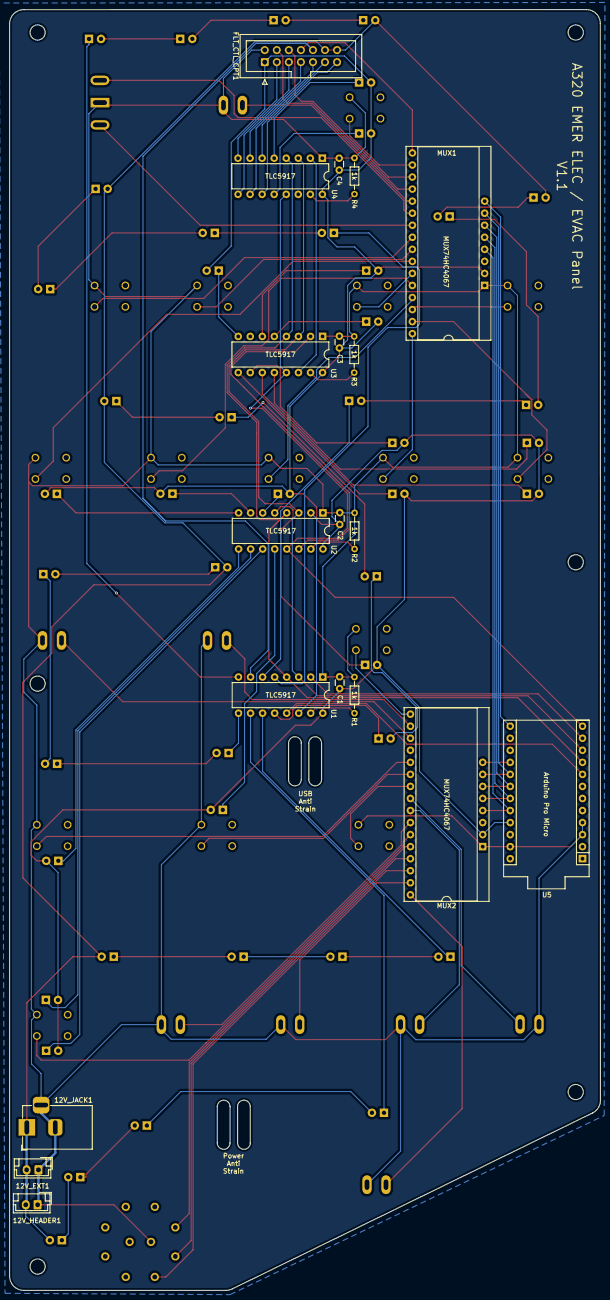
[picture p91: board EMER_ELEC.kicad_pcb from below]

Board: 2 copper layers, 124.6 x 270.1 mm, 89 parts (19 on the bottom side), 104 nets.
