SK-MH/A320-PCBs/1 - OVERHEAD/1.2 ADIRS/KiCAD/ADIRS V1.1.kicad_pcb

## KiCad design 1 - OVERHEAD/1.2 ADIRS/KiCAD/ADIRS V1.1.kicad_pcb (2025-01-06)

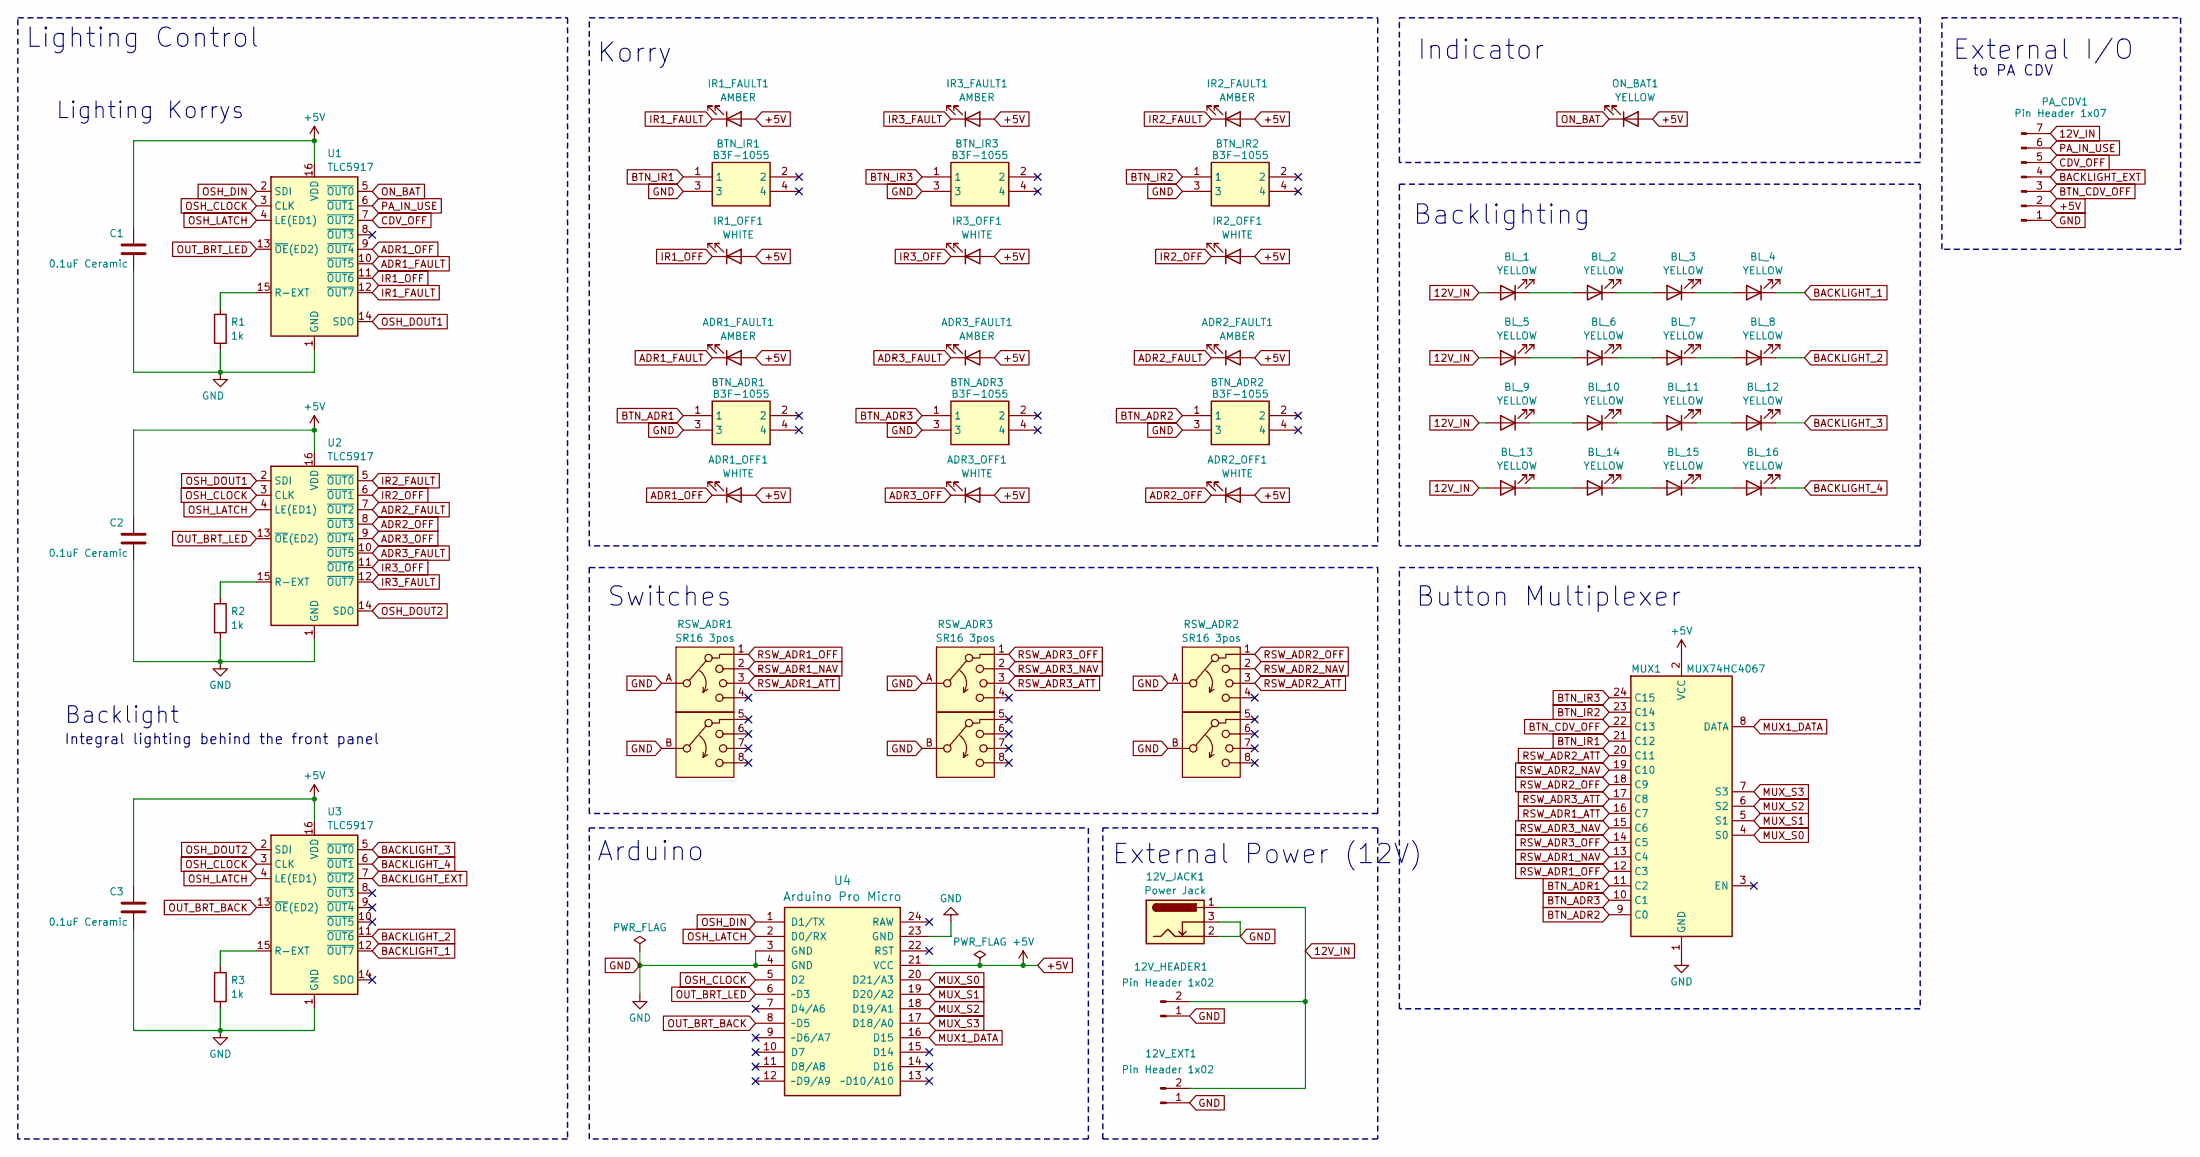
[picture p92: schematic ADIRS V1.1.kicad_sch, ADIRS Panel]

Parts:
12V_EXT1, 12V_HEADER1: Pin Header 1x02; JST_EH_B2B-EH-A_1x02_P2.50mm_Vertical
12V_JACK1: Power Jack; BarrelJack_Horizontal
ADR1_FAULT1, ADR2_FAULT1, ADR3_FAULT1: AMBER; LED_D3.0mm
ADR1_OFF1, ADR2_OFF1, ADR3_OFF1: WHITE; LED_D3.0mm
BL_1, BL_2, BL_3, BL_4, BL_5, BL_6, BL_7, BL_8, BL_9, BL_10, BL_11, BL_12, BL_13, BL_14, BL_15, BL_16: YELLOW; LED_D3.0mm
BTN_ADR1, BTN_ADR2, BTN_ADR3: B3F-1055; B3F1000; Mouser Part Number 653-B3F-1055
BTN_IR1, BTN_IR2, BTN_IR3: B3F-1055; B3F1000; Mouser Part Number 653-B3F-1055
C1, C2, C3: 0.1uF Ceramic; C_Disc_D3.0mm_W1.6mm_P2.50mm
IR1_FAULT1, IR2_FAULT1, IR3_FAULT1: AMBER; LED_D3.0mm
IR1_OFF1, IR2_OFF1, IR3_OFF1: WHITE; LED_D3.0mm
MUX1: MUX74HC4067
ON_BAT1: YELLOW; LED_D3.0mm
PA_CDV1: Pin Header 1x07; JST_EH_B7B-EH-A_1x07_P2.50mm_Vertical
R1, R2, R3: 1k; R_Axial_DIN0204_L3.6mm_D1.6mm_P7.62mm_Horizontal
RSW_ADR1, RSW_ADR2, RSW_ADR3: SR16 3pos; SR16-AB
U1, U2, U3: TLC5917; DIP-16_W7.62mm
U4: Arduino Pro Micro; Sparkfun_Pro_Micro

Connections:
12V_IN: 12V_EXT1.2, 12V_HEADER1.2, 12V_JACK1.1, BL_1.2 (A), BL_5.2 (A), BL_9.2 (A), BL_13.2 (A), PA_CDV1.7
+5V: ADR1_FAULT1.2 (A), ADR1_OFF1.2 (A), ADR2_FAULT1.2 (A), ADR2_OFF1.2 (A), ADR3_FAULT1.2 (A), ADR3_OFF1.2 (A), C1.1, C2.1, C3.1, IR1_FAULT1.2 (A), IR1_OFF1.2 (A), IR2_FAULT1.2 (A), IR2_OFF1.2 (A), IR3_FAULT1.2 (A), IR3_OFF1.2 (A), MUX1.2 (VCC), ON_BAT1.2 (A), PA_CDV1.2, U1.16 (VDD), U2.16 (VDD), U3.16 (VDD), U4.21 (VCC)
ADR1_FAULT: ADR1_FAULT1.1 (K), U1.10 (~OUT5)
ADR1_OFF: ADR1_OFF1.1 (K), U1.9 (~OUT4)
ADR2_FAULT: ADR2_FAULT1.1 (K), U2.7 (~OUT2)
ADR2_OFF: ADR2_OFF1.1 (K), U2.8 (~OUT3)
ADR3_FAULT: ADR3_FAULT1.1 (K), U2.10 (~OUT5)
ADR3_OFF: ADR3_OFF1.1 (K), U2.9 (~OUT4)
BACKLIGHT_1: BL_4.1 (K), U3.12 (~OUT7)
BACKLIGHT_2: BL_8.1 (K), U3.11 (~OUT6)
BACKLIGHT_3: BL_12.1 (K), U3.5 (~OUT0)
BACKLIGHT_4: BL_16.1 (K), U3.6 (~OUT1)
BACKLIGHT_EXT: PA_CDV1.4, U3.7 (~OUT2)
BTN_ADR1: BTN_ADR1.1, MUX1.11 (C2)
BTN_ADR2: BTN_ADR2.1, MUX1.9 (C0)
BTN_ADR3: BTN_ADR3.1, MUX1.10 (C1)
BTN_CDV_OFF: MUX1.22 (C13), PA_CDV1.3
BTN_IR1: BTN_IR1.1, MUX1.21 (C12)
BTN_IR2: BTN_IR2.1, MUX1.23 (C14)
BTN_IR3: BTN_IR3.1, MUX1.24 (C15)
CDV_OFF: PA_CDV1.5, U1.7 (~OUT2)
GND: 12V_EXT1.1, 12V_HEADER1.1, 12V_JACK1.2, 12V_JACK1.3, BTN_ADR1.3, BTN_ADR2.3, BTN_ADR3.3, BTN_IR1.3, BTN_IR2.3, BTN_IR3.3, C1.2, C2.2, C3.2, MUX1.1 (GND), PA_CDV1.1, R1.2, R2.2, R3.2, RSW_ADR1.A, RSW_ADR1.B, RSW_ADR2.A, RSW_ADR2.B, RSW_ADR3.A, RSW_ADR3.B, U1.1 (GND), U2.1 (GND), U3.1 (GND), U4.3 (GND), U4.4 (GND), U4.23 (GND)
IR1_FAULT: IR1_FAULT1.1 (K), U1.12 (~OUT7)
IR1_OFF: IR1_OFF1.1 (K), U1.11 (~OUT6)
IR2_FAULT: IR2_FAULT1.1 (K), U2.5 (~OUT0)
IR2_OFF: IR2_OFF1.1 (K), U2.6 (~OUT1)
IR3_FAULT: IR3_FAULT1.1 (K), U2.12 (~OUT7)
IR3_OFF: IR3_OFF1.1 (K), U2.11 (~OUT6)
MUX1_DATA: MUX1.8 (DATA), U4.16 (D15)
MUX_S0: MUX1.4 (S0), U4.20 (D21/A3)
MUX_S1: MUX1.5 (S1), U4.19 (D20/A2)
MUX_S2: MUX1.6 (S2), U4.18 (D19/A1)
MUX_S3: MUX1.7 (S3), U4.17 (D18/A0)
unnamed: BL_1.1 (K), BL_2.2 (A)
unnamed: BL_2.1 (K), BL_3.2 (A)
unnamed: BL_3.1 (K), BL_4.2 (A)
unnamed: BL_5.1 (K), BL_6.2 (A)
unnamed: BL_6.1 (K), BL_7.2 (A)
unnamed: BL_7.1 (K), BL_8.2 (A)
unnamed: BL_9.1 (K), BL_10.2 (A)
unnamed: BL_10.1 (K), BL_11.2 (A)
unnamed: BL_11.1 (K), BL_12.2 (A)
unnamed: BL_13.1 (K), BL_14.2 (A)
unnamed: BL_14.1 (K), BL_15.2 (A)
unnamed: BL_15.1 (K), BL_16.2 (A)
unnamed: R1.1, U1.15 (R-EXT)
unnamed: R2.1, U2.15 (R-EXT)
unnamed: R3.1, U3.15 (R-EXT)
ON_BAT: ON_BAT1.1 (K), U1.5 (~OUT0)
OSH_CLOCK: U1.3 (CLK), U2.3 (CLK), U3.3 (CLK), U4.5 (D2)
OSH_DIN: U1.2 (SDI), U4.1 (D1/TX)
OSH_DOUT1: U1.14 (SDO), U2.2 (SDI)
OSH_DOUT2: U2.14 (SDO), U3.2 (SDI)
OSH_LATCH: U1.4 (LE(ED1)), U2.4 (LE(ED1)), U3.4 (LE(ED1)), U4.2 (D0/RX)
OUT_BRT_BACK: U3.13 (~OE(ED2)), U4.8 (~D5)
OUT_BRT_LED: U1.13 (~OE(ED2)), U2.13 (~OE(ED2)), U4.6 (~D3)
PA_IN_USE: PA_CDV1.6, U1.6 (~OUT1)
RSW_ADR1_ATT: MUX1.16 (C7), RSW_ADR1.3
RSW_ADR1_NAV: MUX1.13 (C4), RSW_ADR1.2
RSW_ADR1_OFF: MUX1.12 (C3), RSW_ADR1.1
RSW_ADR2_ATT: MUX1.20 (C11), RSW_ADR2.3
RSW_ADR2_NAV: MUX1.19 (C10), RSW_ADR2.2
RSW_ADR2_OFF: MUX1.18 (C9), RSW_ADR2.1
RSW_ADR3_ATT: MUX1.17 (C8), RSW_ADR3.3
RSW_ADR3_NAV: MUX1.15 (C6), RSW_ADR3.2
RSW_ADR3_OFF: MUX1.14 (C5), RSW_ADR3.1

Notes on the sheet:
Backlighting
External I/O
Arduino
Switches
Indicator
Korry
Button Multiplexer
to PA CDV
External Power (12V)
Lighting Korrys
Lighting Control
Integral lighting behind the front panel
Backlight

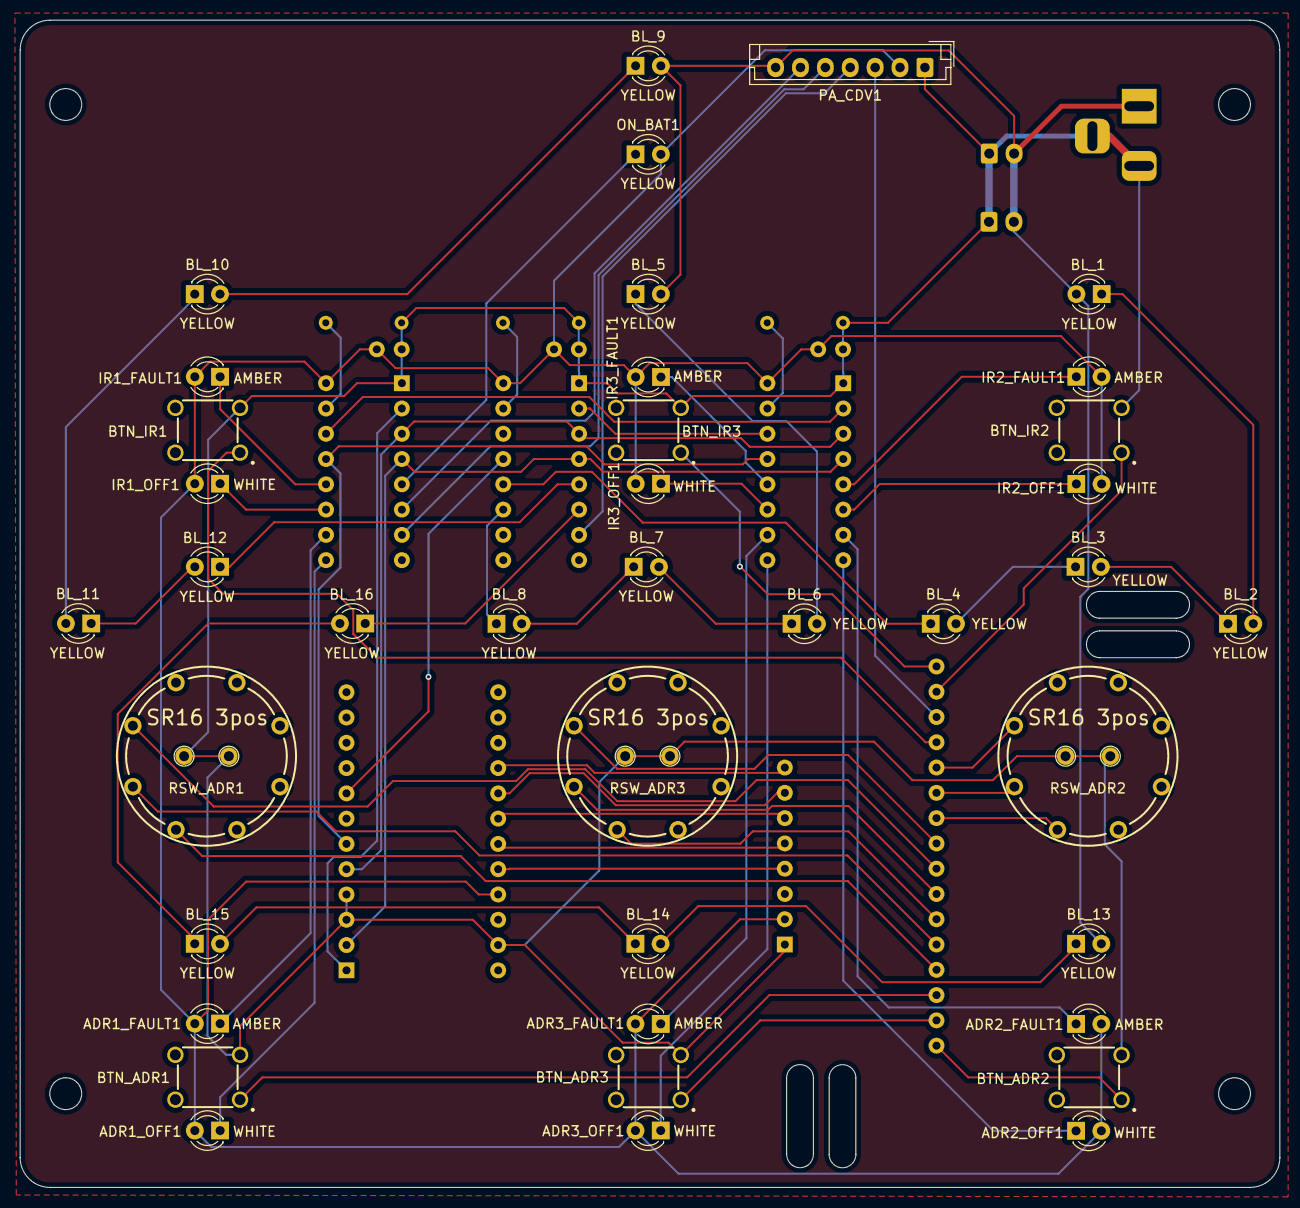
[picture p93: board ADIRS V1.1.kicad_pcb from above]

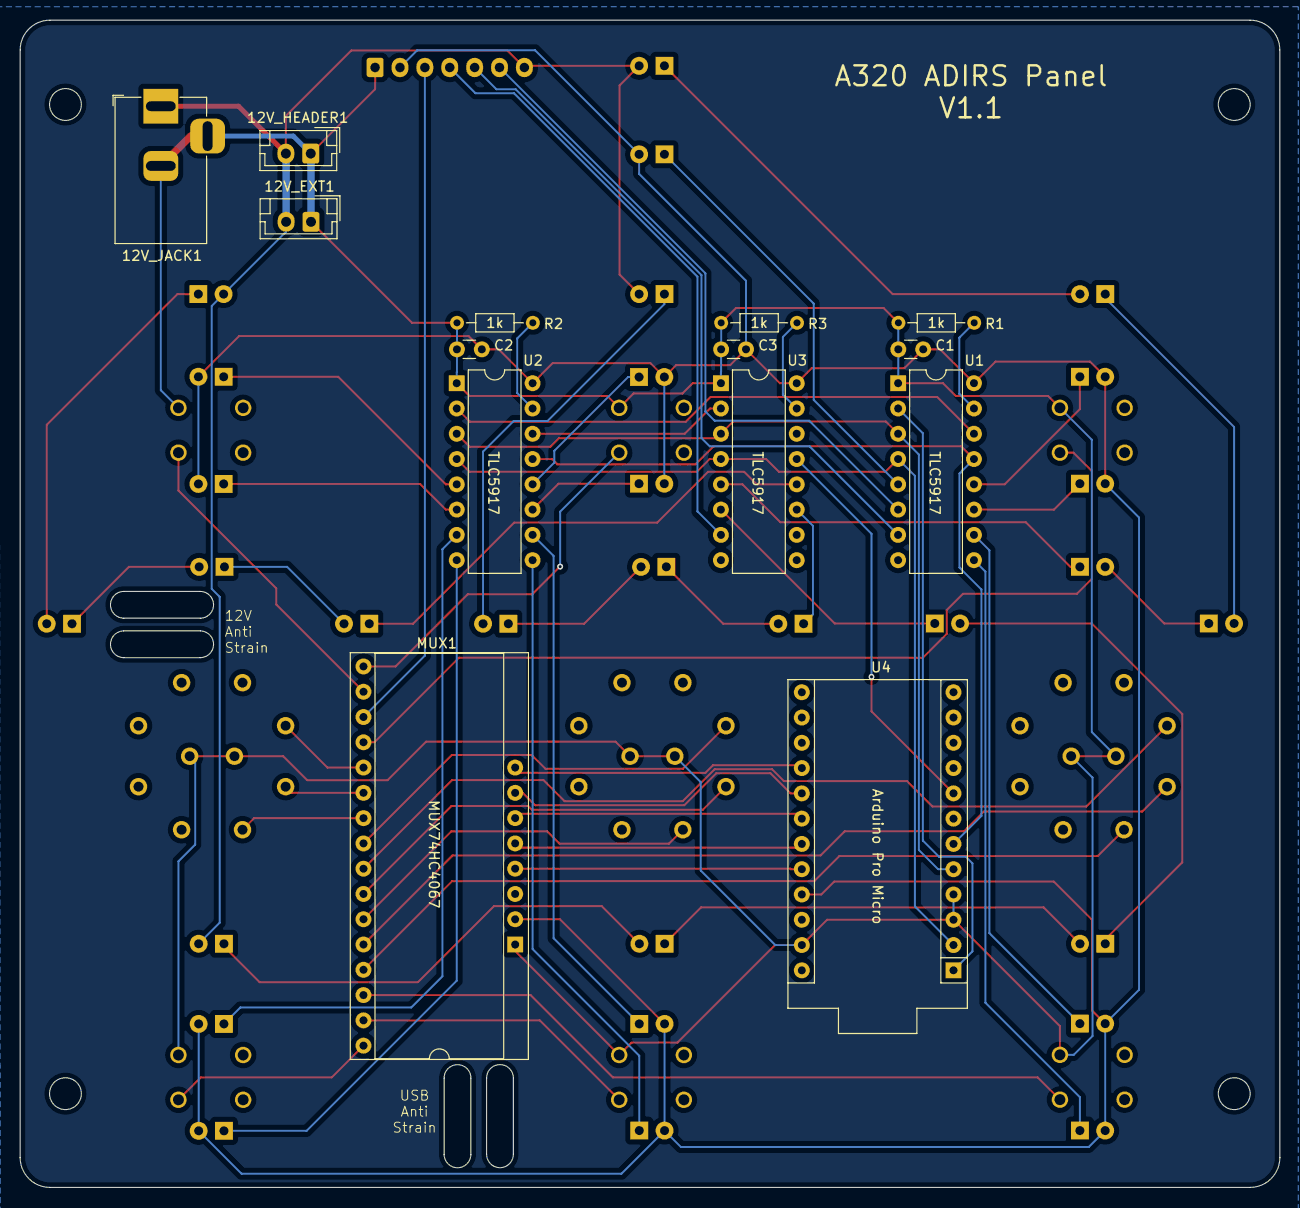
[picture p94: board ADIRS V1.1.kicad_pcb from below]

Board: 2 copper layers, 126.6 x 117.3 mm, 53 parts (14 on the bottom side), 66 nets.
