SK-MH/A320-PCBs/1 - OVERHEAD/1.7 ELEC/KiCAD/ELEC.kicad_pcb

## KiCad design 1 - OVERHEAD/1.7 ELEC/KiCAD/ELEC.kicad_pcb (2025-01-06)

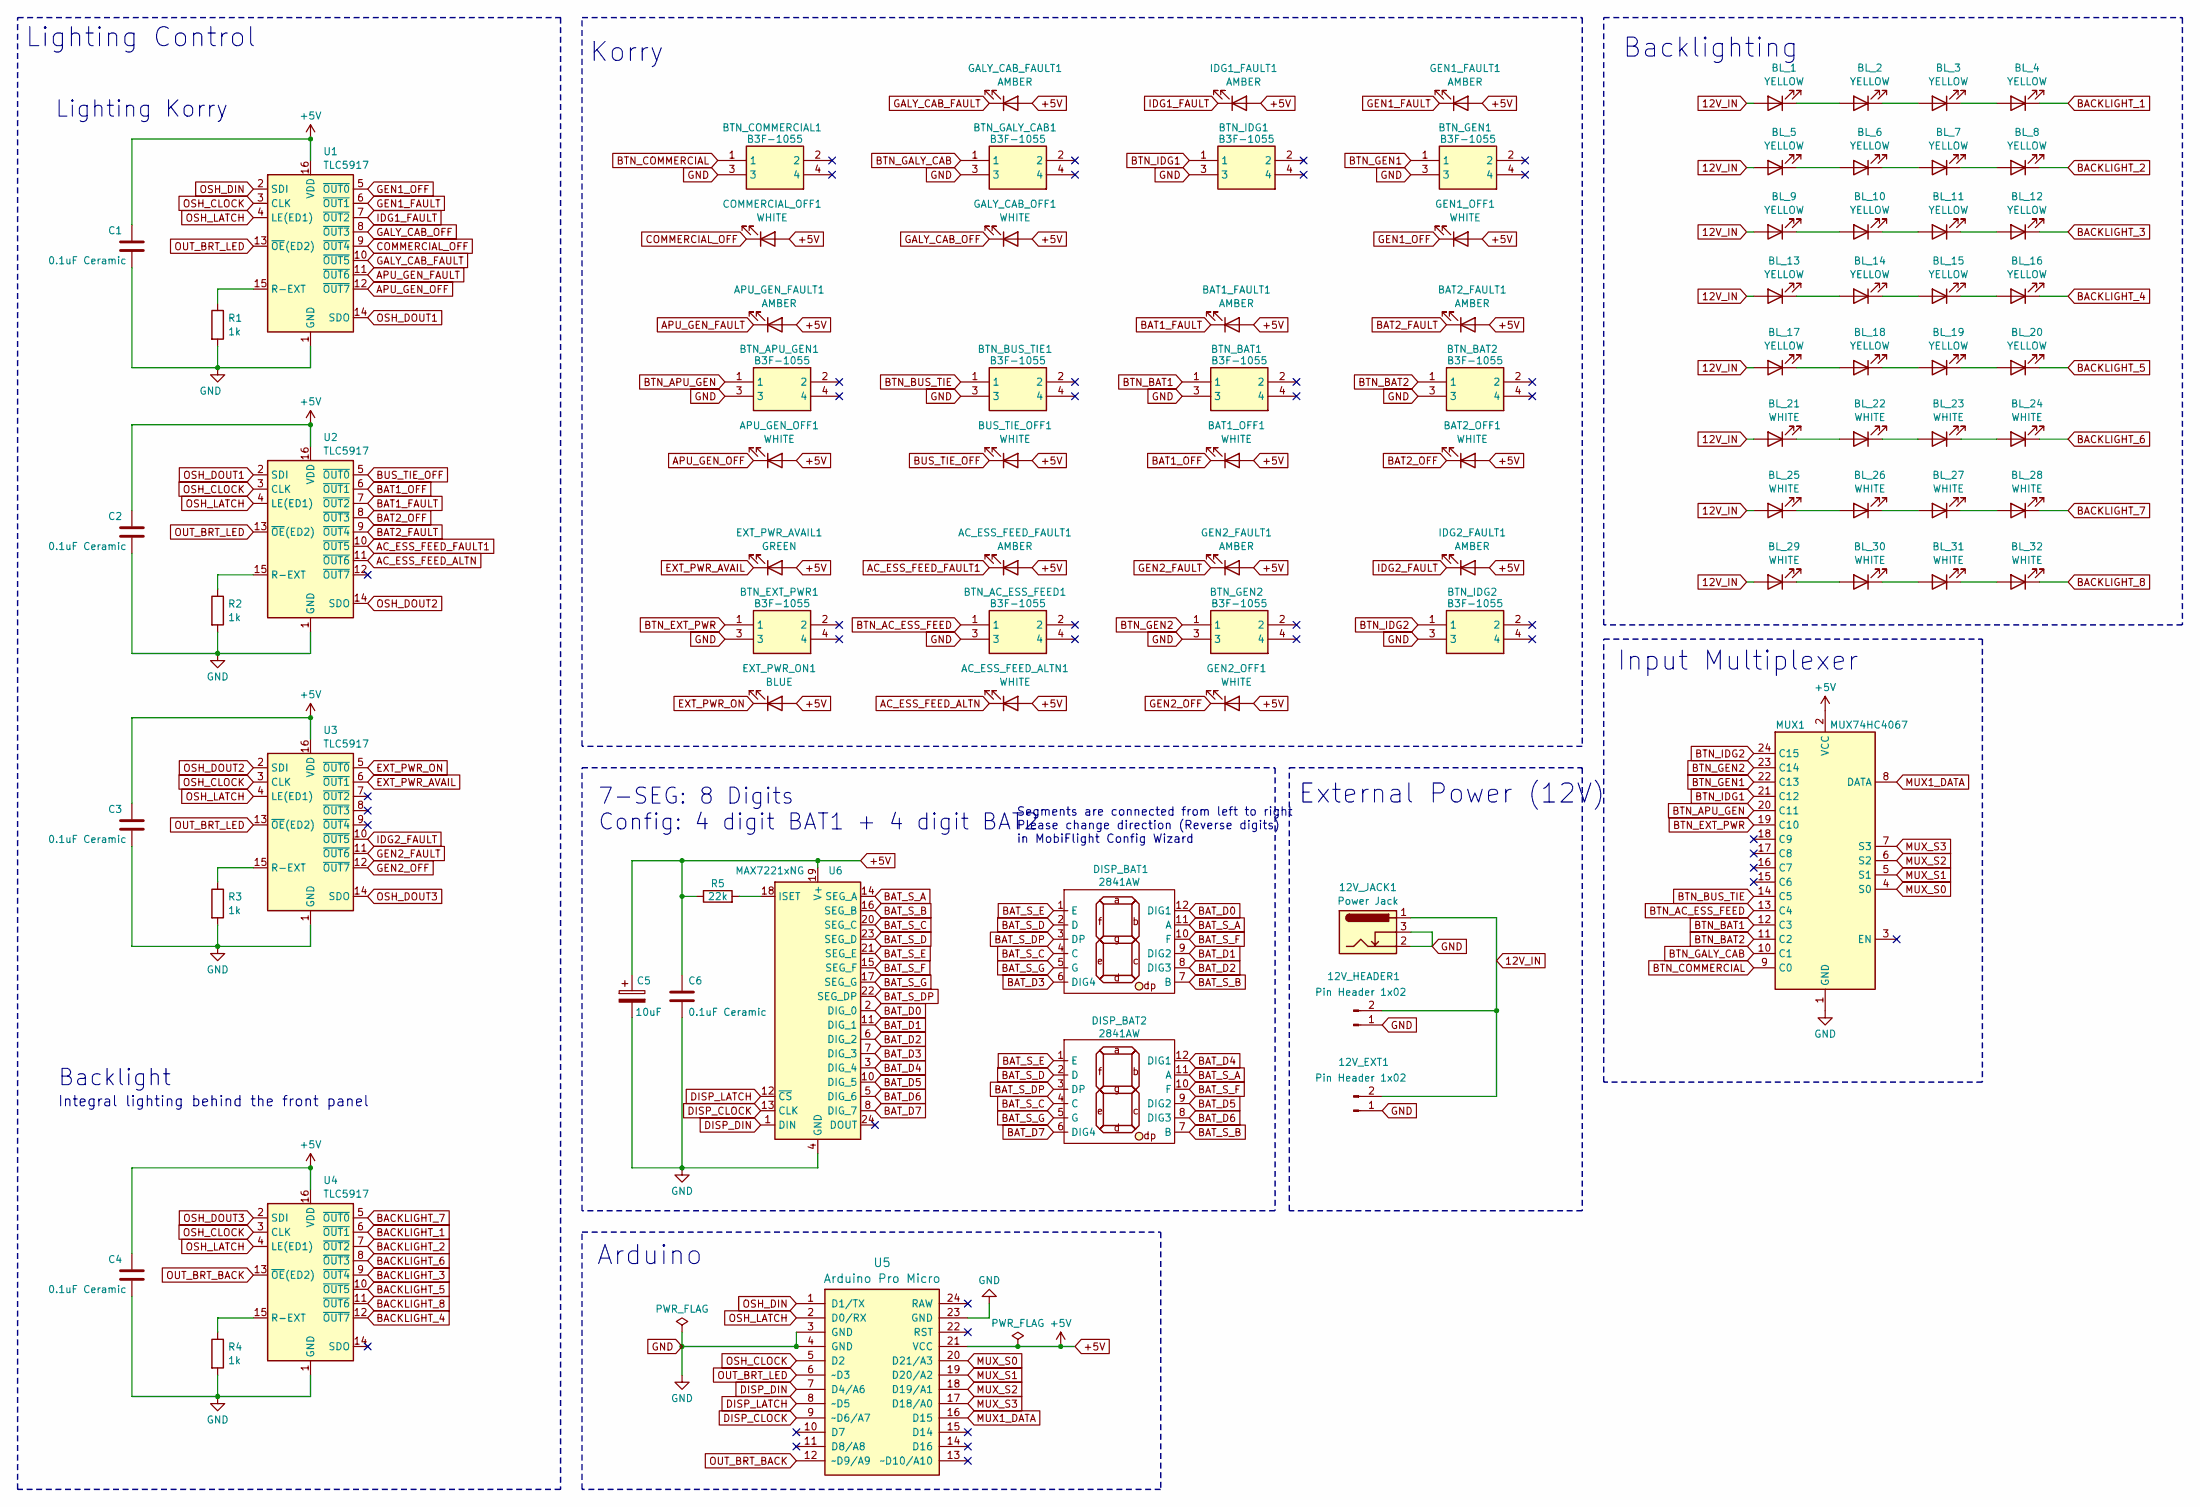
[picture p95: schematic ELEC.kicad_sch, ELEC Panel]

Parts:
12V_EXT1, 12V_HEADER1: Pin Header 1x02; JST_EH_B2B-EH-A_1x02_P2.50mm_Vertical
12V_JACK1: Power Jack; BarrelJack_Horizontal
AC_ESS_FEED_ALTN1: WHITE; LED_D3.0mm
AC_ESS_FEED_FAULT1: AMBER; LED_D3.0mm
APU_GEN_FAULT1: AMBER; LED_D3.0mm
APU_GEN_OFF1: WHITE; LED_D3.0mm
BAT1_FAULT1, BAT2_FAULT1: AMBER; LED_D3.0mm
BAT1_OFF1, BAT2_OFF1: WHITE; LED_D3.0mm
BL_1, BL_2, BL_3, BL_4, BL_5, BL_6, BL_7, BL_8, BL_9, BL_10, BL_11, BL_12, BL_13, BL_14, BL_15, BL_16, BL_17, BL_18, BL_19, BL_20: YELLOW; LED_D3.0mm
BL_21, BL_22, BL_23, BL_24, BL_25, BL_26, BL_27, BL_28, BL_29, BL_30, BL_31, BL_32: WHITE; LED_D3.0mm
BTN_AC_ESS_FEED1: B3F-1055; B3F1000; Mouser Part Number 653-B3F-1055
BTN_APU_GEN1: B3F-1055; B3F1000; Mouser Part Number 653-B3F-1055
BTN_BAT1, BTN_BAT2: B3F-1055; B3F1000; Mouser Part Number 653-B3F-1055
BTN_BUS_TIE1: B3F-1055; B3F1000; Mouser Part Number 653-B3F-1055
BTN_COMMERCIAL1: B3F-1055; B3F1000; Mouser Part Number 653-B3F-1055
BTN_EXT_PWR1: B3F-1055; B3F1000; Mouser Part Number 653-B3F-1055
BTN_GALY_CAB1: B3F-1055; B3F1000; Mouser Part Number 653-B3F-1055
BTN_GEN1, BTN_GEN2: B3F-1055; B3F1000; Mouser Part Number 653-B3F-1055
BTN_IDG1, BTN_IDG2: B3F-1055; B3F1000; Mouser Part Number 653-B3F-1055
BUS_TIE_OFF1: WHITE; LED_D3.0mm
C1, C2, C3, C4, C6: 0.1uF Ceramic; C_Disc_D3.0mm_W1.6mm_P2.50mm
C5: 10uF; CP_Radial_D4.0mm_P1.50mm
COMMERCIAL_OFF1: WHITE; LED_D3.0mm
DISP_BAT1, DISP_BAT2: 2841AW
EXT_PWR_AVAIL1: GREEN; LED_D3.0mm
EXT_PWR_ON1: BLUE; LED_D3.0mm
GALY_CAB_FAULT1: AMBER; LED_D3.0mm
GALY_CAB_OFF1: WHITE; LED_D3.0mm
GEN1_FAULT1, GEN2_FAULT1: AMBER; LED_D3.0mm
GEN1_OFF1, GEN2_OFF1: WHITE; LED_D3.0mm
IDG1_FAULT1, IDG2_FAULT1: AMBER; LED_D3.0mm
MUX1: MUX74HC4067
R1, R2, R3, R4: 1k; R_Axial_DIN0204_L3.6mm_D1.6mm_P7.62mm_Horizontal
R5: 22k; R_Axial_DIN0204_L3.6mm_D1.6mm_P7.62mm_Horizontal
U1, U2, U3, U4: TLC5917; DIP-16_W7.62mm
U5: Arduino Pro Micro; Sparkfun_Pro_Micro
U6: MAX7221xNG; DIP-24_W7.62mm

Connections:
12V_IN: 12V_EXT1.2, 12V_HEADER1.2, 12V_JACK1.1, BL_1.2 (A), BL_5.2 (A), BL_9.2 (A), BL_13.2 (A), BL_17.2 (A), BL_21.2 (A), BL_25.2 (A), BL_29.2 (A)
+5V: AC_ESS_FEED_ALTN1.2 (A), AC_ESS_FEED_FAULT1.2 (A), APU_GEN_FAULT1.2 (A), APU_GEN_OFF1.2 (A), BAT1_FAULT1.2 (A), BAT1_OFF1.2 (A), BAT2_FAULT1.2 (A), BAT2_OFF1.2 (A), BUS_TIE_OFF1.2 (A), C1.1, C2.1, C3.1, C4.1, C5.1, C6.1, COMMERCIAL_OFF1.2 (A), EXT_PWR_AVAIL1.2 (A), EXT_PWR_ON1.2 (A), GALY_CAB_FAULT1.2 (A), GALY_CAB_OFF1.2 (A), GEN1_FAULT1.2 (A), GEN1_OFF1.2 (A), GEN2_FAULT1.2 (A), GEN2_OFF1.2 (A), IDG1_FAULT1.2 (A), IDG2_FAULT1.2 (A), MUX1.2 (VCC), R5.1, U1.16 (VDD), U2.16 (VDD), U3.16 (VDD), U4.16 (VDD), U5.21 (VCC), U6.19 (V+)
AC_ESS_FEED_ALTN: AC_ESS_FEED_ALTN1.1 (K), U2.11 (~OUT6)
AC_ESS_FEED_FAULT1: AC_ESS_FEED_FAULT1.1 (K), U2.10 (~OUT5)
APU_GEN_FAULT: APU_GEN_FAULT1.1 (K), U1.11 (~OUT6)
APU_GEN_OFF: APU_GEN_OFF1.1 (K), U1.12 (~OUT7)
BACKLIGHT_1: BL_4.1 (K), U4.6 (~OUT1)
BACKLIGHT_2: BL_8.1 (K), U4.7 (~OUT2)
BACKLIGHT_3: BL_12.1 (K), U4.9 (~OUT4)
BACKLIGHT_4: BL_16.1 (K), U4.12 (~OUT7)
BACKLIGHT_5: BL_20.1 (K), U4.10 (~OUT5)
BACKLIGHT_6: BL_24.1 (K), U4.8 (~OUT3)
BACKLIGHT_7: BL_28.1 (K), U4.5 (~OUT0)
BACKLIGHT_8: BL_32.1 (K), U4.11 (~OUT6)
BAT1_FAULT: BAT1_FAULT1.1 (K), U2.7 (~OUT2)
BAT1_OFF: BAT1_OFF1.1 (K), U2.6 (~OUT1)
BAT2_FAULT: BAT2_FAULT1.1 (K), U2.9 (~OUT4)
BAT2_OFF: BAT2_OFF1.1 (K), U2.8 (~OUT3)
BAT_D0: DISP_BAT1.12 (DIG1), U6.2 (DIG_0)
BAT_D1: DISP_BAT1.9 (DIG2), U6.11 (DIG_1)
BAT_D2: DISP_BAT1.8 (DIG3), U6.6 (DIG_2)
BAT_D3: DISP_BAT1.6 (DIG4), U6.7 (DIG_3)
BAT_D4: DISP_BAT2.12 (DIG1), U6.3 (DIG_4)
BAT_D5: DISP_BAT2.9 (DIG2), U6.10 (DIG_5)
BAT_D6: DISP_BAT2.8 (DIG3), U6.5 (DIG_6)
BAT_D7: DISP_BAT2.6 (DIG4), U6.8 (DIG_7)
BAT_S_A: DISP_BAT1.11 (A), DISP_BAT2.11 (A), U6.14 (SEG_A)
BAT_S_B: DISP_BAT1.7 (B), DISP_BAT2.7 (B), U6.16 (SEG_B)
BAT_S_C: DISP_BAT1.4 (C), DISP_BAT2.4 (C), U6.20 (SEG_C)
BAT_S_D: DISP_BAT1.2 (D), DISP_BAT2.2 (D), U6.23 (SEG_D)
BAT_S_DP: DISP_BAT1.3 (DP), DISP_BAT2.3 (DP), U6.22 (SEG_DP)
BAT_S_E: DISP_BAT1.1 (E), DISP_BAT2.1 (E), U6.21 (SEG_E)
BAT_S_F: DISP_BAT1.10 (F), DISP_BAT2.10 (F), U6.15 (SEG_F)
BAT_S_G: DISP_BAT1.5 (G), DISP_BAT2.5 (G), U6.17 (SEG_G)
BTN_AC_ESS_FEED: BTN_AC_ESS_FEED1.1, MUX1.13 (C4)
BTN_APU_GEN: BTN_APU_GEN1.1, MUX1.20 (C11)
BTN_BAT1: BTN_BAT1.1, MUX1.12 (C3)
BTN_BAT2: BTN_BAT2.1, MUX1.11 (C2)
BTN_BUS_TIE: BTN_BUS_TIE1.1, MUX1.14 (C5)
BTN_COMMERCIAL: BTN_COMMERCIAL1.1, MUX1.9 (C0)
BTN_EXT_PWR: BTN_EXT_PWR1.1, MUX1.19 (C10)
BTN_GALY_CAB: BTN_GALY_CAB1.1, MUX1.10 (C1)
BTN_GEN1: BTN_GEN1.1, MUX1.22 (C13)
BTN_GEN2: BTN_GEN2.1, MUX1.23 (C14)
BTN_IDG1: BTN_IDG1.1, MUX1.21 (C12)
BTN_IDG2: BTN_IDG2.1, MUX1.24 (C15)
BUS_TIE_OFF: BUS_TIE_OFF1.1 (K), U2.5 (~OUT0)
COMMERCIAL_OFF: COMMERCIAL_OFF1.1 (K), U1.9 (~OUT4)
DISP_CLOCK: U5.9 (~D6/A7), U6.13 (CLK)
DISP_DIN: U5.7 (D4/A6), U6.1 (DIN)
DISP_LATCH: U5.8 (~D5), U6.12 (~CS)
EXT_PWR_AVAIL: EXT_PWR_AVAIL1.1 (K), U3.6 (~OUT1)
EXT_PWR_ON: EXT_PWR_ON1.1 (K), U3.5 (~OUT0)
GALY_CAB_FAULT: GALY_CAB_FAULT1.1 (K), U1.10 (~OUT5)
GALY_CAB_OFF: GALY_CAB_OFF1.1 (K), U1.8 (~OUT3)
GEN1_FAULT: GEN1_FAULT1.1 (K), U1.6 (~OUT1)
GEN1_OFF: GEN1_OFF1.1 (K), U1.5 (~OUT0)
GEN2_FAULT: GEN2_FAULT1.1 (K), U3.11 (~OUT6)
GEN2_OFF: GEN2_OFF1.1 (K), U3.12 (~OUT7)
GND: 12V_EXT1.1, 12V_HEADER1.1, 12V_JACK1.2, 12V_JACK1.3, BTN_AC_ESS_FEED1.3, BTN_APU_GEN1.3, BTN_BAT1.3, BTN_BAT2.3, BTN_BUS_TIE1.3, BTN_COMMERCIAL1.3, BTN_EXT_PWR1.3, BTN_GALY_CAB1.3, BTN_GEN1.3, BTN_GEN2.3, BTN_IDG1.3, BTN_IDG2.3, C1.2, C2.2, C3.2, C4.2, C5.2, C6.2, MUX1.1 (GND), R1.2, R2.2, R3.2, R4.2, U1.1 (GND), U2.1 (GND), U3.1 (GND), U4.1 (GND), U5.3 (GND), U5.4 (GND), U5.23 (GND), U6.4 (GND), U6.9 (GND)
IDG1_FAULT: IDG1_FAULT1.1 (K), U1.7 (~OUT2)
IDG2_FAULT: IDG2_FAULT1.1 (K), U3.10 (~OUT5)
MUX1_DATA: MUX1.8 (DATA), U5.16 (D15)
MUX_S0: MUX1.4 (S0), U5.20 (D21/A3)
MUX_S1: MUX1.5 (S1), U5.19 (D20/A2)
MUX_S2: MUX1.6 (S2), U5.18 (D19/A1)
MUX_S3: MUX1.7 (S3), U5.17 (D18/A0)
unnamed: BL_1.1 (K), BL_2.2 (A)
unnamed: BL_2.1 (K), BL_3.2 (A)
unnamed: BL_3.1 (K), BL_4.2 (A)
unnamed: BL_5.1 (K), BL_6.2 (A)
unnamed: BL_6.1 (K), BL_7.2 (A)
unnamed: BL_7.1 (K), BL_8.2 (A)
unnamed: BL_9.1 (K), BL_10.2 (A)
unnamed: BL_10.1 (K), BL_11.2 (A)
unnamed: BL_11.1 (K), BL_12.2 (A)
unnamed: BL_13.1 (K), BL_14.2 (A)
unnamed: BL_14.1 (K), BL_15.2 (A)
unnamed: BL_15.1 (K), BL_16.2 (A)
unnamed: BL_17.1 (K), BL_18.2 (A)
unnamed: BL_18.1 (K), BL_19.2 (A)
unnamed: BL_19.1 (K), BL_20.2 (A)
unnamed: BL_21.1 (K), BL_22.2 (A)
unnamed: BL_22.1 (K), BL_23.2 (A)
unnamed: BL_23.1 (K), BL_24.2 (A)
unnamed: BL_25.1 (K), BL_26.2 (A)
unnamed: BL_26.1 (K), BL_27.2 (A)
unnamed: BL_27.1 (K), BL_28.2 (A)
unnamed: BL_29.1 (K), BL_30.2 (A)
unnamed: BL_30.1 (K), BL_31.2 (A)
unnamed: BL_31.1 (K), BL_32.2 (A)
unnamed: R1.1, U1.15 (R-EXT)
unnamed: R2.1, U2.15 (R-EXT)
unnamed: R3.1, U3.15 (R-EXT)
unnamed: R4.1, U4.15 (R-EXT)
unnamed: R5.2, U6.18 (ISET)
OSH_CLOCK: U1.3 (CLK), U2.3 (CLK), U3.3 (CLK), U4.3 (CLK), U5.5 (D2)
OSH_DIN: U1.2 (SDI), U5.1 (D1/TX)
OSH_DOUT1: U1.14 (SDO), U2.2 (SDI)
OSH_DOUT2: U2.14 (SDO), U3.2 (SDI)
OSH_DOUT3: U3.14 (SDO), U4.2 (SDI)
OSH_LATCH: U1.4 (LE(ED1)), U2.4 (LE(ED1)), U3.4 (LE(ED1)), U4.4 (LE(ED1)), U5.2 (D0/RX)
OUT_BRT_BACK: U4.13 (~OE(ED2)), U5.12 (~D9/A9)
OUT_BRT_LED: U1.13 (~OE(ED2)), U2.13 (~OE(ED2)), U3.13 (~OE(ED2)), U5.6 (~D3)

Notes on the sheet:
Backlighting
7-SEG: 8 Digits Config: 4 digit BAT1 + 4 digit BAT2
Arduino
Korry
Segments are connected from left to right Please change direction (Reverse digits) in MobiFlight Config Wizard
Input Multiplexer
External Power (12V)
Lighting Korry
Lighting Control
Integral lighting behind the front panel
Backlight

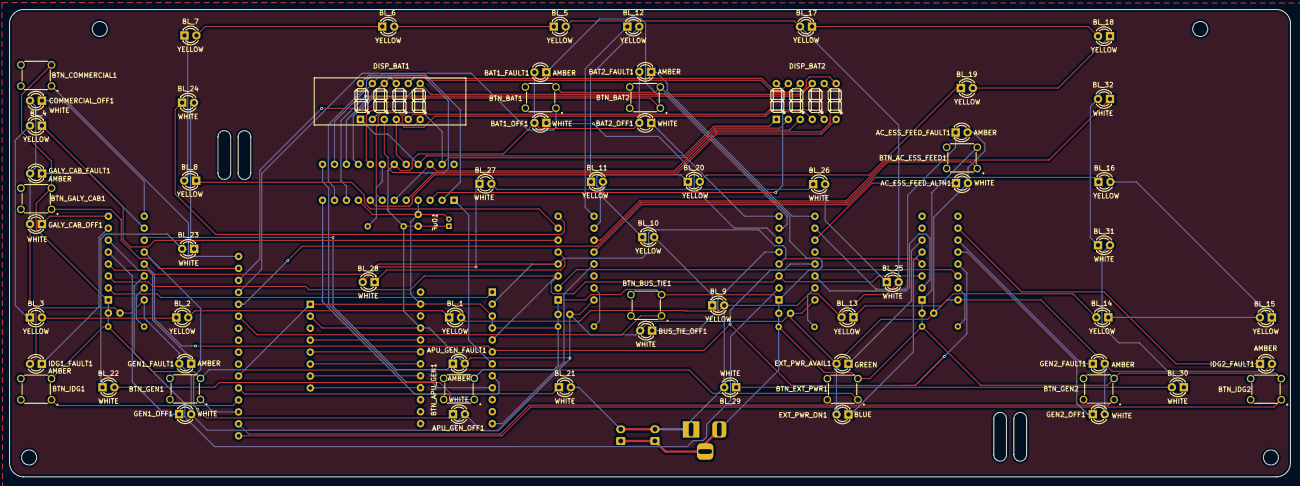
[picture p96: board ELEC.kicad_pcb from above]

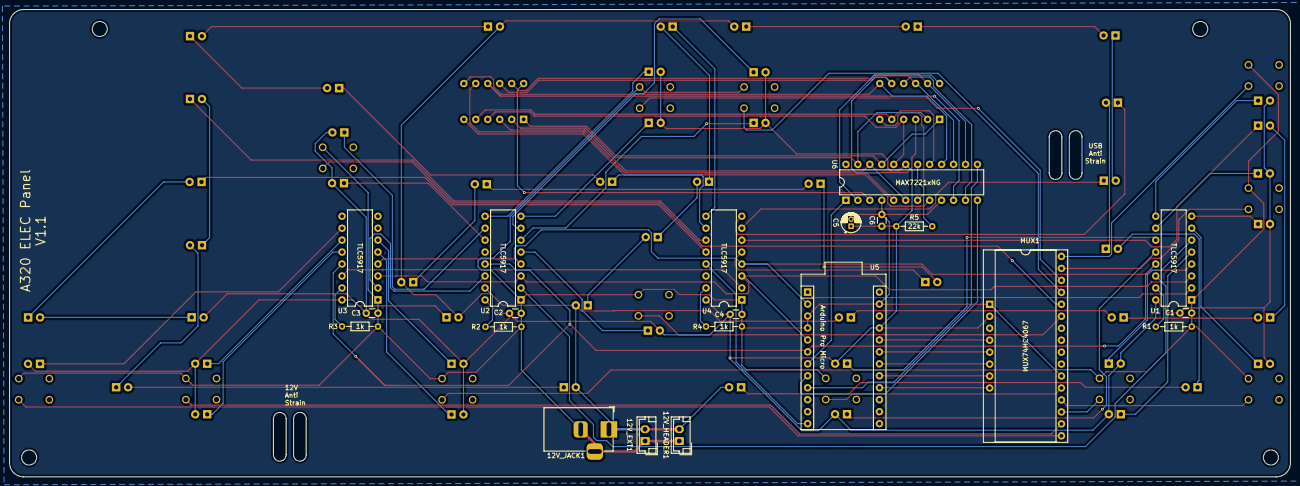
[picture p97: board ELEC.kicad_pcb from below]

Board: 2 copper layers, 272.1 x 99.3 mm, 87 parts (21 on the bottom side), 104 nets.
