SK-MH/A320-PCBs/(commit log)

2024-11-28 Initial load FLT_CTL
    [FLT_CTL.kicad_pcb, FLT_CTL.kicad_sch, bom.csv]
2024-11-28 Initial load FLT_CTL_FO
    [FLT_CTL_FO.kicad_pcb, FLT_CTL_FO.kicad_sch, bom.csv]
2024-11-28 Initial load ADIRS & Miscellaneous
    [ADIRS.kicad_pcb, ADIRS.kicad_sch, bom.csv]
2024-11-30 ADIRS connector initial load
2024-12-04 ToDo list added
    [A320 Boards.xlsx]
2024-12-04 Files for CNC or Laser milling/engraving
    For engraving:
    In the lower left corner there is a marker.
    This points to the lower left corner on the plate.
    Use this for adjusting the CNC/Laser.
2025-01-06 KiCAD files and other added
    [A320 Boards.xlsx, ADIRS V1.1.kicad_pcb, ADIRS V1.1.kicad_sch, ADIRS.kicad_pcb, ADIRS.kicad_sch, AirCond.kicad_pcb, AirCond.kicad_sch, CARGO_HEAT.kicad_pcb]
2025-01-06 More KiCAD files
    [A320 Radio Panel.kicad_pcb, A320 Radio Panel.kicad_sch, AUTOBRAKE.kicad_pcb, AUTOBRAKE.kicad_sch, Autoland.kicad_pcb, Autoland.kicad_sch, CHRONO neu.kicad_pcb, CHRONO neu.kicad_sch]
2025-01-07 Docu started
    [Switching.kicad_pcb, Switching.kicad_sch]
